fathurraihan18/TA/case/FINAL_TA/09_Foto_Latar_Polos/Perbandingan_Foto1.png

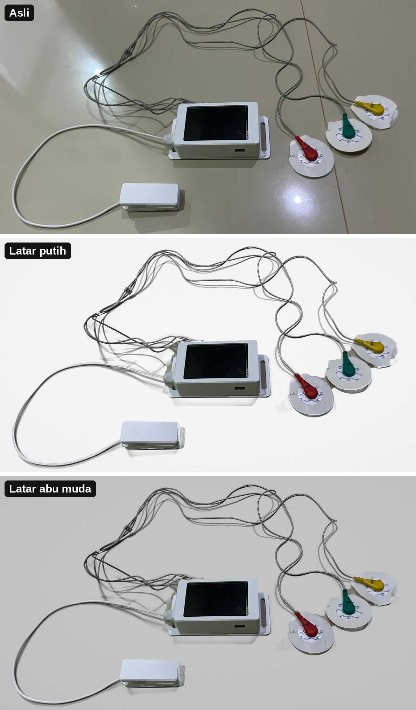
case/FINAL_TA/09_Foto_Latar_Polos/Perbandingan_Foto1.png
