fathurraihan18/TA/README.md

# TA
Implementasi LightGBM ke ESP32 berbasis sinyal ECG dan PPG
