fathurraihan18/TA/case/FINAL_TA/08_Jurnal_Satu_Per_Satu/Fig03_System_overview.pdf

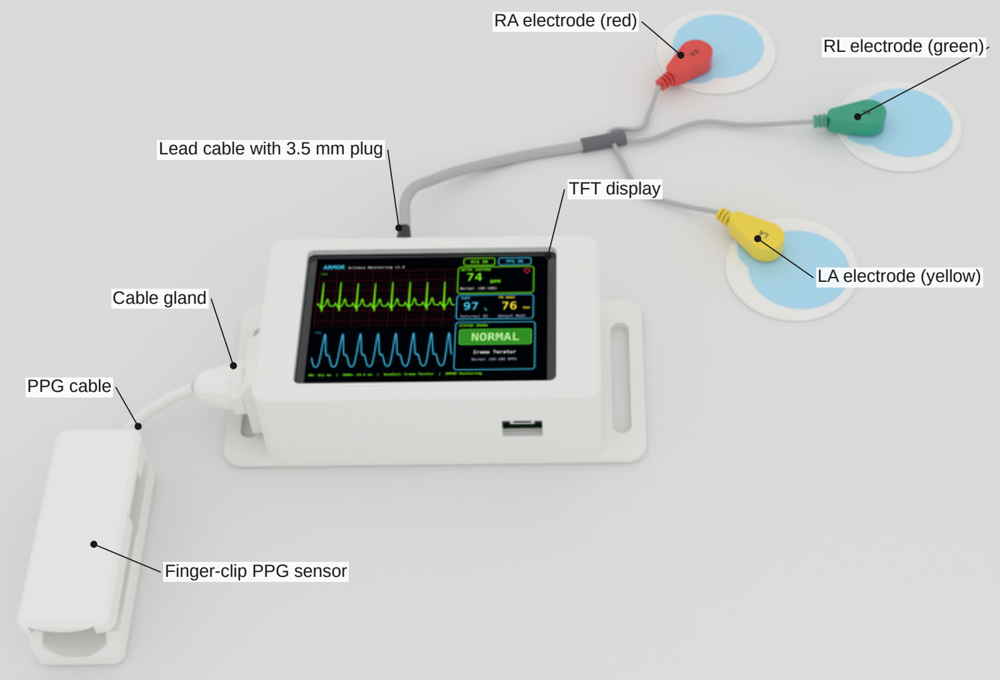
[picture p3: page 1]

RA electrode (red)
RL electrode (green)

LA electrode (yellow)

Lead cable with 3.5 mm plug

TFT display

Cable gland

PPG cable

Finger-clip PPG sensor
