fathurraihan18/TA/case/v2d_penahan_strip/Gambar_Pemasangan_Penahan_A3.pdf

dorong lurus
ke dalam

dorong lurus
ke dalam

celah epoxy
0.3 mm

0.7 mm

penahan

sekrup M3 x 8, kepala rata

PCB utama

back plate

dinding shell

celah 0.4 mm

batang strip

rim plate

# Pemasangan penahan sekrup (v2d): plate v2 dan 4 sekrup M3 x 8 dari belakang TIDAK berubah

Shell v2 yang bossnya sudah dipotong | penahan dicetak terpisah, dilem ke dinding sesudah tumpukan masuk | plate dipakai sebagai jig

## 1 Tumpukan masuk lurus dari belakang

TFT + standoff + PCB + modul didorong ke shell. Dinding dalam rata

(bos sudah dibuang), tidak ada yang menghalangi.

## 2 Penahan dipasang pada plate

Penahan (magenta): kaki-kakinya masuk ke celah rim plate, batangnya melintas di atas rim. 4 sekrup M3 x 8 dari belakang plate menggigit penahan (cukup menempel).

## 3 Oleskan epoxy, masukkan plate + penahan

Epoxy (kuning) tipis hanya pada muka penahan yang menghadap dinding. Tiang plate melingkupi ekor baut, penahan menyusur dinding di bawah PCB.

## 4 Epoxy keras: penahan menempel di shell

Lepas 4 sekrup dan plate. Penahan (magenta) tinggal di dinding, 0,7 mm di bawah PCB. Lalu pasang plate + 4 sekrup seperti v2.

## 5 Hasil: tampak belakang

Kepala sekrup flat head rata dengan plate: lubang tertutup, PCB dan

solder tidak terlihat/tersentuh kulit.

## 6 Potongan melalui sumbu sekrup (x = 23 mm)

detail dinding Atas (diperbesar) | potongan di x = 0 (di atas rim plate)

Penahan (magenta) berada di antara dinding dan lantai plate, tepat di bawah PCB. Sekrup masuk dari belakang menembus plate dan menggigit penahan. Catatan: sesudah dilem, tumpukan tidak bisa ditarik keluar dari belakang tanpa memotong penahan.

shell | back plate | penahan | epoxy | sekrup | PCB | TFT | Gambar ilustrasi (baterai tidak digambar); dimensi dari model CAD case/v2d_penahan_strip
