fathurraihan18/TA/case/FINAL_TA/01_Gambar_Komponen/Gambar_Komponen_A3.pdf

A. Tampak isometrik | B. Tampak atas (mm)

# K-1 ESP32 DevKit C V4 (ESP32-WROOM-32, 38 pin)

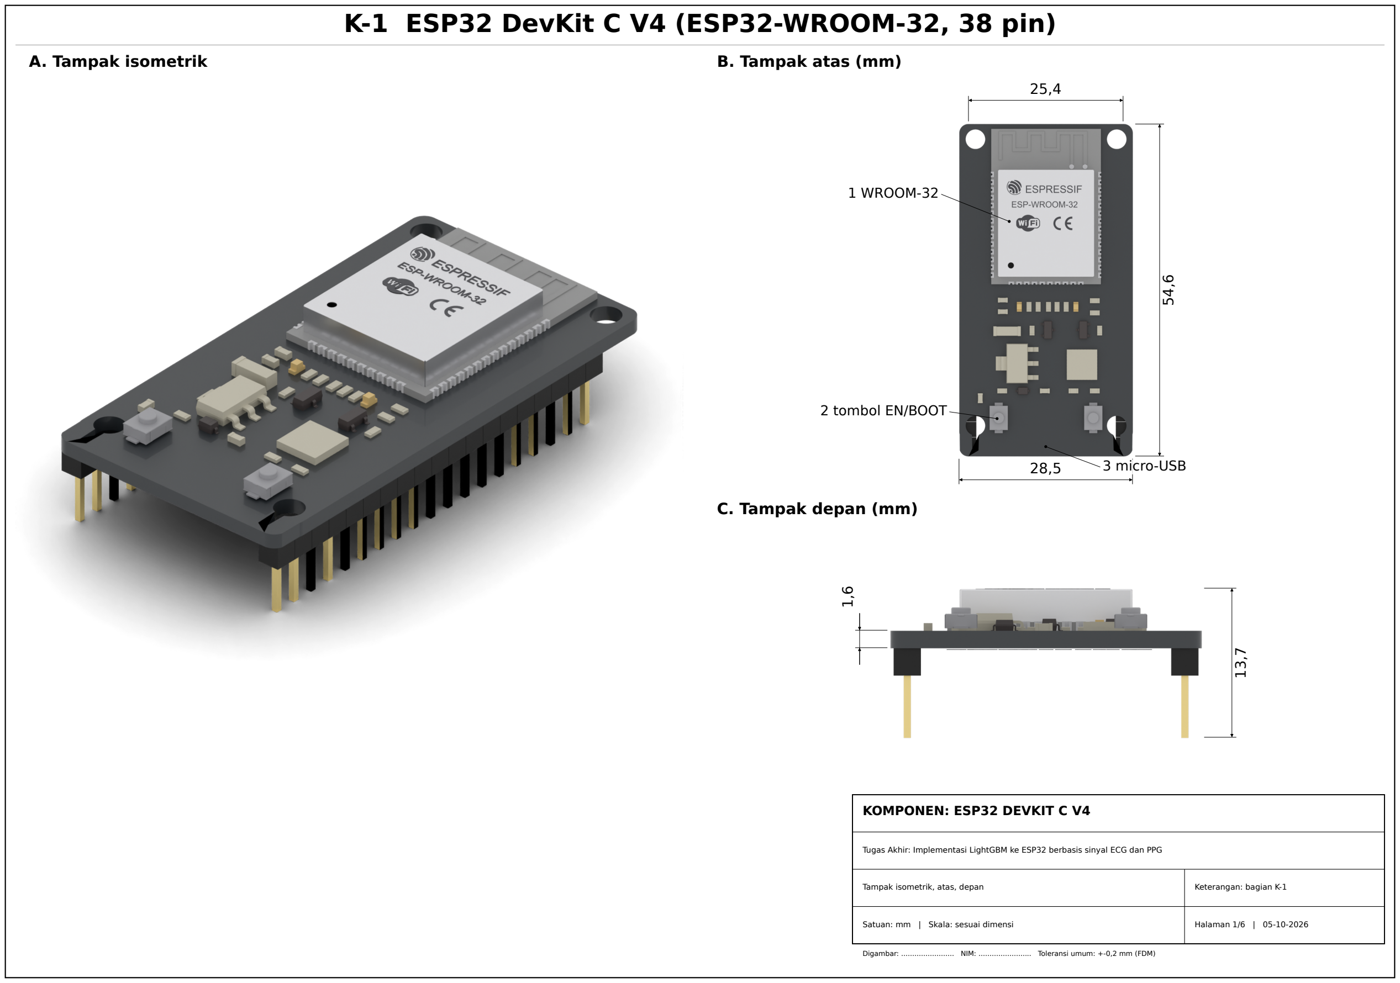
[picture p7: page 1]

# C. Tampak depan (mm)

28,5

54,6

25,4

13,7

1,6

# 1 WROOM-32

# 2 tombol EN/BOOT

# 3 micro-USB

## KOMPONEN: ESP32 DEVKIT C V4

Tugas Akhir: Implementasi LightGBM ke ESP32 berbasis sinyal ECG dan PPG

Tampak isometrik, atas, depan

Satuan: mm | Skala: sesuai dimensi

Keterangan: bagian K-1

Halaman 1/6 | 05-10-2026
Digambar: | NIM: | Toleransi umum: +-0,2 mm (FDM)

# K-2 Modul AD8232 ECG (SparkFun) + jack 3,5 mm

# 1 jack 3,5 mm

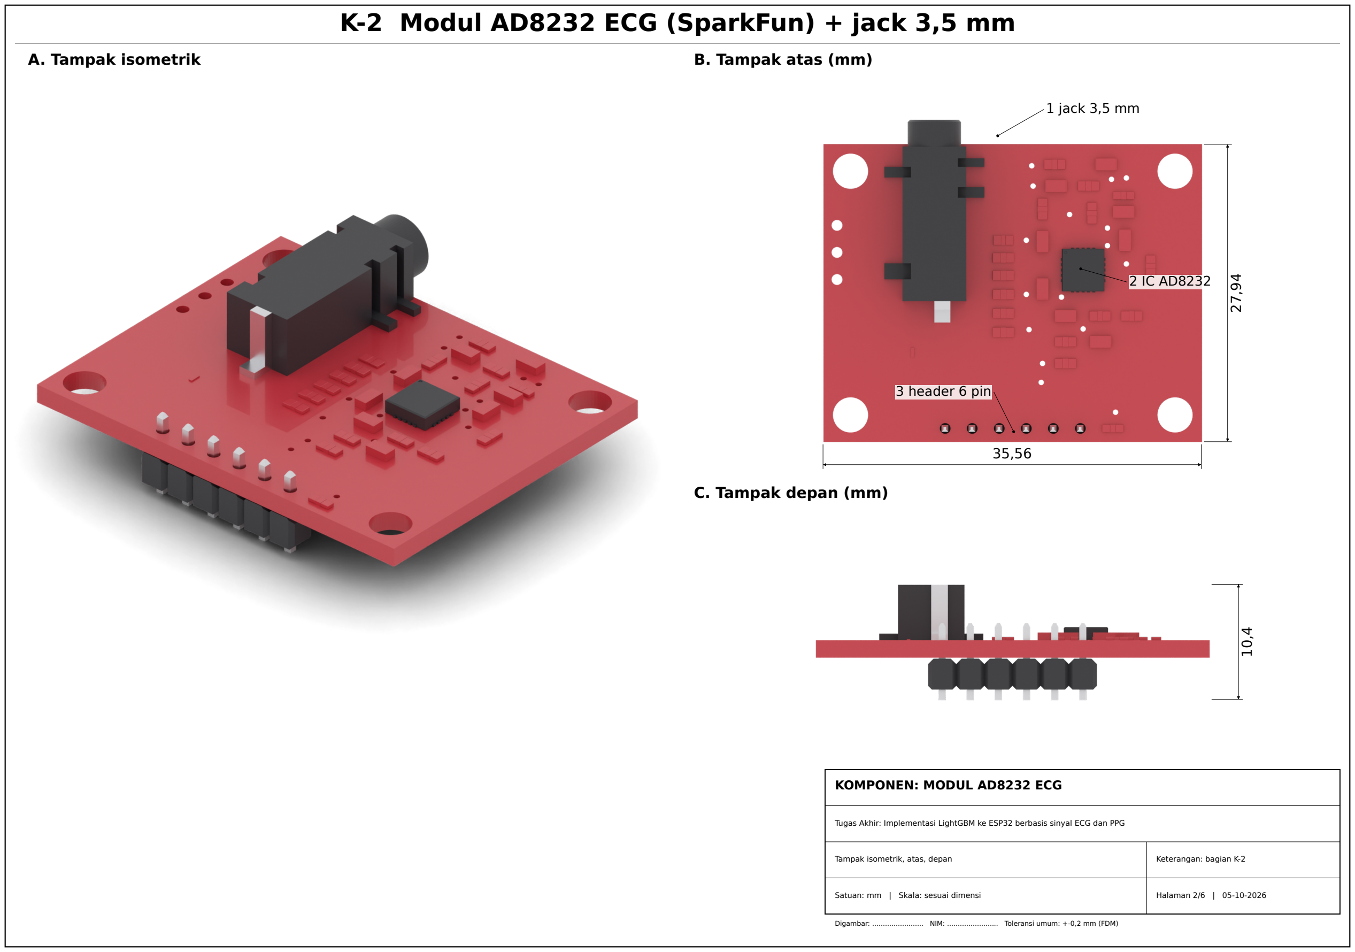
[picture p8: page 2]

# C. Tampak depan (mm)

35,56

27,94 10,4

# 2 IC AD8232

# 3 header 6 pin

## KOMPONEN: MODUL AD8232 ECG

Tugas Akhir: Implementasi LightGBM ke ESP32 berbasis sinyal ECG dan PPG

Tampak isometrik, atas, depan | Keterangan: bagian K-2
| Halaman 2/6 | 05-10-2026

# K-3 Sensor PPG MAX30102 - papan HW-605

# 1 jendela sensor

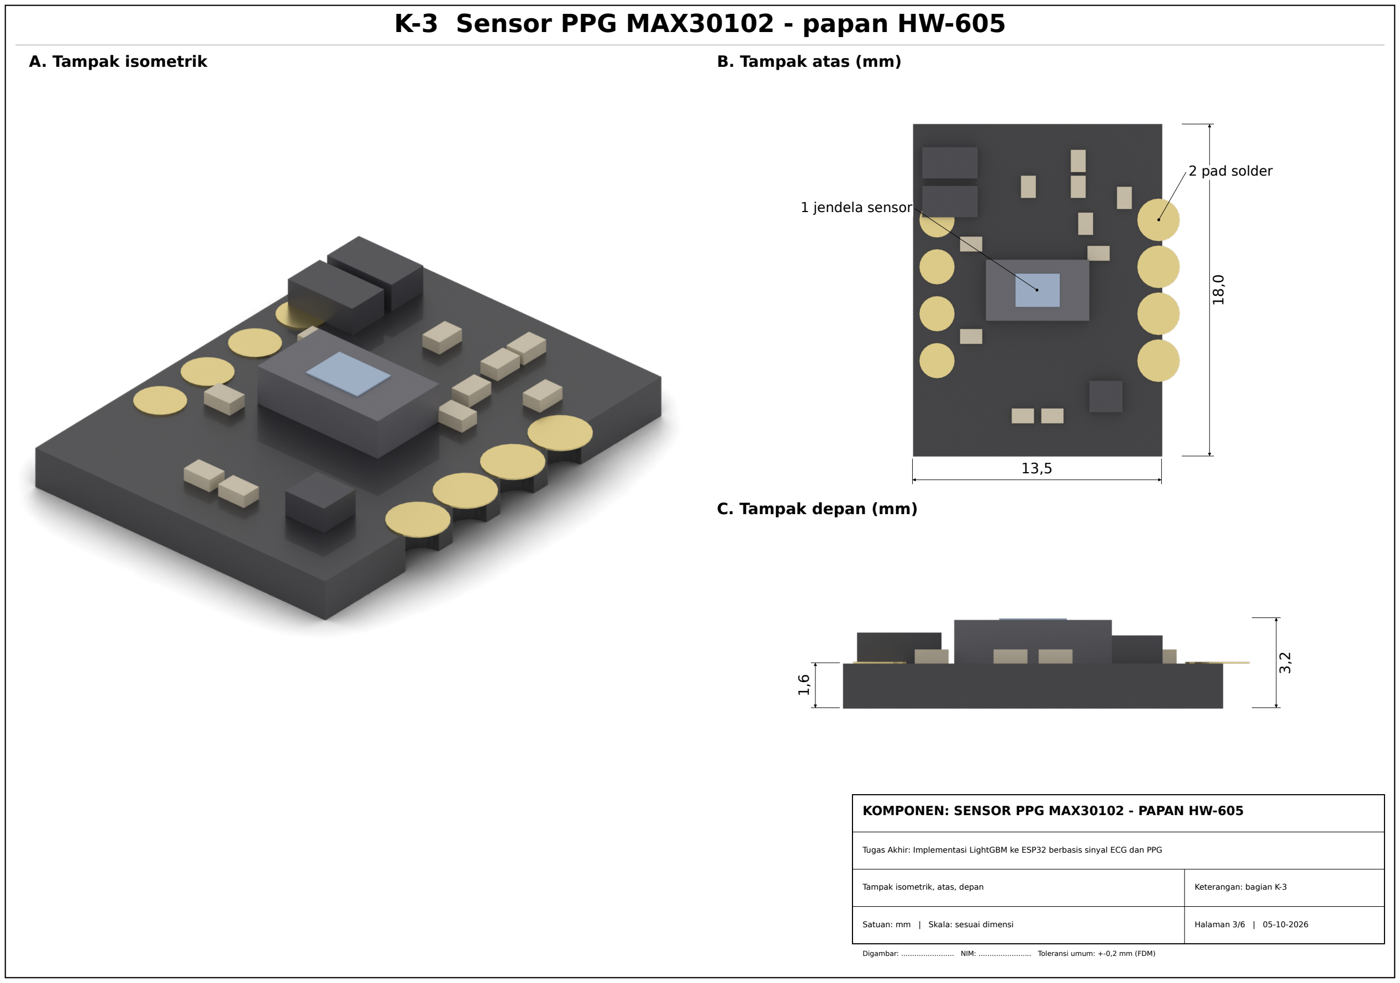
[picture p9: page 3]

# C. Tampak depan (mm)

13,5

18,0

3,2

1,6

# 2 pad solder

## KOMPONEN: SENSOR PPG MAX30102 - PAPAN HW-605

Tugas Akhir: Implementasi LightGBM ke ESP32 berbasis sinyal ECG dan PPG

Tampak isometrik, atas, depan | Keterangan: bagian K-3
| Halaman 3/6 | 05-10-2026

A. Set kabel 3 lead dengan plug TRS 3,5 mm | B. Tampak atas (mm)

# K-4 Elektroda EKG 3 lead (merah RA, kuning LA, hijau RL) + kabel dan plug 3,5 mm

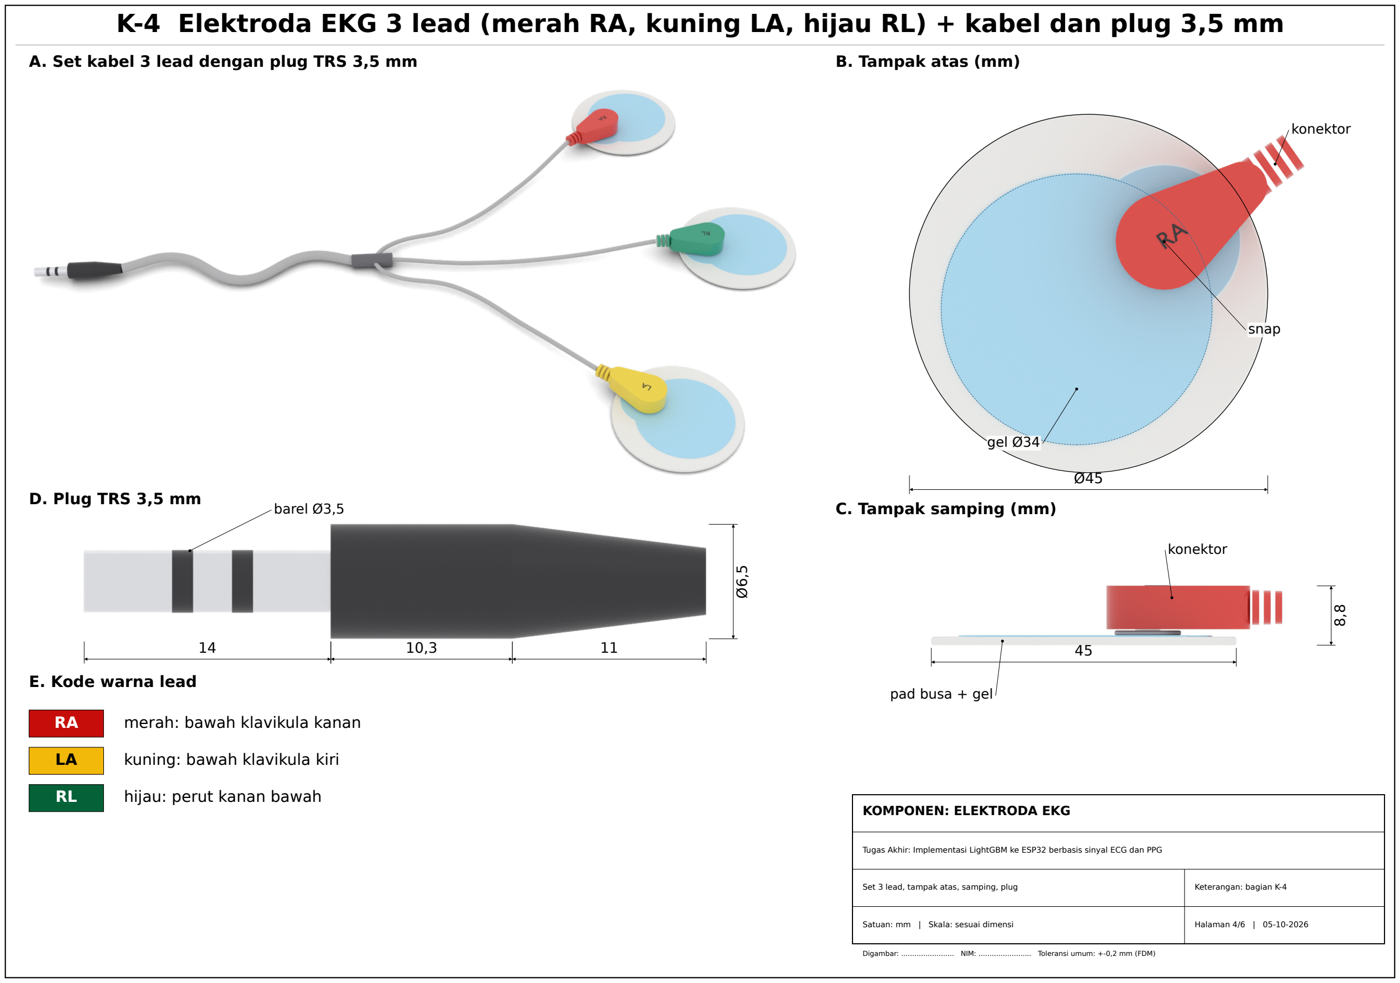
[picture p10: page 4]

# C. Tampak samping (mm) D. Plug TRS 3,5 mm

# E. Kode warna lead

# merah: bawah klavikula kanan

# kuning: bawah klavikula kiri

# hijau: perut kanan bawah

Ø45

45

8,8

14 | 10,3 | 11

Ø6,5

RA

LA

RL

# gel Ø34

# konektor

# snap

# pad busa + gel

# konektor

# barel Ø3,5

## KOMPONEN: ELEKTRODA EKG

Tugas Akhir: Implementasi LightGBM ke ESP32 berbasis sinyal ECG dan PPG

Set 3 lead, tampak atas, samping, plug

Keterangan: bagian K-4

Halaman 4/6 | 05-10-2026

# A. Cable gland PG7 + mur

# C. Saklar rocker KCD11

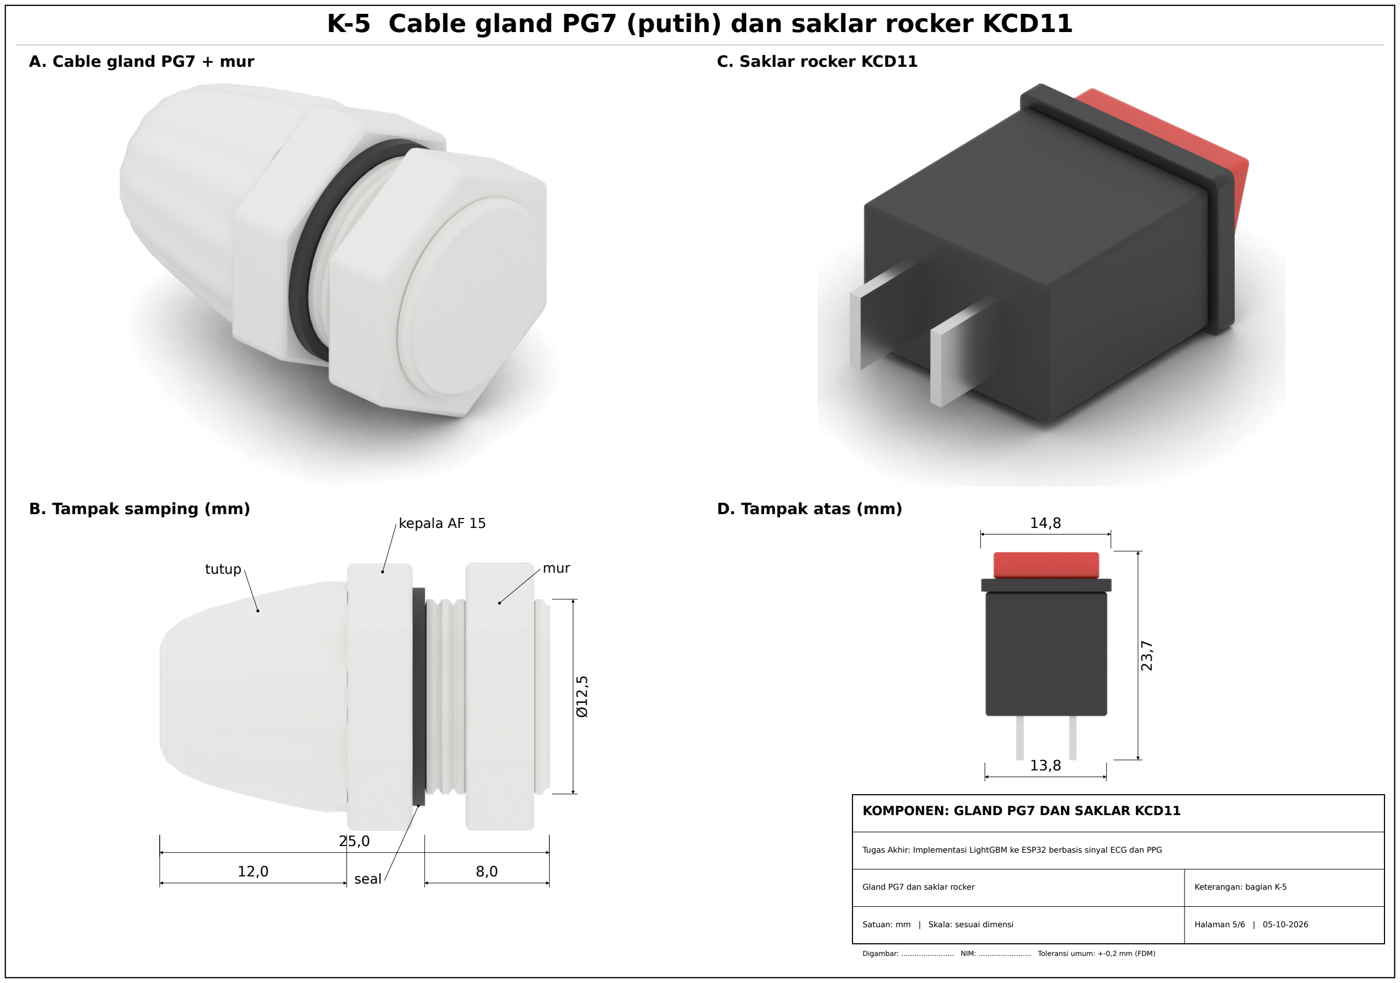
[picture p11: page 5]

# B. Tampak samping (mm)

# D. Tampak atas (mm)

# K-5 Cable gland PG7 (putih) dan saklar rocker KCD11

25,0

12,0 | 8,0

Ø12,5

14,8

23,7

13,8

# kepala AF 15

# tutup

# seal

# mur

## KOMPONEN: GLAND PG7 DAN SAKLAR KCD11

Tugas Akhir: Implementasi LightGBM ke ESP32 berbasis sinyal ECG dan PPG

Gland PG7 dan saklar rocker

Keterangan: bagian K-5

Halaman 5/6 | 05-10-2026

# 1. Layar TFT 3,5" ILI9488

# 2. PCB utama (custom)

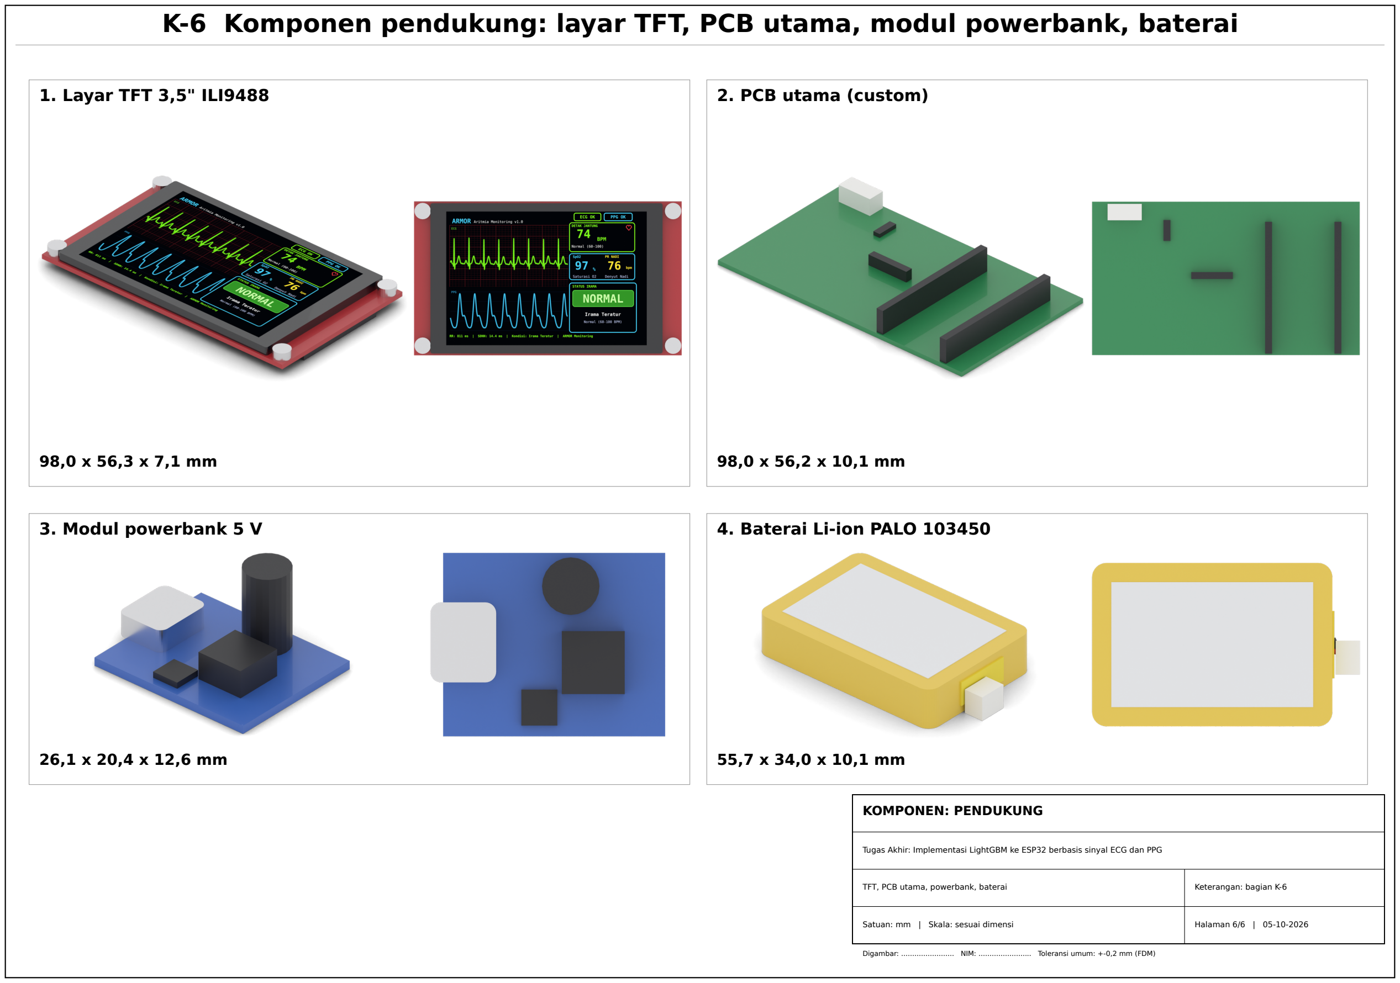
[picture p12: page 6]

# 98,0 x 56,3 x 7,1 mm

# 98,0 x 56,2 x 10,1 mm

# 3. Modul powerbank 5 V

# 26,1 x 20,4 x 12,6 mm

# 4. Baterai Li-ion PALO 103450

# 55,7 x 34,0 x 10,1 mm

# K-6 Komponen pendukung: layar TFT, PCB utama, modul powerbank, baterai

## KOMPONEN: PENDUKUNG

Tugas Akhir: Implementasi LightGBM ke ESP32 berbasis sinyal ECG dan PPG

TFT, PCB utama, powerbank, baterai | Keterangan: bagian K-6
| Halaman 6/6 | 05-10-2026
