fathurraihan18/TA/case/FINAL_TA/08_Jurnal_Satu_Per_Satu/Fig04_Electrode_placement_male_torso.pdf

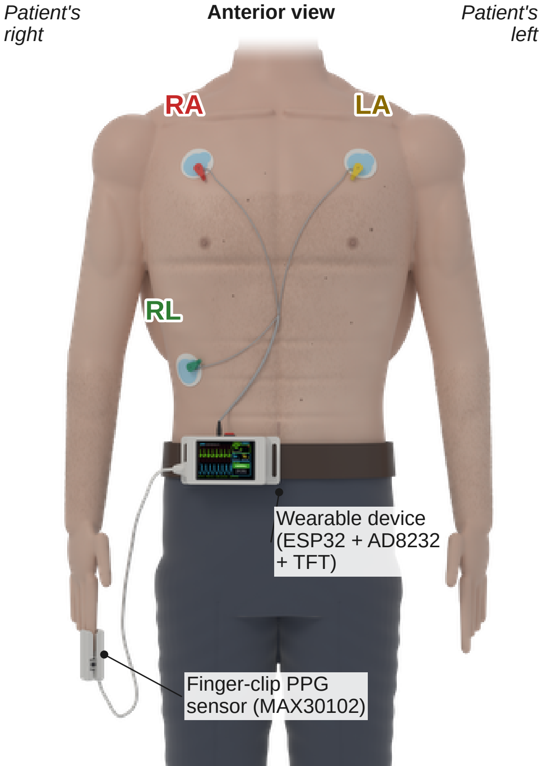
[picture p13: page 1]

Patient's
right

Patient's
left

Anterior view

Wearable device
(ESP32 + AD8232
+ TFT)

Finger-clip PPG
sensor (MAX30102)
