fathurraihan18/TA/case/FINAL_TA/08_Jurnal_Satu_Per_Satu/Fig05_Electrode_details.pdf

(a)

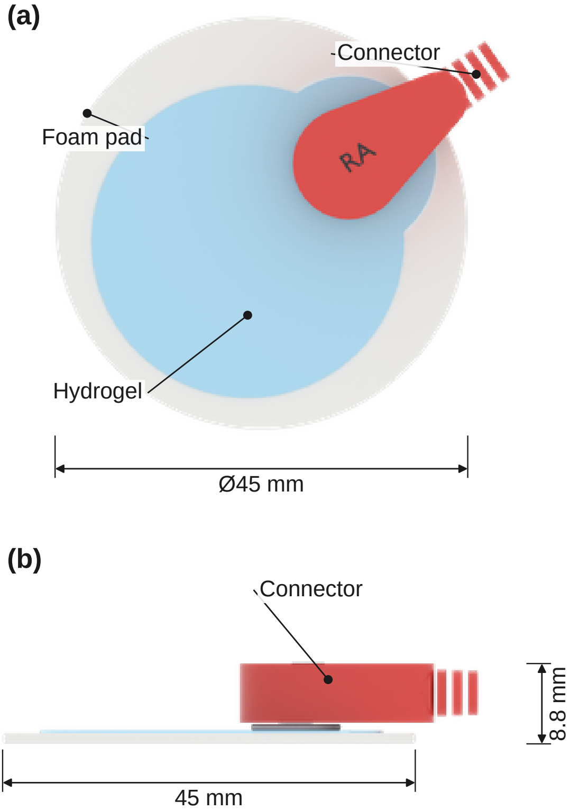
[picture p14: page 1]

(b)

Ø45 mm

Hydrogel

Connector

Foam pad

45 mm

8.8 mm

Connector
