fathurraihan18/TA/case/FINAL_TA/08_Jurnal_Satu_Per_Satu/Fig06_Lead_cable_and_plug.pdf

(a)

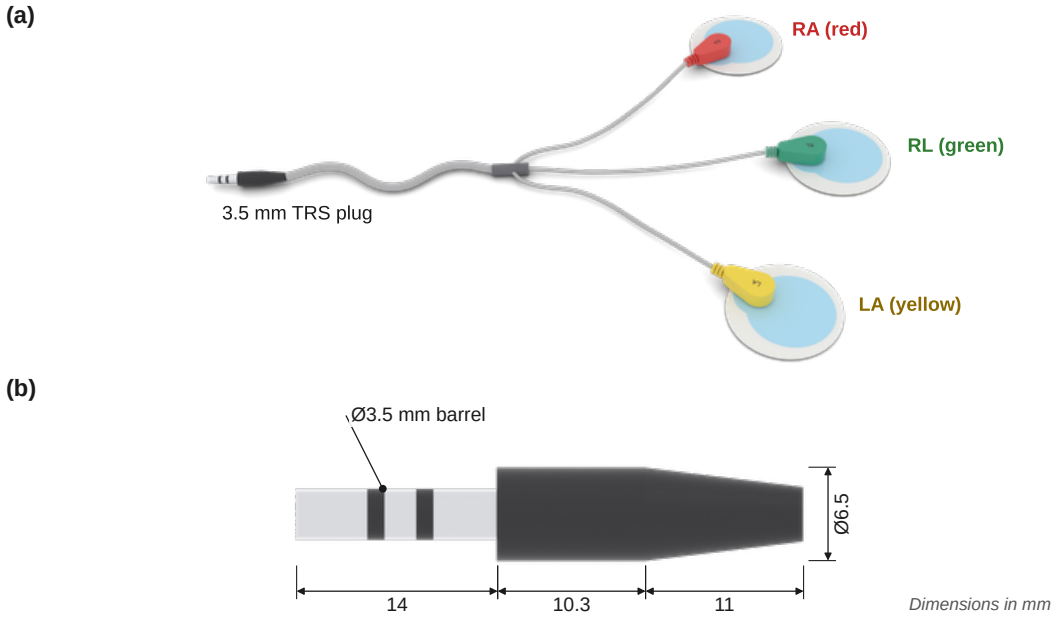
[picture p15: page 1]
Dimensions in mm Ø⁶.5; Ø3.5 mm barrel
