fathurraihan18/TA/case/FINAL_TA/08_Jurnal_Satu_Per_Satu/Fig07_Lead_colour_code.pdf

Lead | Colour | Function | Electrode position
| Red | Right arm | Right infraclavicular fossa
| Yellow | Left arm | Left infraclavicular fossa
| Green | Right leg (reference) | Right lower abdomen

RA

LA

RL
