fathurraihan18/TA/case/FINAL_TA/08_Jurnal_Satu_Per_Satu/Fig09_AD8232_ECG_module.pdf

(a) (b)

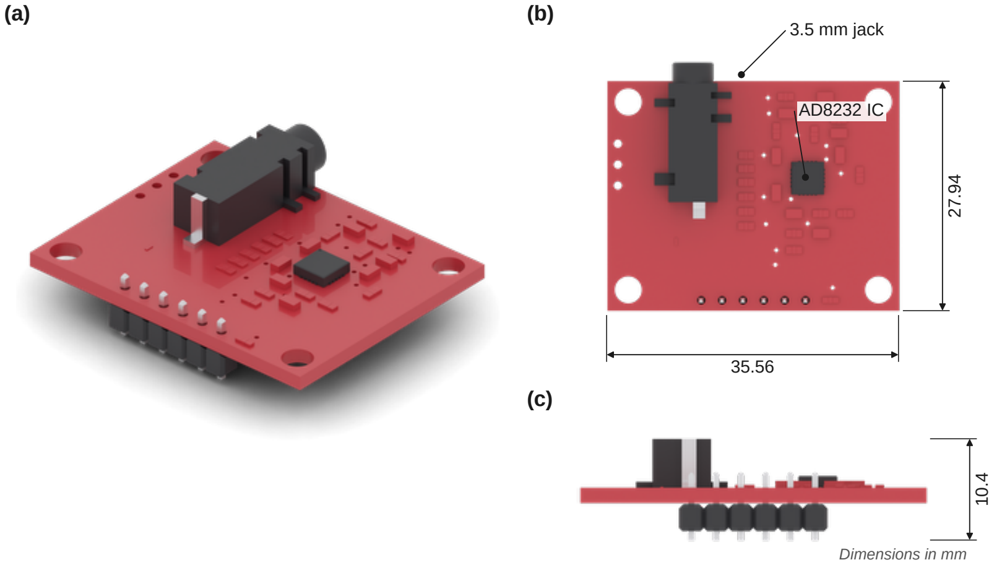
[picture p16: page 1]

(c)

Dimensions in mm

35.56

27.94

3.5 mm jack

AD8232 IC

10.4
