fathurraihan18/TA/case/FINAL_TA/08_Jurnal_Satu_Per_Satu/Fig10_MAX30102_HW605_module.pdf

(a) (b)

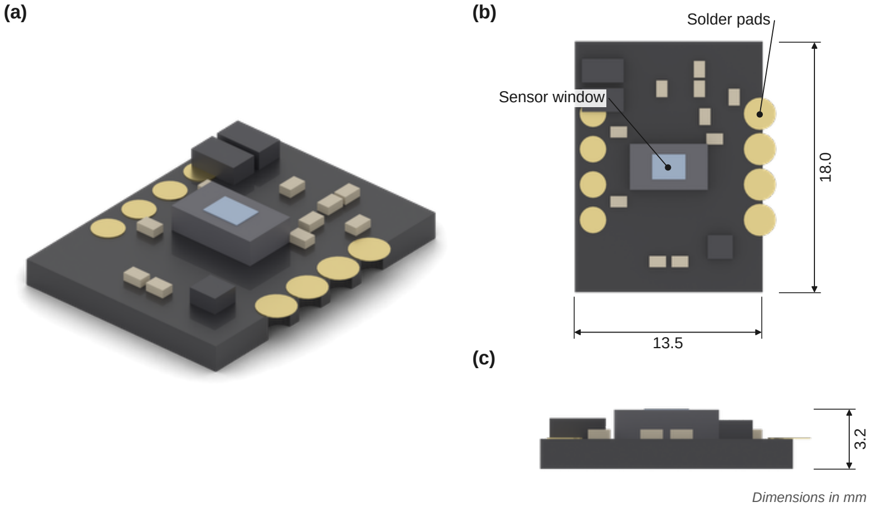
[picture p17: page 1]

(c)

Dimensions in mm

13.5

18.0

Sensor window

Solder pads

3.2
