fathurraihan18/TA/case/FINAL_TA/08_Jurnal_Satu_Per_Satu/Fig11_Cable_gland_and_rocker_switch.pdf

(a)

(c)

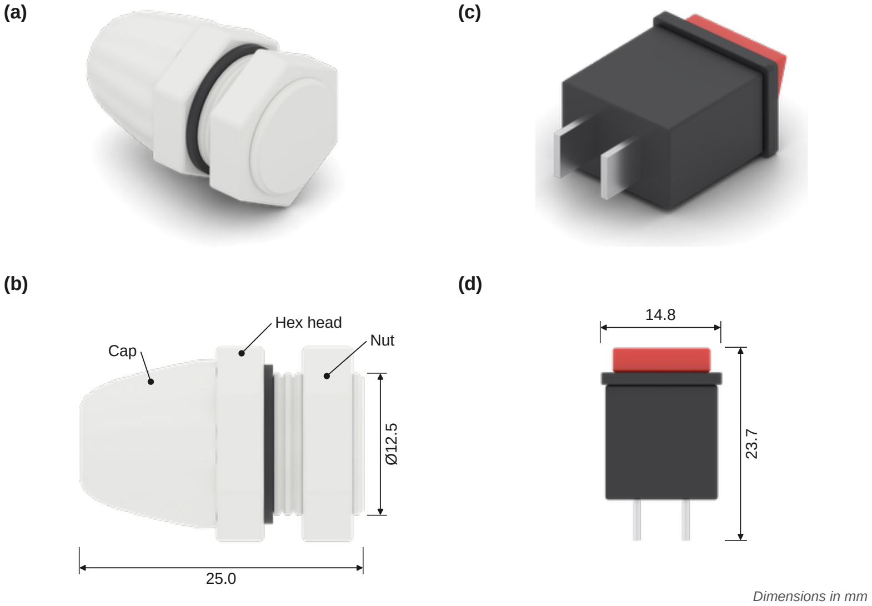
[picture p18: page 1]

(b)

(d)

Dimensions in mm

25.0

Ø12.5

Hex head
Cap | Nut

14.8

23.7
