fathurraihan18/TA/case/FINAL_TA/08_Jurnal_Satu_Per_Satu/Fig15_Finger_clip_in_use.pdf

(a)

(b)

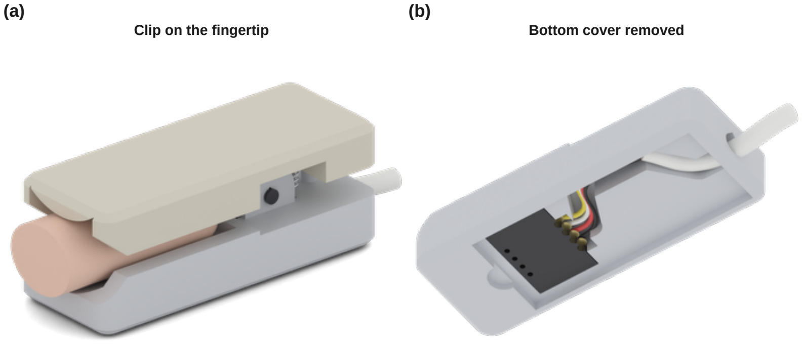
[picture p19: page 1]

Clip on the fingertip
Bottom cover removed
