fathurraihan18/TA/case/FINAL_TA/00_Gambar_Lengkap/bagian/00_Daftar_A3.pdf

# Gambar alat ECG + PPG

Implementasi LightGBM ke ESP32 berbasis sinyal ECG dan PPG

PERAKITAN

P-1 | Tampak eksplode dan nomor komponen | hal. 2
P-2 | Sistem lengkap dan penempatan pada pengguna | hal. 3

GAMBAR KOMPONEN

K-1 | ESP32 DevKit C V4 | hal. 4
K-2 | Modul ECG AD8232 | hal. 5
K-3 | Sensor PPG MAX30102 (HW-605) | hal. 6
K-4 | Elektroda EKG 3 lead dan plug 3,5 mm | hal. 7
K-5 | Cable gland PG7 dan saklar KCD11 | hal. 8
K-6 | Komponen pendukung | hal. 9

GAMBAR TEKNIK COVER

T-1 | Tampak depan, atas, bawah, kanan, kiri | hal. 10
T-2 | Back plate, isometrik, skema sabuk | hal. 11
T-3 | Potongan A-A, B-B, C-C, D-D | hal. 12
T-4 | Penahan sekrup | hal. 13

GAMBAR TEKNIK KLIP PPG

C-1 | Potongan dan dimensi utama | hal. 14
C-2 | Tampak eksplode dan pemakaian | hal. 15

GAMBAR JURNAL

J-1 | Penempatan elektroda RA, LA, RL dan klip PPG | hal. 16

Keterangan (daftar komponen, spesifikasi, catatan, tabel) ada di berkas terpisah: Keterangan_Gambar_ECG_PPG_A4.pdf
