fathurraihan18/TA/case/FINAL_TA/00_Gambar_Lengkap/bagian/99_Jurnal_A3.pdf

# Penempatan elektroda RA, LA, RL dan klip PPG pada pengguna

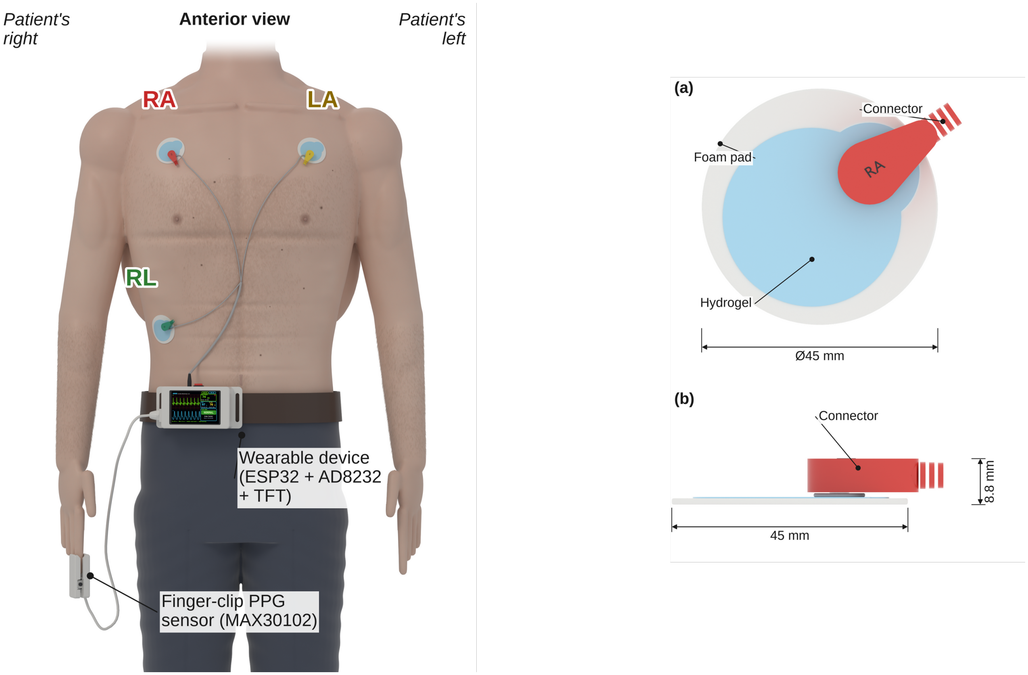
[picture p23: figure]

## Gambar jurnal: penempatan elektroda

Tugas Akhir: Implementasi LightGBM ke ESP32 berbasis sinyal ECG dan PPG

RA merah, LA kuning, RL hijau; klip MAX30102 | Keterangan: bagian J-1
Satuan: mm | Skala: tidak diskalakan | Halaman 16/16 | 05-10-2026
Digambar: | NIM: | Toleransi umum: +-0,2 mm (FDM)
