fathurraihan18/TA/case/FINAL_TA/08_Jurnal_Satu_Per_Satu/Fig08_ESP32_DevKit_C_V4.pdf

(a) (b)

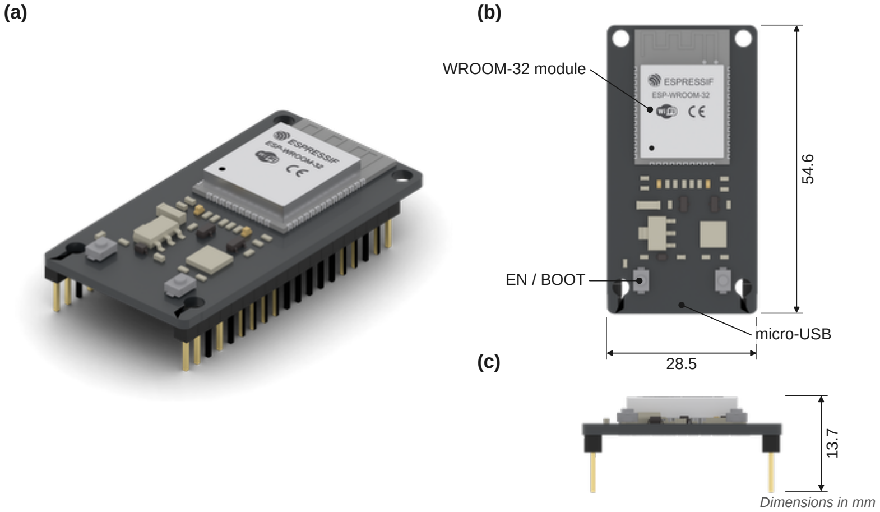
[picture p24: page 1]

(c)

Dimensions in mm

28.5

54.6

WROOM-32 module

EN / BOOT

micro-USB 13.7
