fathurraihan18/TA/case/FINAL_TA/08_Jurnal_Satu_Per_Satu/Fig12_Enclosure_front_and_rear.pdf

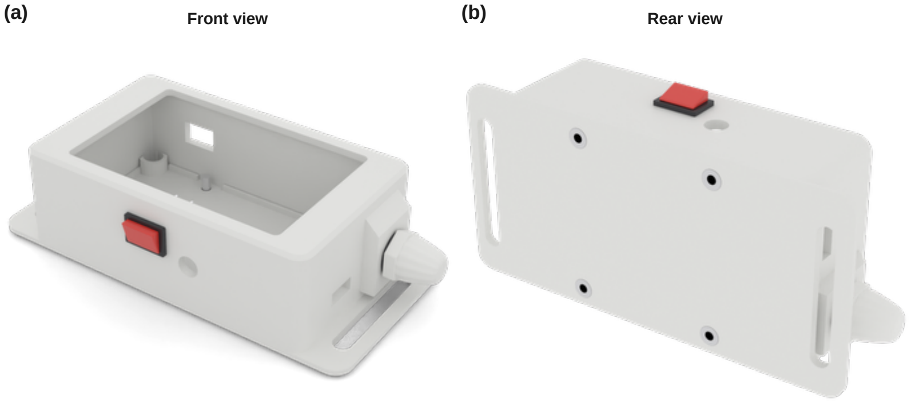
[picture p25: page 1]

(a) | (b) Front view | Rear view
