fathurraihan18/TA/case/FINAL_TA/08_Jurnal_Satu_Per_Satu/Fig13_Enclosure_dimensions.pdf

(a) (b)

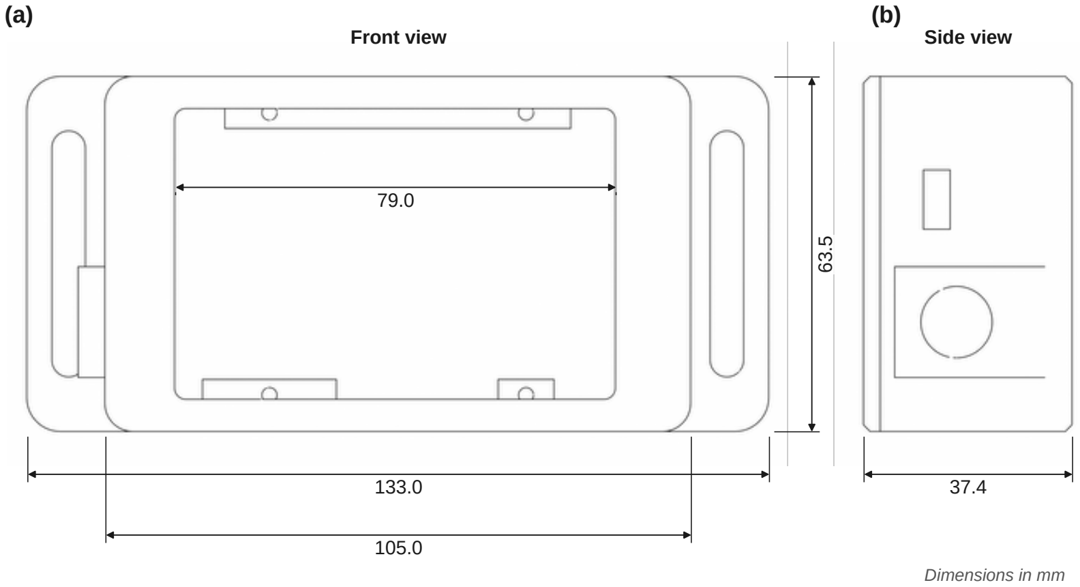
[picture p26: page 1]

Front view | Side view

Dimensions in mm

133.0

105.0

63.5

79.0

37.4
