fathurraihan18/TA/case/final/layar_ui.png

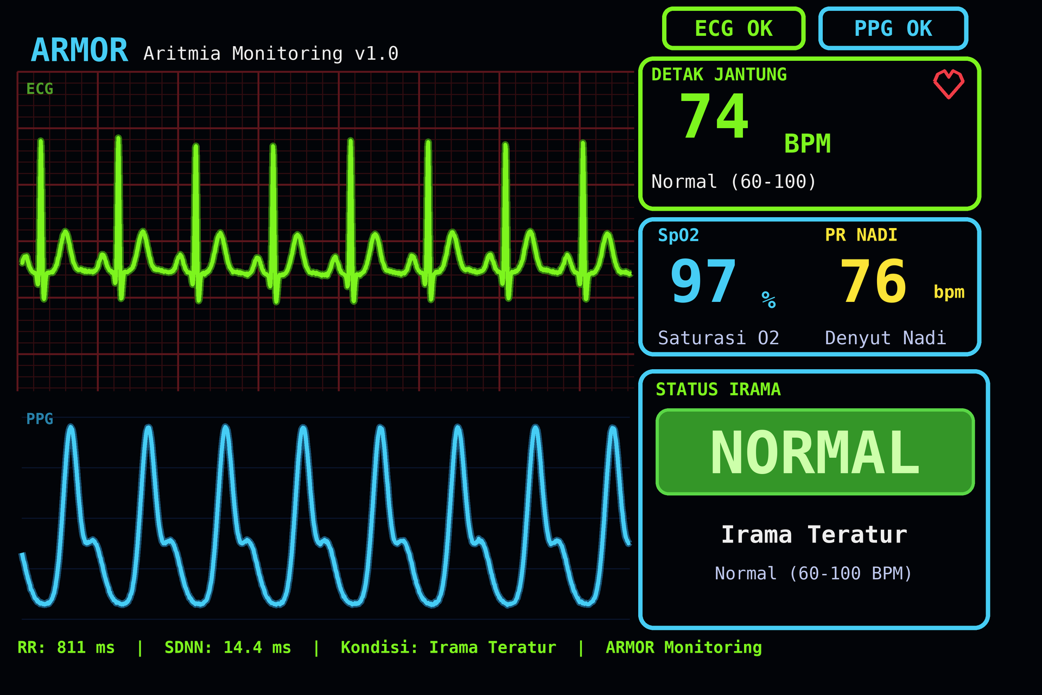
case/final/layar_ui.png
