fathurraihan18/TA/case/FINAL_TA/00_Gambar_Lengkap/bagian/00_Daftar_A3.png

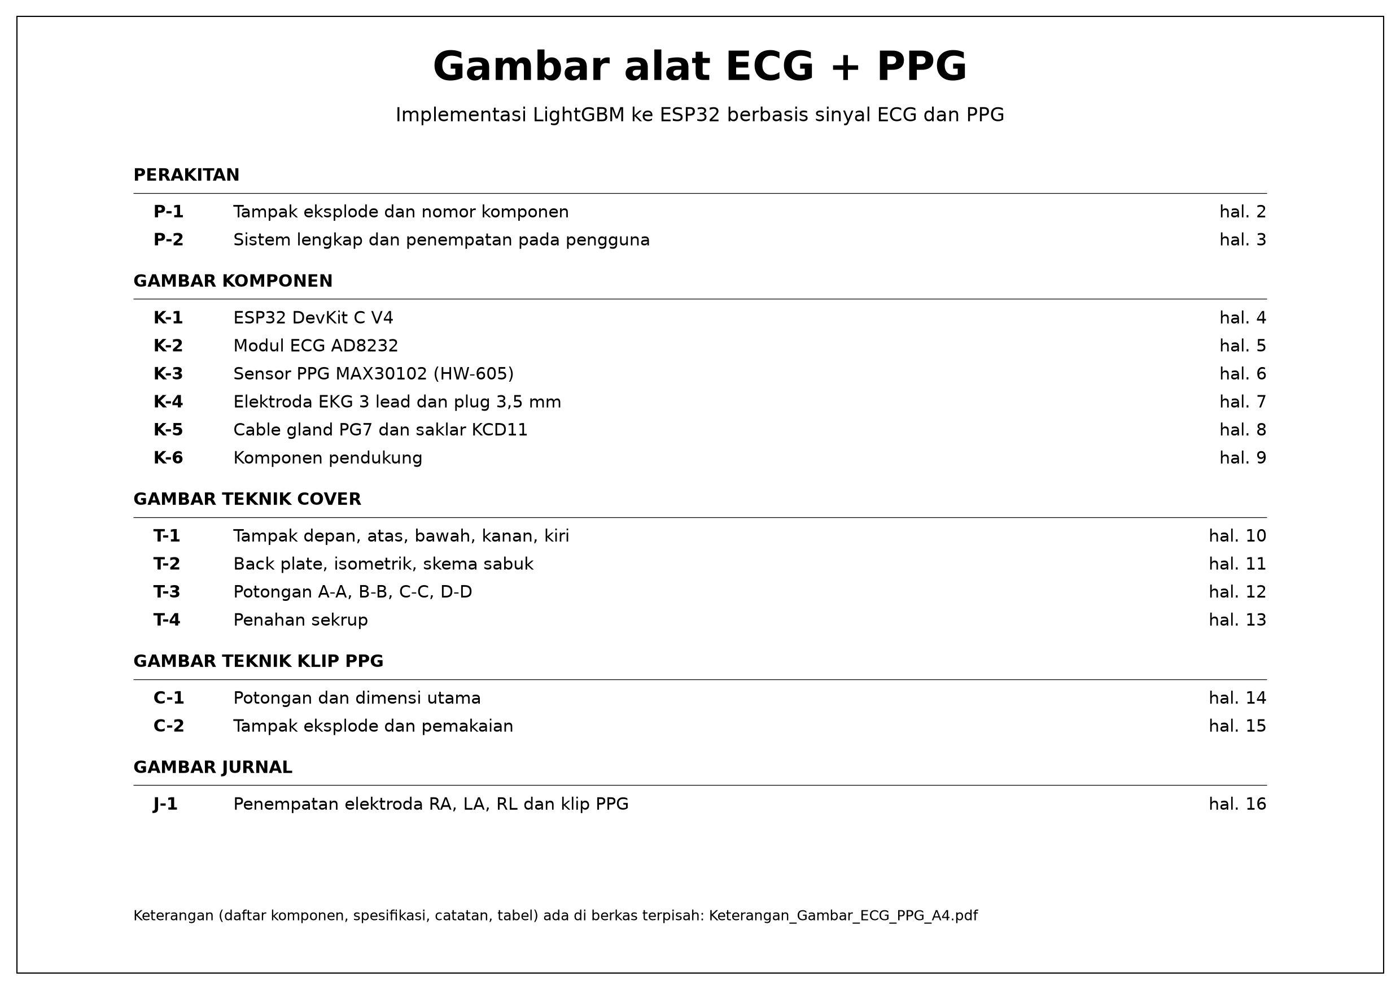
case/FINAL_TA/00_Gambar_Lengkap/bagian/00_Daftar_A3.png
