fathurraihan18/TA/case/FINAL_TA/00_Gambar_Lengkap/bagian/99_Jurnal_A3.png

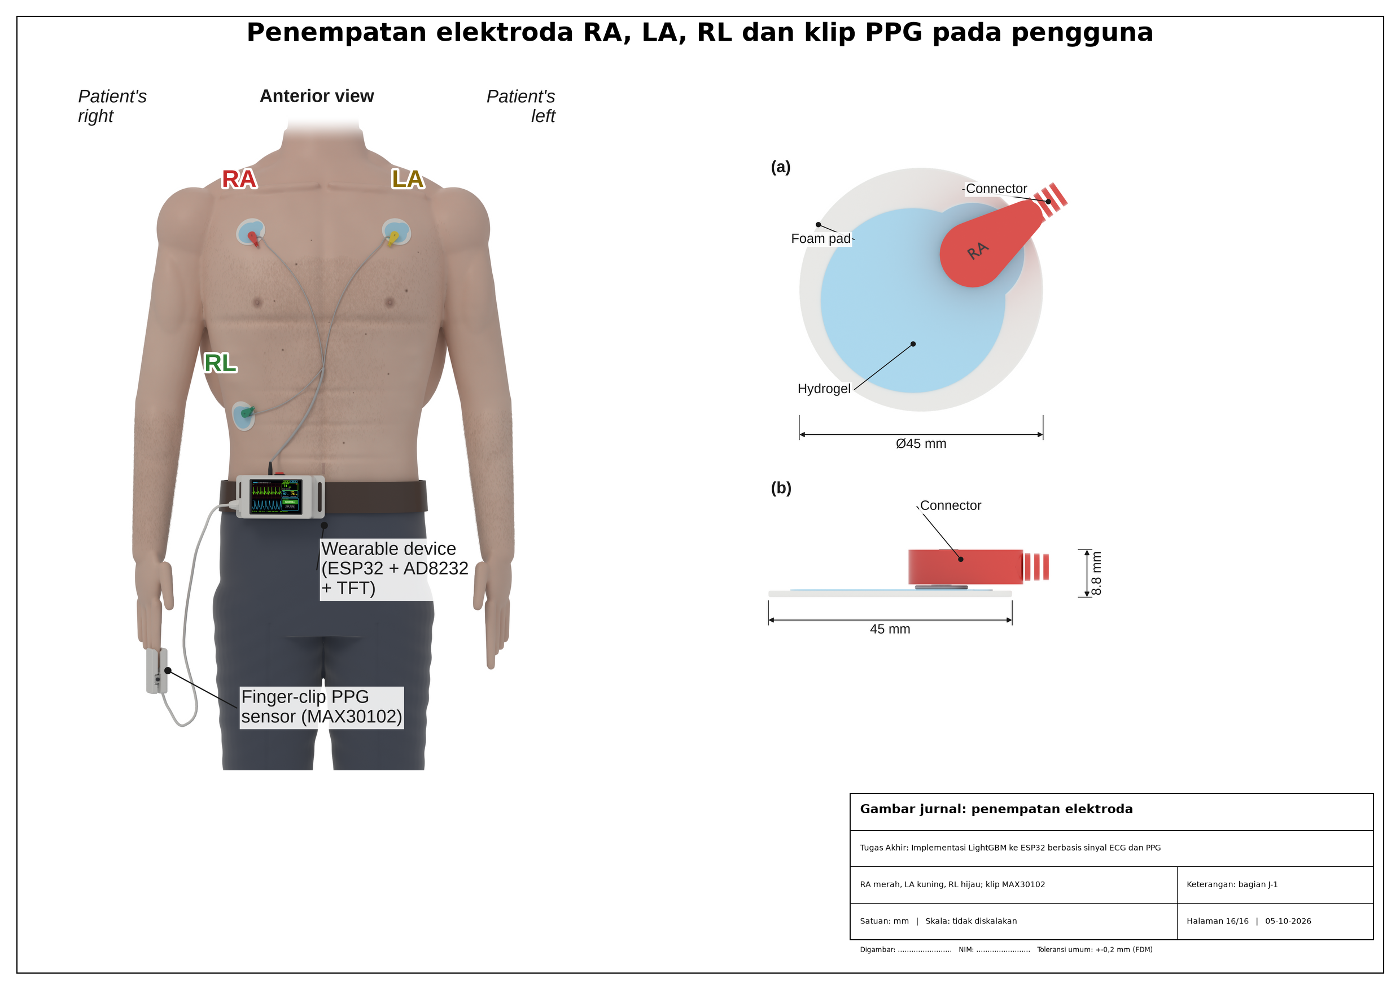
case/FINAL_TA/00_Gambar_Lengkap/bagian/99_Jurnal_A3.png
