fathurraihan18/TA/case/FINAL_TA/01_Gambar_Komponen/Gambar_Komponen_K3_MAX30102_HW605_A3.png

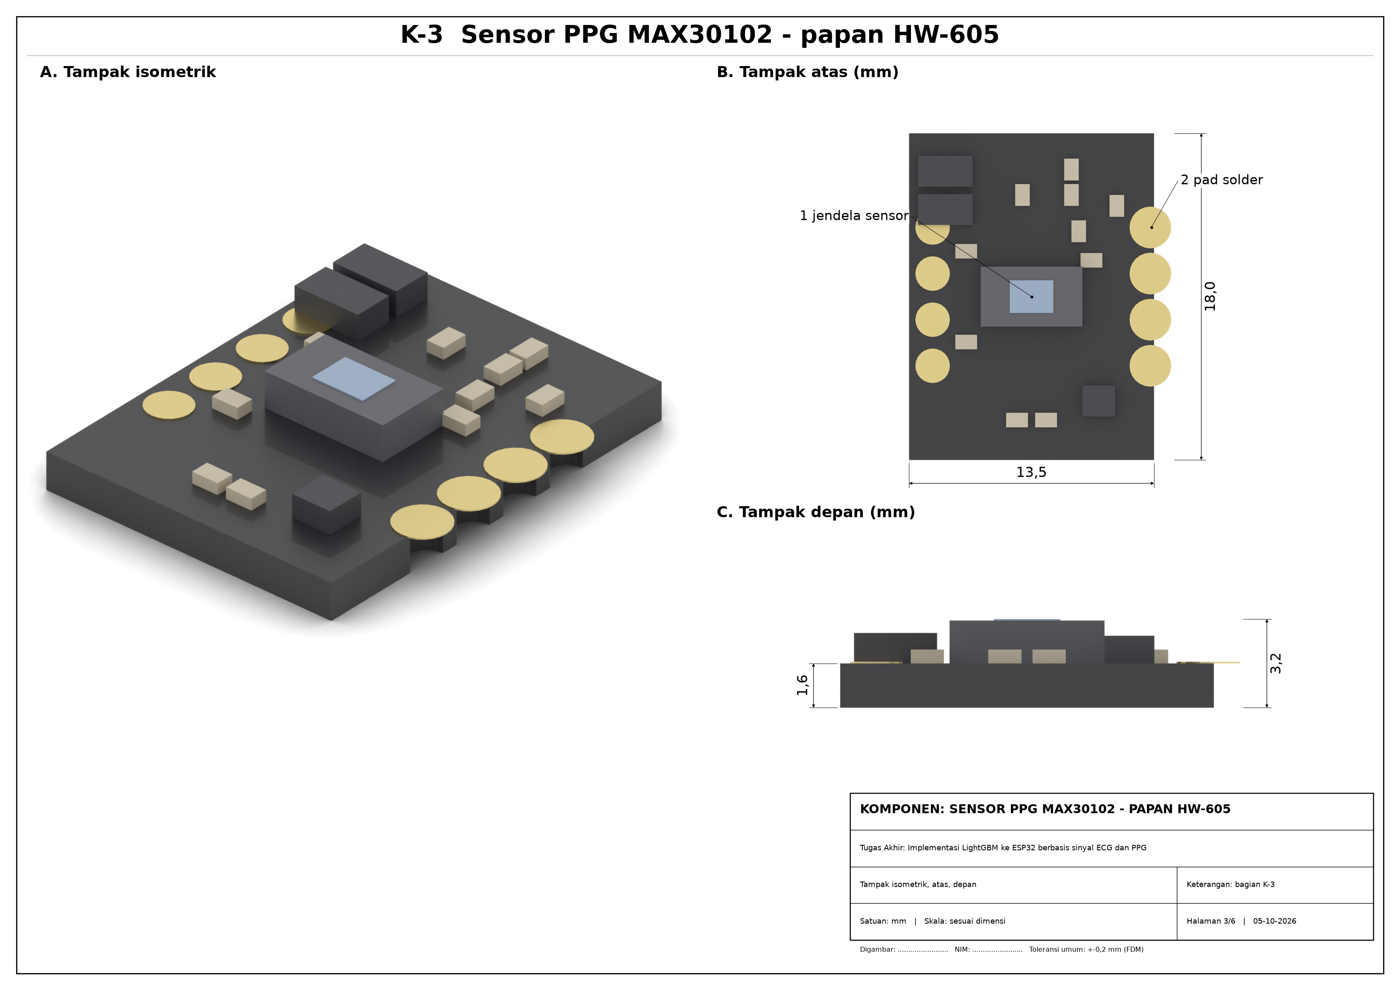
case/FINAL_TA/01_Gambar_Komponen/Gambar_Komponen_K3_MAX30102_HW605_A3.png
