fathurraihan18/TA/case/FINAL_TA/02_Gambar_Teknik_Cover/Gambar_Teknik_Cover_Hal3_A3.png

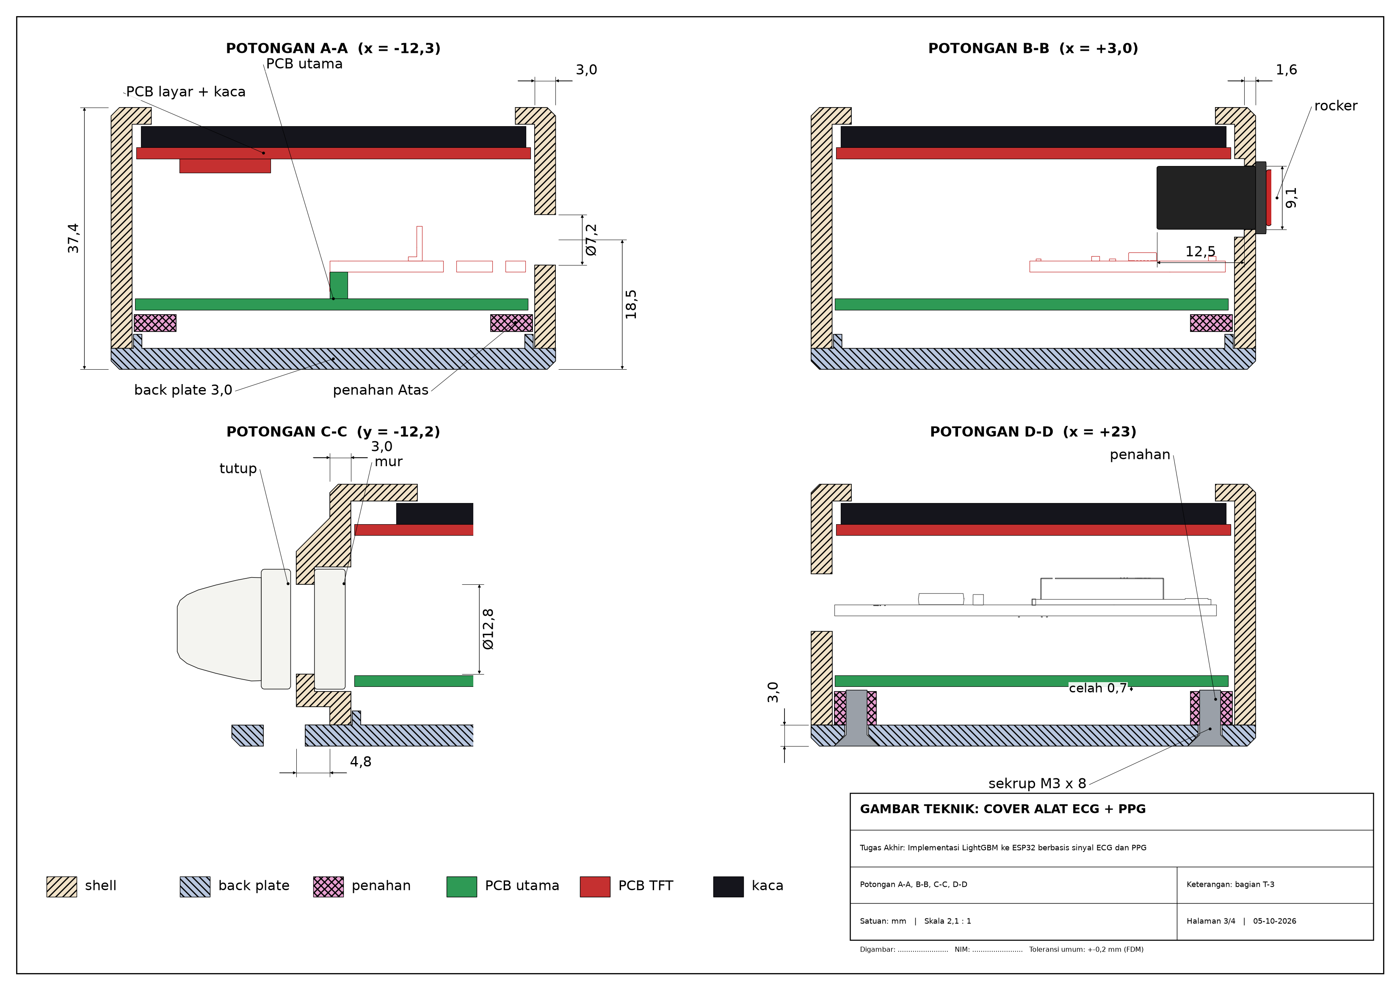
case/FINAL_TA/02_Gambar_Teknik_Cover/Gambar_Teknik_Cover_Hal3_A3.png
