fathurraihan18/TA/case/FINAL_TA/03_Gambar_Teknik_Klip/Gambar_Teknik_Klip_Hal1_A3.png

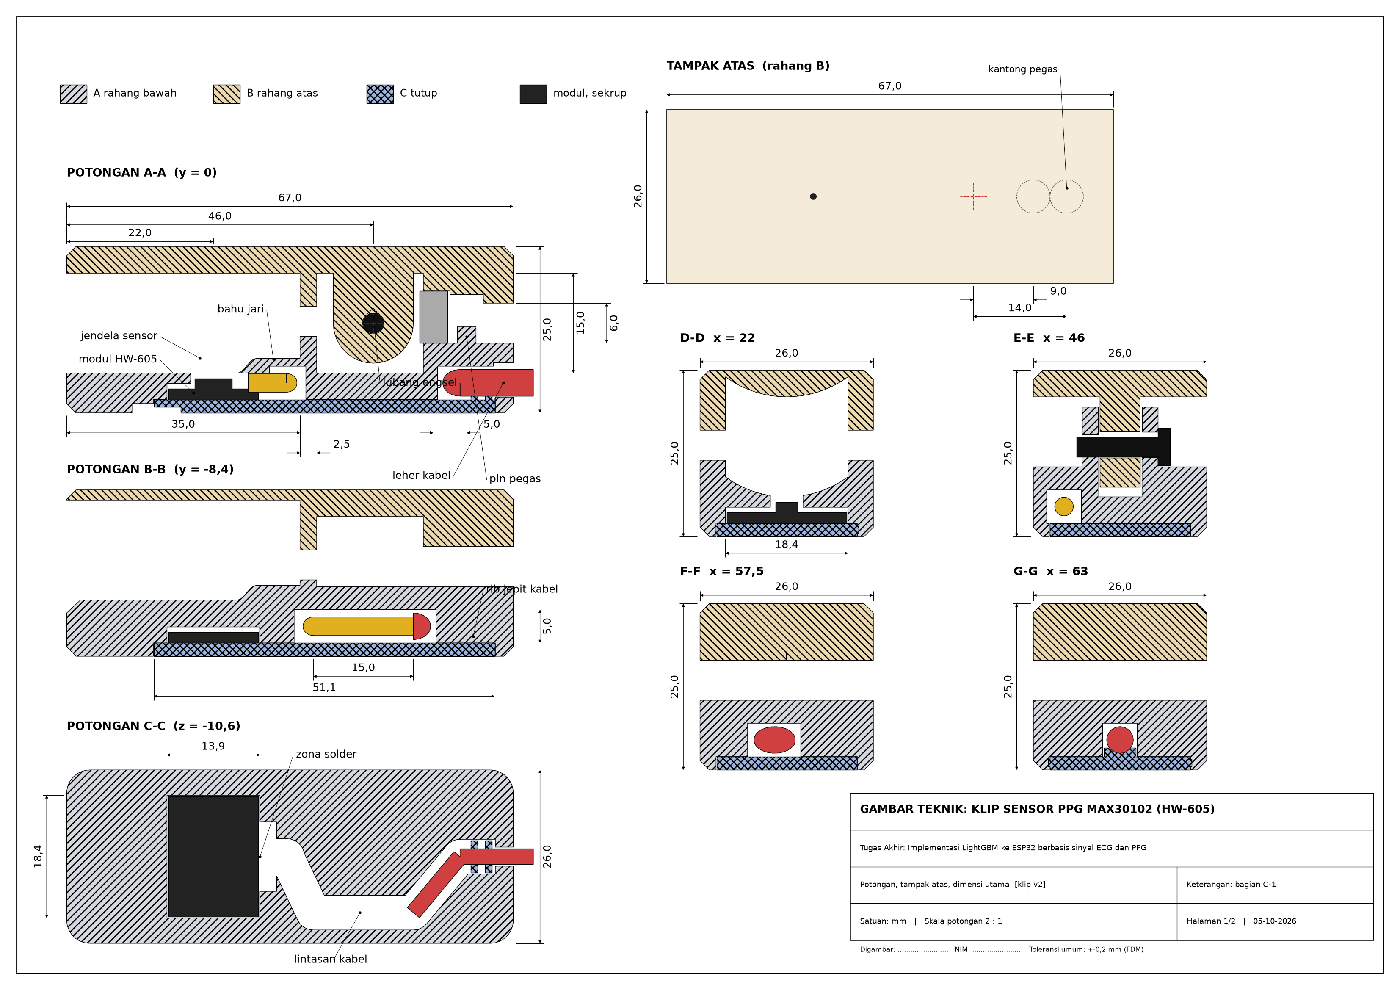
case/FINAL_TA/03_Gambar_Teknik_Klip/Gambar_Teknik_Klip_Hal1_A3.png
