fathurraihan18/TA/case/FINAL_TA/04_Gambar_Perakitan/Gambar_Perakitan_Hal1_A3.png

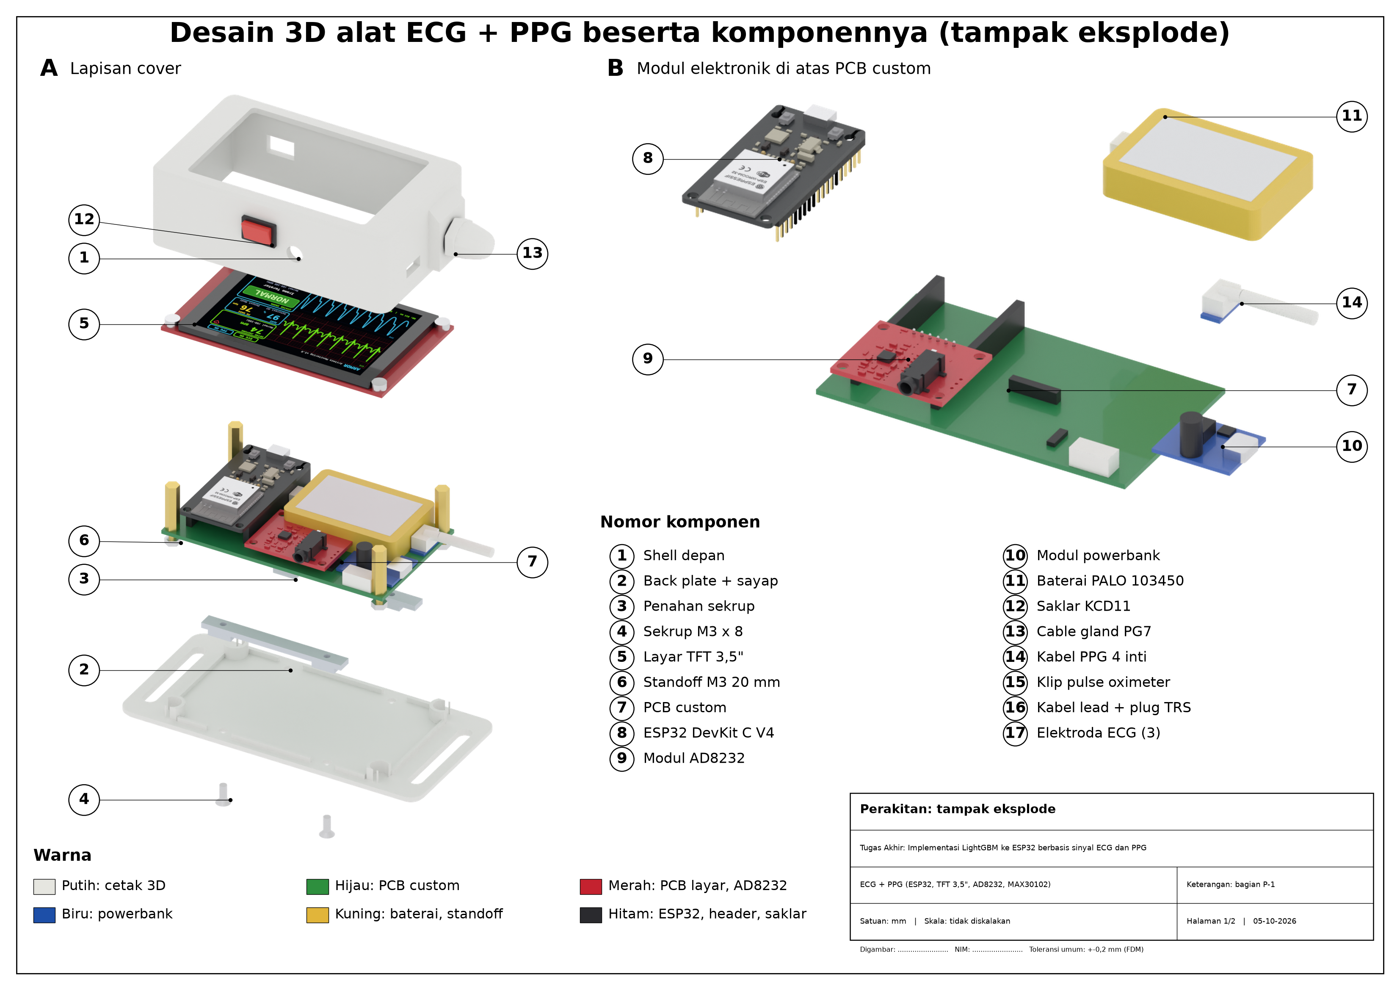
case/FINAL_TA/04_Gambar_Perakitan/Gambar_Perakitan_Hal1_A3.png
