fathurraihan18/TA/case/FINAL_TA/05_Render_3D/Cover_Belakang.png

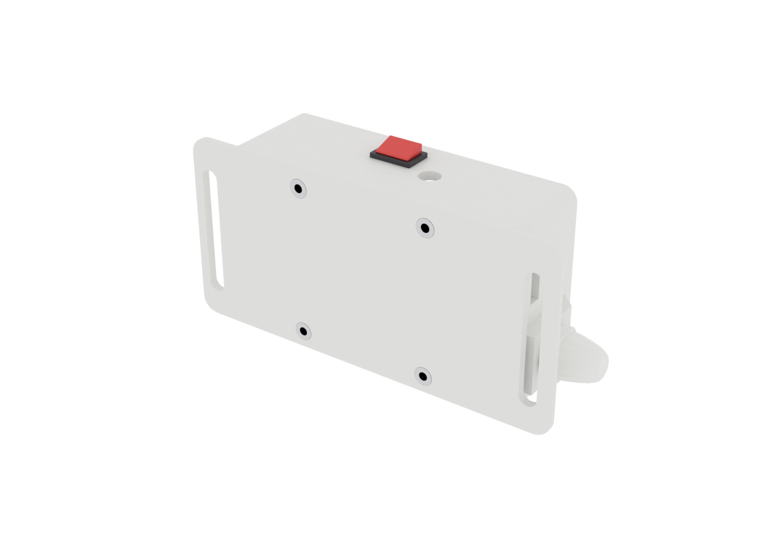
case/FINAL_TA/05_Render_3D/Cover_Belakang.png
