fathurraihan18/TA/case/FINAL_TA/05_Render_3D/Cover_Depan.png

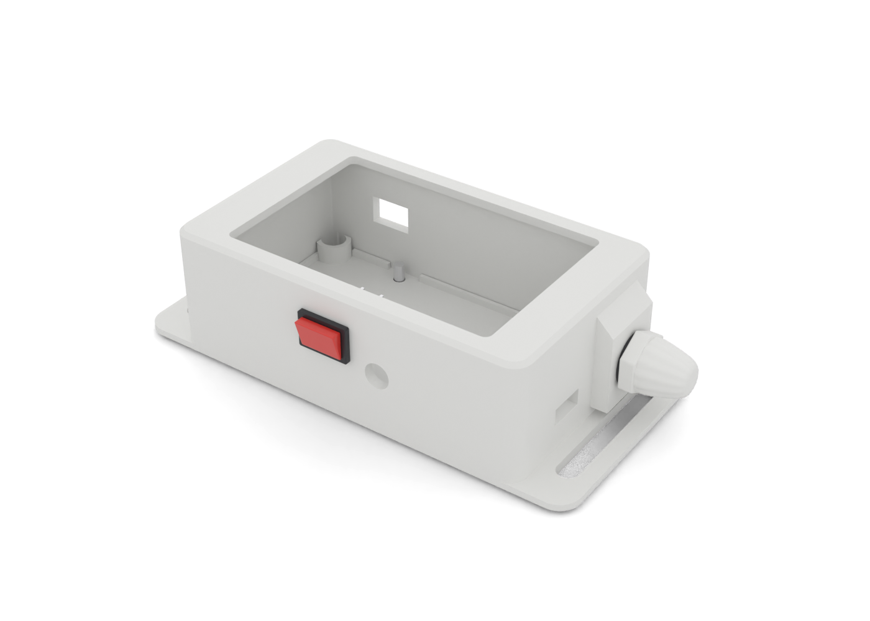
case/FINAL_TA/05_Render_3D/Cover_Depan.png
