fathurraihan18/TA/case/FINAL_TA/05_Render_3D/Eksplode_Cover.png

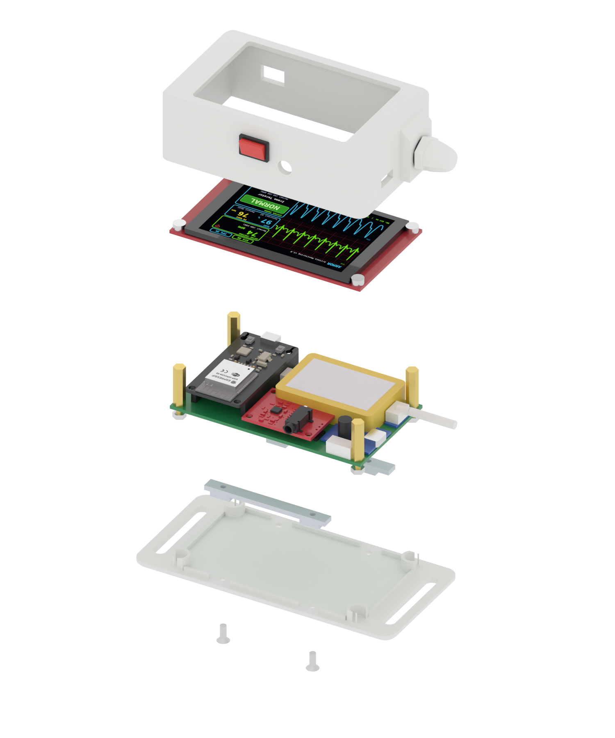
case/FINAL_TA/05_Render_3D/Eksplode_Cover.png
