fathurraihan18/TA/case/FINAL_TA/05_Render_3D/Eksplode_Modul_Elektronik.png

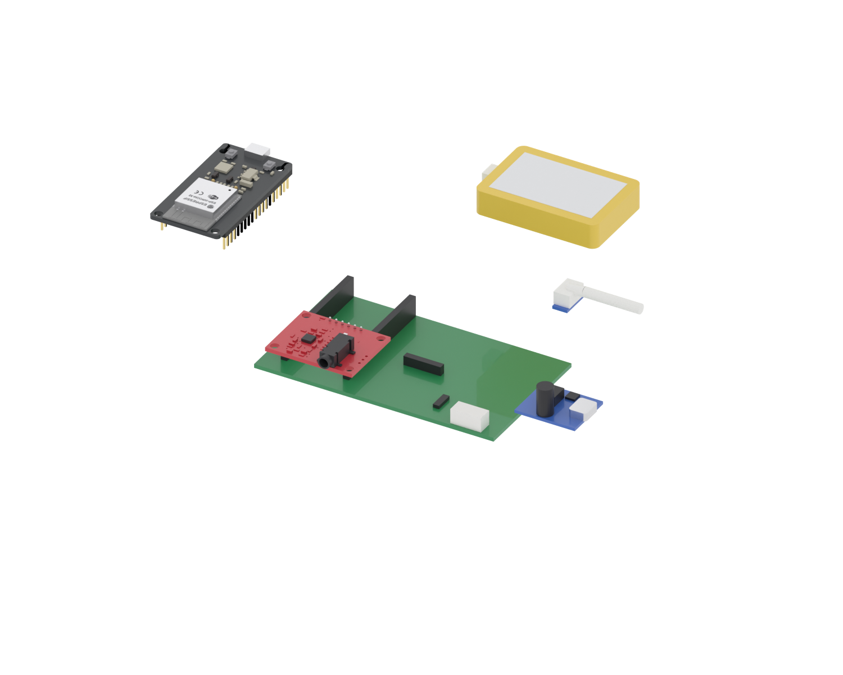
case/FINAL_TA/05_Render_3D/Eksplode_Modul_Elektronik.png
