fathurraihan18/TA/case/FINAL_TA/05_Render_3D/Elektroda_3Lead_Plug.png

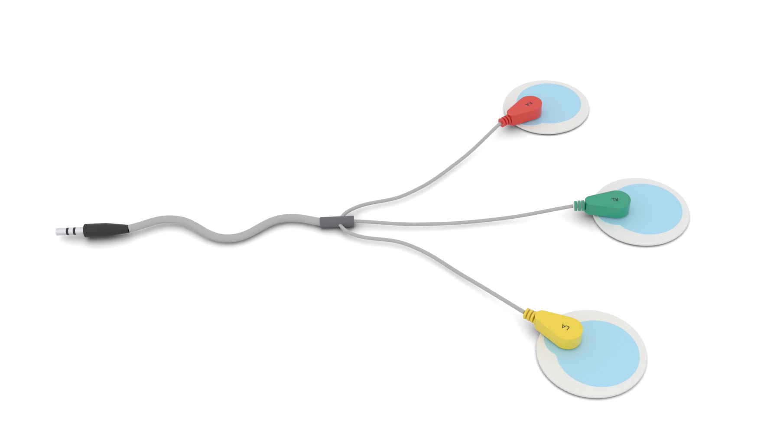
case/FINAL_TA/05_Render_3D/Elektroda_3Lead_Plug.png
