fathurraihan18/TA/case/FINAL_TA/05_Render_3D/Klip_Eksplode.png

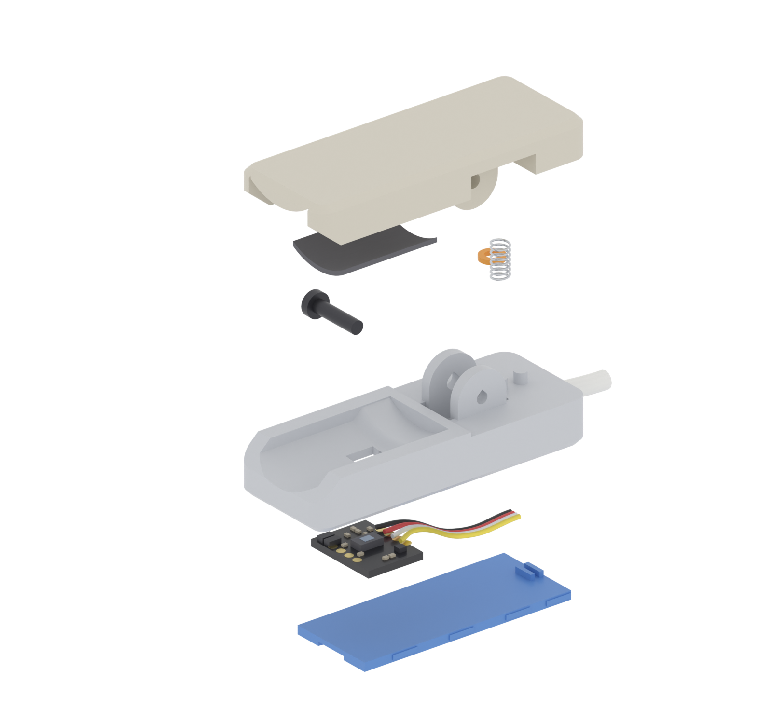
case/FINAL_TA/05_Render_3D/Klip_Eksplode.png
