fathurraihan18/TA/case/FINAL_TA/05_Render_3D/Klip_Tampak_Bawah.png

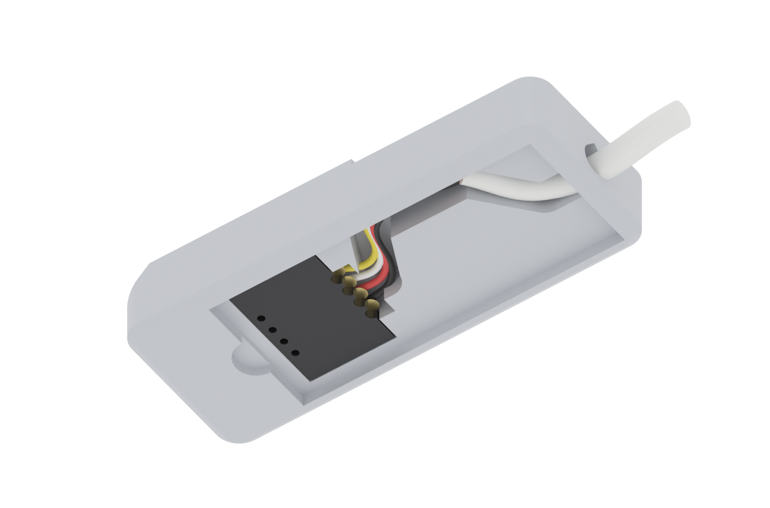
case/FINAL_TA/05_Render_3D/Klip_Tampak_Bawah.png
