fathurraihan18/TA/case/FINAL_TA/05_Render_3D/Klip_Terpasang_Jari.png

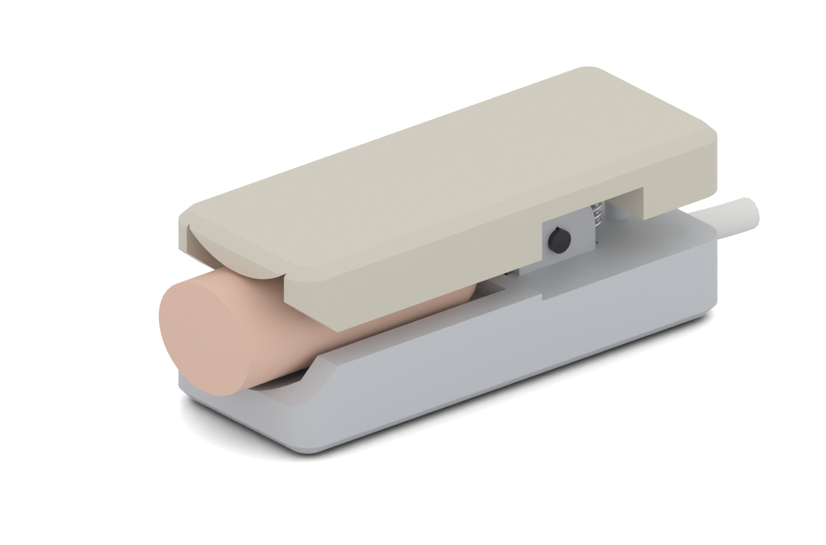
case/FINAL_TA/05_Render_3D/Klip_Terpasang_Jari.png
