fathurraihan18/TA/case/FINAL_TA/05_Render_3D/Komponen_Baterai_PALO_103450.png

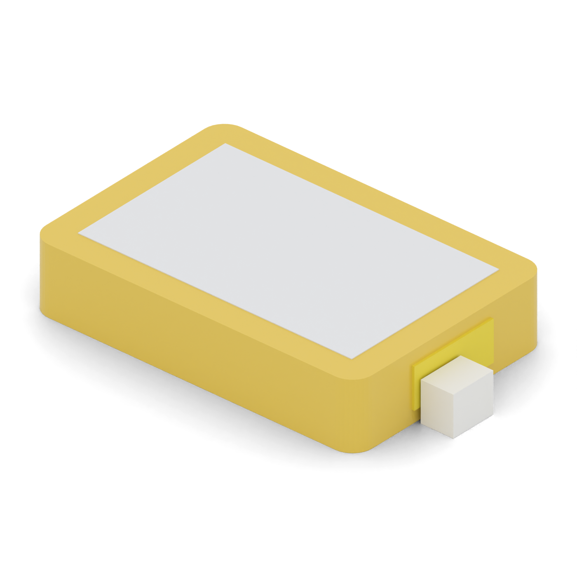
case/FINAL_TA/05_Render_3D/Komponen_Baterai_PALO_103450.png
