fathurraihan18/TA/case/FINAL_TA/05_Render_3D/Komponen_Cable_Gland_PG7.png

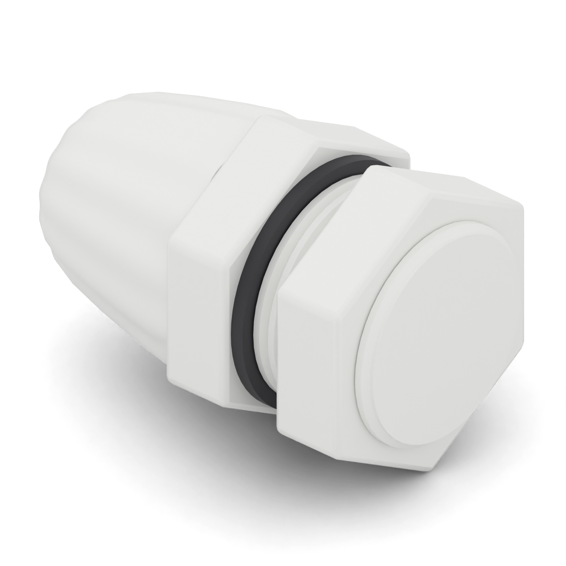
case/FINAL_TA/05_Render_3D/Komponen_Cable_Gland_PG7.png
