fathurraihan18/TA/case/FINAL_TA/05_Render_3D/Komponen_ESP32_DevKitC_V4.png

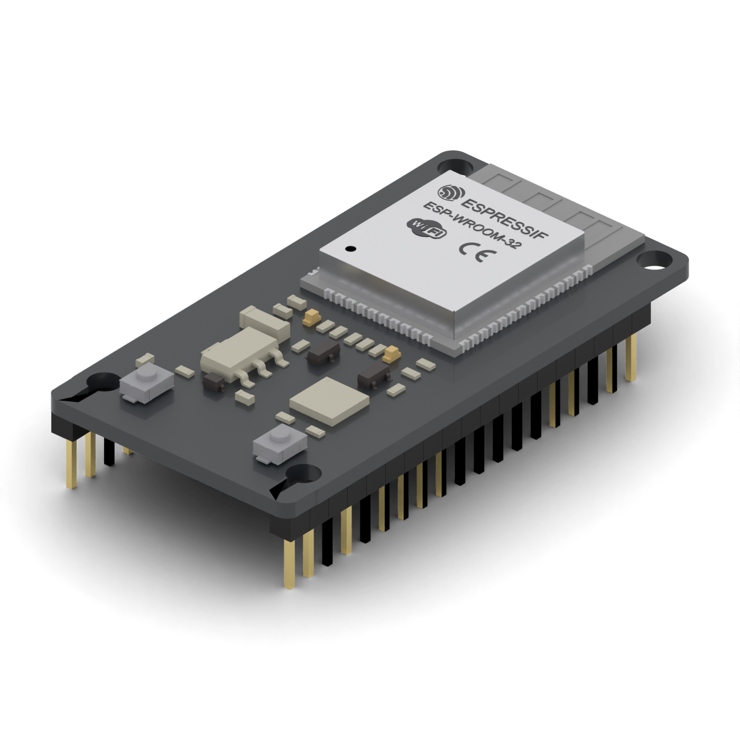
case/FINAL_TA/05_Render_3D/Komponen_ESP32_DevKitC_V4.png
