fathurraihan18/TA/case/FINAL_TA/05_Render_3D/Komponen_Layar_TFT_35.png

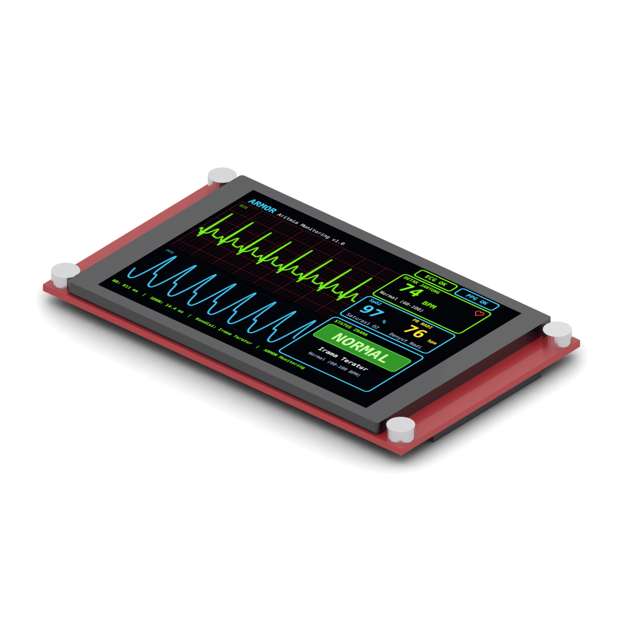
case/FINAL_TA/05_Render_3D/Komponen_Layar_TFT_35.png
