fathurraihan18/TA/case/FINAL_TA/05_Render_3D/Komponen_Modul_AD8232.png

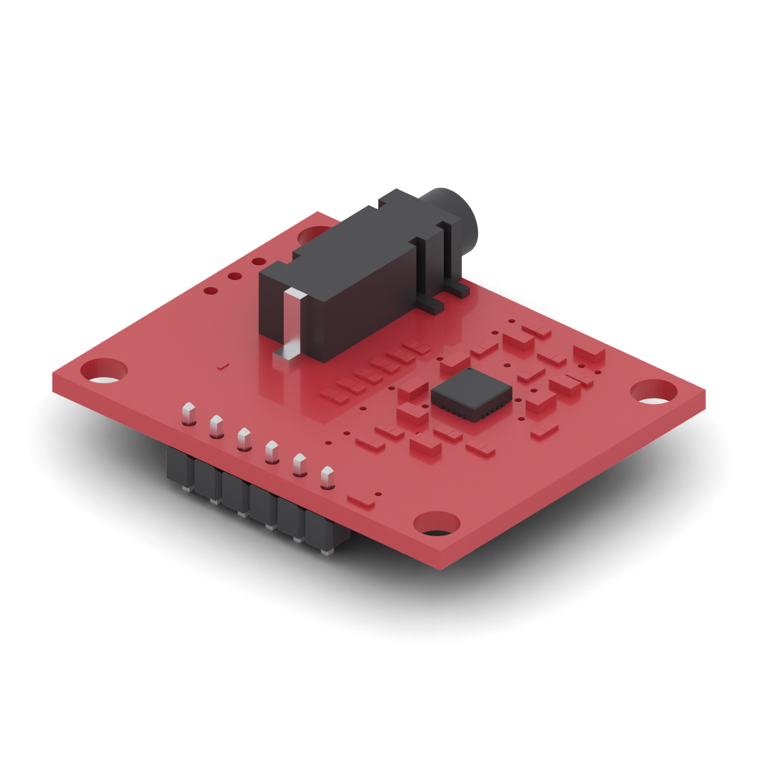
case/FINAL_TA/05_Render_3D/Komponen_Modul_AD8232.png
