fathurraihan18/TA/case/FINAL_TA/05_Render_3D/Komponen_Modul_Powerbank.png

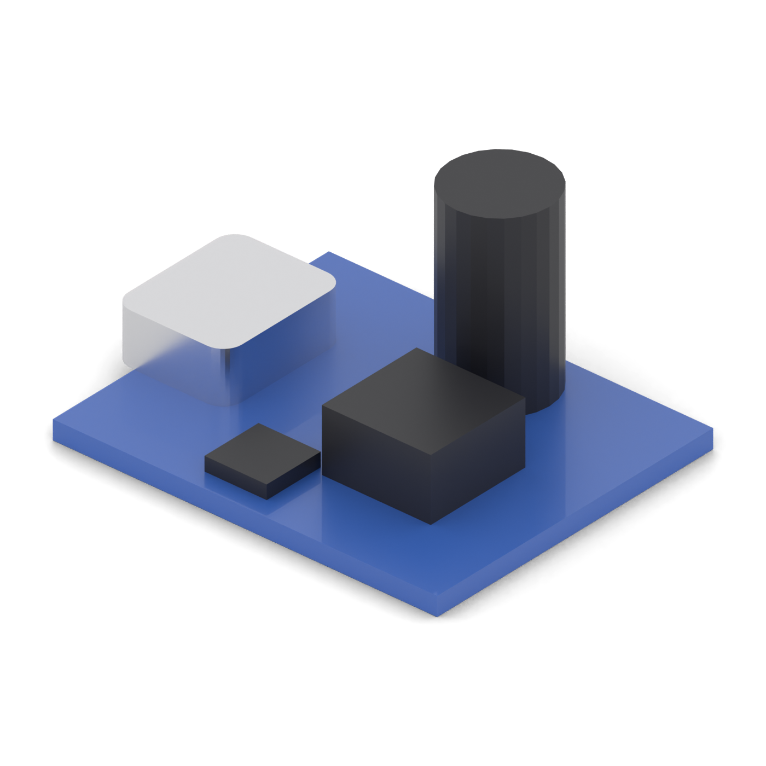
case/FINAL_TA/05_Render_3D/Komponen_Modul_Powerbank.png
