fathurraihan18/TA/case/FINAL_TA/05_Render_3D/Komponen_Saklar_KCD11.png

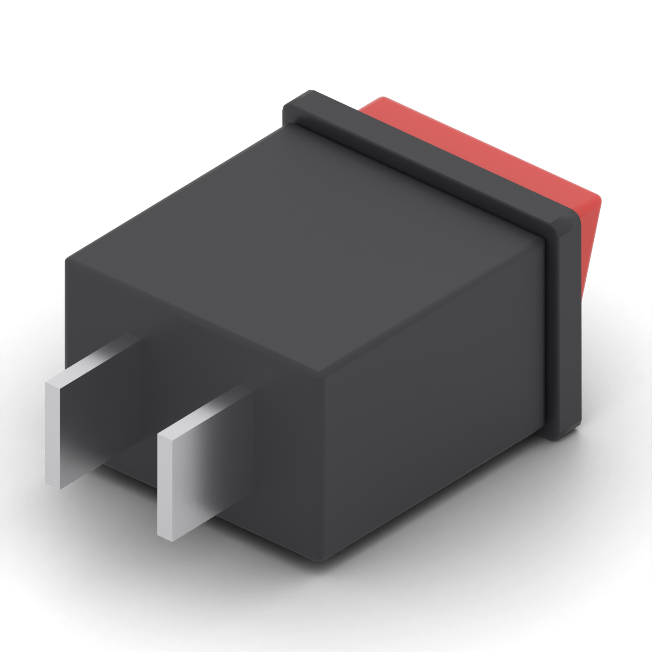
case/FINAL_TA/05_Render_3D/Komponen_Saklar_KCD11.png
