fathurraihan18/TA/case/FINAL_TA/05_Render_3D/Komponen_Sensor_MAX30102_HW605.png

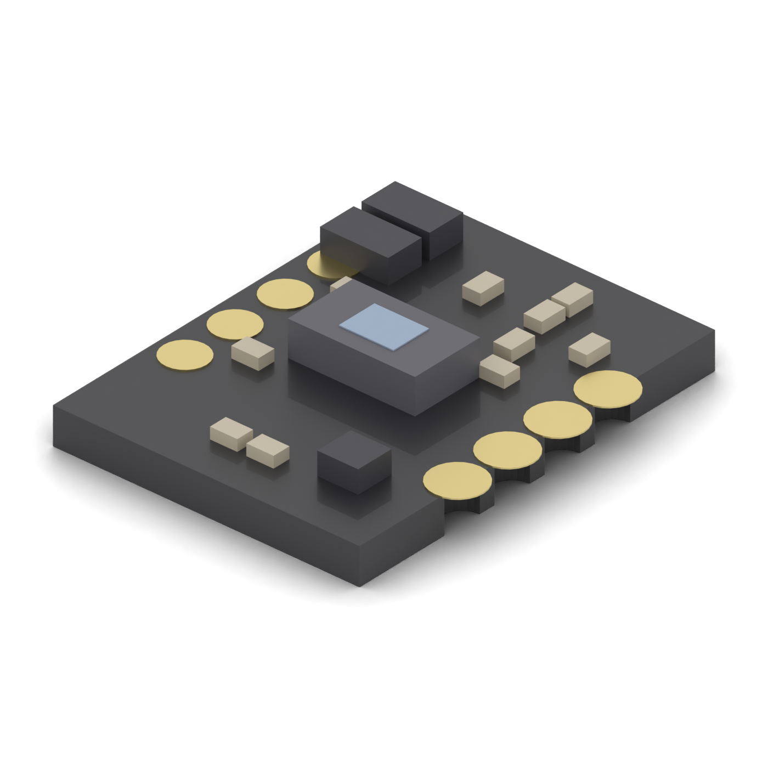
case/FINAL_TA/05_Render_3D/Komponen_Sensor_MAX30102_HW605.png
