fathurraihan18/TA/case/FINAL_TA/05_Render_3D/Penempatan_Pengguna.png

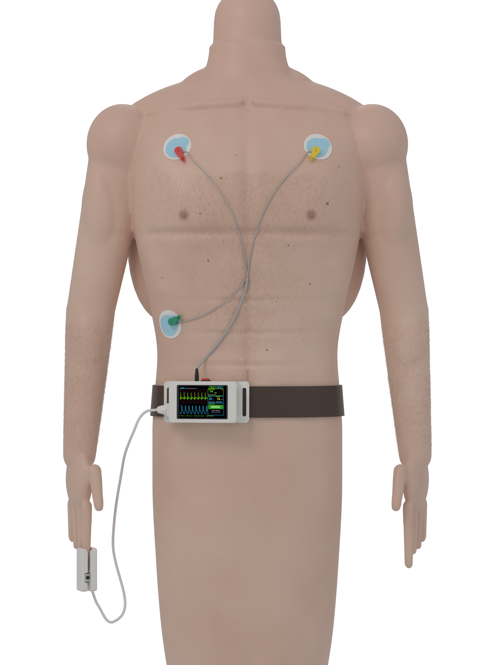
case/FINAL_TA/05_Render_3D/Penempatan_Pengguna.png
