fathurraihan18/TA/case/FINAL_TA/05_Render_3D/Sistem_Lengkap.png

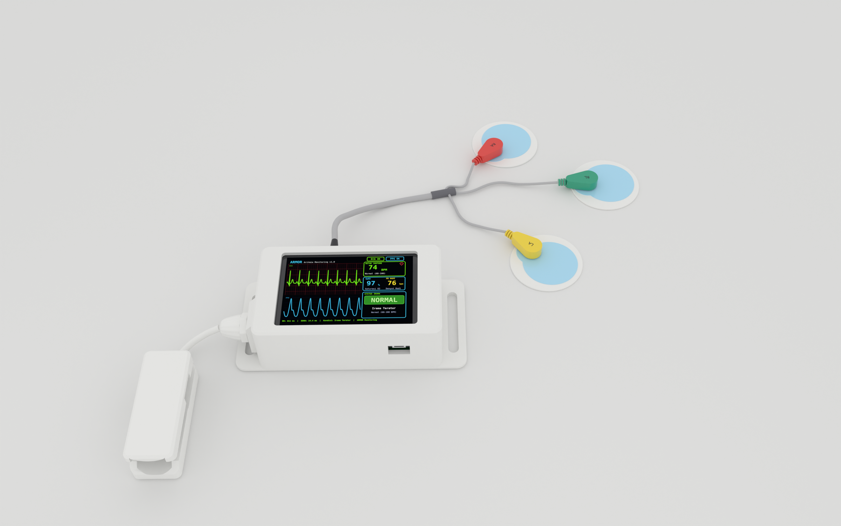
case/FINAL_TA/05_Render_3D/Sistem_Lengkap.png
