fathurraihan18/TA/case/FINAL_TA/08_Jurnal_Satu_Per_Satu/Fig01_Exploded_view_enclosure.png

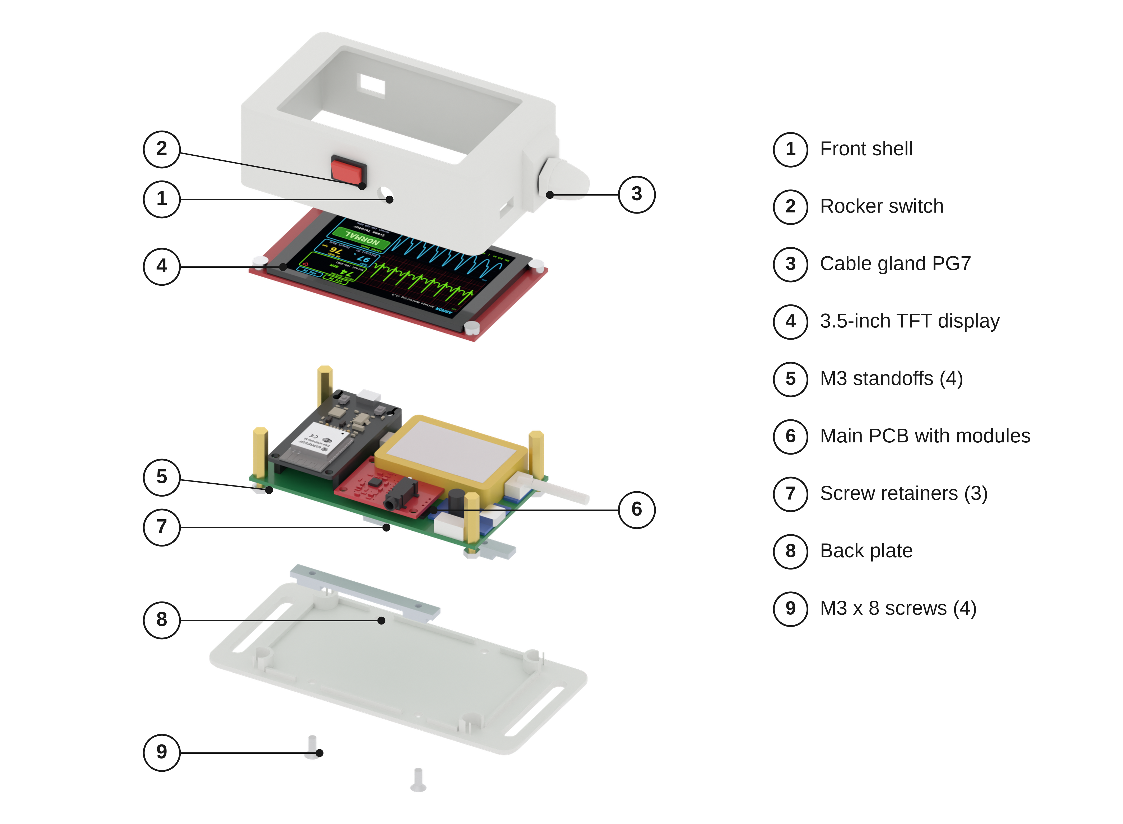
case/FINAL_TA/08_Jurnal_Satu_Per_Satu/Fig01_Exploded_view_enclosure.png
