fathurraihan18/TA/case/FINAL_TA/08_Jurnal_Satu_Per_Satu/Fig02_Exploded_view_electronics.png

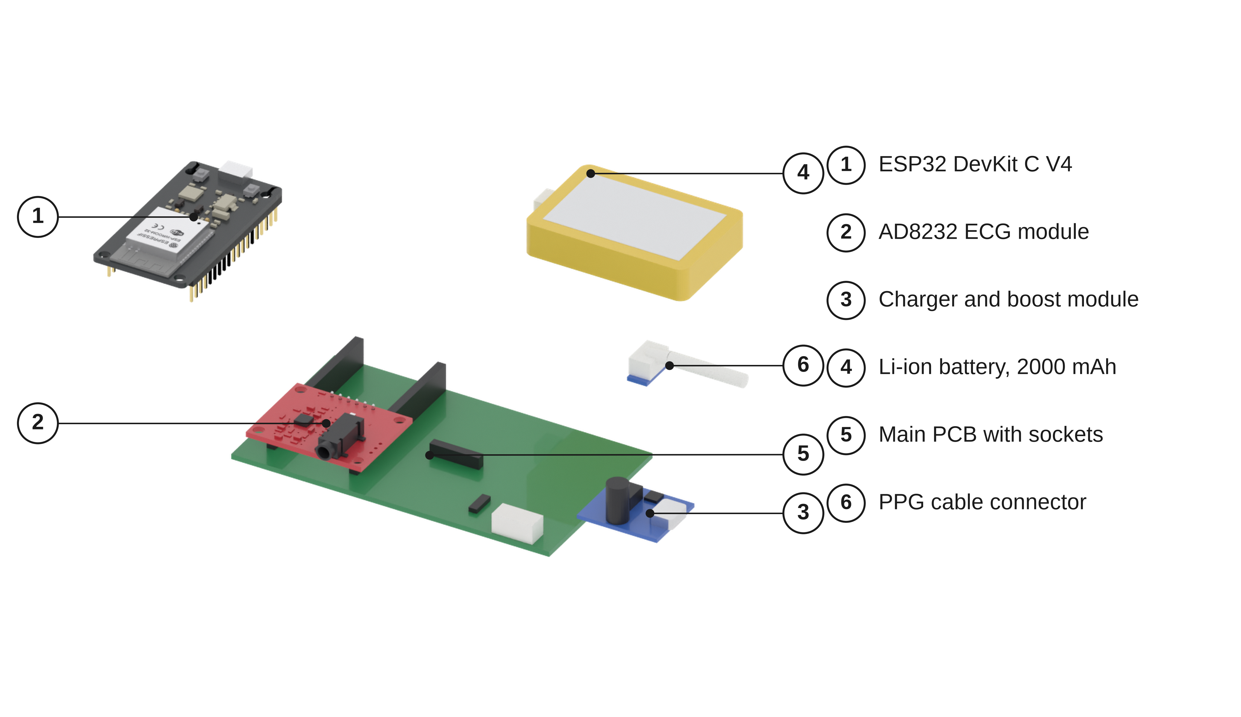
case/FINAL_TA/08_Jurnal_Satu_Per_Satu/Fig02_Exploded_view_electronics.png
