fathurraihan18/TA/case/FINAL_TA/08_Jurnal_Satu_Per_Satu/Fig03_System_overview.png

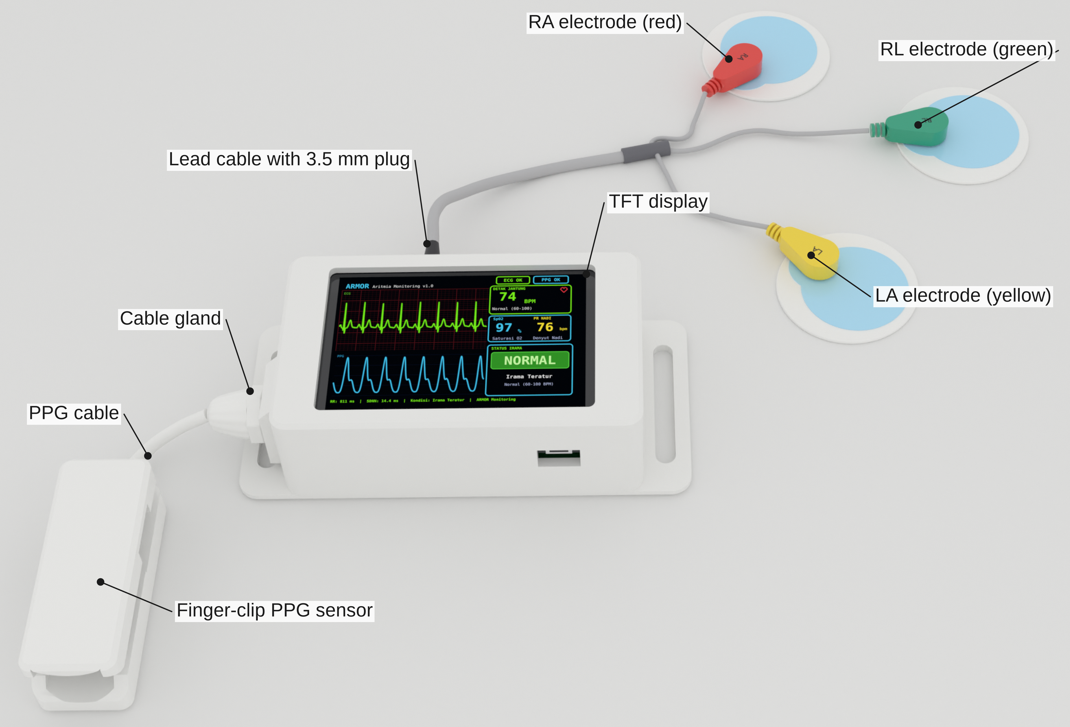
case/FINAL_TA/08_Jurnal_Satu_Per_Satu/Fig03_System_overview.png
