fathurraihan18/TA/case/FINAL_TA/08_Jurnal_Satu_Per_Satu/Fig05_Electrode_details.png

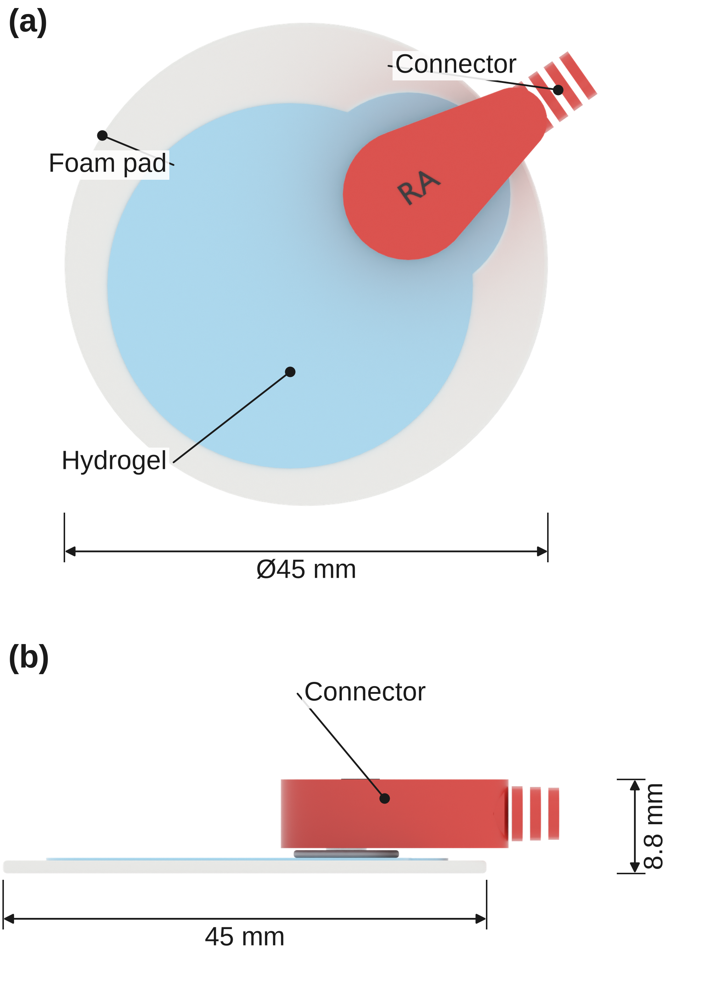
case/FINAL_TA/08_Jurnal_Satu_Per_Satu/Fig05_Electrode_details.png
