fathurraihan18/TA/case/FINAL_TA/08_Jurnal_Satu_Per_Satu/Fig06_Lead_cable_and_plug.png

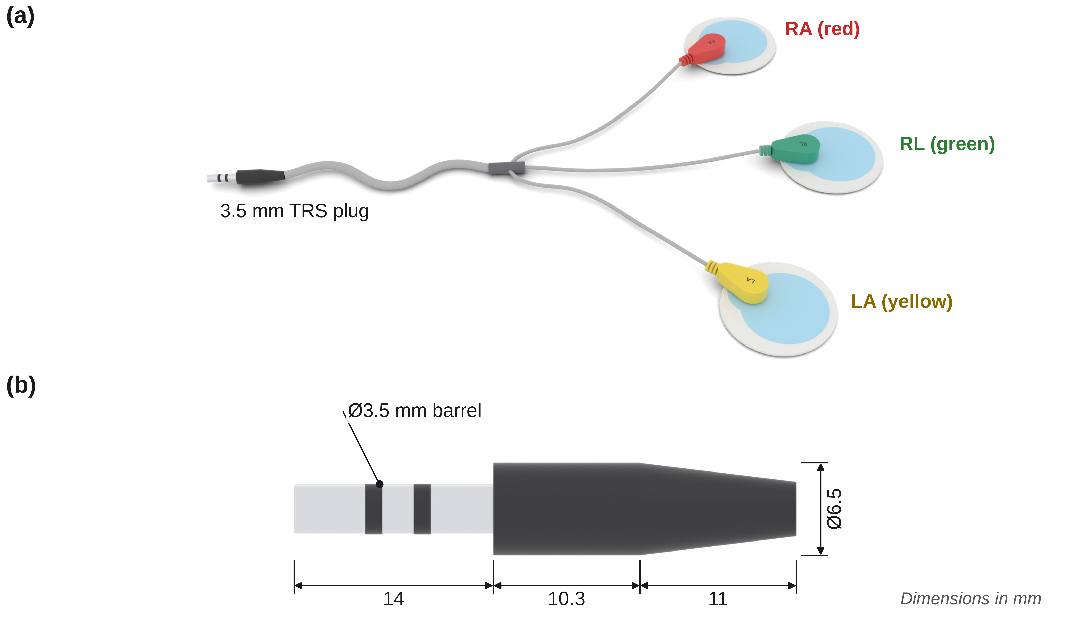
case/FINAL_TA/08_Jurnal_Satu_Per_Satu/Fig06_Lead_cable_and_plug.png
