fathurraihan18/TA/case/FINAL_TA/08_Jurnal_Satu_Per_Satu/Fig07_Lead_colour_code.png

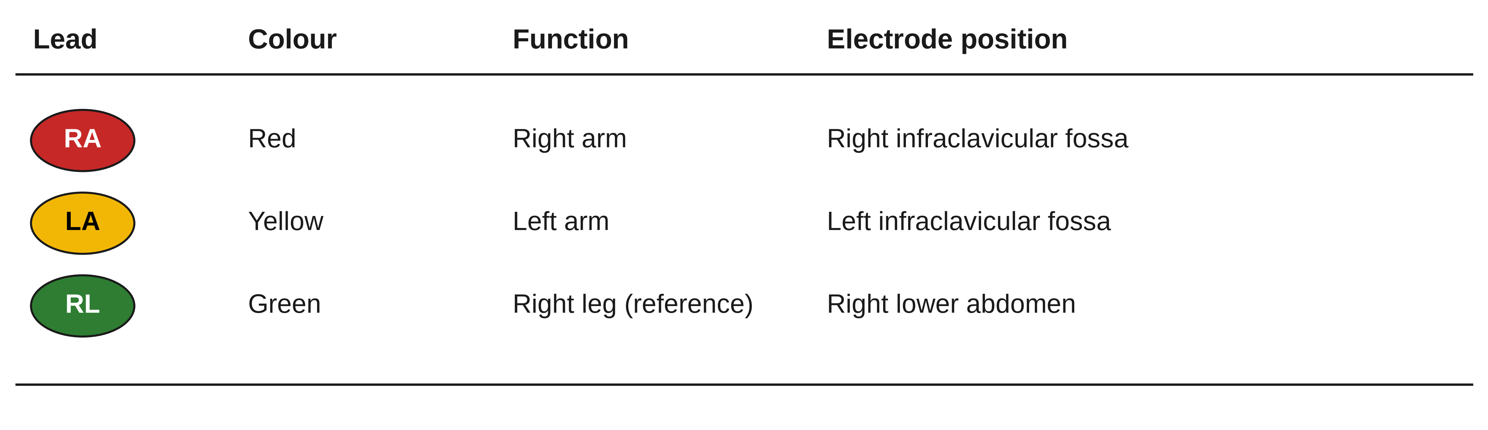
case/FINAL_TA/08_Jurnal_Satu_Per_Satu/Fig07_Lead_colour_code.png
