fathurraihan18/TA/case/FINAL_TA/08_Jurnal_Satu_Per_Satu/Fig08_ESP32_DevKit_C_V4.png

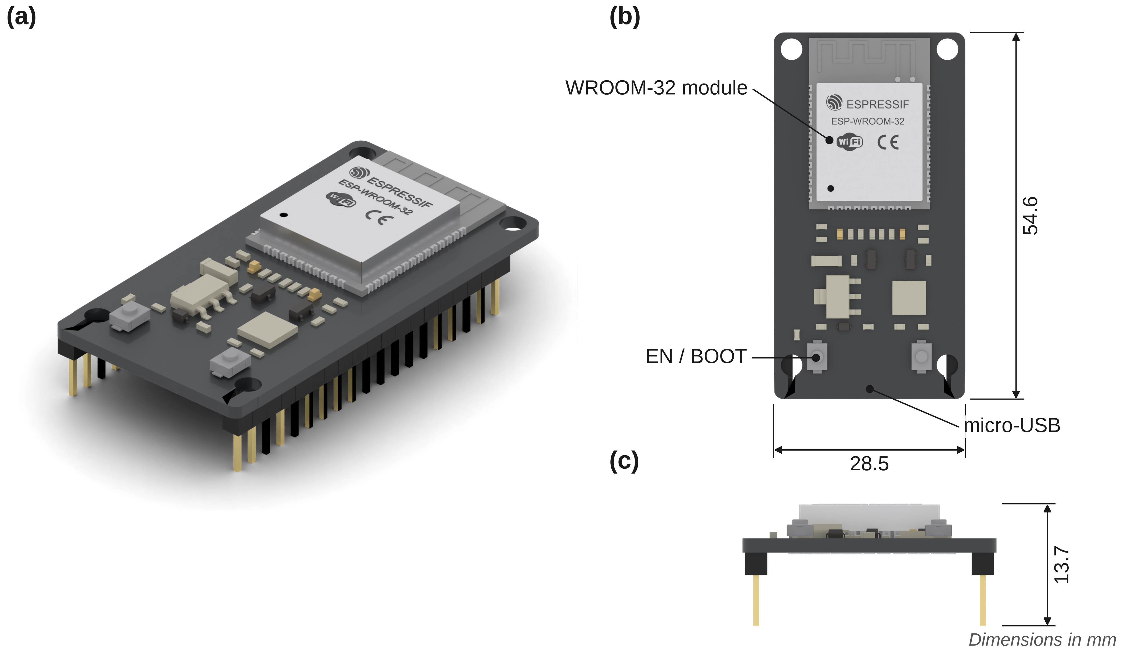
case/FINAL_TA/08_Jurnal_Satu_Per_Satu/Fig08_ESP32_DevKit_C_V4.png
