fathurraihan18/TA/case/FINAL_TA/08_Jurnal_Satu_Per_Satu/Fig11_Cable_gland_and_rocker_switch.png

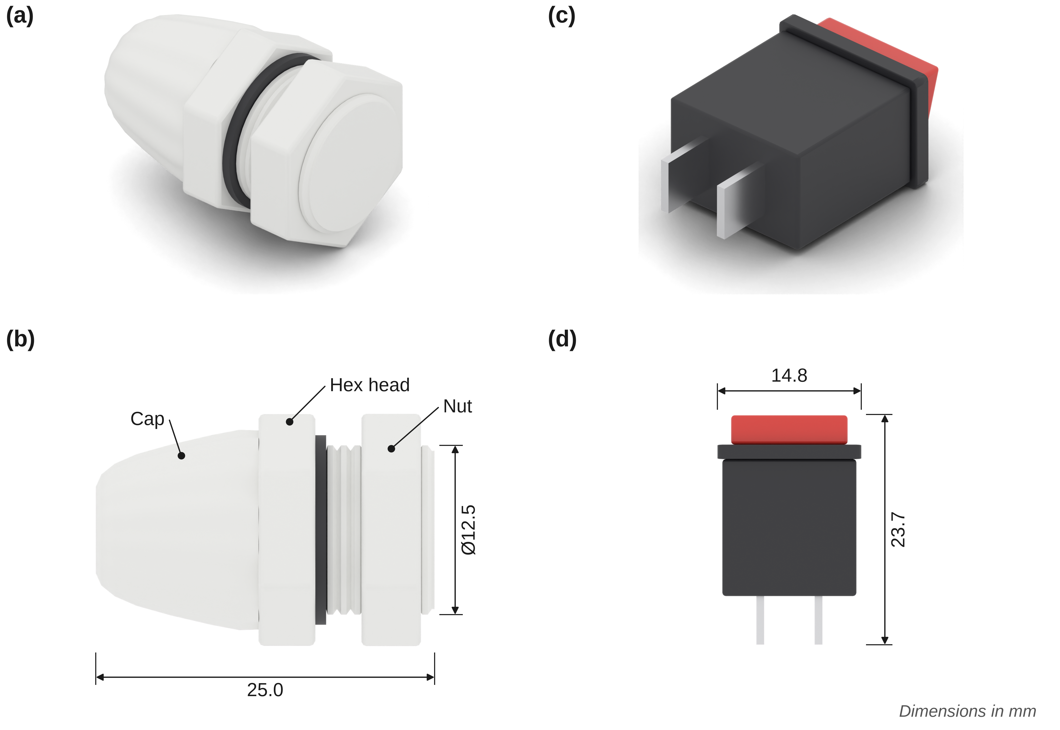
case/FINAL_TA/08_Jurnal_Satu_Per_Satu/Fig11_Cable_gland_and_rocker_switch.png
