fathurraihan18/TA/case/FINAL_TA/08_Jurnal_Satu_Per_Satu/Fig13_Enclosure_dimensions.png

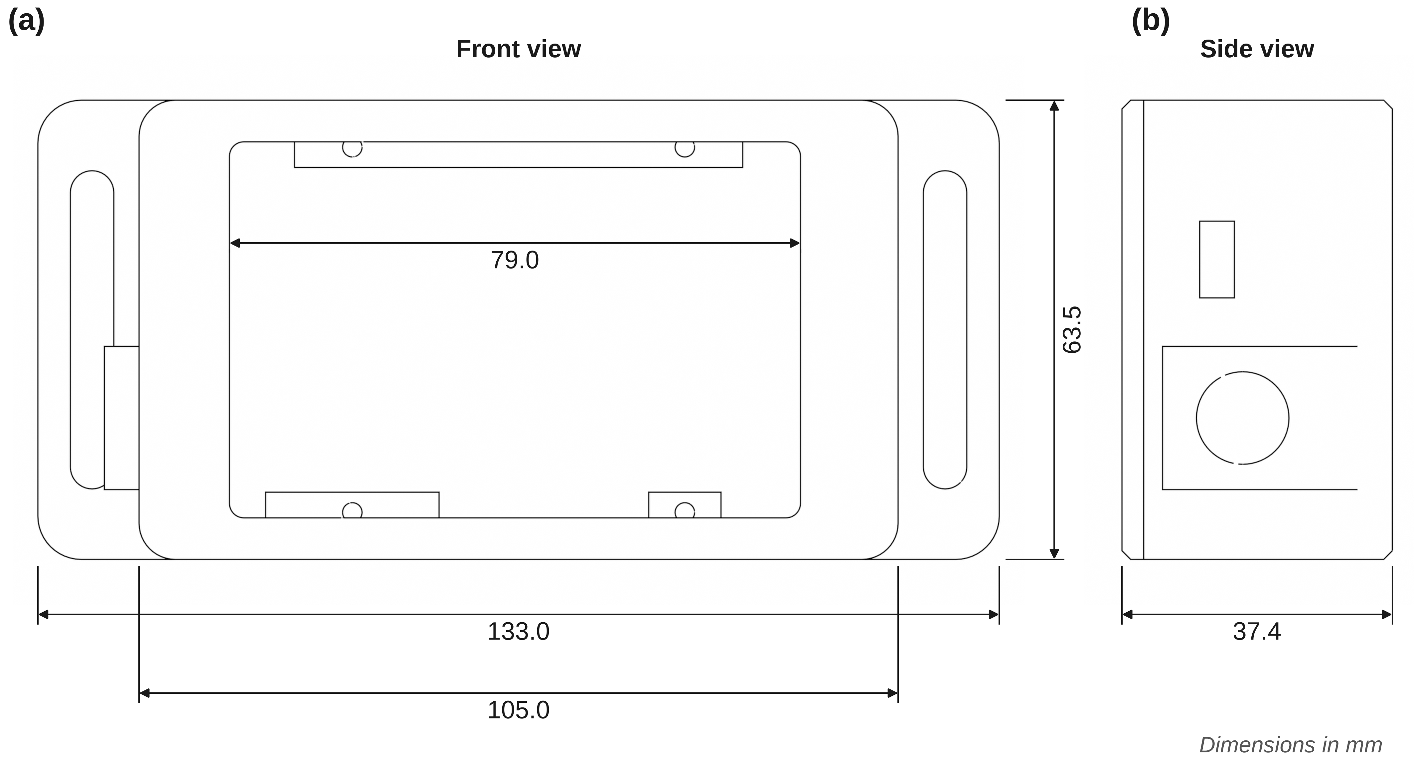
case/FINAL_TA/08_Jurnal_Satu_Per_Satu/Fig13_Enclosure_dimensions.png
