fathurraihan18/TA/case/FINAL_TA/08_Jurnal_Satu_Per_Satu/Fig14_Exploded_view_finger_clip.png

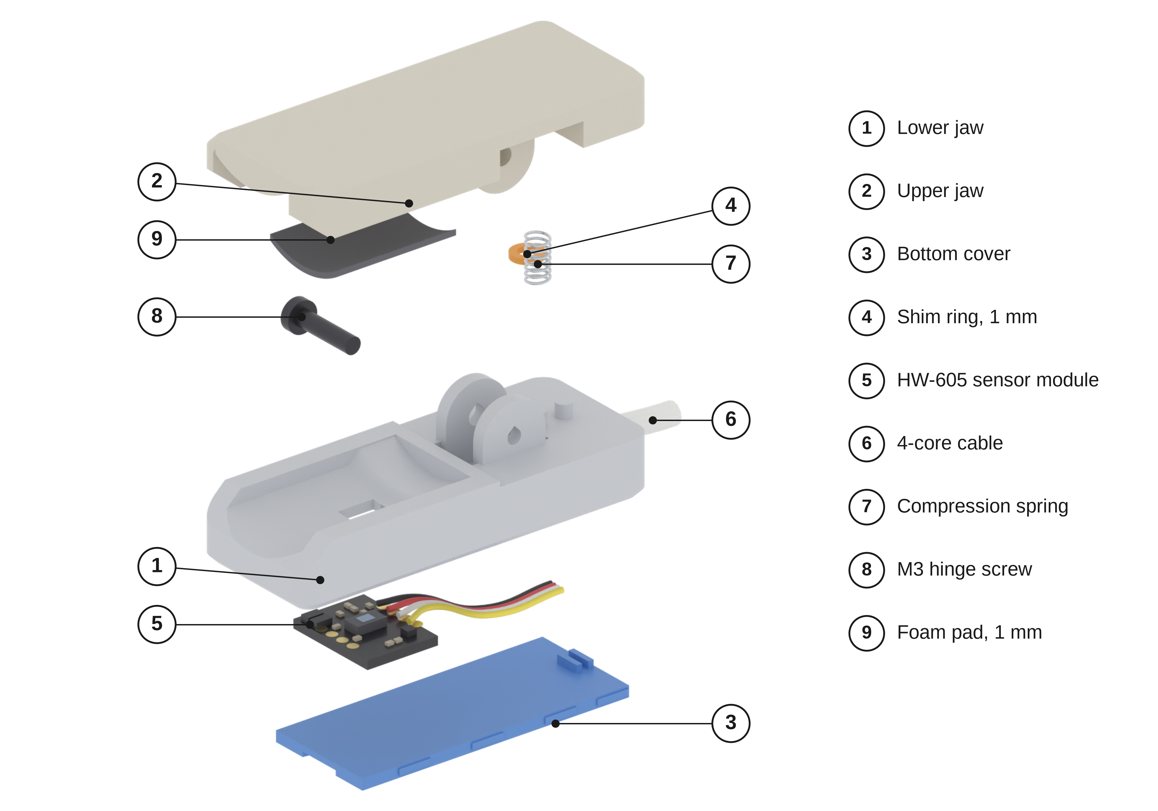
case/FINAL_TA/08_Jurnal_Satu_Per_Satu/Fig14_Exploded_view_finger_clip.png
