fathurraihan18/TA/case/FINAL_TA/08_Jurnal_Satu_Per_Satu/Fig16_Display_user_interface.png

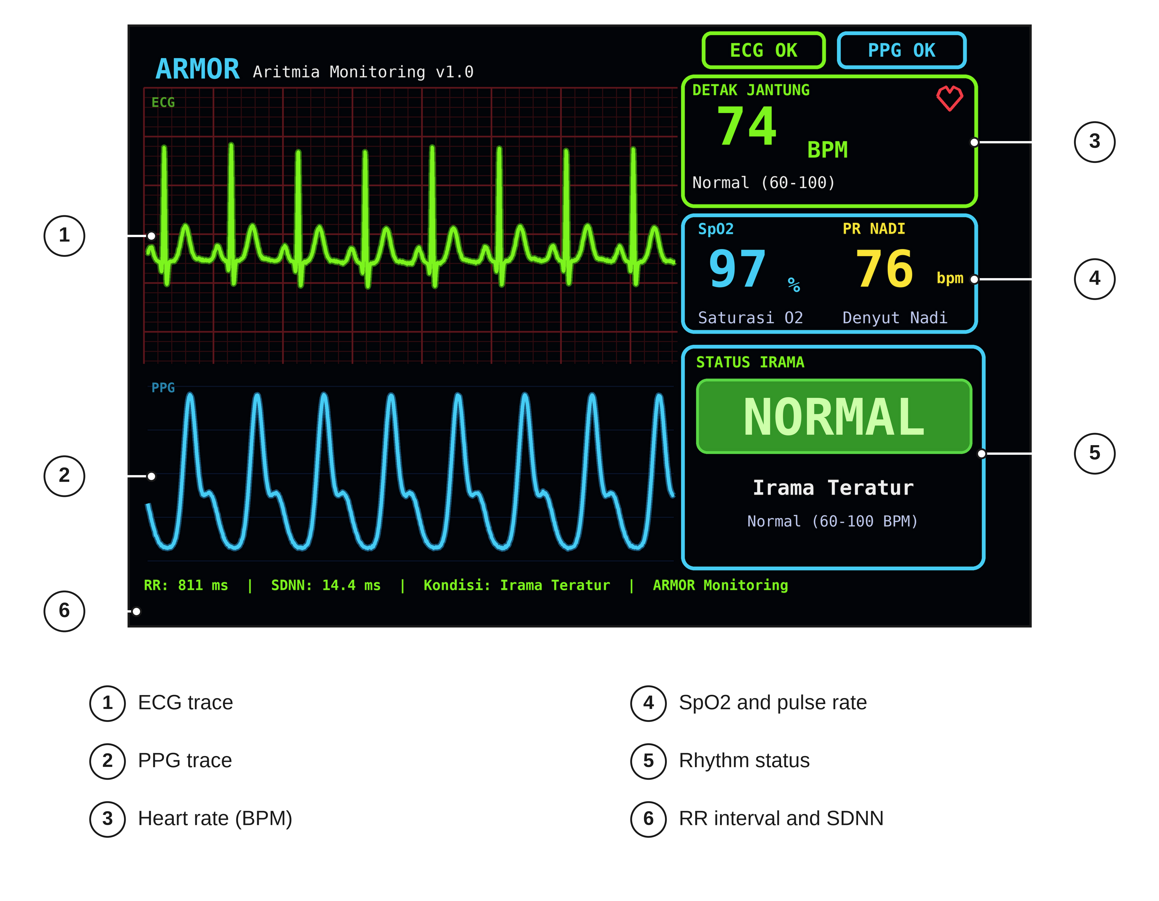
case/FINAL_TA/08_Jurnal_Satu_Per_Satu/Fig16_Display_user_interface.png
