fathurraihan18/TA/case/FINAL_TA/09_Foto_Latar_Polos/Foto1_Latar_Putih.png

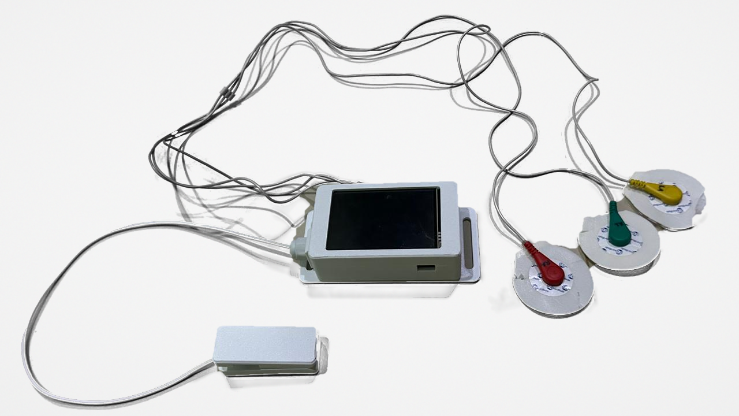
case/FINAL_TA/09_Foto_Latar_Polos/Foto1_Latar_Putih.png
