fathurraihan18/TA/case/FINAL_TA/09_Foto_Latar_Polos/Foto2_Latar_Abu.png

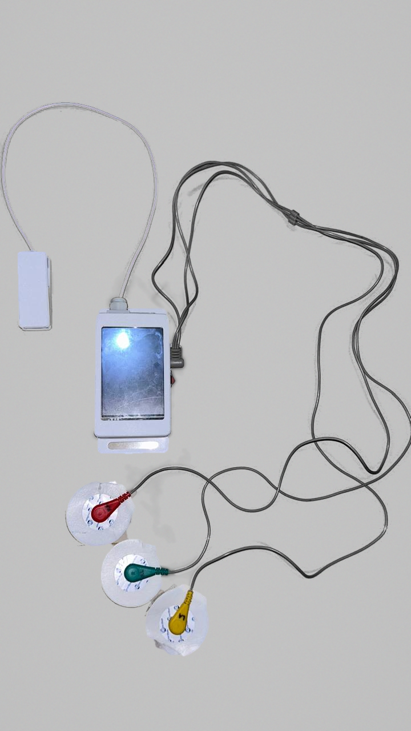
case/FINAL_TA/09_Foto_Latar_Polos/Foto2_Latar_Abu.png
