fathurraihan18/TA/case/FINAL_TA/_render/elektroda/elektroda_side.png

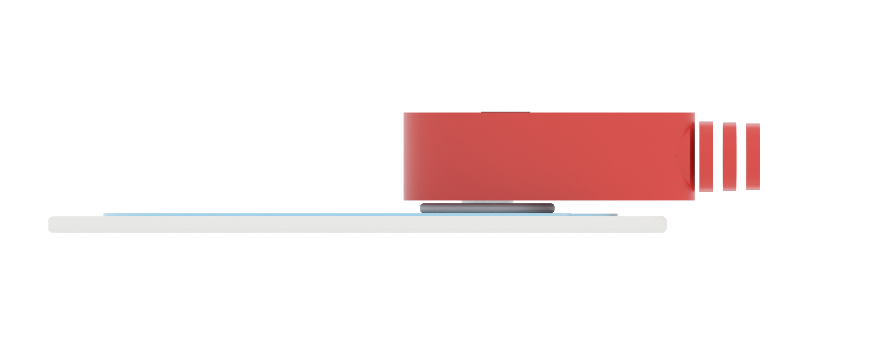
case/FINAL_TA/_render/elektroda/elektroda_side.png
