fathurraihan18/TA/case/FINAL_TA/_render/elektroda/elektroda_top.png

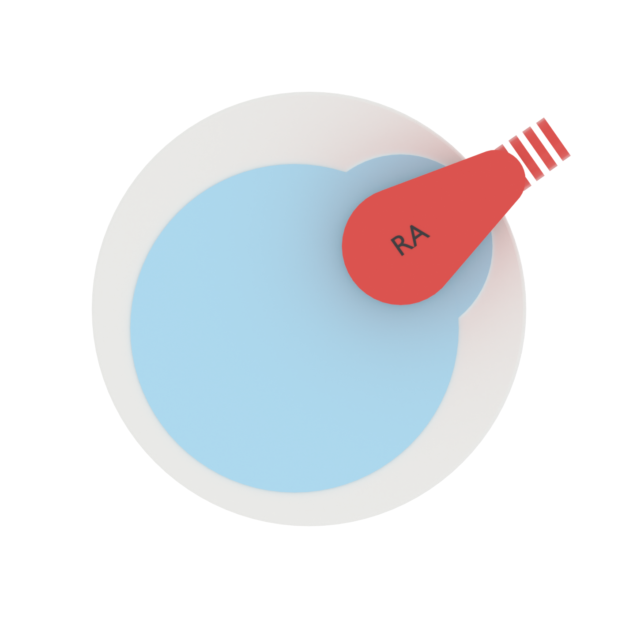
case/FINAL_TA/_render/elektroda/elektroda_top.png
