fathurraihan18/TA/case/FINAL_TA/_render/elektroda/plug_side.png

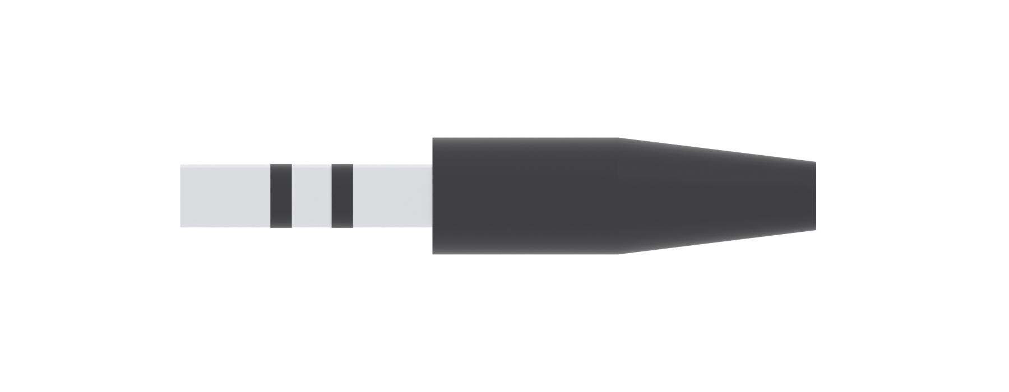
case/FINAL_TA/_render/elektroda/plug_side.png
