fathurraihan18/TA/case/FINAL_TA/_render/garis/garis_atas.png

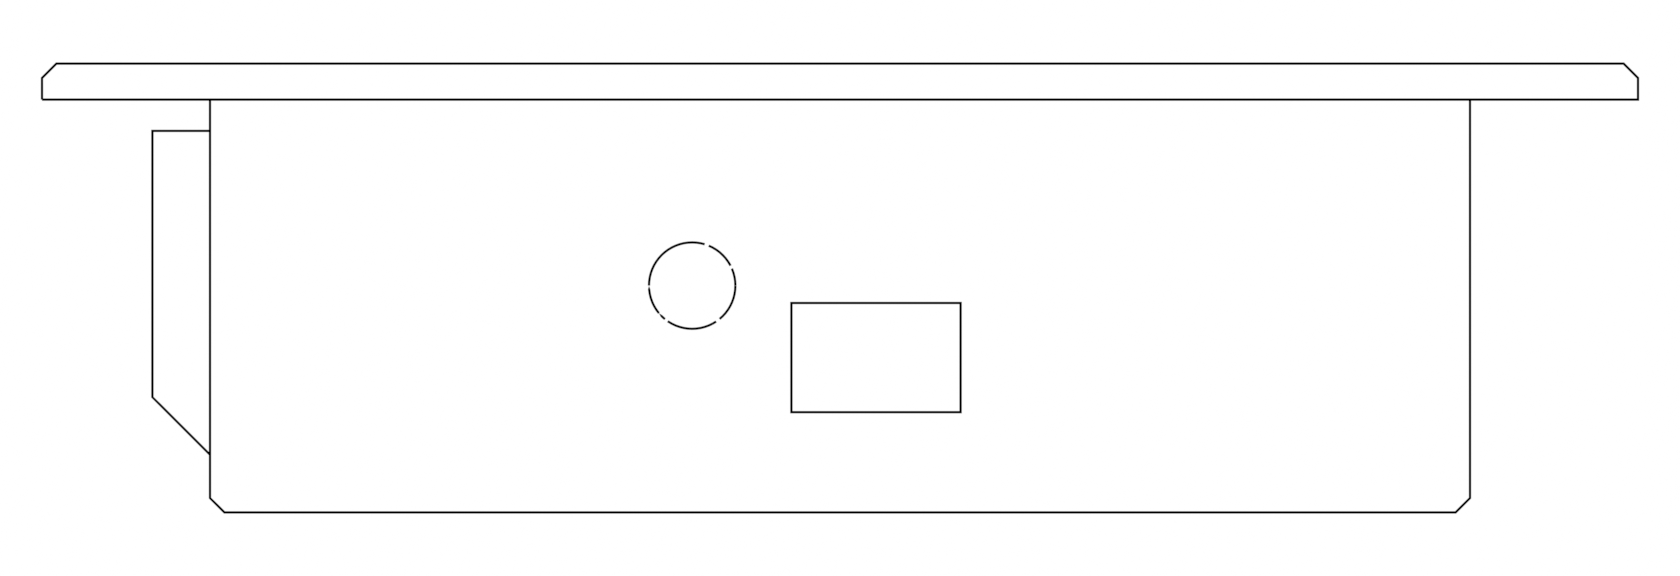
case/FINAL_TA/_render/garis/garis_atas.png
