fathurraihan18/TA/case/FINAL_TA/_render/garis/garis_bawah.png

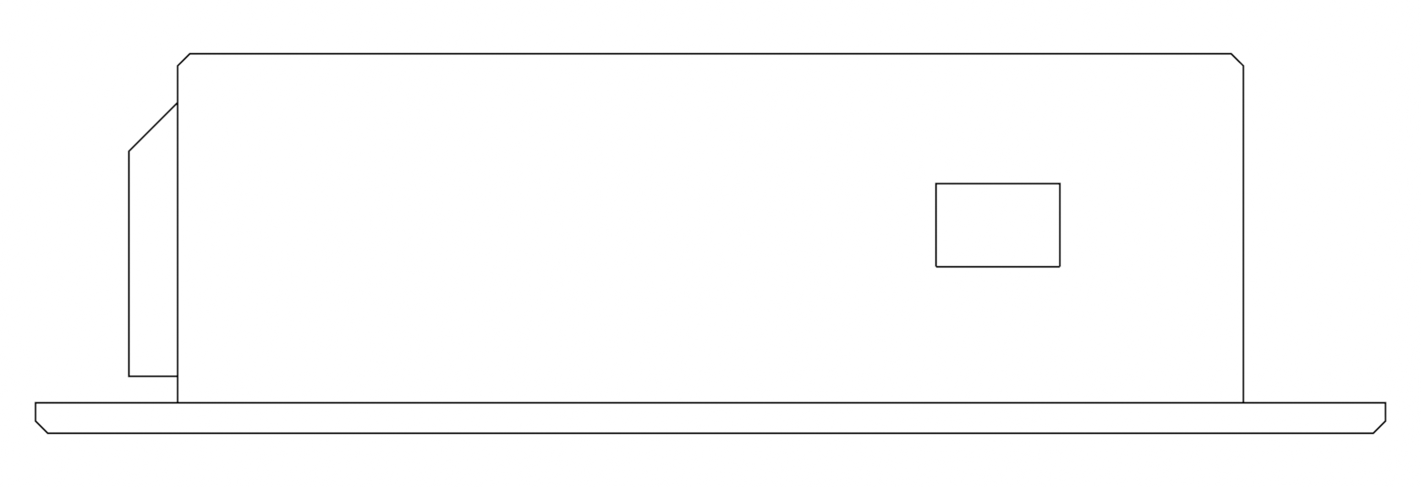
case/FINAL_TA/_render/garis/garis_bawah.png
