fathurraihan18/TA/case/FINAL_TA/_render/garis/garis_belakang.png

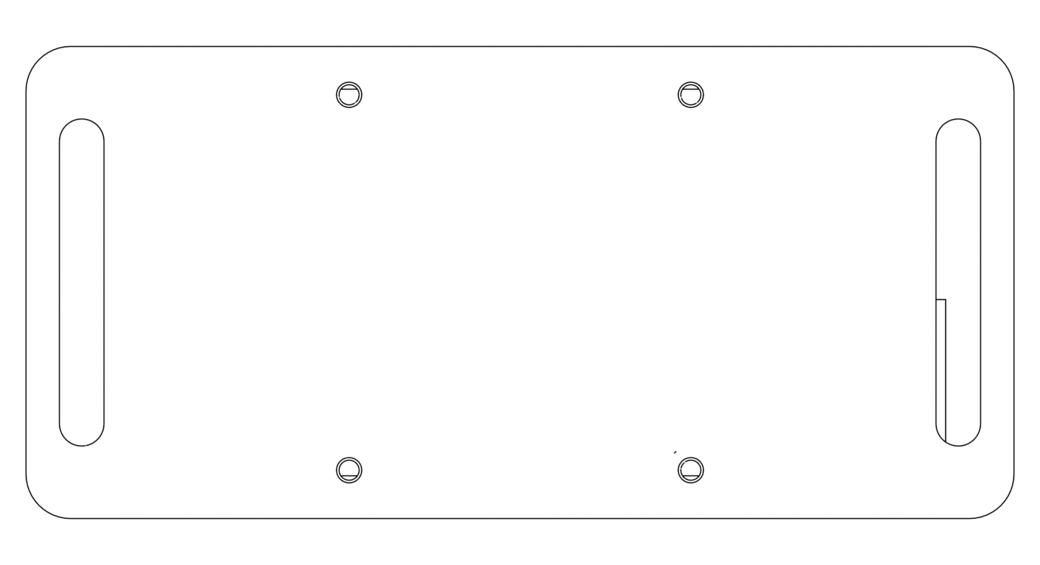
case/FINAL_TA/_render/garis/garis_belakang.png
