fathurraihan18/TA/case/FINAL_TA/_render/garis/garis_depan.png

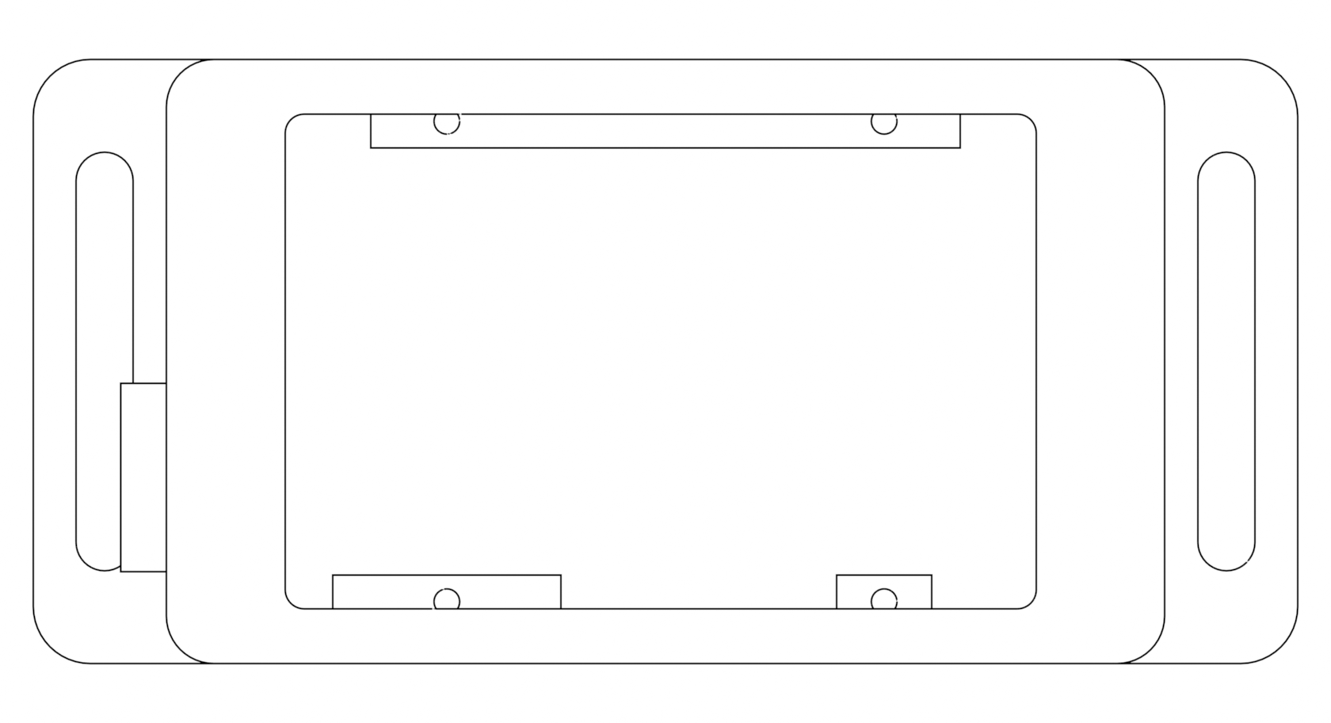
case/FINAL_TA/_render/garis/garis_depan.png
