fathurraihan18/TA/case/FINAL_TA/_render/garis/garis_kanan.png

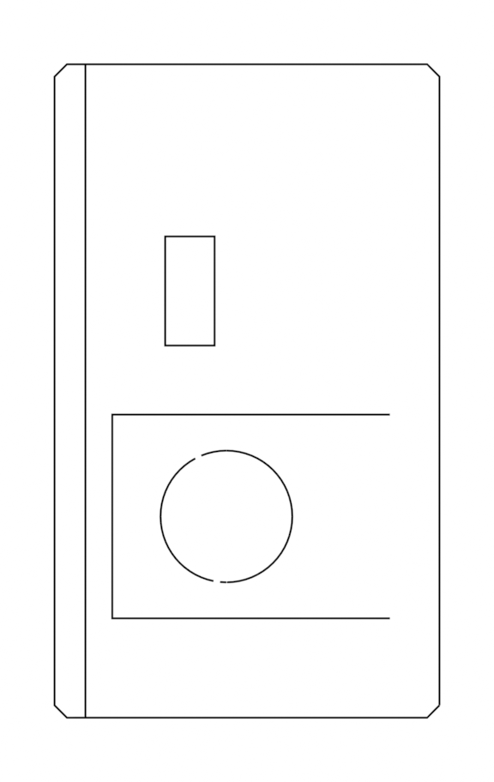
case/FINAL_TA/_render/garis/garis_kanan.png
