fathurraihan18/TA/case/FINAL_TA/_render/garis/garis_kiri.png

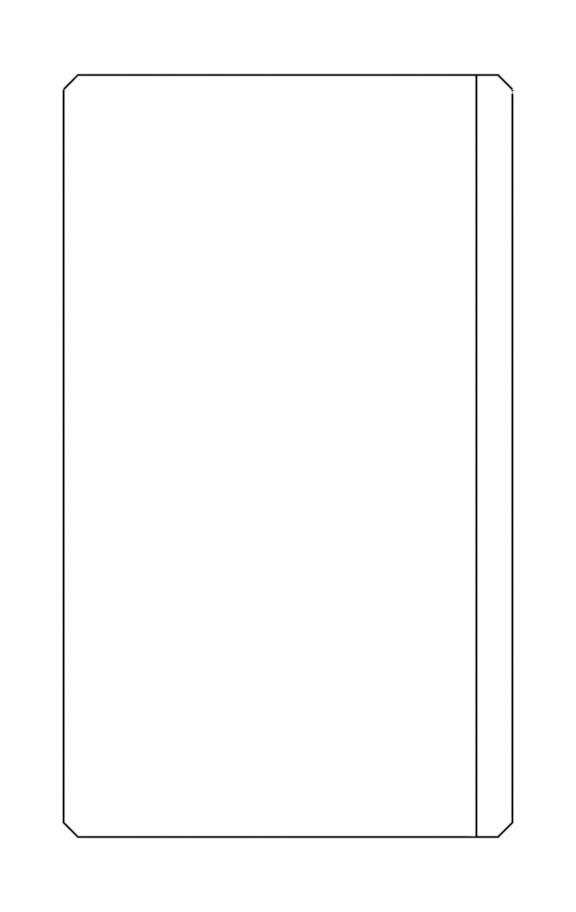
case/FINAL_TA/_render/garis/garis_kiri.png
