fathurraihan18/TA/case/FINAL_TA/_render/komponen/ad8232_top.png

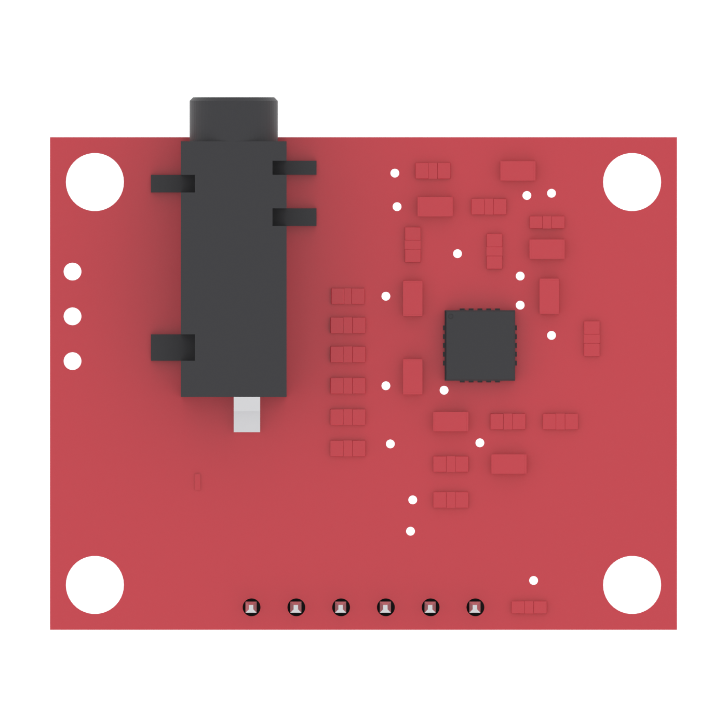
case/FINAL_TA/_render/komponen/ad8232_top.png
