fathurraihan18/TA/case/FINAL_TA/_render/komponen/baterai_front.png

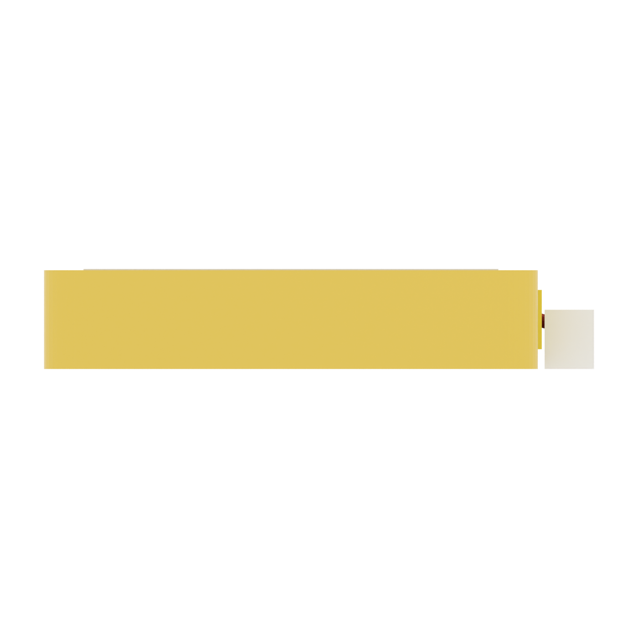
case/FINAL_TA/_render/komponen/baterai_front.png
