fathurraihan18/TA/case/FINAL_TA/_render/komponen/baterai_top.png

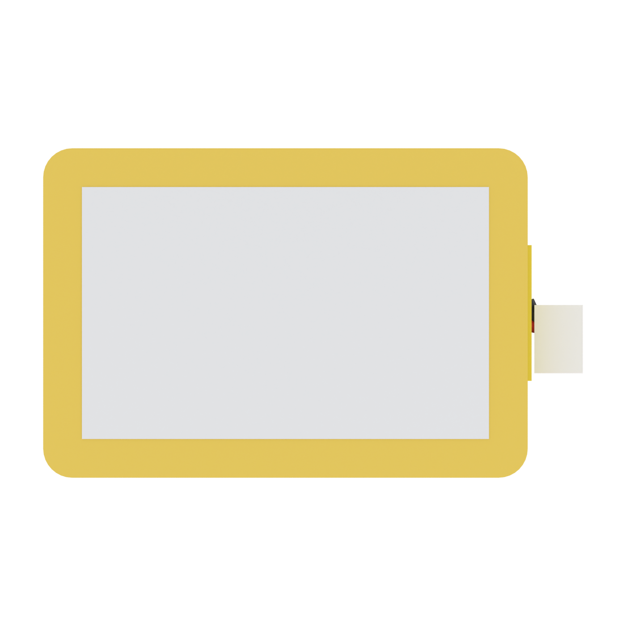
case/FINAL_TA/_render/komponen/baterai_top.png
