fathurraihan18/TA/case/FINAL_TA/_render/komponen/esp32_front.png

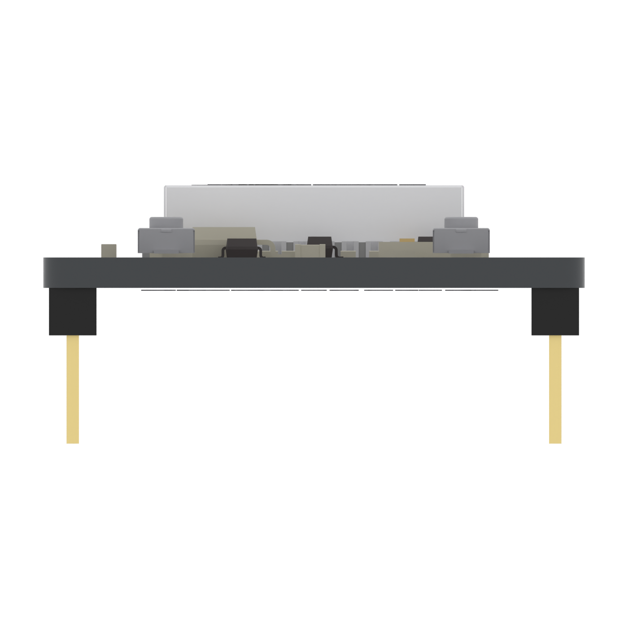
case/FINAL_TA/_render/komponen/esp32_front.png
