fathurraihan18/TA/case/FINAL_TA/_render/komponen/esp32_top.png

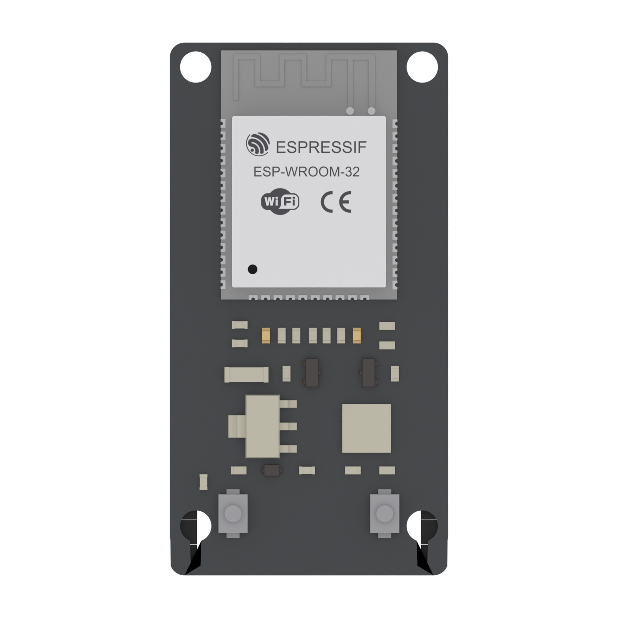
case/FINAL_TA/_render/komponen/esp32_top.png
