fathurraihan18/TA/case/FINAL_TA/_render/komponen/gland_front.png

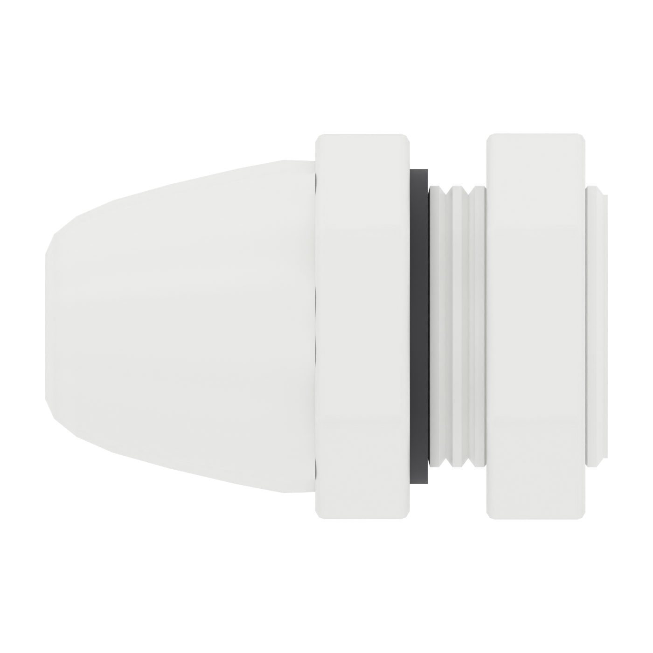
case/FINAL_TA/_render/komponen/gland_front.png
