fathurraihan18/TA/case/FINAL_TA/_render/komponen/gland_side.png

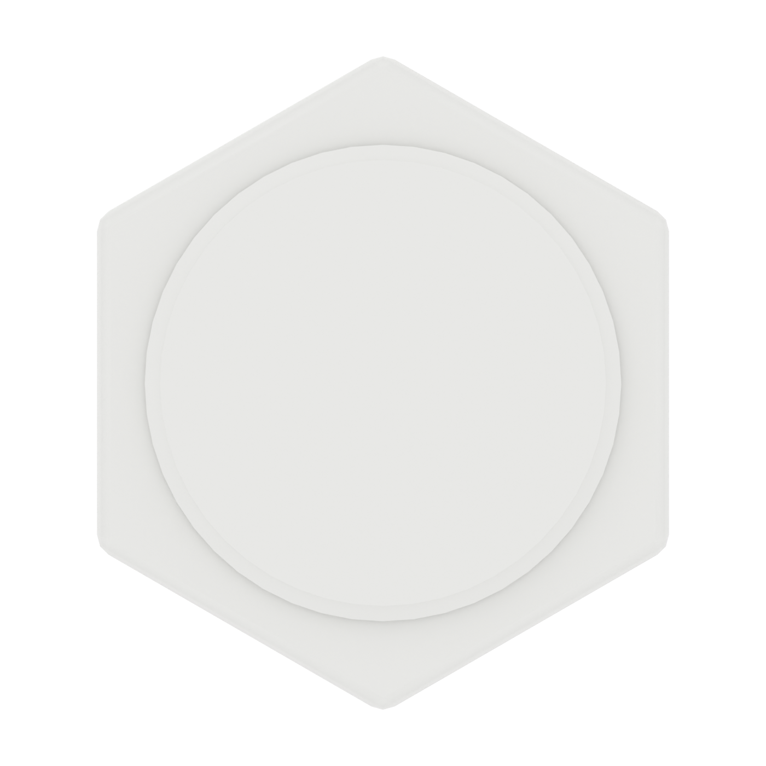
case/FINAL_TA/_render/komponen/gland_side.png
