fathurraihan18/TA/case/FINAL_TA/_render/komponen/hw605_top.png

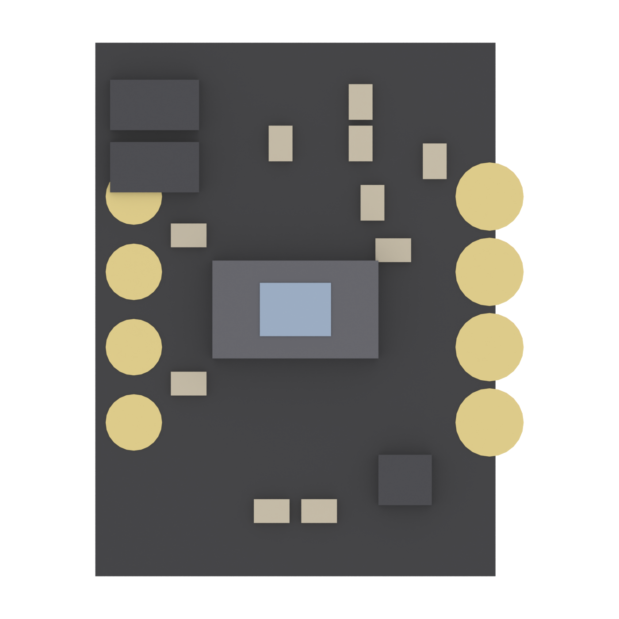
case/FINAL_TA/_render/komponen/hw605_top.png
