fathurraihan18/TA/case/FINAL_TA/_render/komponen/pcb_front.png

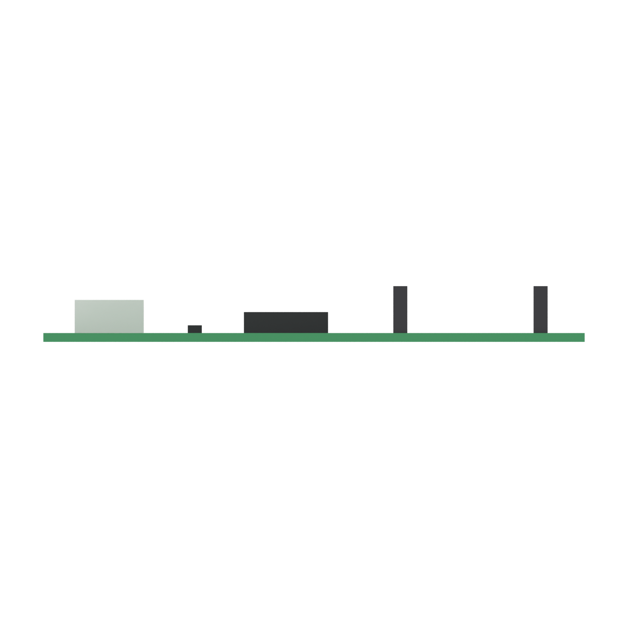
case/FINAL_TA/_render/komponen/pcb_front.png
