fathurraihan18/TA/case/FINAL_TA/_render/komponen/pcb_top.png

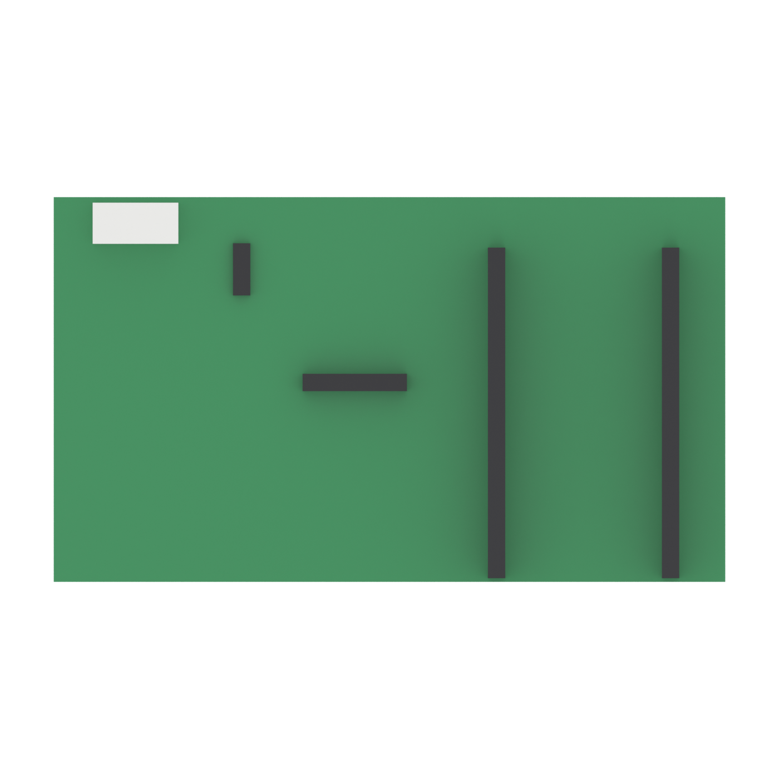
case/FINAL_TA/_render/komponen/pcb_top.png
