fathurraihan18/TA/case/FINAL_TA/_render/komponen/powerbank_front.png

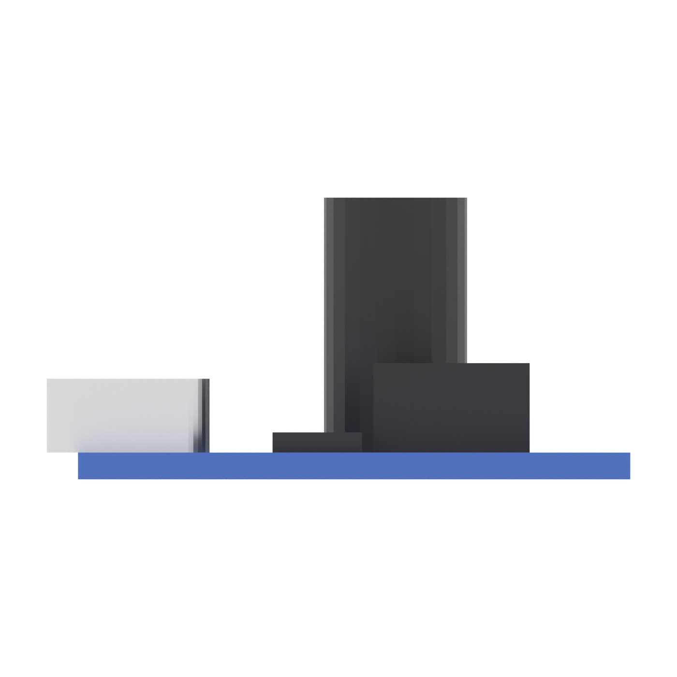
case/FINAL_TA/_render/komponen/powerbank_front.png
