fathurraihan18/TA/case/FINAL_TA/_render/komponen/saklar_front.png

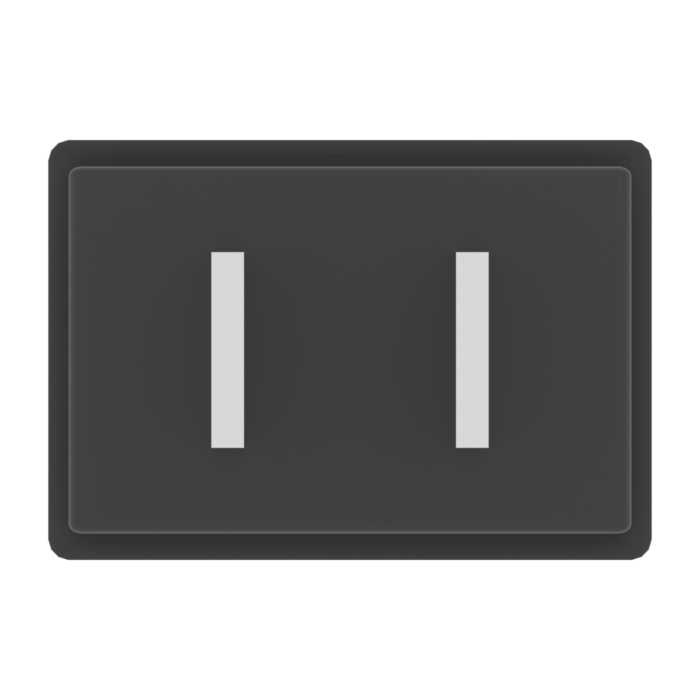
case/FINAL_TA/_render/komponen/saklar_front.png
