fathurraihan18/TA/case/FINAL_TA/_render/komponen/saklar_side.png

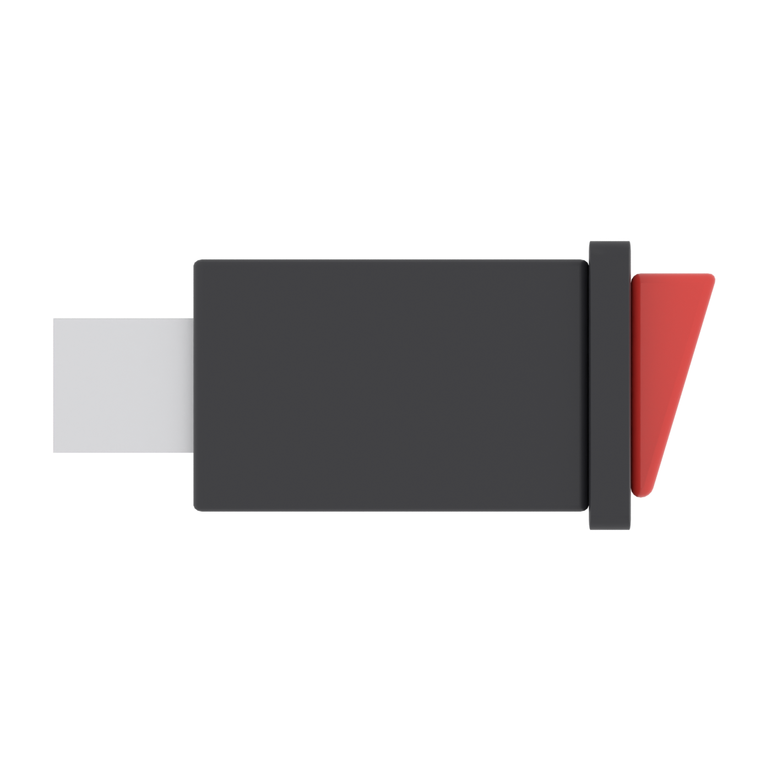
case/FINAL_TA/_render/komponen/saklar_side.png
