fathurraihan18/TA/case/FINAL_TA/_render/komponen/saklar_top.png

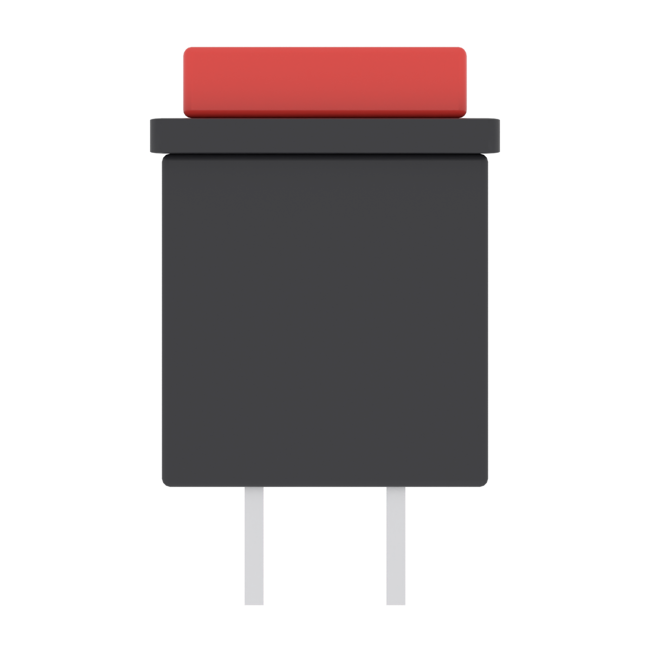
case/FINAL_TA/_render/komponen/saklar_top.png
