fathurraihan18/TA/case/FINAL_TA/_render/komponen/tft_front.png

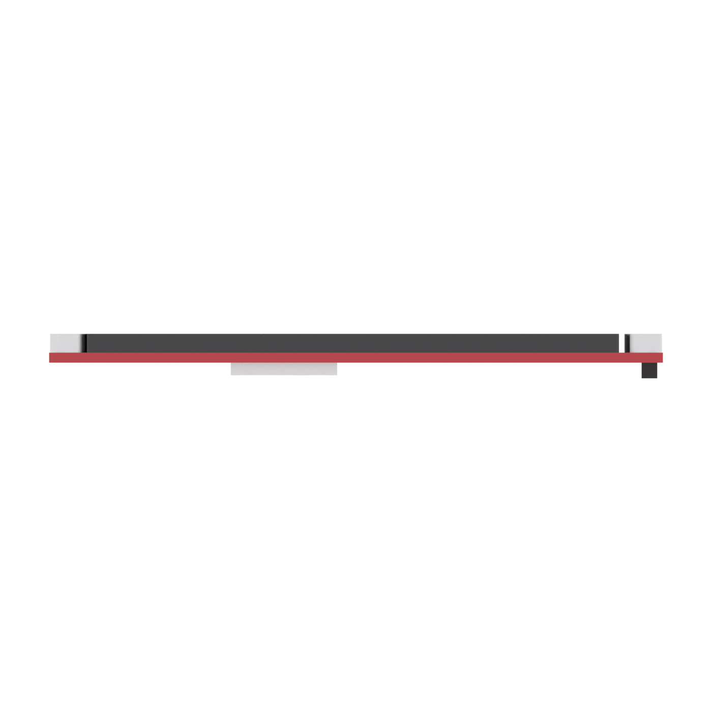
case/FINAL_TA/_render/komponen/tft_front.png
