fathurraihan18/TA/case/FINAL_TA/_render/komponen/tft_top.png

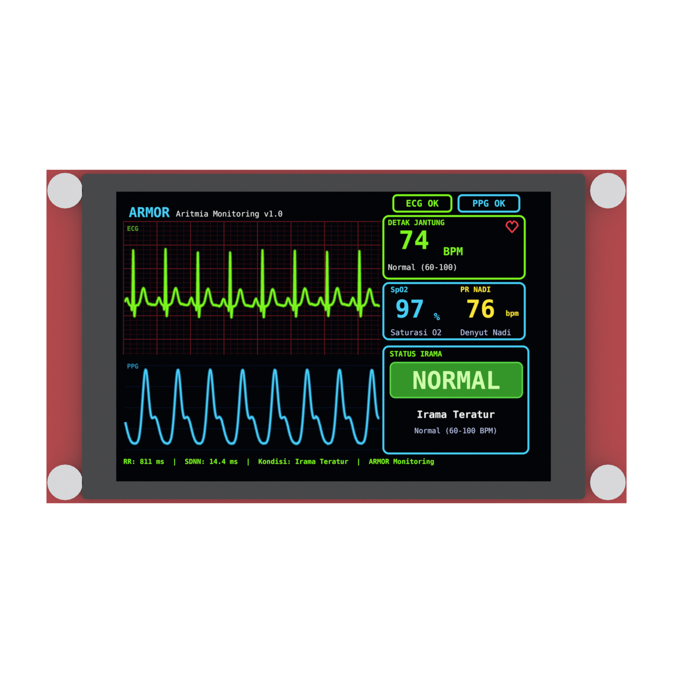
case/FINAL_TA/_render/komponen/tft_top.png
