fathurraihan18/TA/case/FINAL_TA/_render/manusia/manusia_full.png

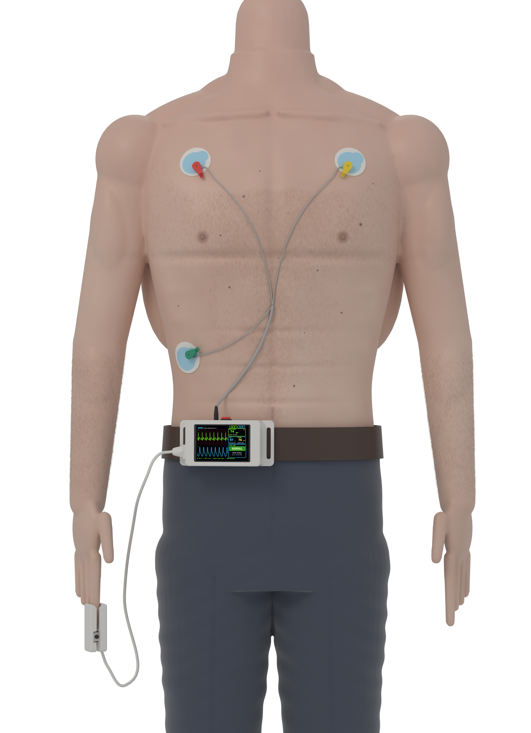
case/FINAL_TA/_render/manusia/manusia_full.png
