fathurraihan18/TA/case/gambar_teknik/Gambar_Teknik_Hal2_A3.png

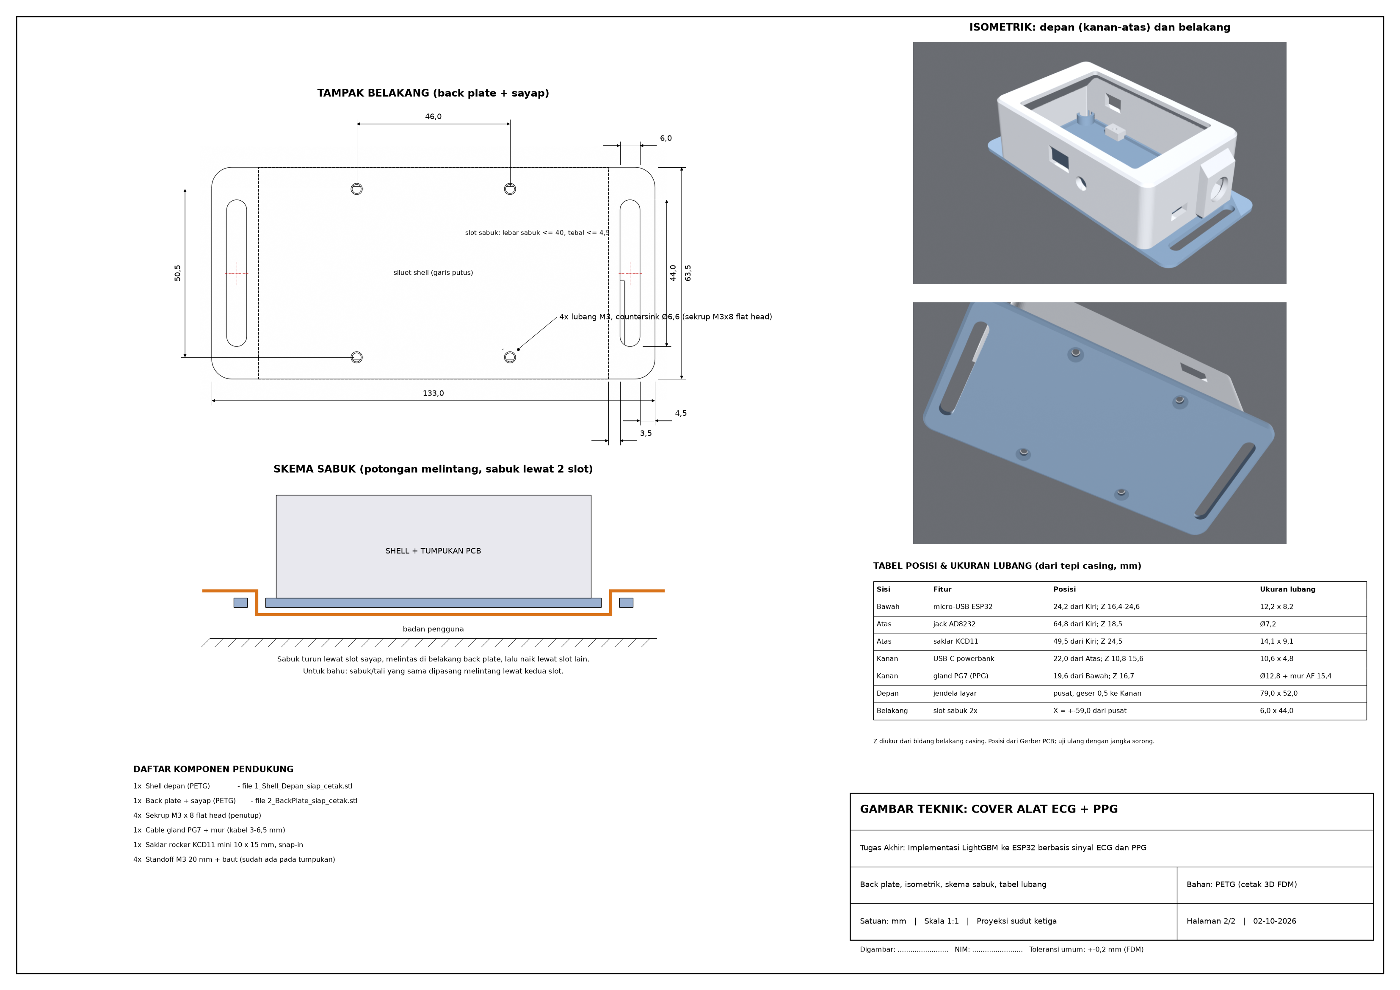
case/gambar_teknik/Gambar_Teknik_Hal2_A3.png
