fathurraihan18/TA/case/perakitan/Gambar_Perakitan_Hal1_Eksplode_A3.png

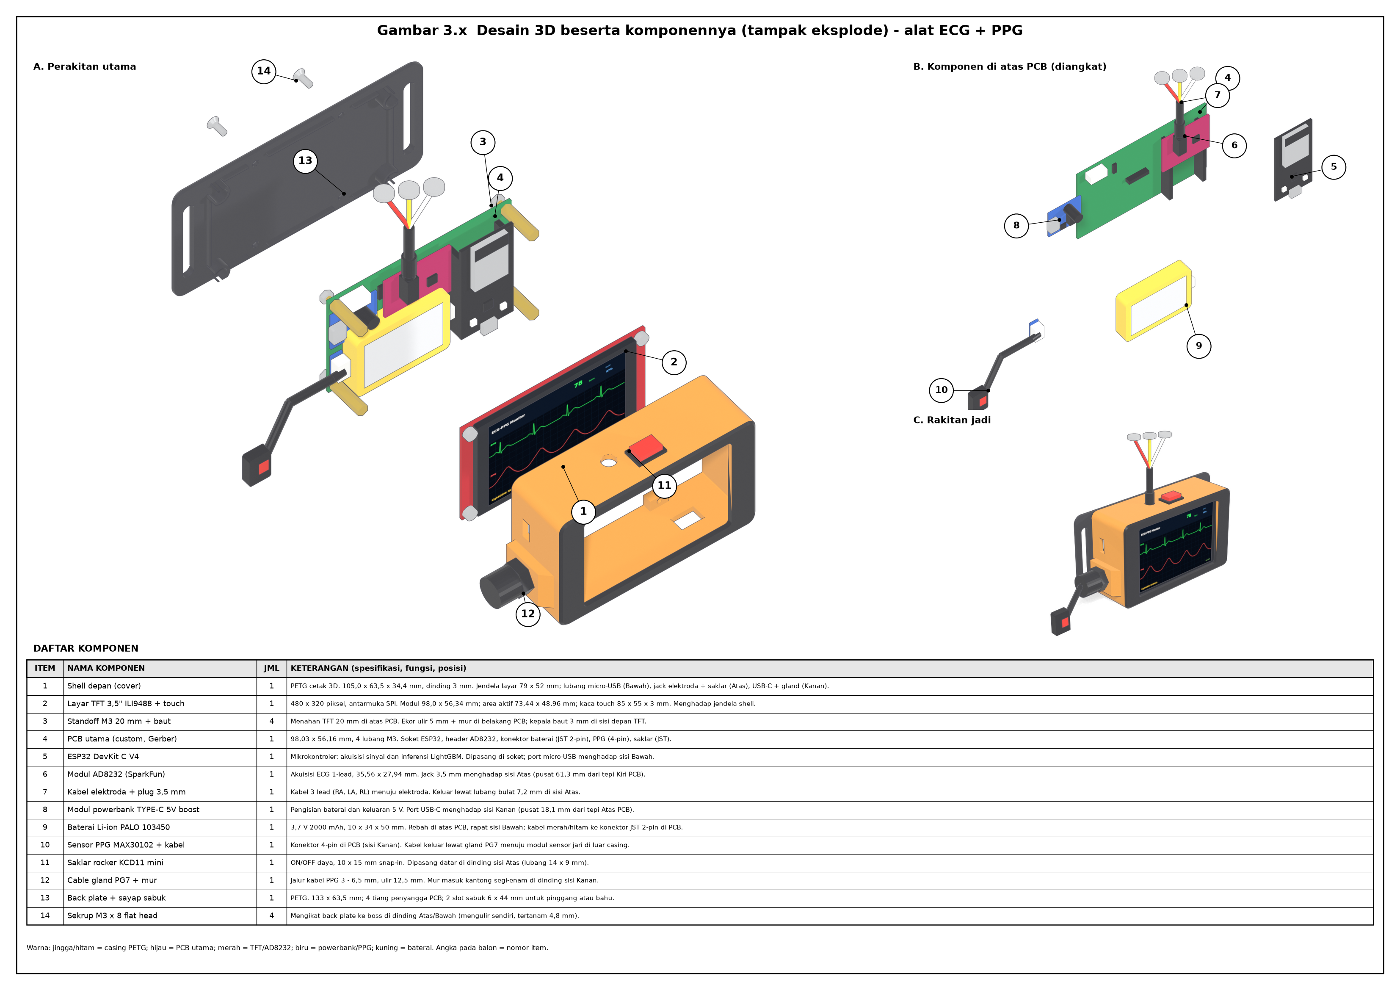
case/perakitan/Gambar_Perakitan_Hal1_Eksplode_A3.png
