fathurraihan18/TA/case/perakitan/Gambar_Perakitan_Hal2_Penempatan_A3.png

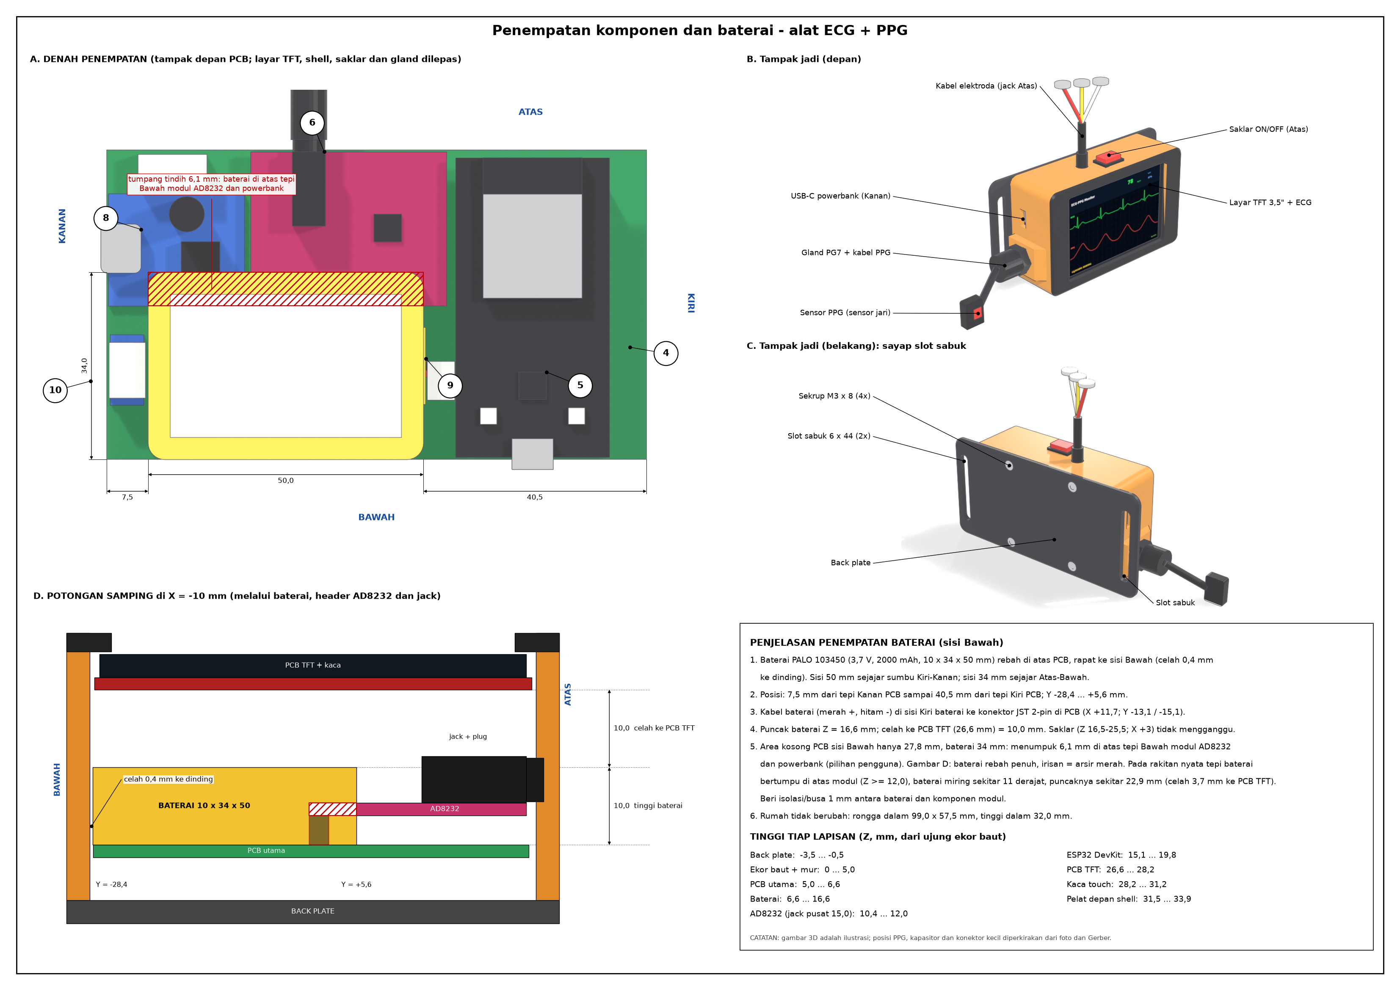
case/perakitan/Gambar_Perakitan_Hal2_Penempatan_A3.png
