fathurraihan18/TA/case/perakitan/layar_ecg.png

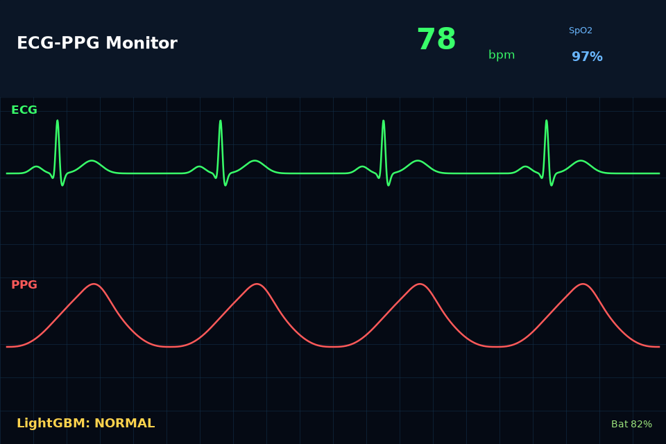
case/perakitan/layar_ecg.png
