fathurraihan18/TA/case/sensor_ppg/klip_v2/preview/klip_iso.png

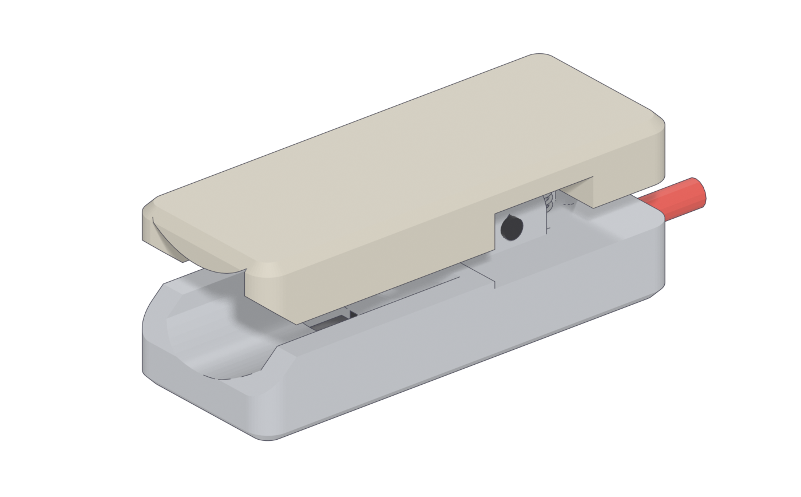
case/sensor_ppg/klip_v2/preview/klip_iso.png
