fathurraihan18/TA/case/sensor_ppg/klip_v2/preview/potongan_theta_0.png

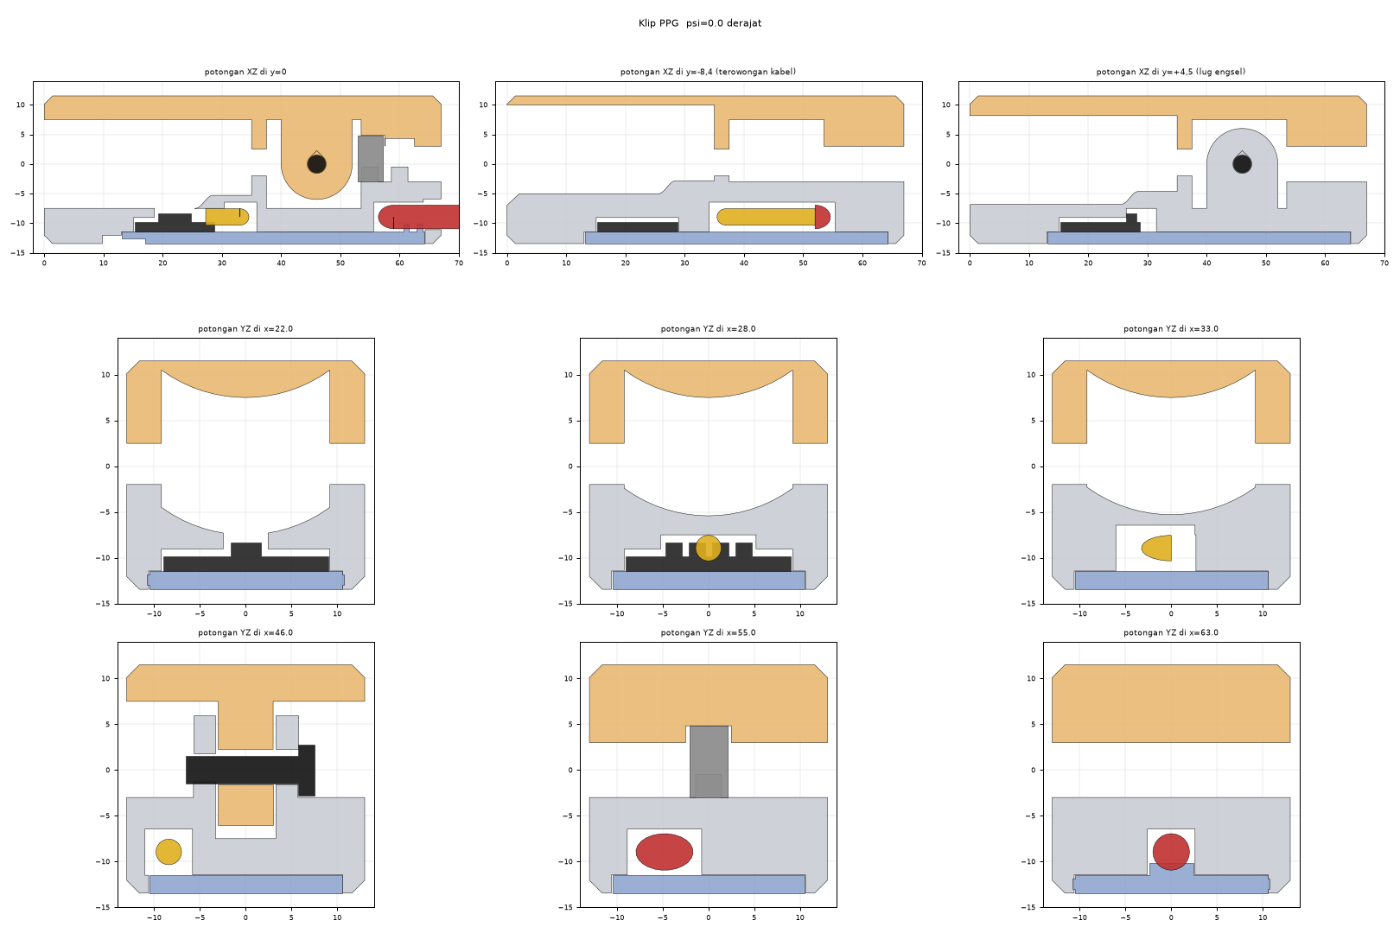
case/sensor_ppg/klip_v2/preview/potongan_theta_0.png
