fathurraihan18/TA/case/v2b_sekrup_samping/perbaikan_v2_tercetak/pratinjau_jig.png

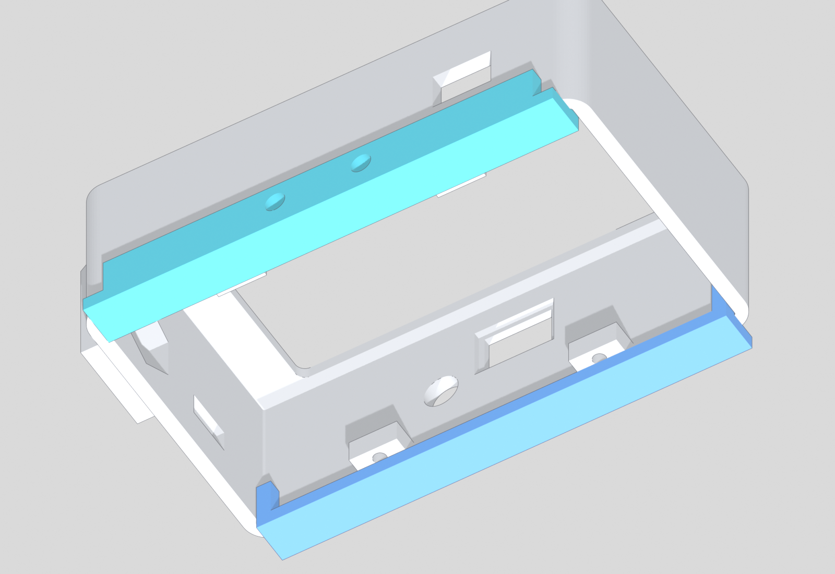
case/v2b_sekrup_samping/perbaikan_v2_tercetak/pratinjau_jig.png
