fathurraihan18/TA/case/v2b_sekrup_samping/preview/1_depan_kanan_atas.png

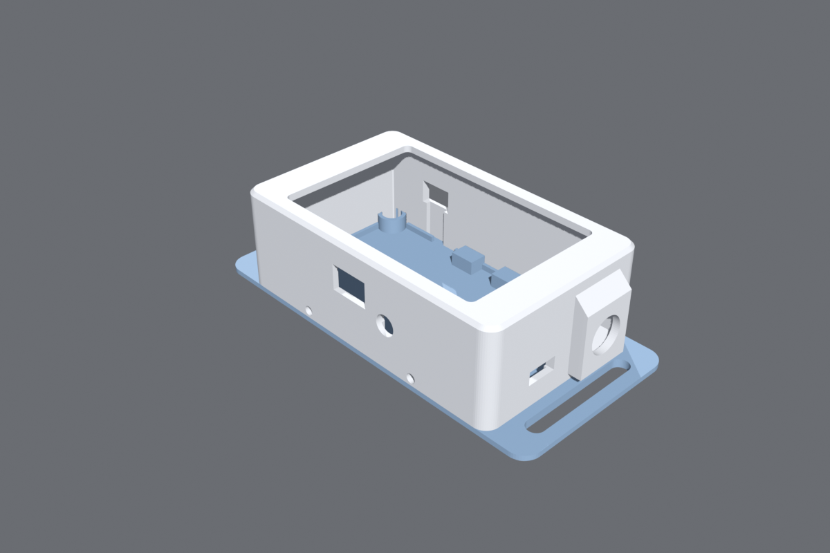
case/v2b_sekrup_samping/preview/1_depan_kanan_atas.png
