fathurraihan18/TA/case/v2b_sekrup_samping/preview/2_depan_kiri_bawah.png

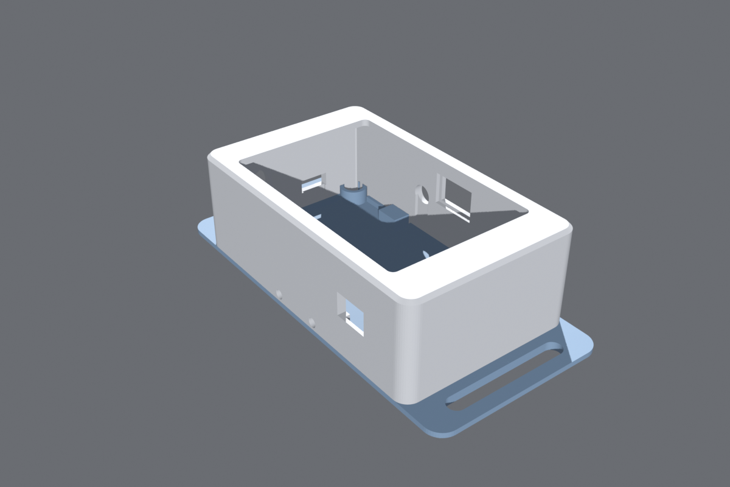
case/v2b_sekrup_samping/preview/2_depan_kiri_bawah.png
