fathurraihan18/TA/case/v2b_sekrup_samping/preview/3b_depan_lurus.png

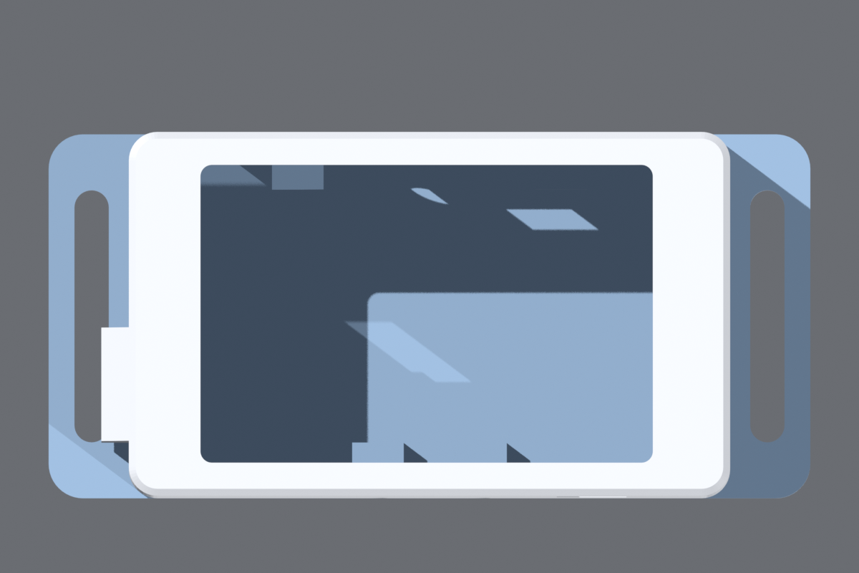
case/v2b_sekrup_samping/preview/3b_depan_lurus.png
