fathurraihan18/TA/case/v2b_sekrup_samping/preview/5_potongan_gland_PG7.png

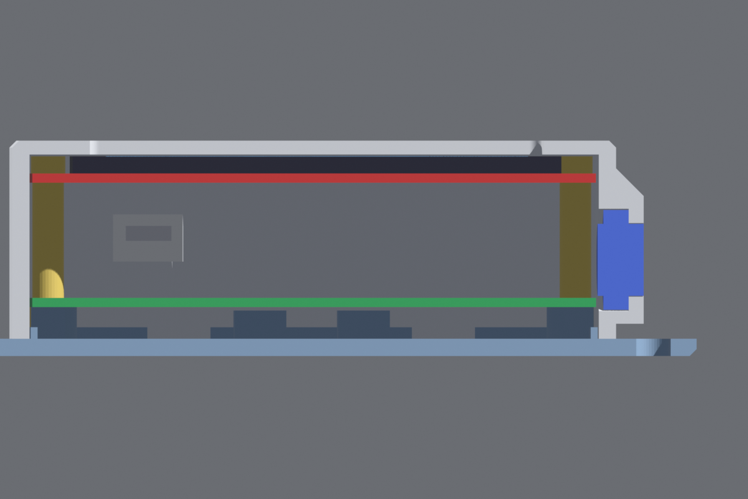
case/v2b_sekrup_samping/preview/5_potongan_gland_PG7.png
