fathurraihan18/TA/case/v2b_sekrup_samping/preview/6_potongan_microUSB_bawah.png

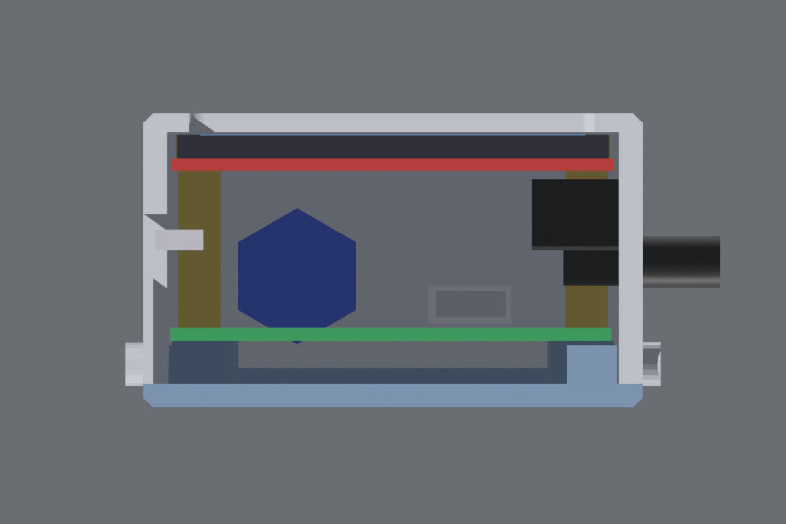
case/v2b_sekrup_samping/preview/6_potongan_microUSB_bawah.png
