fathurraihan18/TA/case/v2d_penahan_strip/Gambar_Logika_Penahan.png

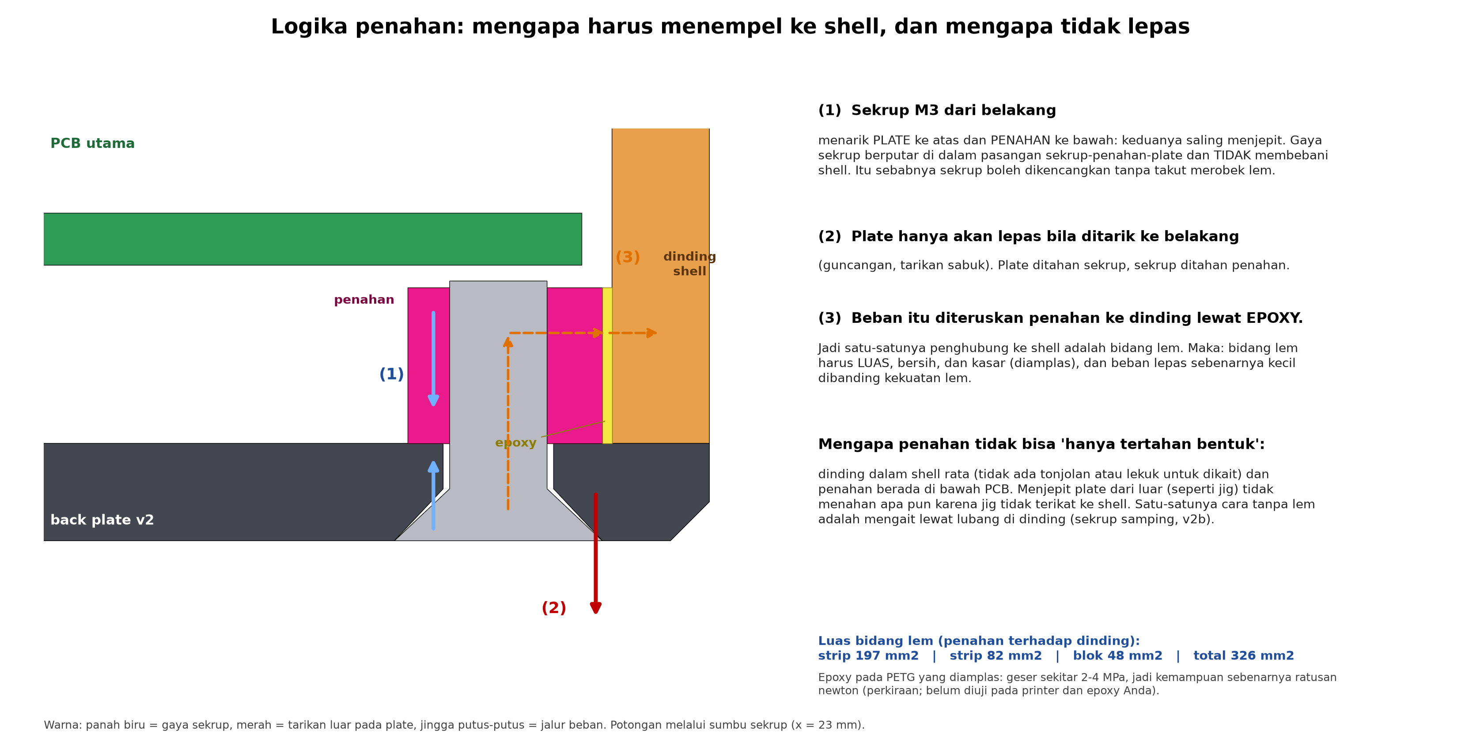
case/v2d_penahan_strip/Gambar_Logika_Penahan.png
