fathurraihan18/TA/case/v2d_penahan_strip/Gambar_Pemasangan_Penahan_A3.png

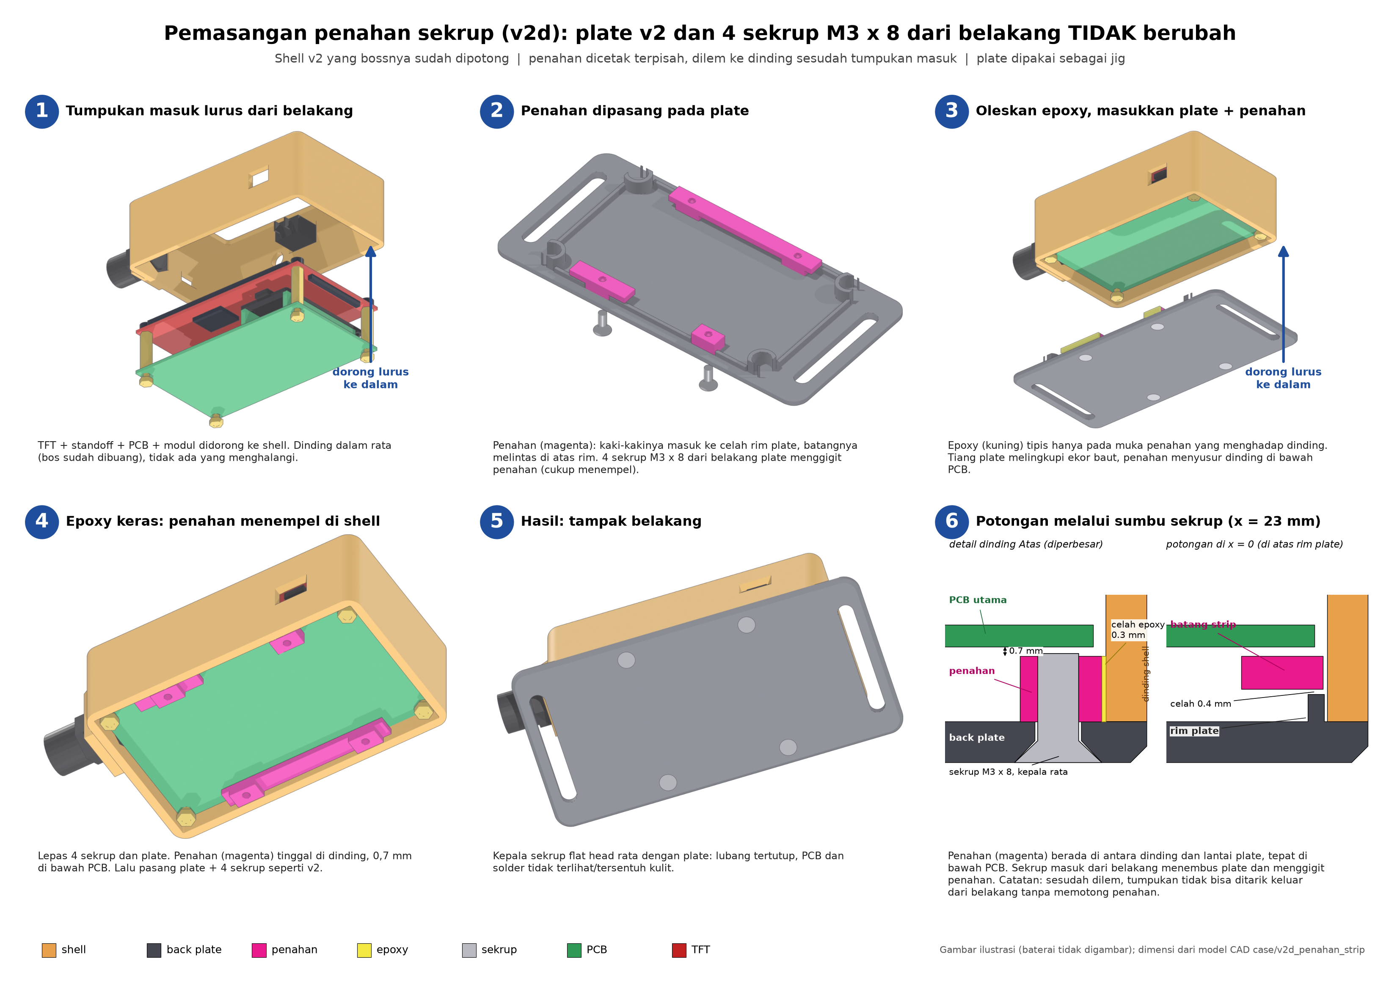
case/v2d_penahan_strip/Gambar_Pemasangan_Penahan_A3.png
