fathurraihan18/TA/case/v2d_penahan_strip/Peletakan_Penahan.png

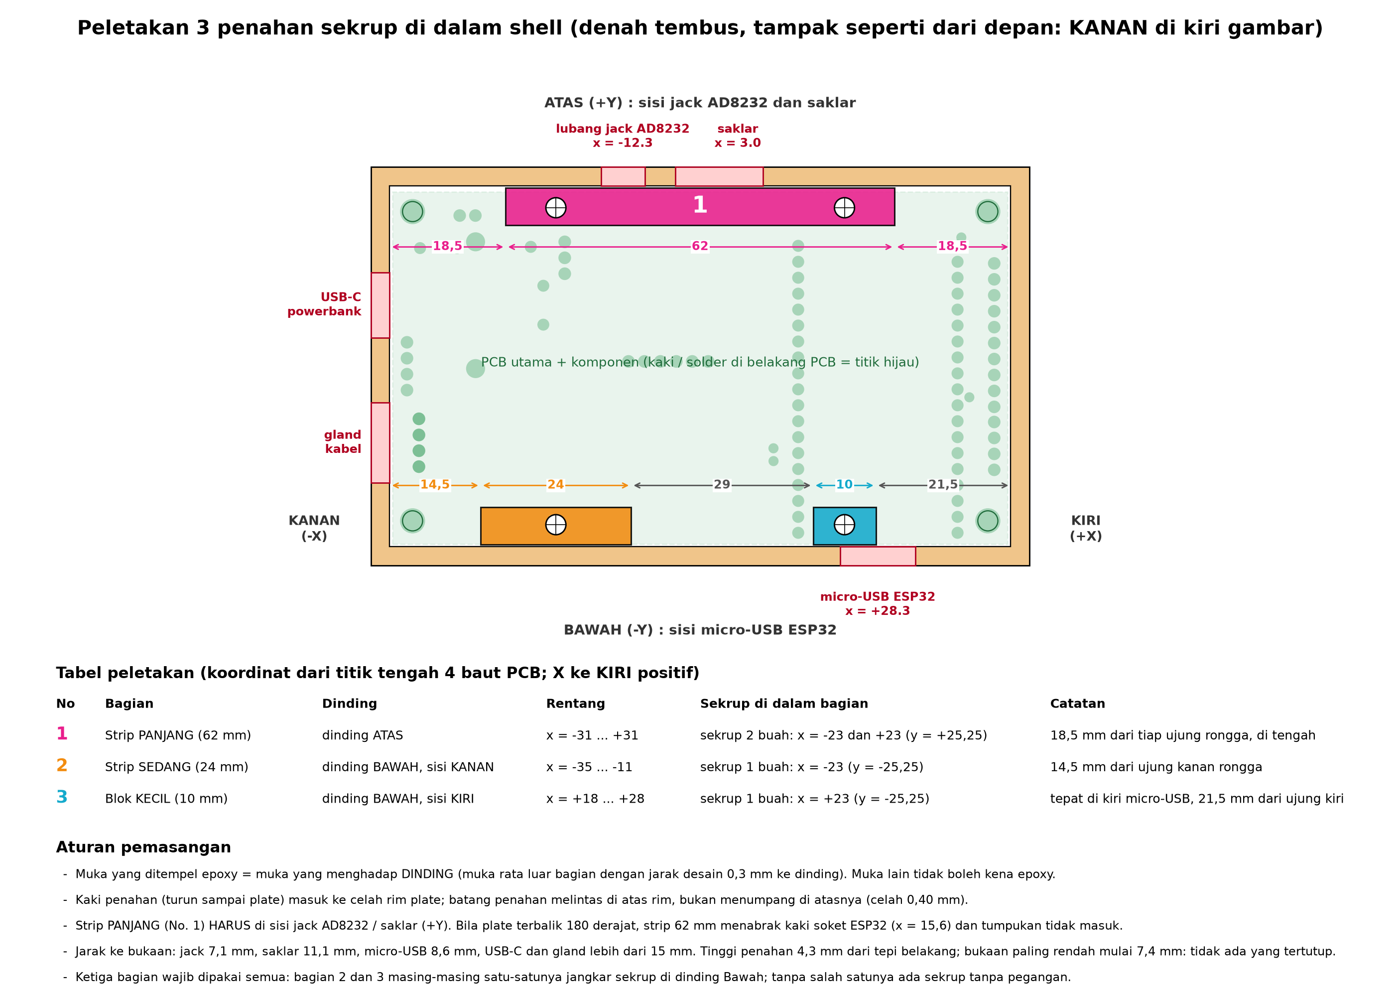
case/v2d_penahan_strip/Peletakan_Penahan.png
