fathurraihan18/TA/case/v2d_penahan_strip/Peletakan_Penahan_3D.png

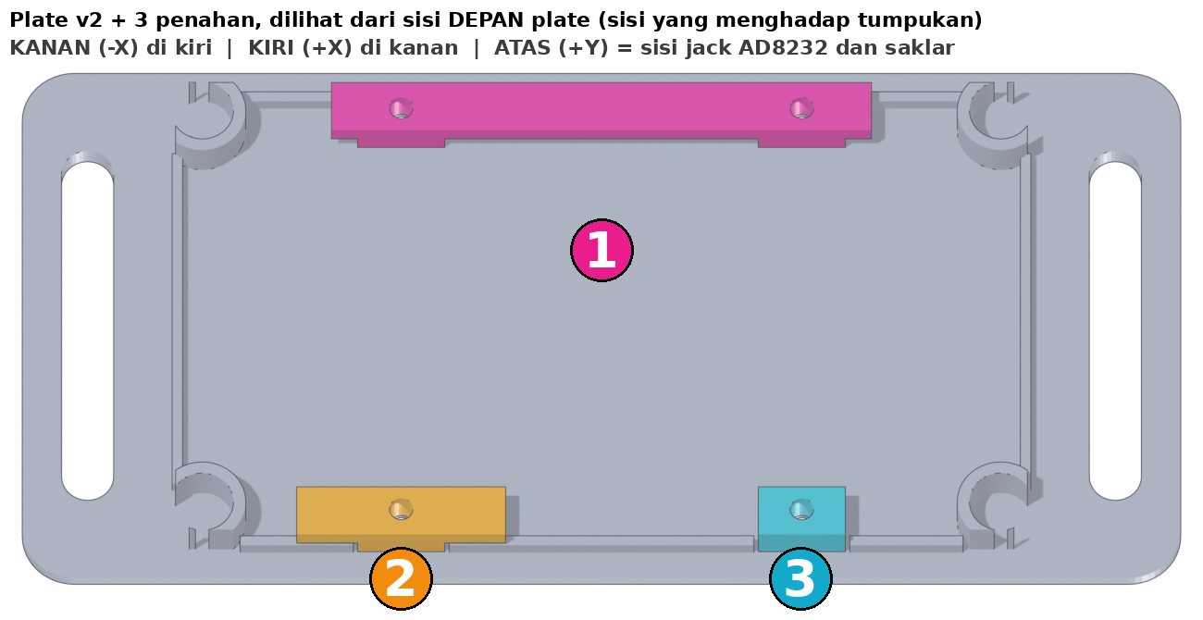
case/v2d_penahan_strip/Peletakan_Penahan_3D.png
