fathurraihan18/TA/case/v2d_penahan_strip/pratinjau_penahan_di_plate.png

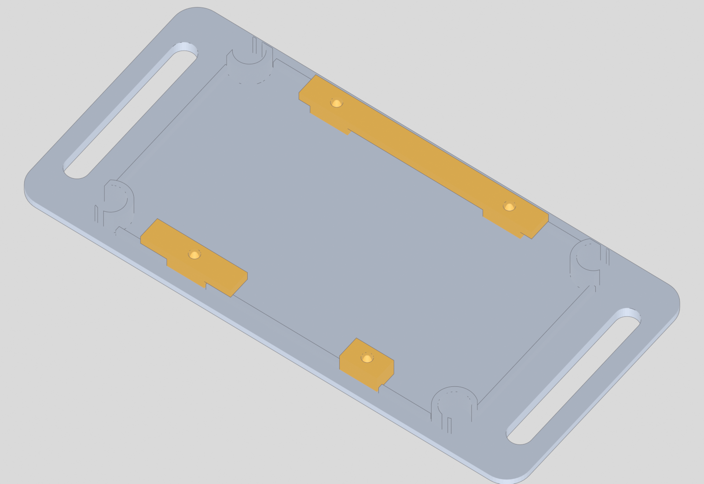
case/v2d_penahan_strip/pratinjau_penahan_di_plate.png
