fathurraihan18/TA/case/v2d_penahan_strip/pratinjau_penahan_di_shell.png

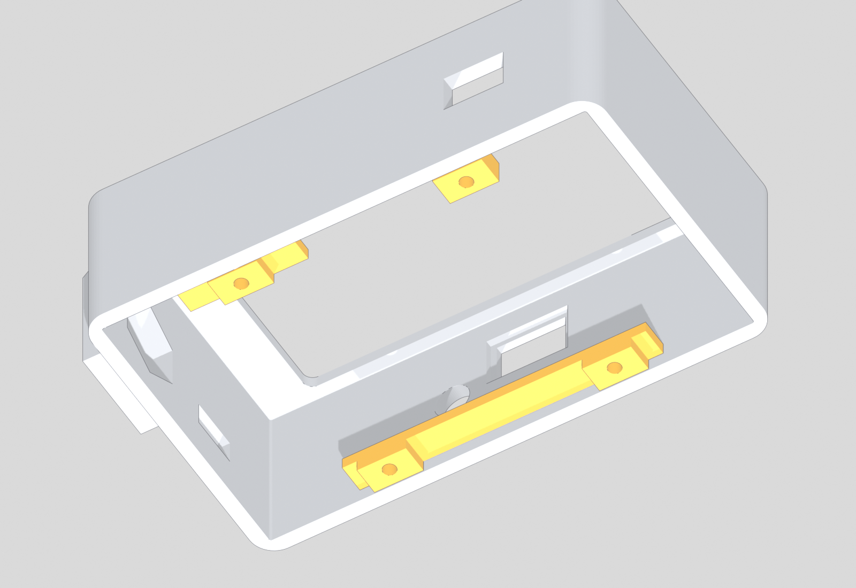
case/v2d_penahan_strip/pratinjau_penahan_di_shell.png
