fathurraihan18/TA/case/v2d_penahan_strip/render/hasil_belakang.png

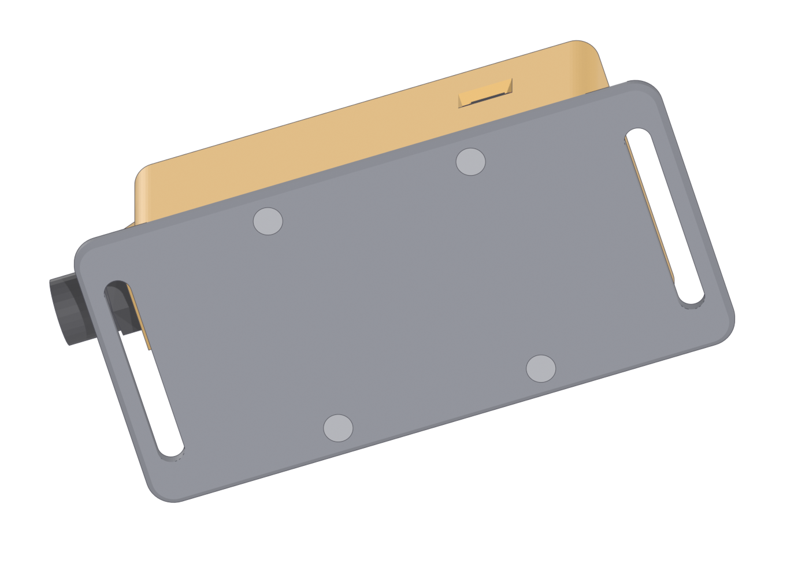
case/v2d_penahan_strip/render/hasil_belakang.png
