fathurraihan18/TA/case/v2d_penahan_strip/render/hasil_dalam.png

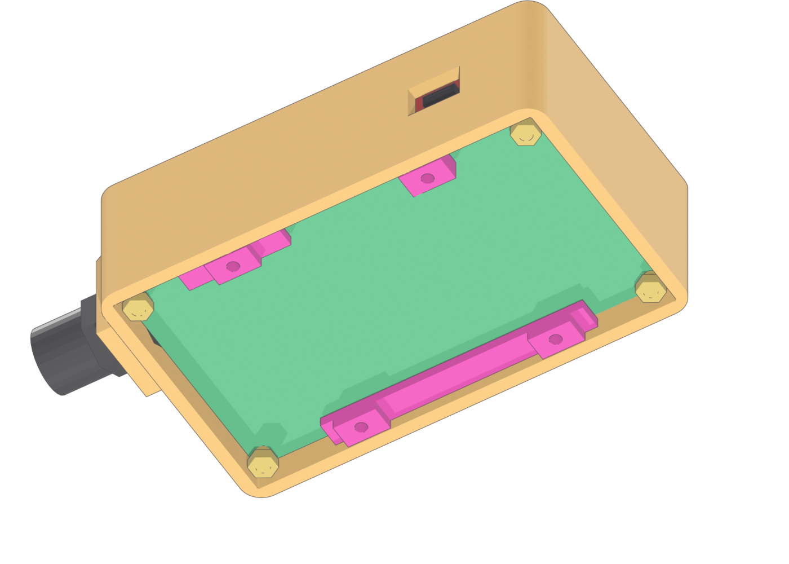
case/v2d_penahan_strip/render/hasil_dalam.png
