fathurraihan18/TA/case/v2d_penahan_strip/render/langkah1.png

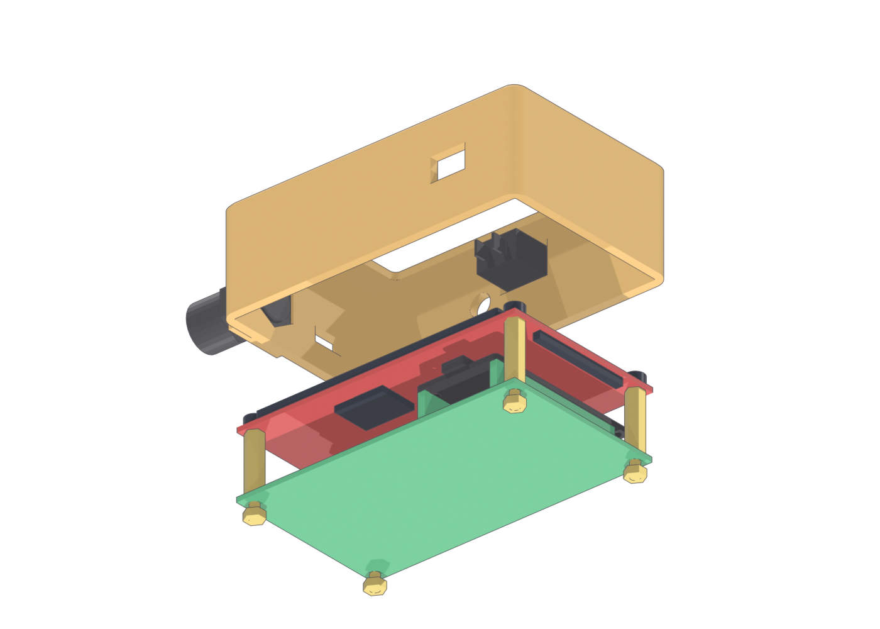
case/v2d_penahan_strip/render/langkah1.png
