fathurraihan18/TA/case/v2d_penahan_strip/render/langkah2.png

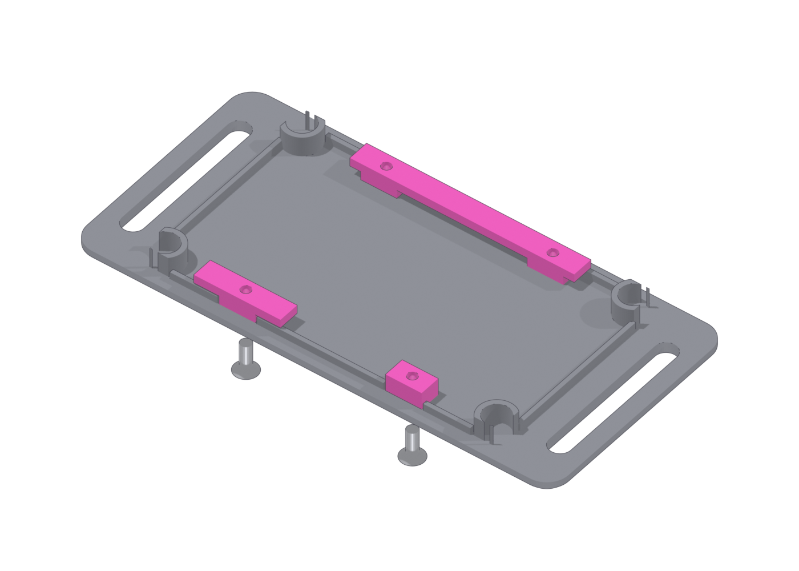
case/v2d_penahan_strip/render/langkah2.png
