fathurraihan18/TA/case/v3_baterai/perakitan/Gambar_Perakitan_Hal1_Eksplode_A3.png

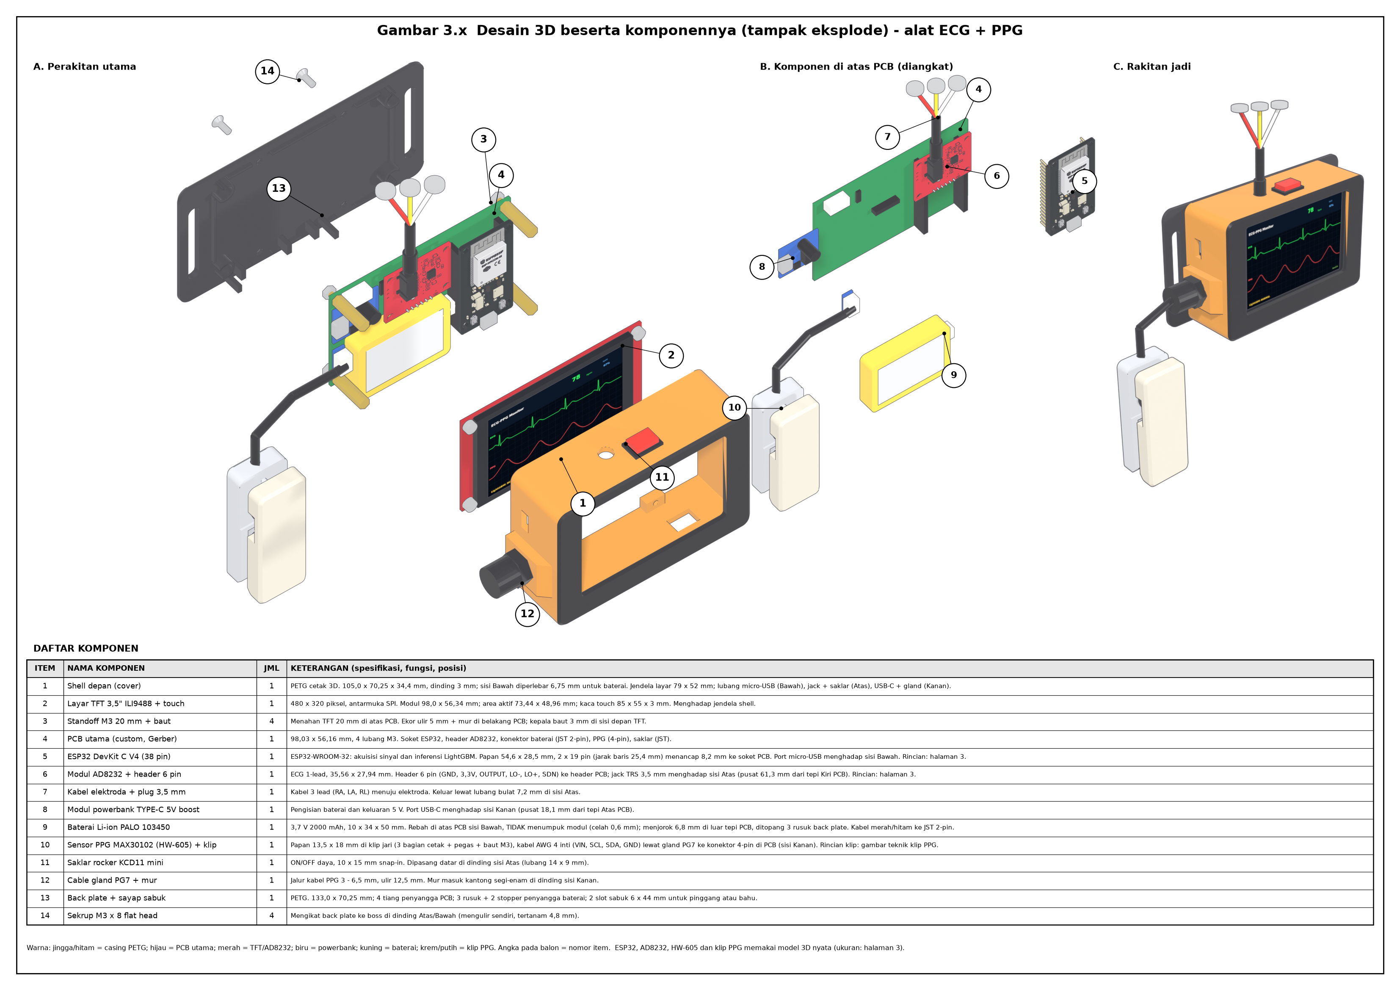
case/v3_baterai/perakitan/Gambar_Perakitan_Hal1_Eksplode_A3.png
