fathurraihan18/TA/case/v3_baterai/perakitan/Gambar_Perakitan_Hal2_Penempatan_A3.png

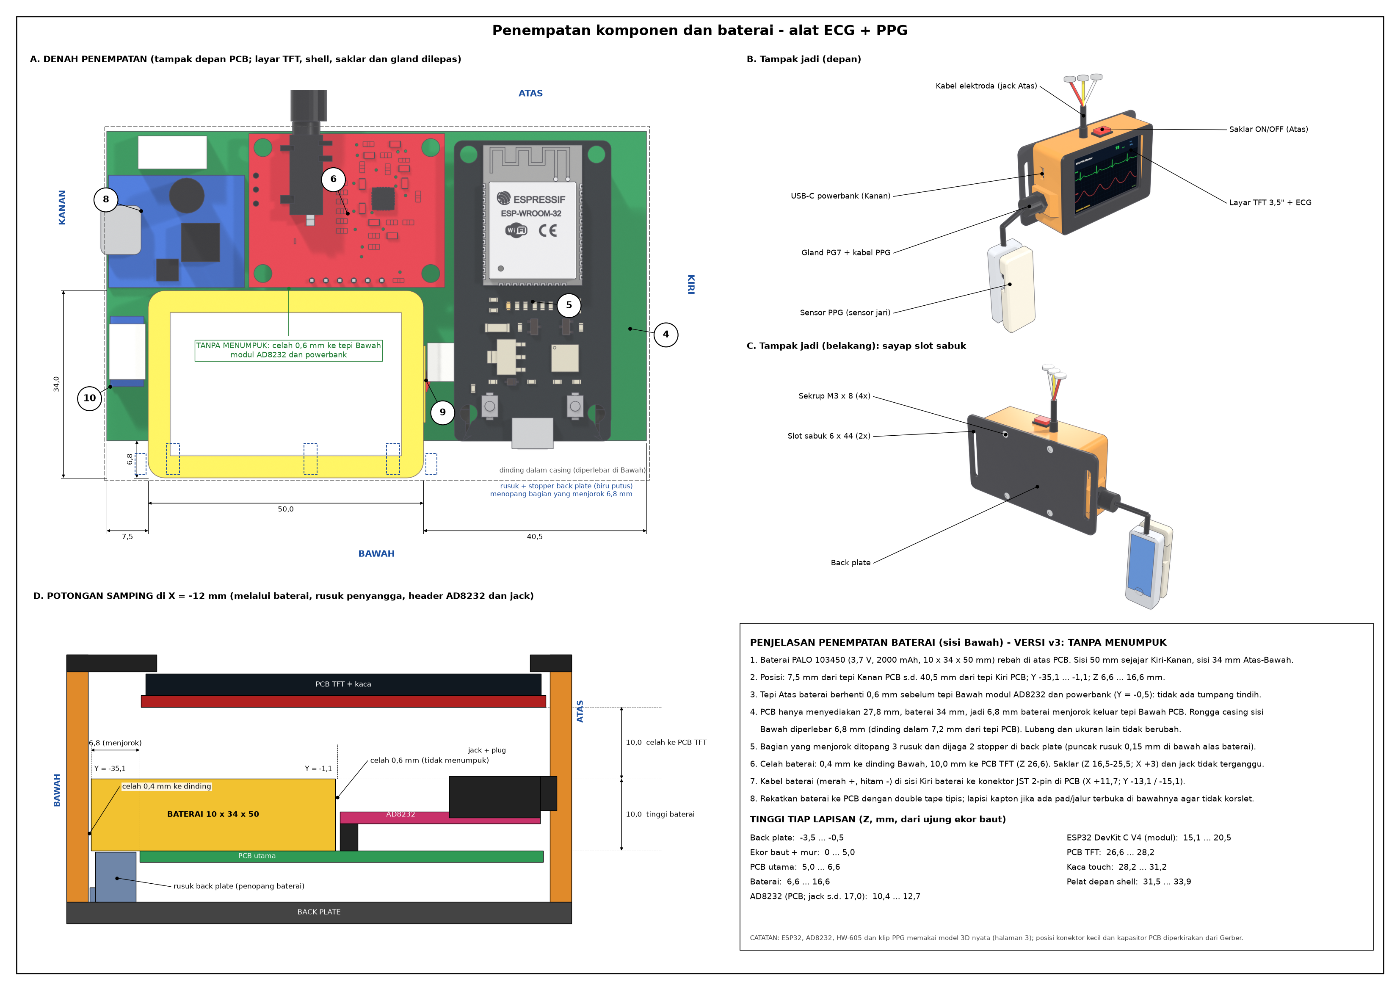
case/v3_baterai/perakitan/Gambar_Perakitan_Hal2_Penempatan_A3.png
