fathurraihan18/TA/case/v3_baterai/perakitan/Gambar_Perakitan_Hal3_Komponen_A3.png

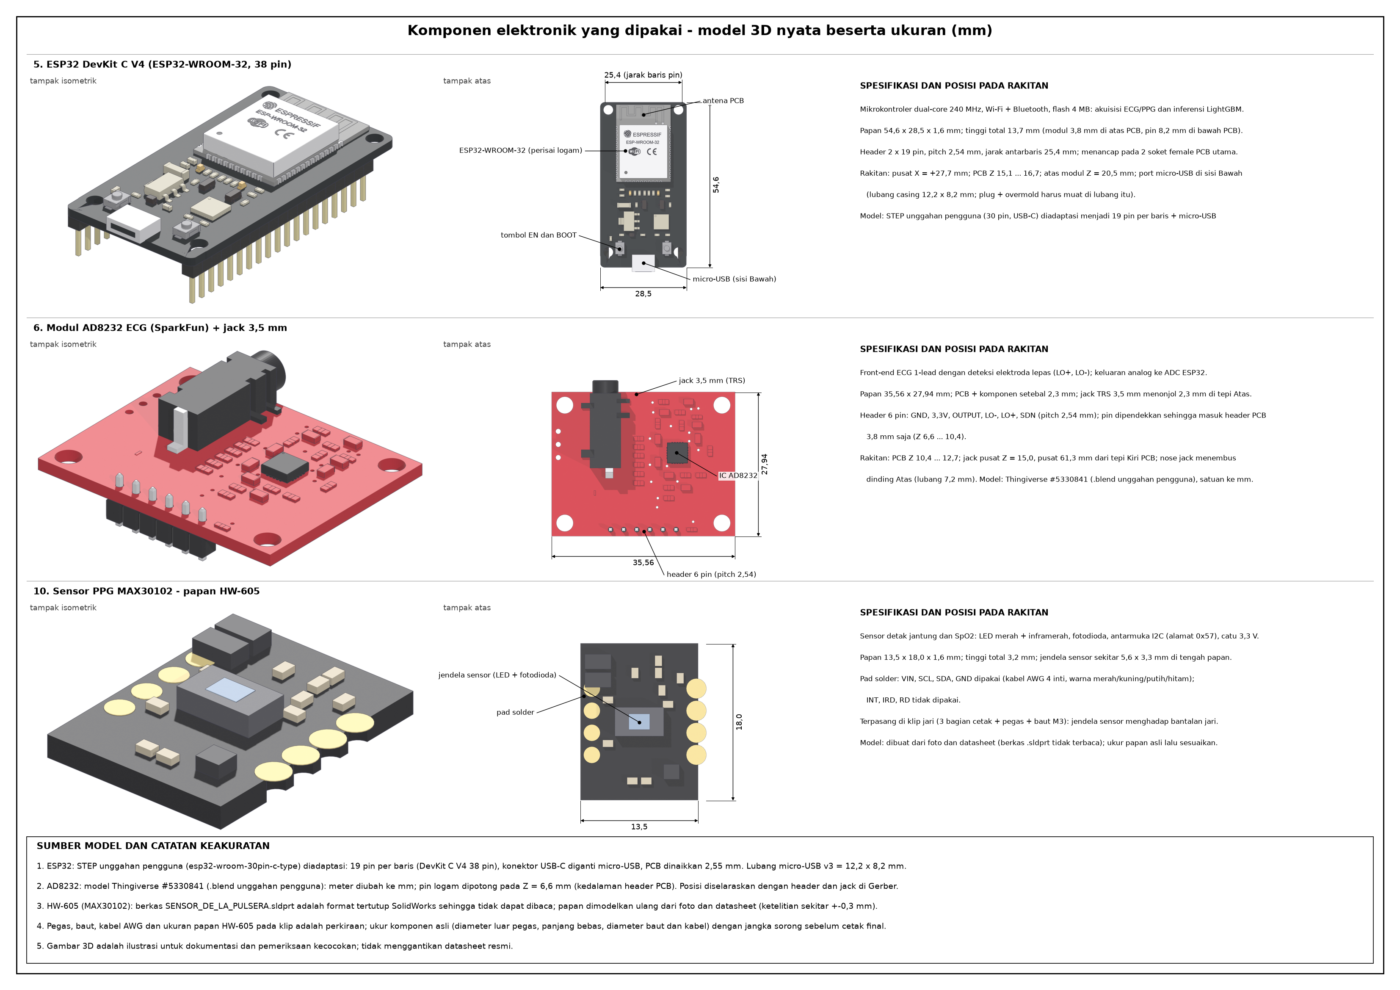
case/v3_baterai/perakitan/Gambar_Perakitan_Hal3_Komponen_A3.png
