fathurraihan18/TA/case/v3_baterai/perakitan/render/render_denah.png

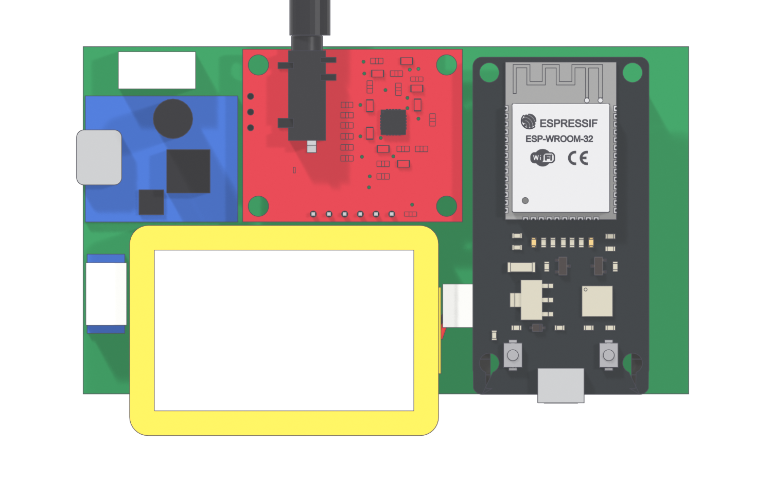
case/v3_baterai/perakitan/render/render_denah.png
