fathurraihan18/TA/case/v3_baterai/perakitan/render/render_eksplodeA.png

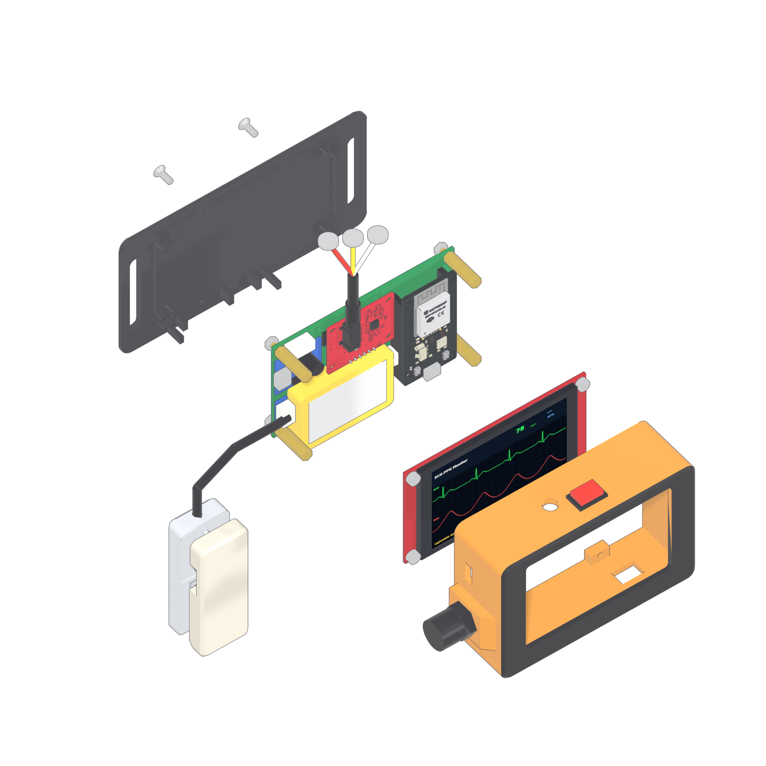
case/v3_baterai/perakitan/render/render_eksplodeA.png
