fathurraihan18/TA/case/v3_baterai/perakitan/render/render_eksplodeB.png

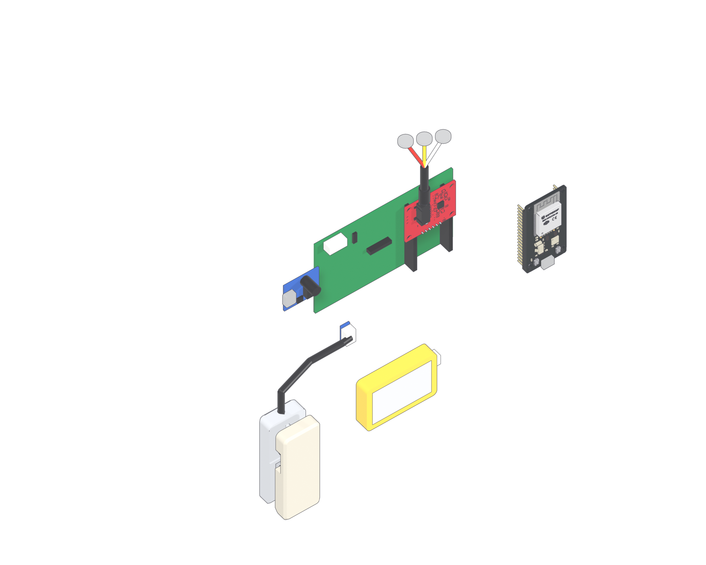
case/v3_baterai/perakitan/render/render_eksplodeB.png
