fathurraihan18/TA/case/v3_baterai/perakitan/render/render_rakitan_depan.png

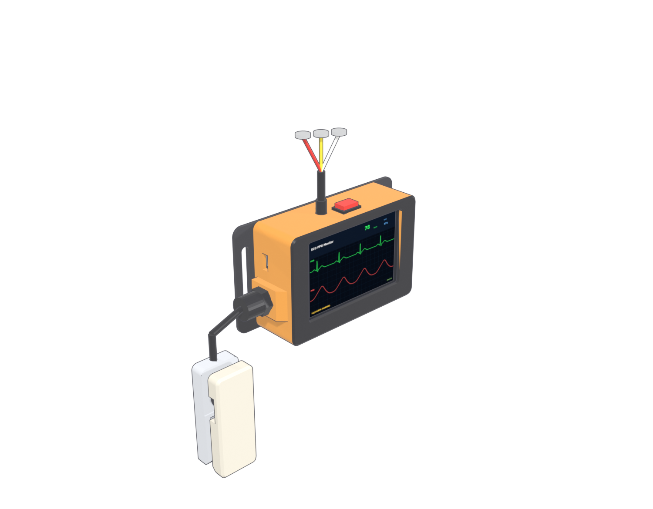
case/v3_baterai/perakitan/render/render_rakitan_depan.png
