fathurraihan18/TA/case/v3b_sekrup_samping/preview/3_belakang_sayap_sabuk.png

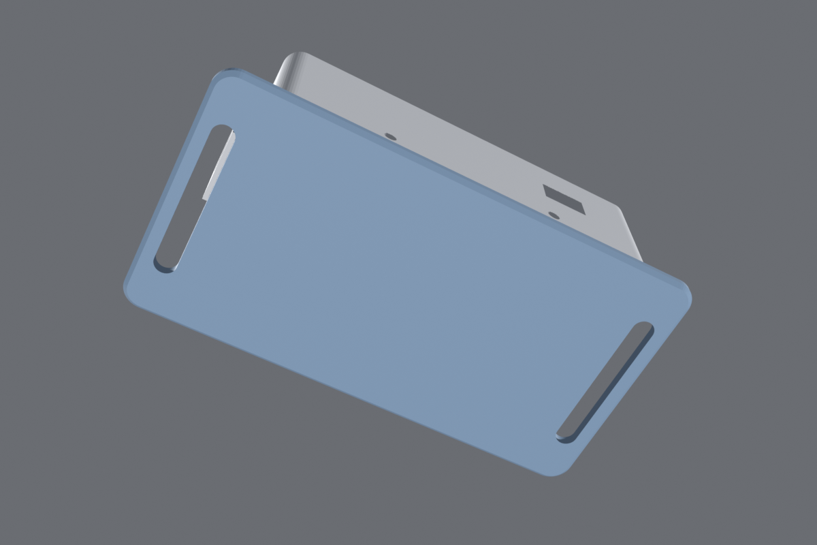
case/v3b_sekrup_samping/preview/3_belakang_sayap_sabuk.png
