fathurraihan18/TA/case/v3b_sekrup_samping/preview/3b_depan_lurus.png

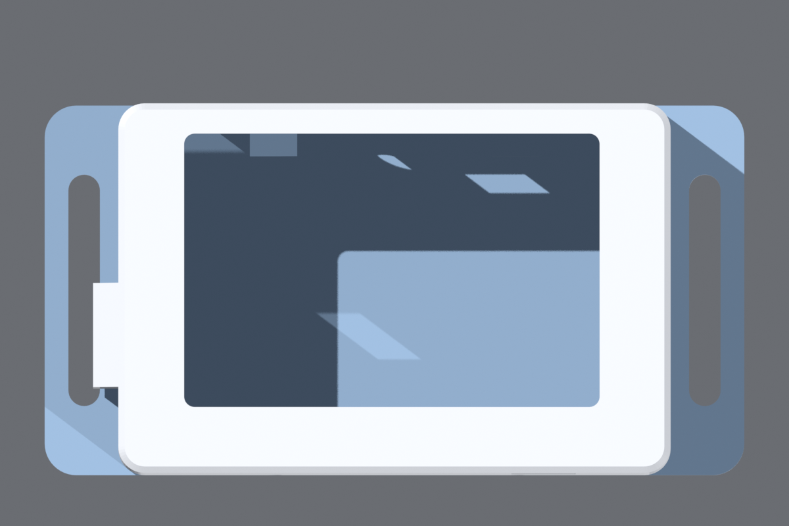
case/v3b_sekrup_samping/preview/3b_depan_lurus.png
