fathurraihan18/TA/case/v3b_sekrup_samping/preview/4_terbuka_dari_belakang_dgn_komponen.png

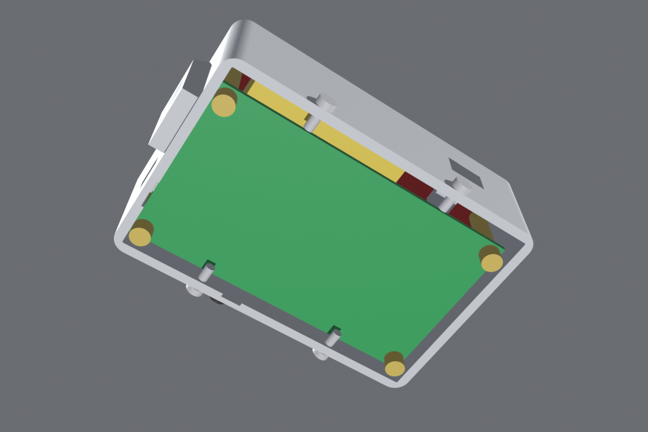
case/v3b_sekrup_samping/preview/4_terbuka_dari_belakang_dgn_komponen.png
