fathurraihan18/TA/case/v3b_sekrup_samping/preview/4b_penyangga_baterai_di_back_plate.png

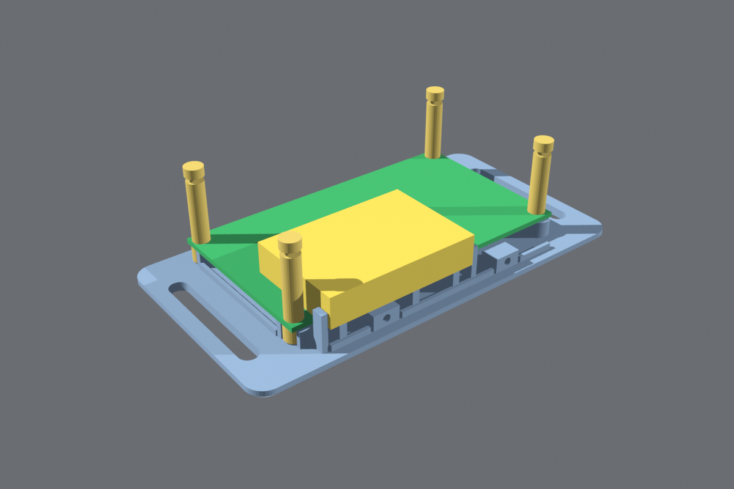
case/v3b_sekrup_samping/preview/4b_penyangga_baterai_di_back_plate.png
