fathurraihan18/TA/case/v3b_sekrup_samping/preview/5_potongan_gland_PG7.png

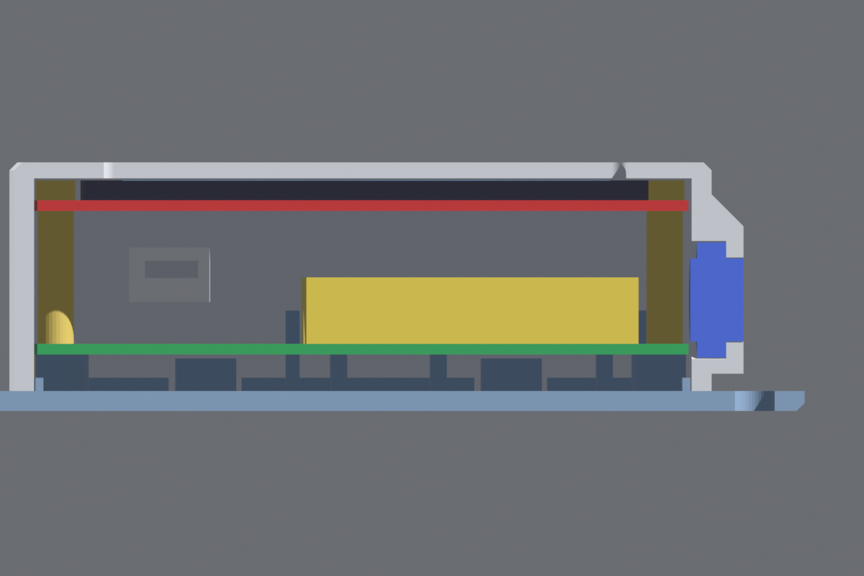
case/v3b_sekrup_samping/preview/5_potongan_gland_PG7.png
