fathurraihan18/TA/case/v3b_sekrup_samping/preview/6_potongan_microUSB_bawah.png

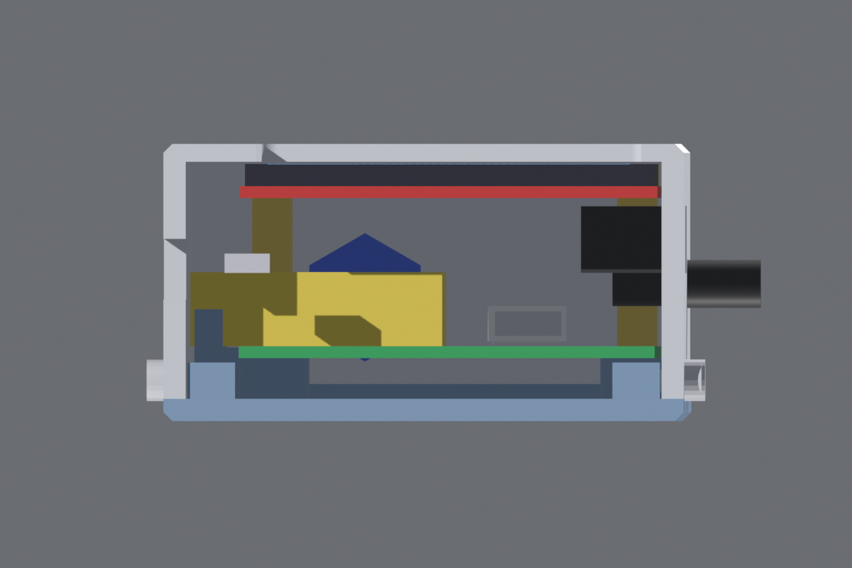
case/v3b_sekrup_samping/preview/6_potongan_microUSB_bawah.png
