fathurraihan18/TA/case/v3b_sekrup_samping/preview/7_potongan_saklar_atas.png

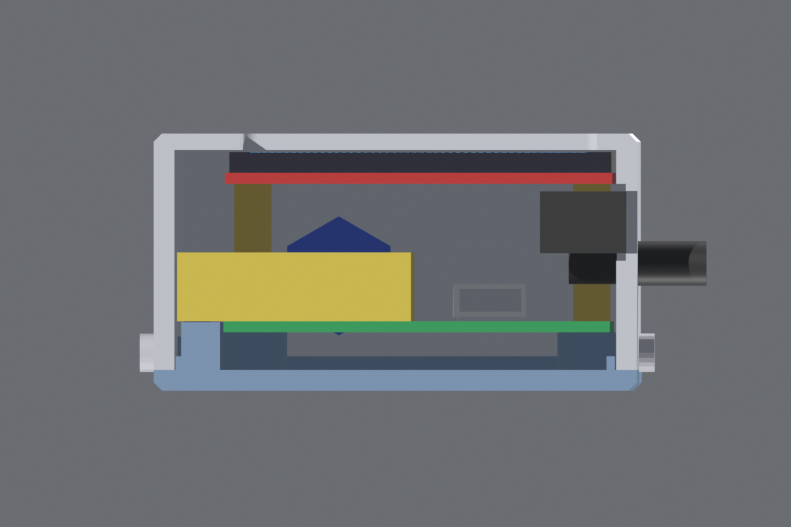
case/v3b_sekrup_samping/preview/7_potongan_saklar_atas.png
