fathurraihan18/TA/case/v3b_sekrup_samping/preview/9b_potongan_baterai_X-37.png

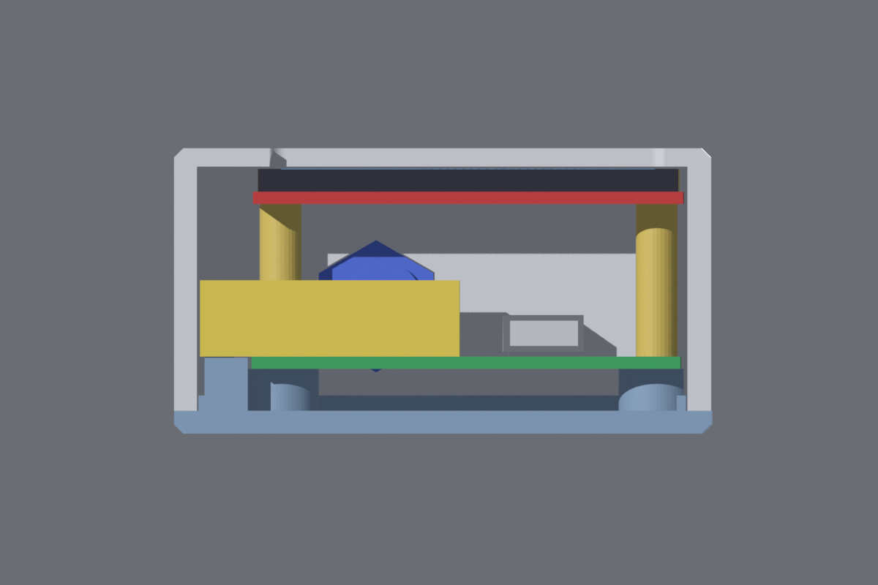
case/v3b_sekrup_samping/preview/9b_potongan_baterai_X-37.png
