fathurraihan18/TA/case/1_Shell_Depan_siap_cetak.stl

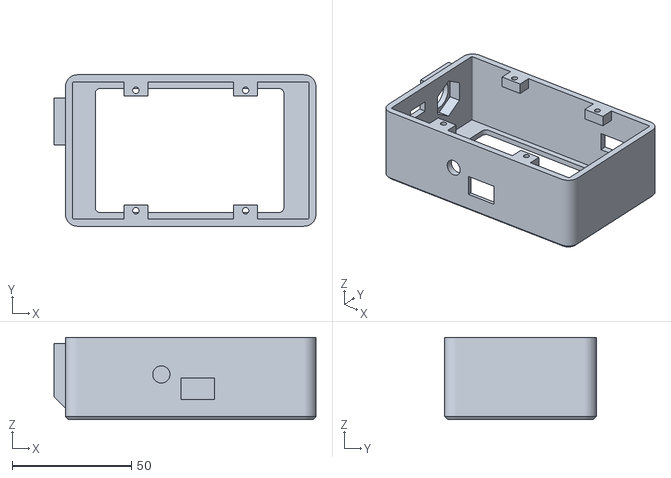
[picture p150: CAD file, 2026-10-02]
case/1_Shell_Depan_siap_cetak.stl
109.8 x 63.5 x 34.4
