fathurraihan18/TA/case/FINAL_TA/07_STL_siap_cetak/Casing_ECG_PPG/3_Penahan_Sekrup_siap_cetak.stl

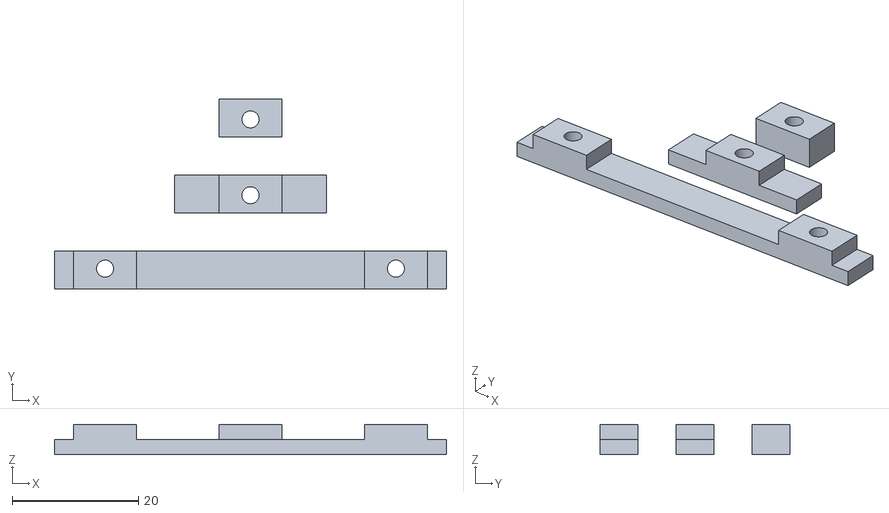
[picture p151: CAD file, 2026-10-05]
case/FINAL_TA/07_STL_siap_cetak/Casing_ECG_PPG/3_Penahan_Sekrup_siap_cetak.stl
62.0 x 30.0 x 4.80
