fathurraihan18/TA/case/FINAL_TA/07_STL_siap_cetak/Klip_PPG/B_RahangAtas_siap_cetak.stl

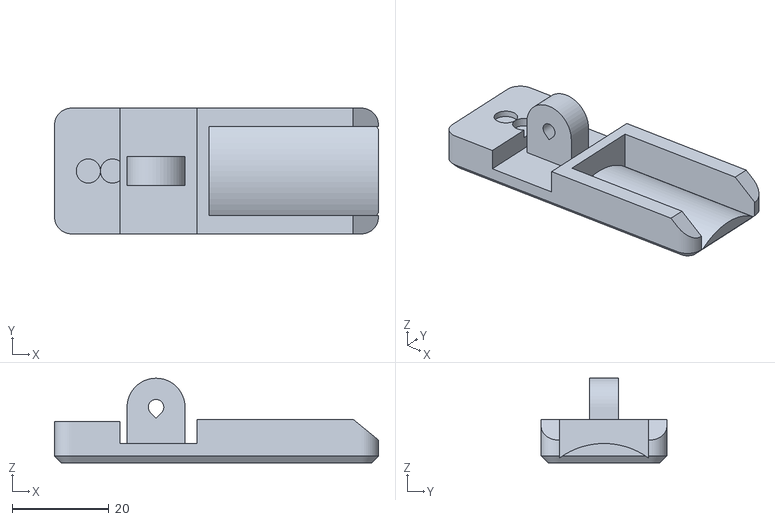
[picture p152: CAD file, 2026-10-02]
case/FINAL_TA/07_STL_siap_cetak/Klip_PPG/B_RahangAtas_siap_cetak.stl
67.0 x 26.0 x 17.5
