fathurraihan18/TA/case/FINAL_TA/_render/bagian/sw_bezel.stl

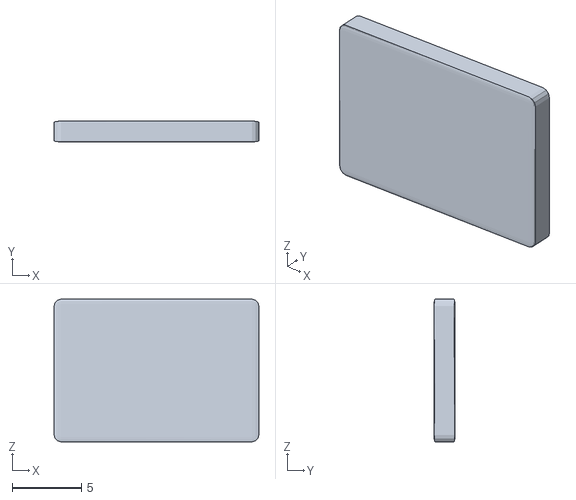
[picture p153: CAD file, 2026-10-06]
case/FINAL_TA/_render/bagian/sw_bezel.stl
14.8 x 1.50 x 10.3
