fathurraihan18/TA/case/komponen/ad8232/ad8232_0_PCB_Re1.stl

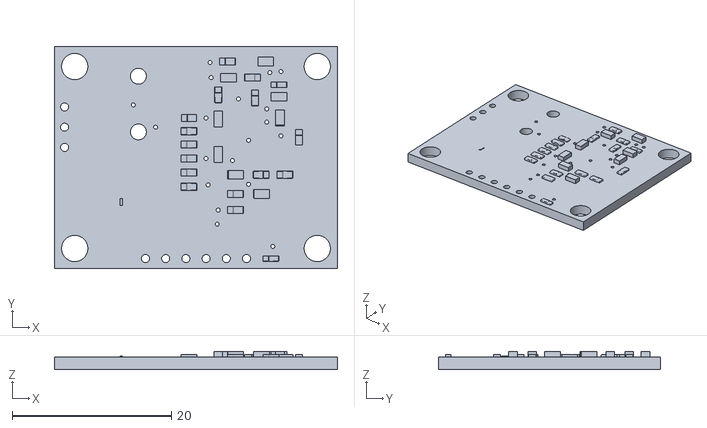
[picture p154: CAD file, 2026-10-02]
case/komponen/ad8232/ad8232_0_PCB_Re1.stl
35.6 x 27.9 x 2.27
