fathurraihan18/TA/case/komponen/esp32/esp32_smd_b.stl

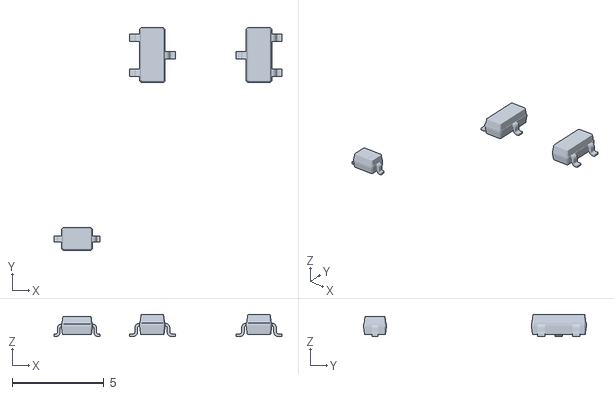
[picture p155: CAD file, 2026-10-02]
case/komponen/esp32/esp32_smd_b.stl
12.4 x 12.1 x 1.20
