fathurraihan18/TA/case/komponen/hw605/hw605_sensor.stl

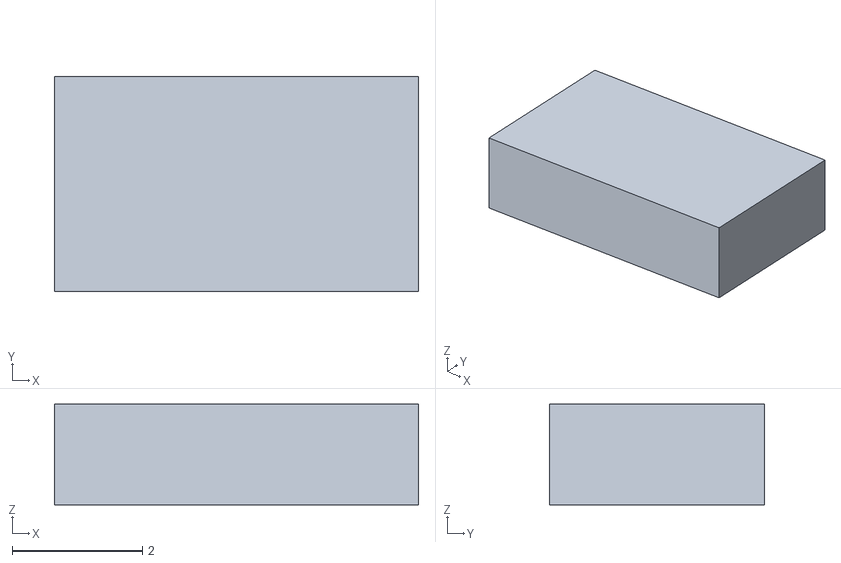
[picture p156: CAD file, 2026-10-02]
case/komponen/hw605/hw605_sensor.stl
5.60 x 3.30 x 1.55
