fathurraihan18/TA/case/sensor_ppg/klip_v2/_ref/ref_Kawat_bundel.stl

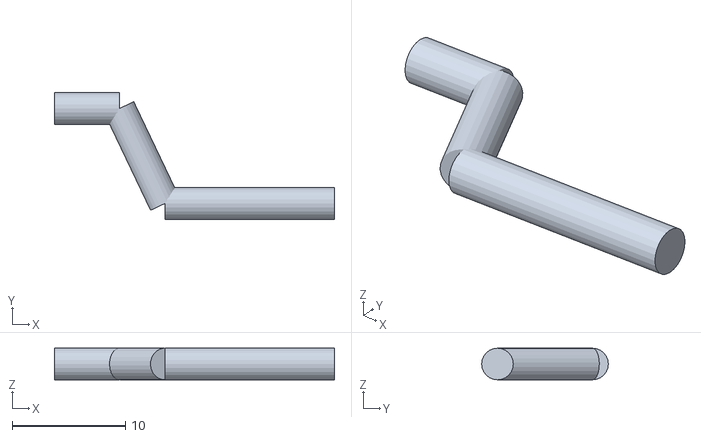
[picture p157: CAD file, 2026-10-02]
case/sensor_ppg/klip_v2/_ref/ref_Kawat_bundel.stl
24.8 x 11.2 x 2.80
