fathurraihan18/TA/case/v2b_sekrup_samping/_ref/ref_Sekrup_samping_M3.stl

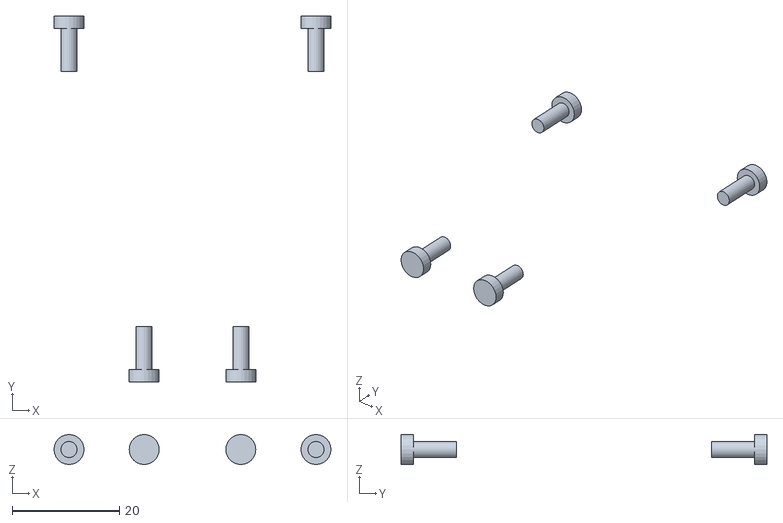
[picture p158: CAD file, 2026-10-05]
case/v2b_sekrup_samping/_ref/ref_Sekrup_samping_M3.stl
51.6 x 68.1 x 5.60
