fathurraihan18/TA/case/v2b_sekrup_samping/perbaikan_v2_tercetak/jig_bor_ATAS.stl

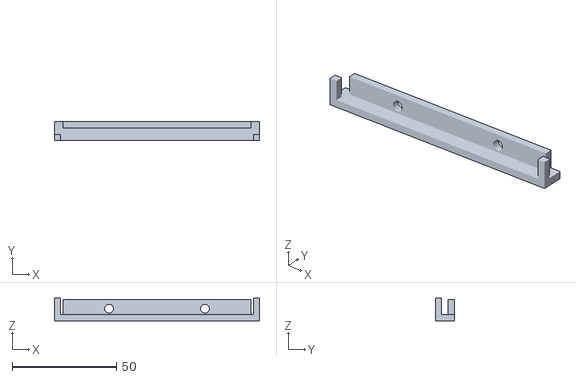
[picture p159: CAD file, 2026-10-05]
case/v2b_sekrup_samping/perbaikan_v2_tercetak/jig_bor_ATAS.stl
98.4 x 9.06 x 11.0
