fathurraihan18/TA/case/v2c_penahan_sekrup/3_Penahan_Sekrup_x4_siap_cetak.stl

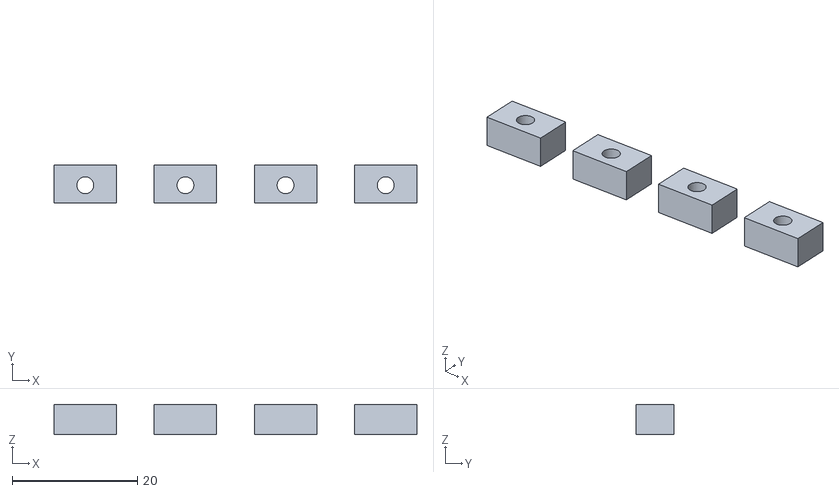
[picture p160: CAD file, 2026-10-05]
case/v2c_penahan_sekrup/3_Penahan_Sekrup_x4_siap_cetak.stl
58.0 x 6.00 x 4.80
