fathurraihan18/TA/case/v2d_penahan_strip/_ref/asm/esp32__esp_smd_d.stl

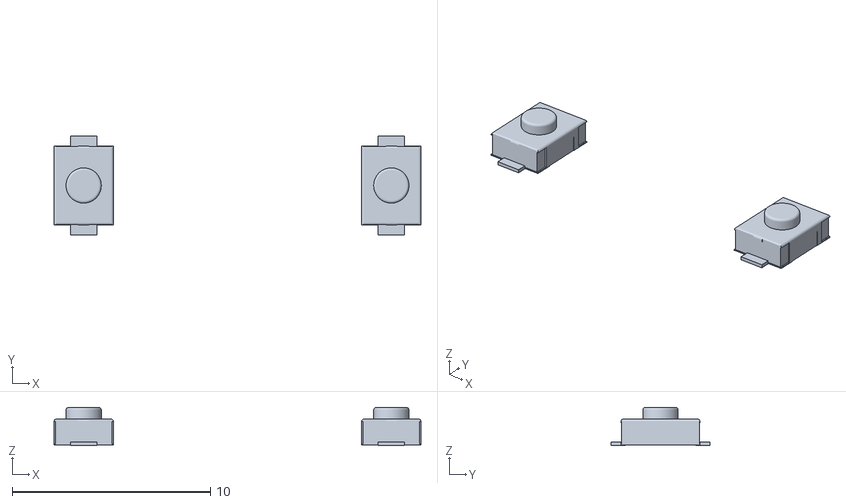
[picture p161: CAD file, 2026-10-02]
case/v2d_penahan_strip/_ref/asm/esp32__esp_smd_d.stl
18.5 x 5.00 x 1.93
