fathurraihan18/TA/case/v2d_penahan_strip/_ref/penahan_design.stl

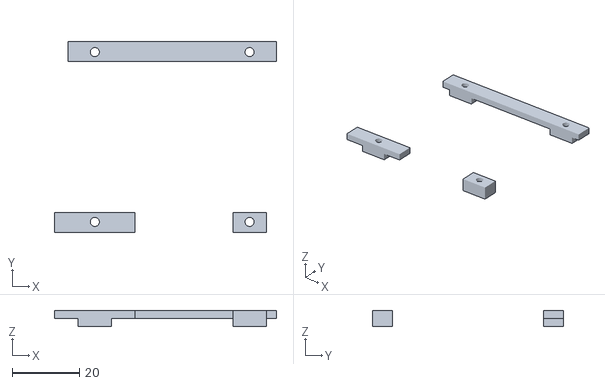
[picture p162: CAD file, 2026-10-05]
case/v2d_penahan_strip/_ref/penahan_design.stl
66.0 x 56.9 x 4.80
