fathurraihan18/TA/case/v3b_sekrup_samping/_ref/ref_Sekrup_samping_M3.stl

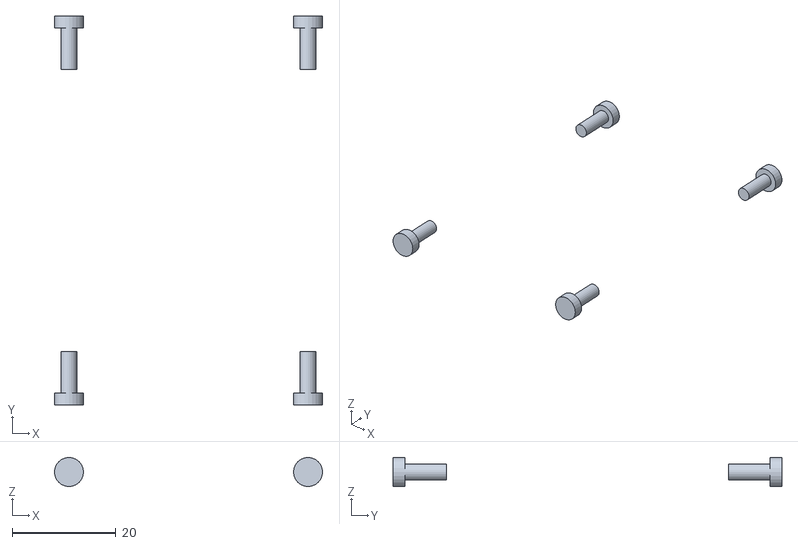
[picture p163: CAD file, 2026-10-05]
case/v3b_sekrup_samping/_ref/ref_Sekrup_samping_M3.stl
51.6 x 74.8 x 5.60
