fathurraihan18/TA/case/v3c_penahan_sekrup/_ref/ref_Baterai_PALO103450.stl

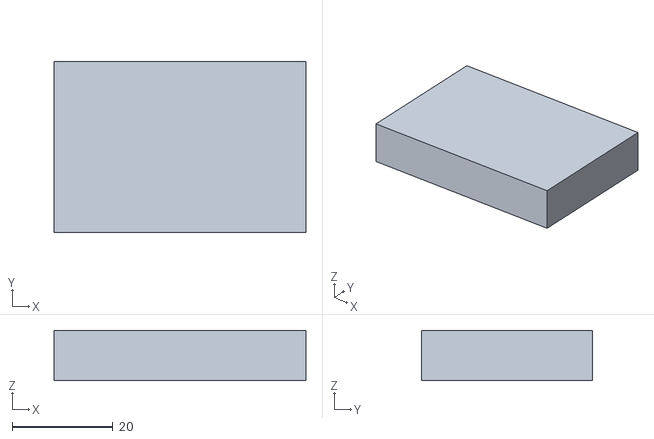
[picture p164: CAD file, 2026-10-02]
case/v3c_penahan_sekrup/_ref/ref_Baterai_PALO103450.stl
50.0 x 34.0 x 10.0
