fathurraihan18/TA/case/FINAL_TA/07_STL_siap_cetak/Casing_ECG_PPG/1_Shell_Depan_siap_cetak.stl

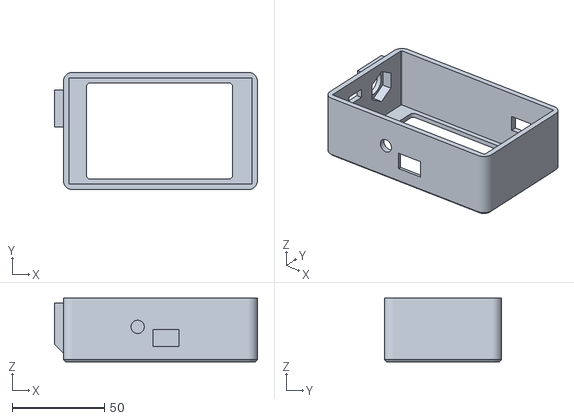
[picture p165: CAD file, 2026-10-05]
case/FINAL_TA/07_STL_siap_cetak/Casing_ECG_PPG/1_Shell_Depan_siap_cetak.stl
109.8 x 63.5 x 34.4
