fathurraihan18/TA/case/FINAL_TA/07_STL_siap_cetak/Klip_PPG/D_ShimPegas_siap_cetak.stl

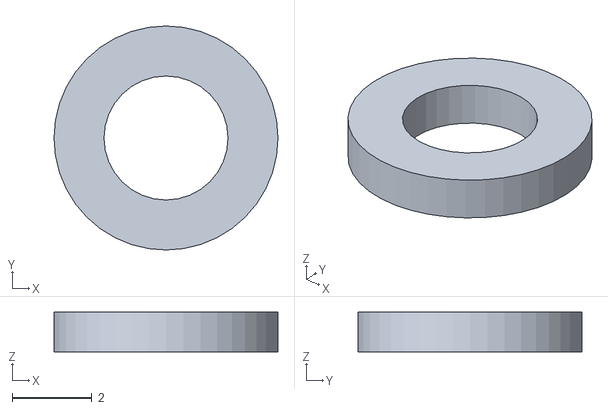
[picture p166: CAD file, 2026-10-02]
case/FINAL_TA/07_STL_siap_cetak/Klip_PPG/D_ShimPegas_siap_cetak.stl
5.60 x 5.60 x 1.00
