fathurraihan18/TA/case/FINAL_TA/_render/bagian/gl_ulir.stl

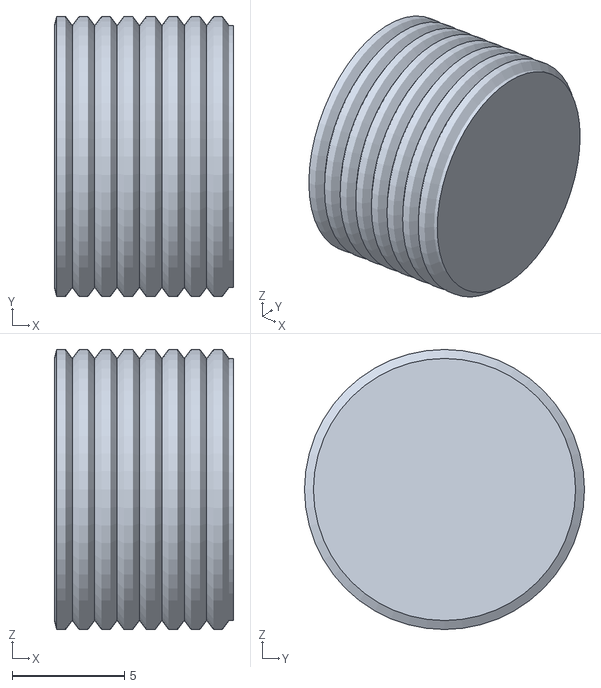
[picture p167: CAD file, 2026-10-06]
case/FINAL_TA/_render/bagian/gl_ulir.stl
8.00 x 12.5 x 12.5
