fathurraihan18/TA/case/komponen/ad8232/ad8232_1_Dark_Chips_002.stl

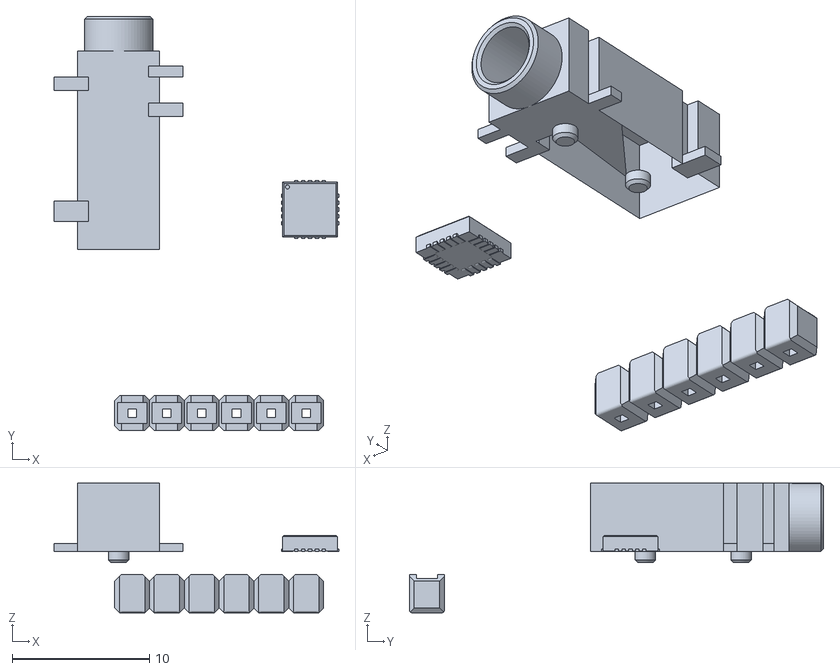
[picture p168: CAD file, 2026-10-02]
case/komponen/ad8232/ad8232_1_Dark_Chips_002.stl
20.8 x 30.2 x 9.45
