fathurraihan18/TA/case/komponen/hw605/hw605_pcb.stl

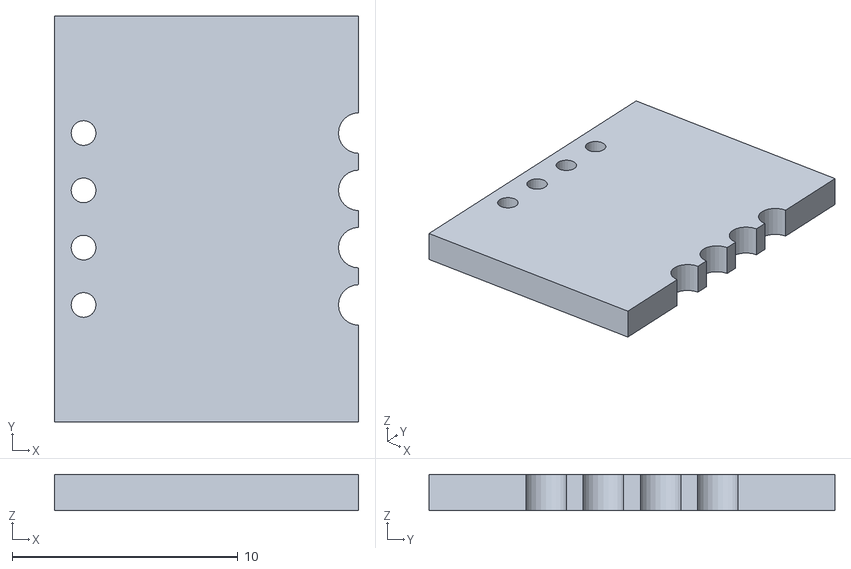
[picture p169: CAD file, 2026-10-02]
case/komponen/hw605/hw605_pcb.stl
13.5 x 18.0 x 1.60
