fathurraihan18/TA/case/sensor_ppg/klip_v2/_ref/A_desain.stl

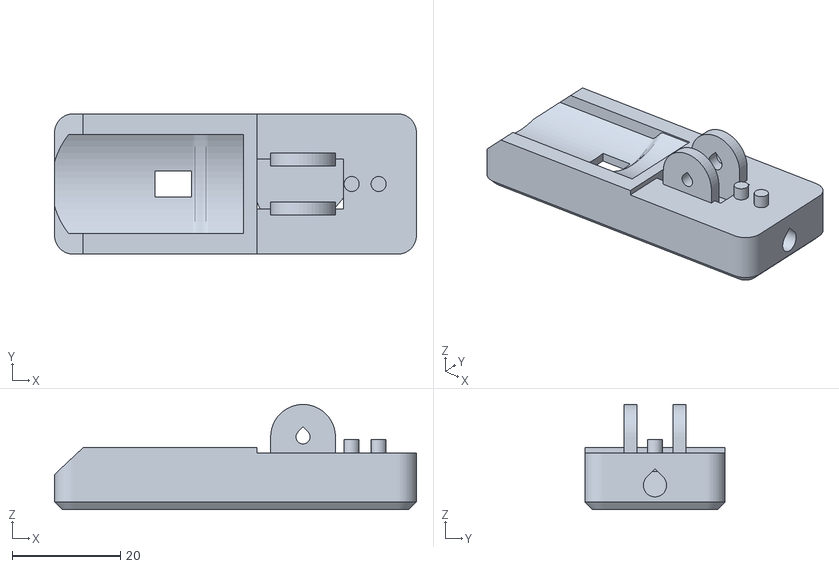
[picture p170: CAD file, 2026-10-02]
case/sensor_ppg/klip_v2/_ref/A_desain.stl
67.0 x 26.0 x 19.4
