fathurraihan18/TA/case/v2b_sekrup_samping/perbaikan_v2_tercetak/bagian_dibuang_dari_shell_v2.stl

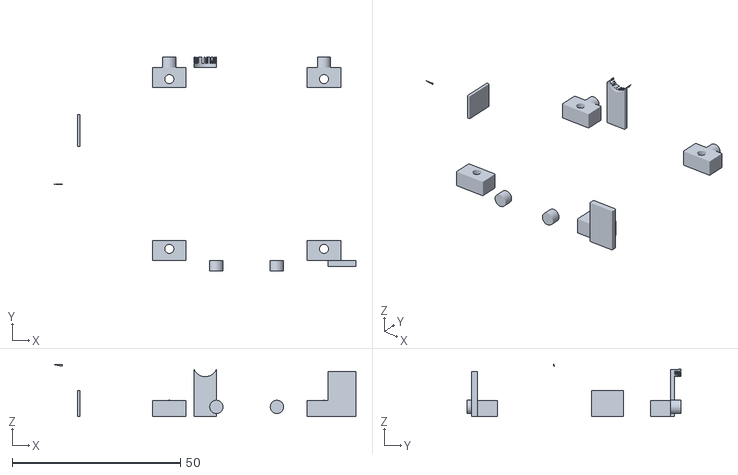
[picture p171: CAD file, 2026-10-05]
case/v2b_sekrup_samping/perbaikan_v2_tercetak/bagian_dibuang_dari_shell_v2.stl
89.8 x 63.5 x 15.6
