fathurraihan18/TA/case/v2d_penahan_strip/_ref/asm/esp32__esp_strip.stl

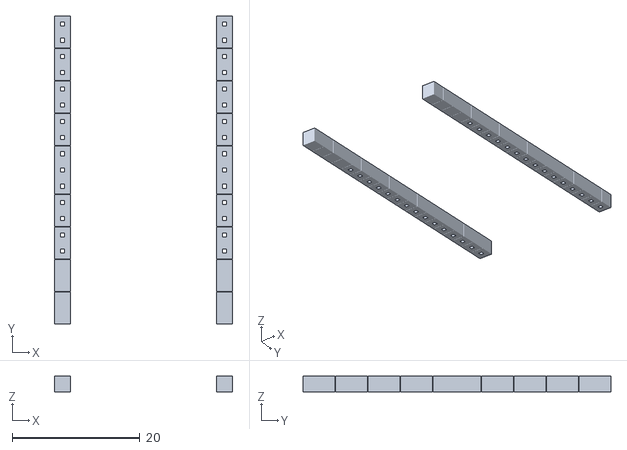
[picture p172: CAD file, 2026-10-02]
case/v2d_penahan_strip/_ref/asm/esp32__esp_strip.stl
27.9 x 48.2 x 2.50
