fathurraihan18/TA/case/FINAL_TA/07_STL_siap_cetak/Casing_ECG_PPG/2_BackPlate_siap_cetak.stl

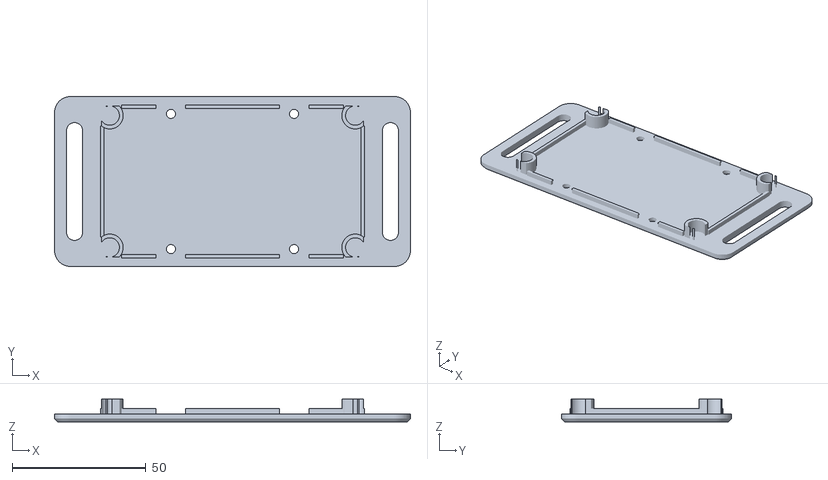
[picture p173: CAD file, 2026-10-02]
case/FINAL_TA/07_STL_siap_cetak/Casing_ECG_PPG/2_BackPlate_siap_cetak.stl
133.0 x 63.5 x 8.50
