fathurraihan18/TA/case/FINAL_TA/_render/bagian/sw_badan.stl

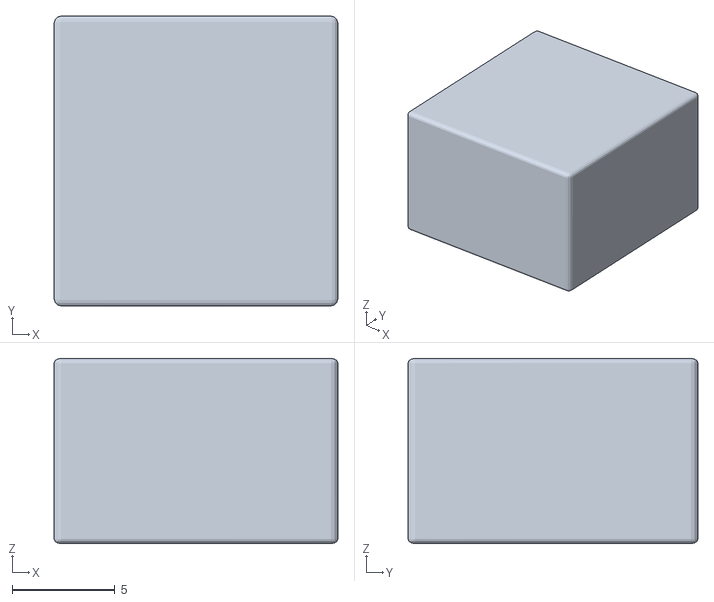
[picture p174: CAD file, 2026-10-06]
case/FINAL_TA/_render/bagian/sw_badan.stl
13.8 x 14.1 x 9.00
