fathurraihan18/TA/case/komponen/ad8232/ad8232_2_Metal_002.stl

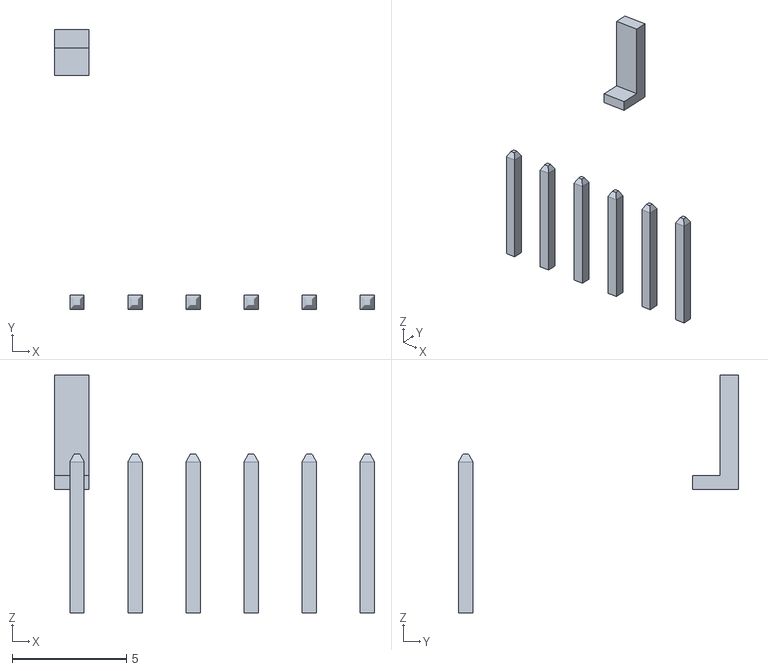
[picture p175: CAD file, 2026-10-02]
case/komponen/ad8232/ad8232_2_Metal_002.stl
14.0 x 12.2 x 10.4
