fathurraihan18/TA/case/komponen/esp32/esp32_lain.stl

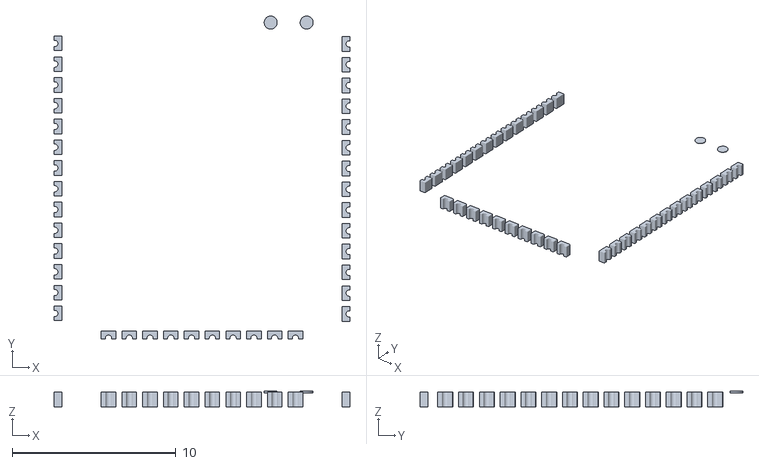
[picture p176: CAD file, 2026-10-02]
case/komponen/esp32/esp32_lain.stl
18.1 x 19.7 x 0.95
