fathurraihan18/TA/case/komponen/hw605/hw605_ic.stl

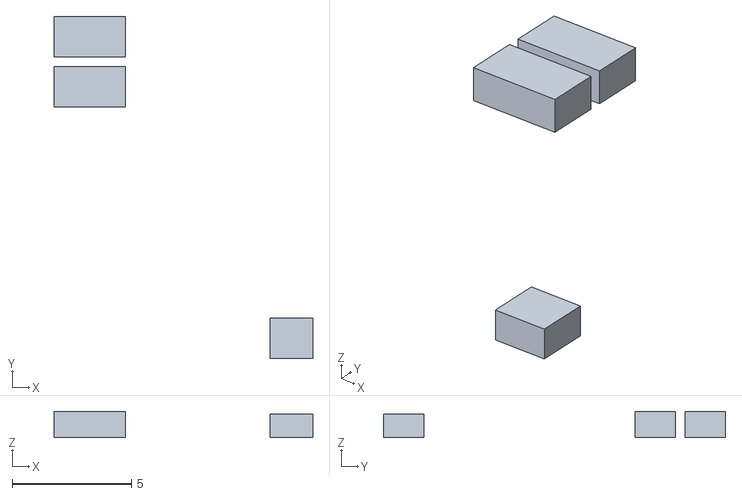
[picture p177: CAD file, 2026-10-02]
case/komponen/hw605/hw605_ic.stl
10.8 x 14.3 x 1.10
