fathurraihan18/TA/case/sensor_ppg/klip_v2/_ref/ref_Modul_HW605.stl

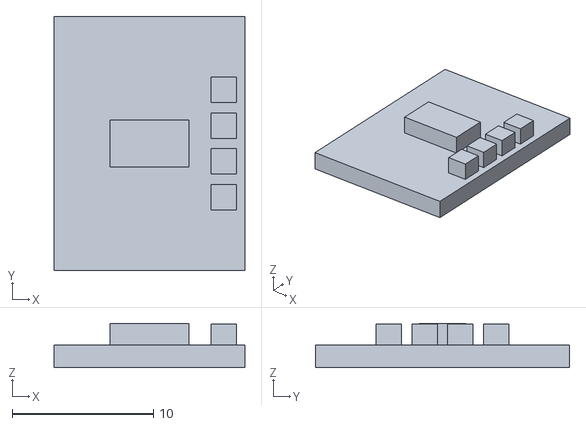
[picture p178: CAD file, 2026-10-02]
case/sensor_ppg/klip_v2/_ref/ref_Modul_HW605.stl
13.5 x 18.0 x 3.15
