fathurraihan18/TA/case/v2d_penahan_strip/_ref/asm/ppg__clip_hw605_jendela.stl

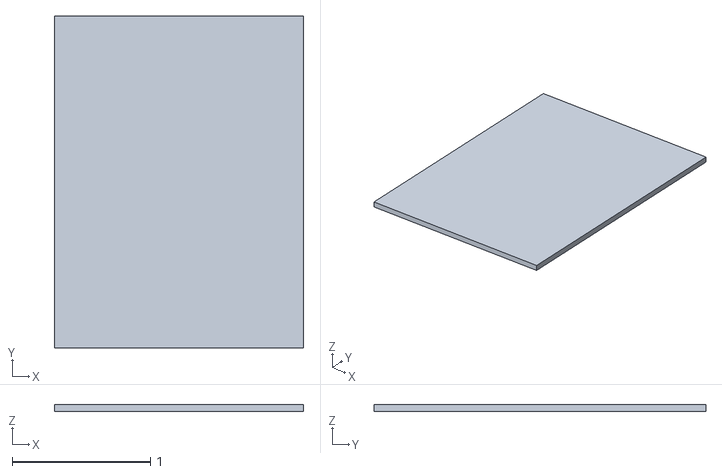
[picture p179: CAD file, 2026-10-02]
case/v2d_penahan_strip/_ref/asm/ppg__clip_hw605_jendela.stl
1.80 x 2.40 x 0.05
