fathurraihan18/TA/case/v2d_penahan_strip/_ref/ref_Sekrup_M3x8.stl

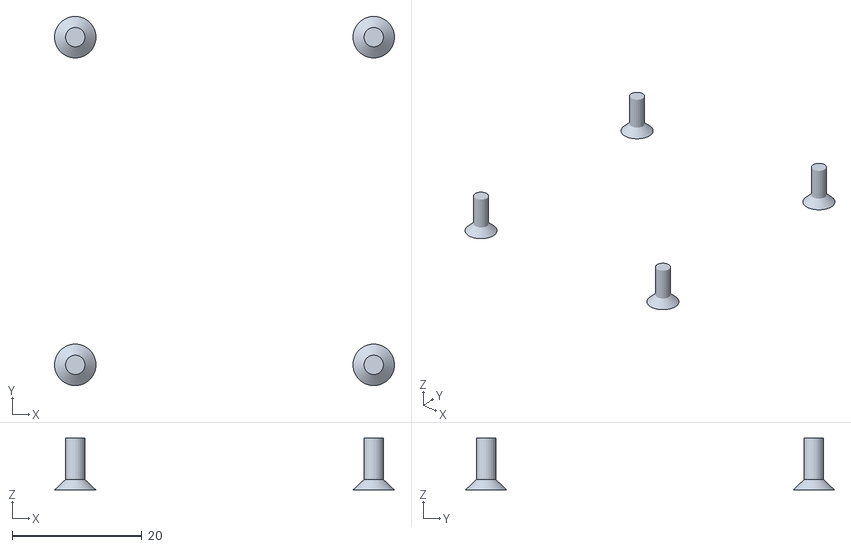
[picture p180: CAD file, 2026-10-02]
case/v2d_penahan_strip/_ref/ref_Sekrup_M3x8.stl
52.4 x 56.9 x 8.00
