fathurraihan18/TA/case/FINAL_TA/07_STL_siap_cetak/Klip_PPG/C_TutupBawah_siap_cetak.stl

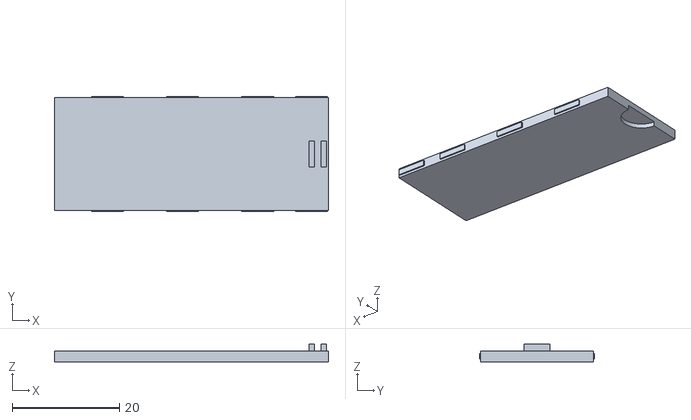
[picture p181: CAD file, 2026-10-02]
case/FINAL_TA/07_STL_siap_cetak/Klip_PPG/C_TutupBawah_siap_cetak.stl
51.1 x 21.5 x 3.30
