fathurraihan18/TA/case/FINAL_TA/_render/bagian/sw_kaki0.stl

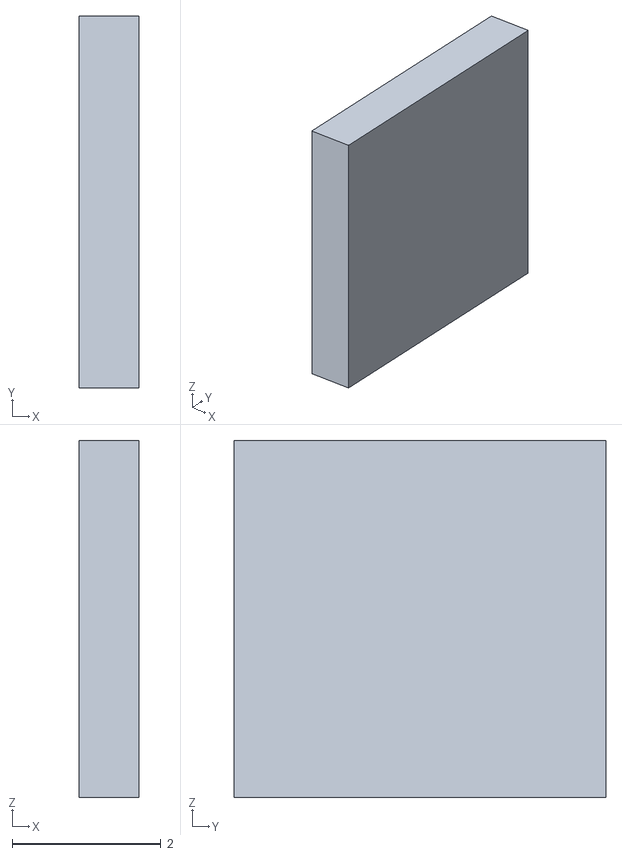
[picture p182: CAD file, 2026-10-06]
case/FINAL_TA/_render/bagian/sw_kaki0.stl
0.8 x 5.00 x 4.80
