fathurraihan18/TA/case/komponen/esp32/esp32_pin.stl

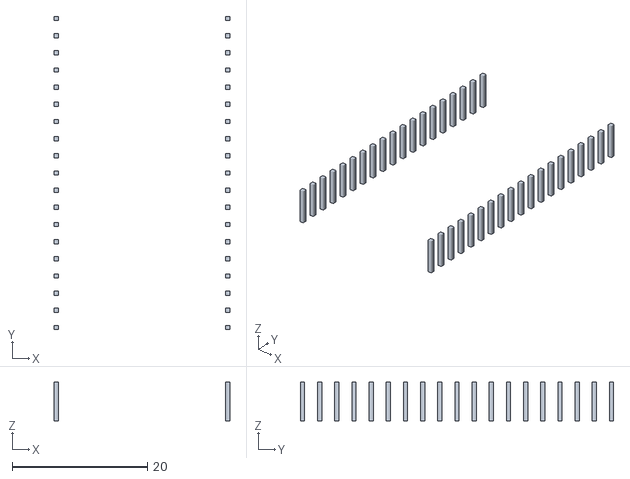
[picture p183: CAD file, 2026-10-02]
case/komponen/esp32/esp32_pin.stl
26.0 x 46.4 x 5.70
