fathurraihan18/TA/case/sensor_ppg/klip_v2/_ref/ref_Pegas.stl

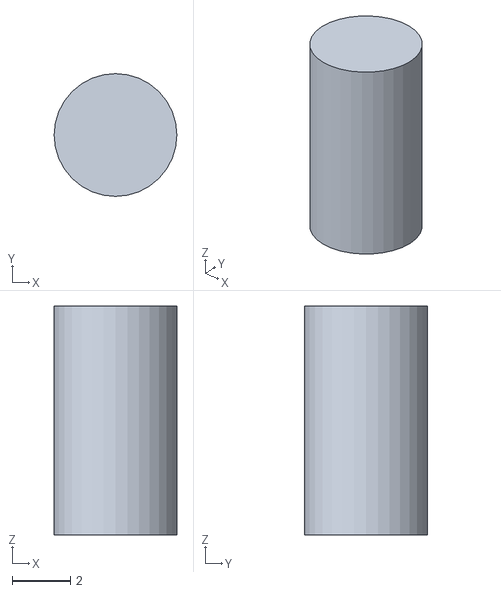
[picture p184: CAD file, 2026-10-02]
case/sensor_ppg/klip_v2/_ref/ref_Pegas.stl
4.20 x 4.20 x 7.83
