fathurraihan18/TA/case/v2d_penahan_strip/_ref/asm/ppg__clip_sekrup.stl

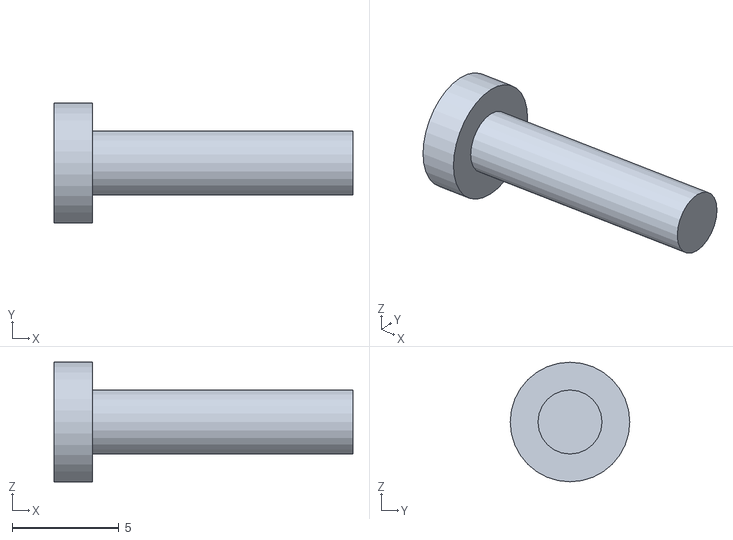
[picture p185: CAD file, 2026-10-02]
case/v2d_penahan_strip/_ref/asm/ppg__clip_sekrup.stl
14.0 x 5.60 x 5.60
