fathurraihan18/TA/case/komponen/esp32/esp32_smd_a.stl

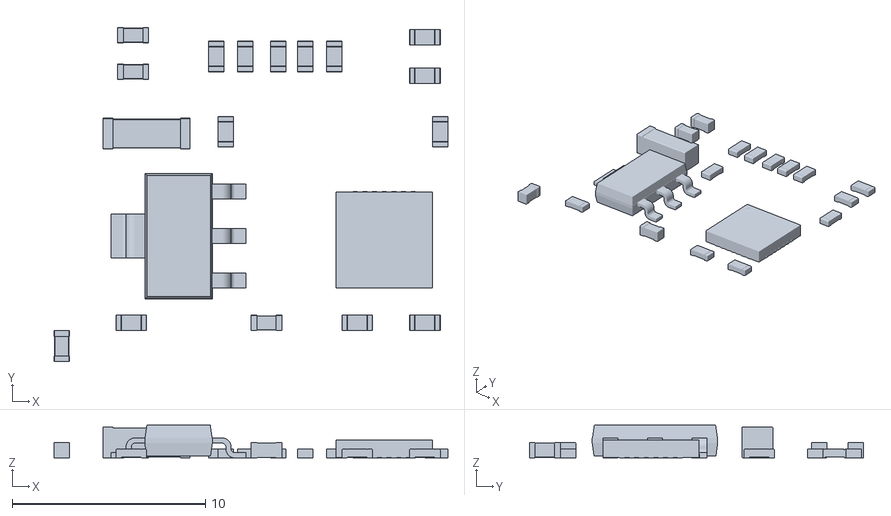
[picture p186: CAD file, 2026-10-02]
case/komponen/esp32/esp32_smd_a.stl
20.4 x 17.3 x 1.70
