fathurraihan18/TA/case/komponen/hw605/hw605_smd.stl

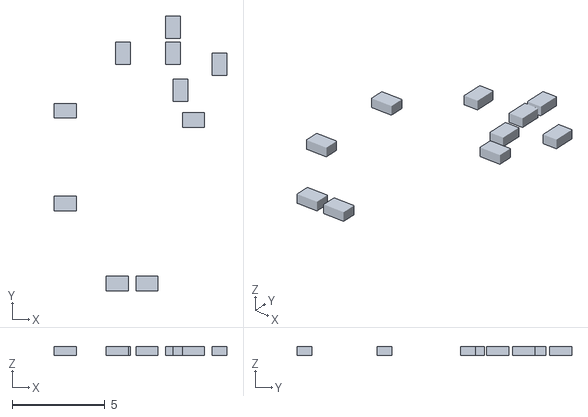
[picture p187: CAD file, 2026-10-02]
case/komponen/hw605/hw605_smd.stl
9.30 x 14.8 x 0.5
