fathurraihan18/TA/case/sensor_ppg/klip_v2/_ref/ref_Kabel_4_inti.stl

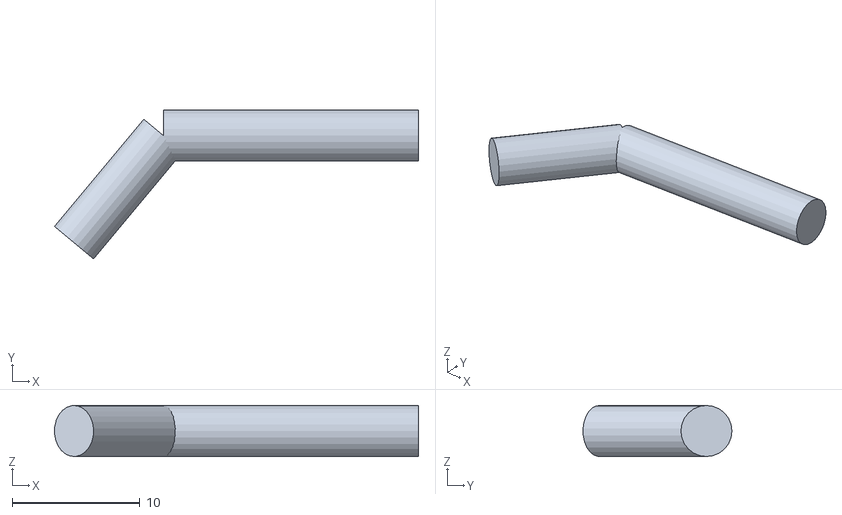
[picture p188: CAD file, 2026-10-02]
case/sensor_ppg/klip_v2/_ref/ref_Kabel_4_inti.stl
28.5 x 11.7 x 4.00
