fathurraihan18/TA/case/v2d_penahan_strip/_ref/ref_Gland_PG7_+_mur.stl

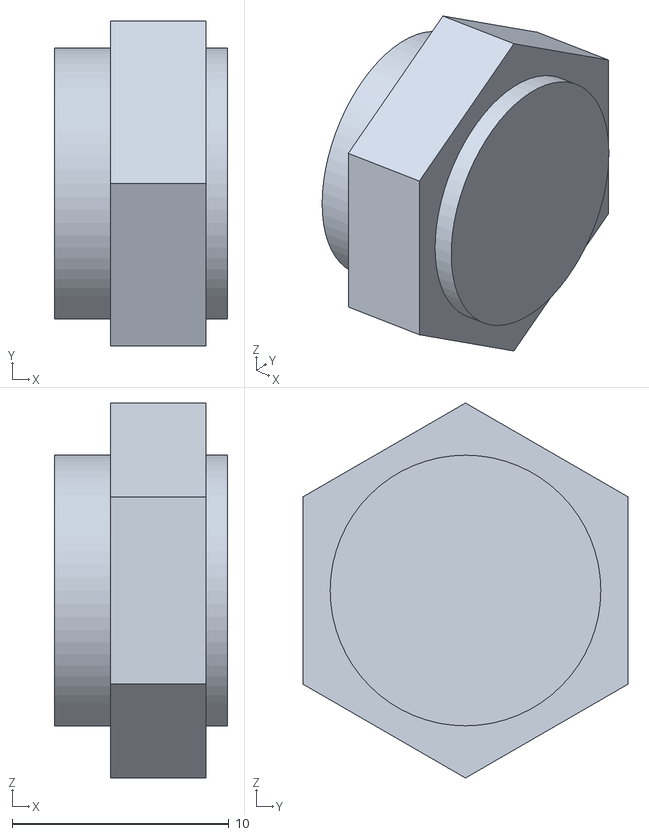
[picture p189: CAD file, 2026-10-02]
case/v2d_penahan_strip/_ref/ref_Gland_PG7_+_mur.stl
8.00 x 15.0 x 17.3
