fathurraihan18/TA/case/FINAL_TA/_render/bagian/sw_rocker.stl

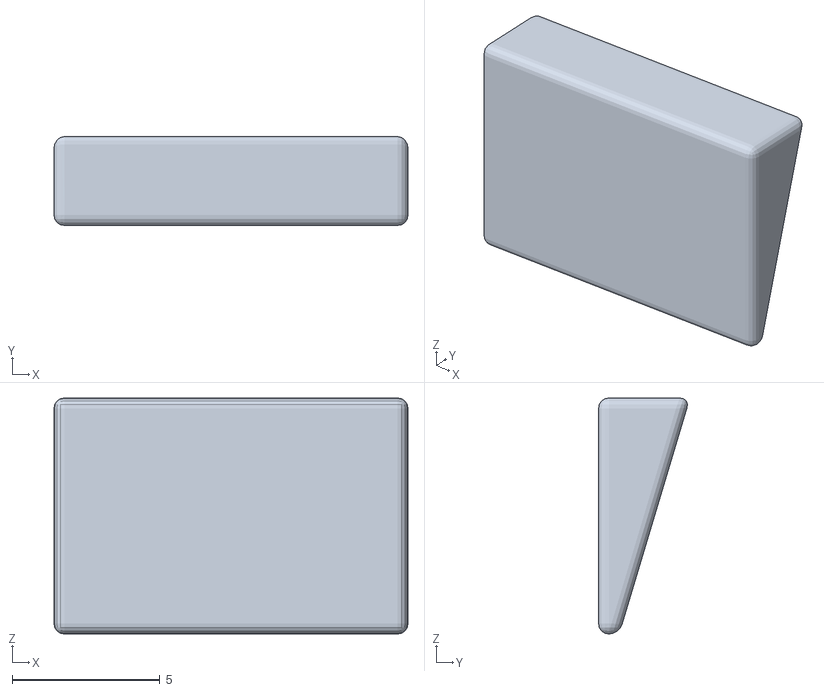
[picture p190: CAD file, 2026-10-06]
case/FINAL_TA/_render/bagian/sw_rocker.stl
12.0 x 3.01 x 8.00
