fathurraihan18/TA/case/komponen/hw605/hw605_pad.stl

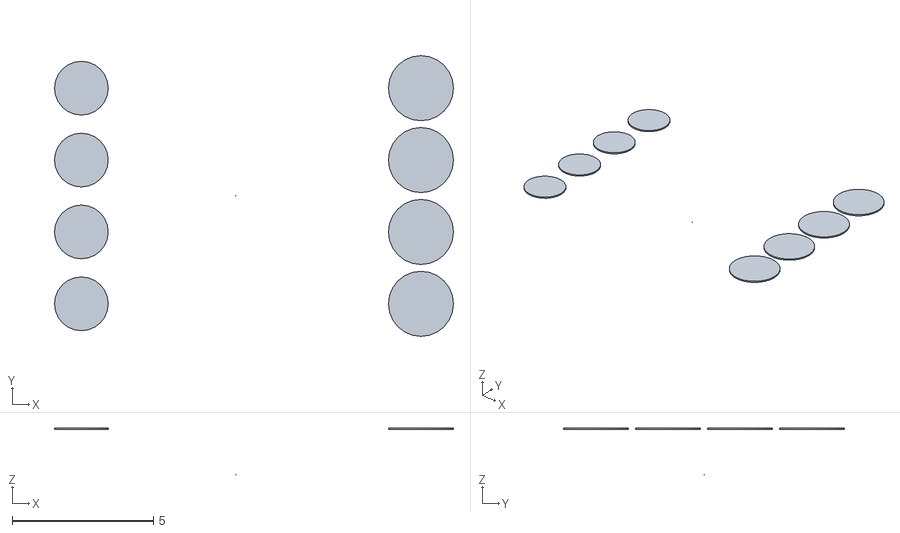
[picture p191: CAD file, 2026-10-02]
case/komponen/hw605/hw605_pad.stl
14.1 x 9.92 x 1.66
