fathurraihan18/TA/case/v2d_penahan_strip/_ref/ref_microUSB_ESP32.stl

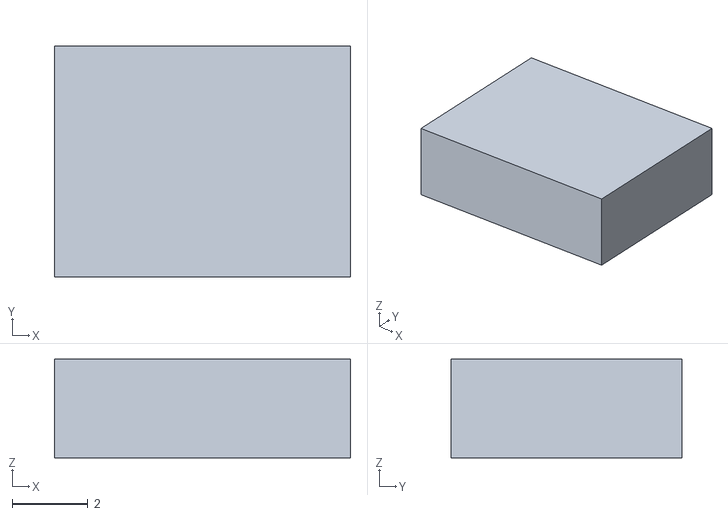
[picture p192: CAD file, 2026-10-02]
case/v2d_penahan_strip/_ref/ref_microUSB_ESP32.stl
7.80 x 6.10 x 2.60
