fathurraihan18/TA/case/FINAL_TA/_render/bagian/gl_kepala.stl

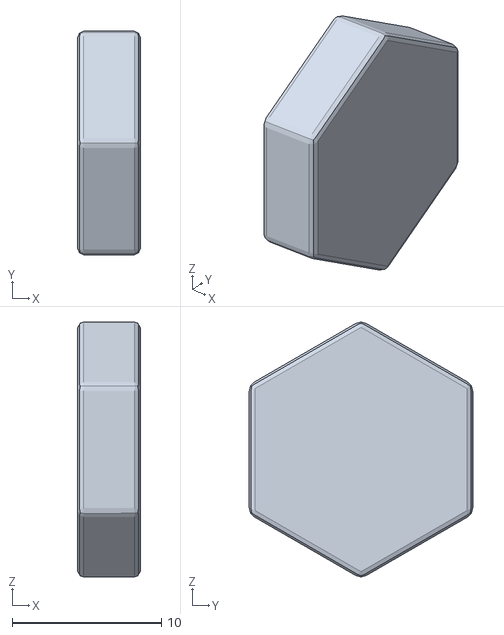
[picture p193: CAD file, 2026-10-06]
case/FINAL_TA/_render/bagian/gl_kepala.stl
4.20 x 15.0 x 17.1
