fathurraihan18/TA/case/komponen/esp32/esp32_teks_perisai.stl

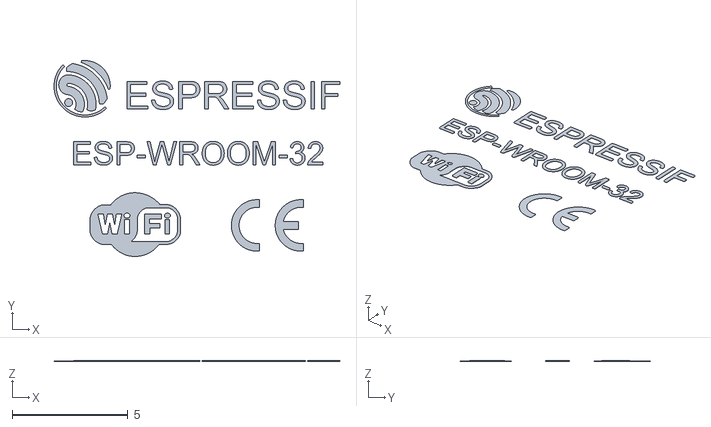
[picture p194: CAD file, 2026-10-02]
case/komponen/esp32/esp32_teks_perisai.stl
12.3 x 8.45 x 0.05
