fathurraihan18/TA/case/v2d_penahan_strip/_ref/ref_USBC_powerbank.stl

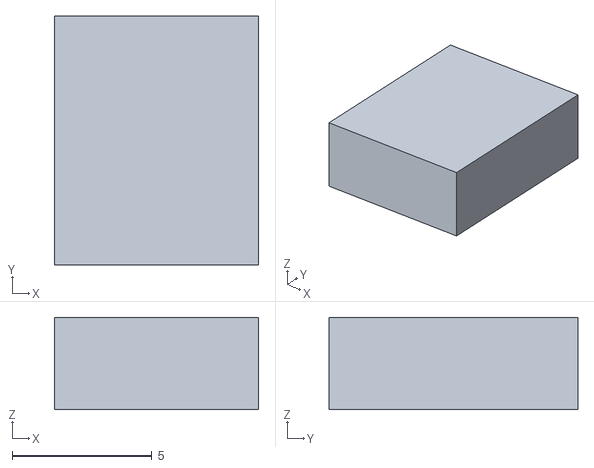
[picture p195: CAD file, 2026-10-02]
case/v2d_penahan_strip/_ref/ref_USBC_powerbank.stl
7.30 x 8.90 x 3.30
