fathurraihan18/TA/case/FINAL_TA/_render/bagian/gl_tutup.stl

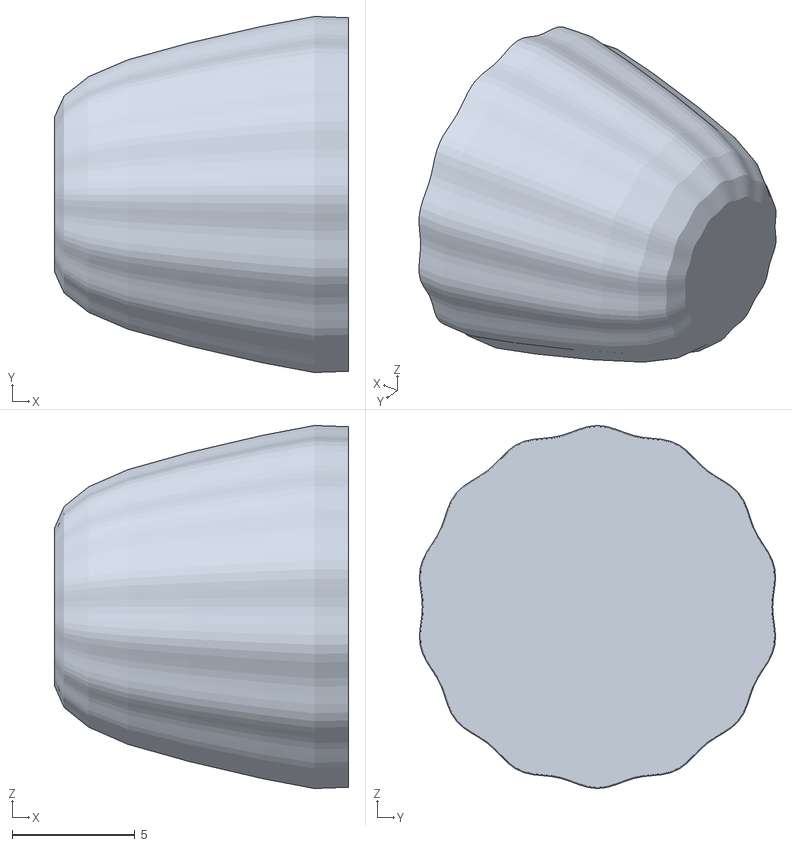
[picture p196: CAD file, 2026-10-06]
case/FINAL_TA/_render/bagian/gl_tutup.stl
12.0 x 14.5 x 14.8
