fathurraihan18/TA/case/komponen/esp32/esp32_usb.stl

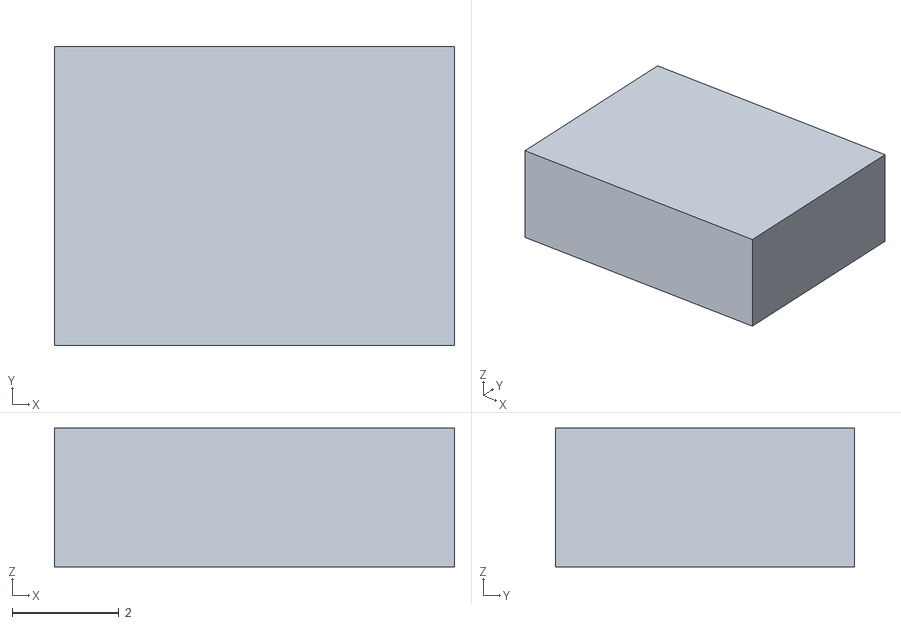
[picture p197: CAD file, 2026-10-02]
case/komponen/esp32/esp32_usb.stl
7.50 x 5.60 x 2.60
