fathurraihan18/TA/case/v2d_penahan_strip/_ref/asm/esp32__esp_smd_c.stl

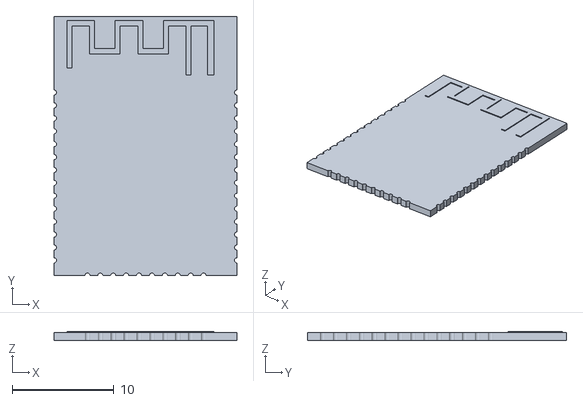
[picture p198: CAD file, 2026-10-02]
case/v2d_penahan_strip/_ref/asm/esp32__esp_smd_c.stl
18.0 x 25.5 x 0.9
