fathurraihan18/TA/case/v2d_penahan_strip/_ref/ref_Area_aktif.stl

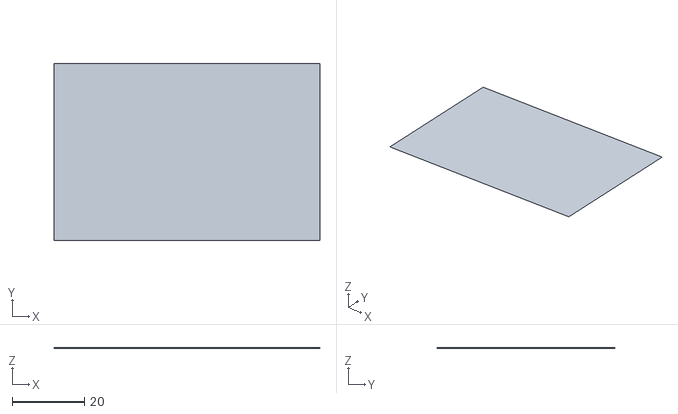
[picture p199: CAD file, 2026-10-02]
case/v2d_penahan_strip/_ref/ref_Area_aktif.stl
73.4 x 49.0 x 0.05
