fathurraihan18/TA/case/FINAL_TA/_render/bagian/gl_seal.stl

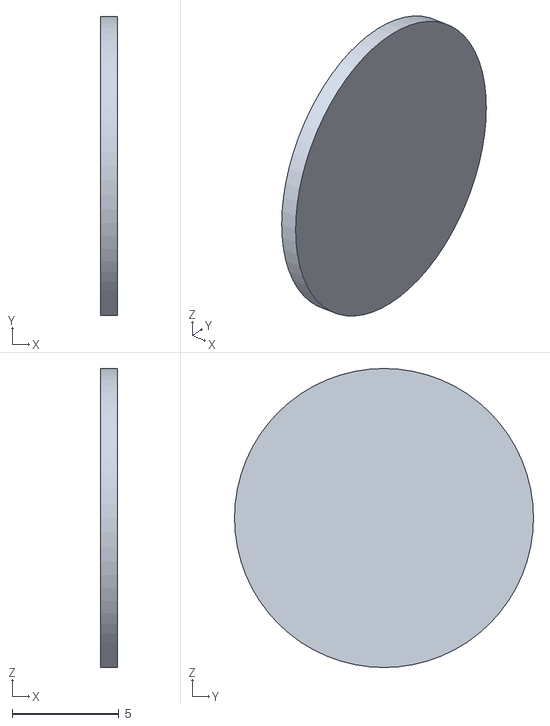
[picture p200: CAD file, 2026-10-06]
case/FINAL_TA/_render/bagian/gl_seal.stl
0.8 x 14.0 x 14.0
