fathurraihan18/TA/case/komponen/esp32/esp32_smd_c.stl

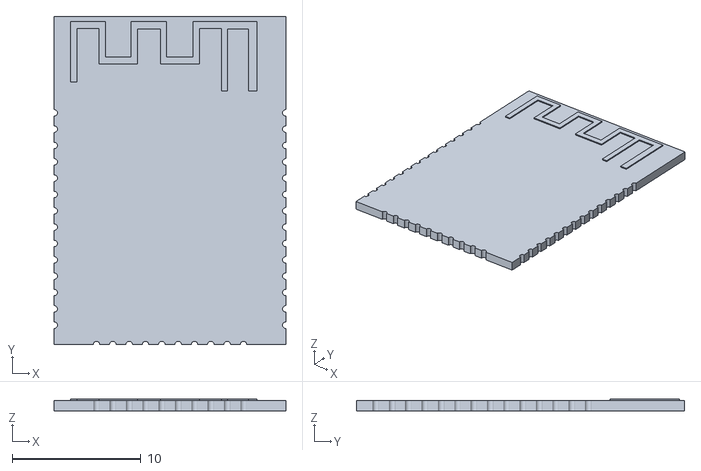
[picture p201: CAD file, 2026-10-02]
case/komponen/esp32/esp32_smd_c.stl
18.0 x 25.5 x 0.9
