fathurraihan18/TA/case/sensor_ppg/klip_v2/_ref/ref_Jari_telunjuk.stl

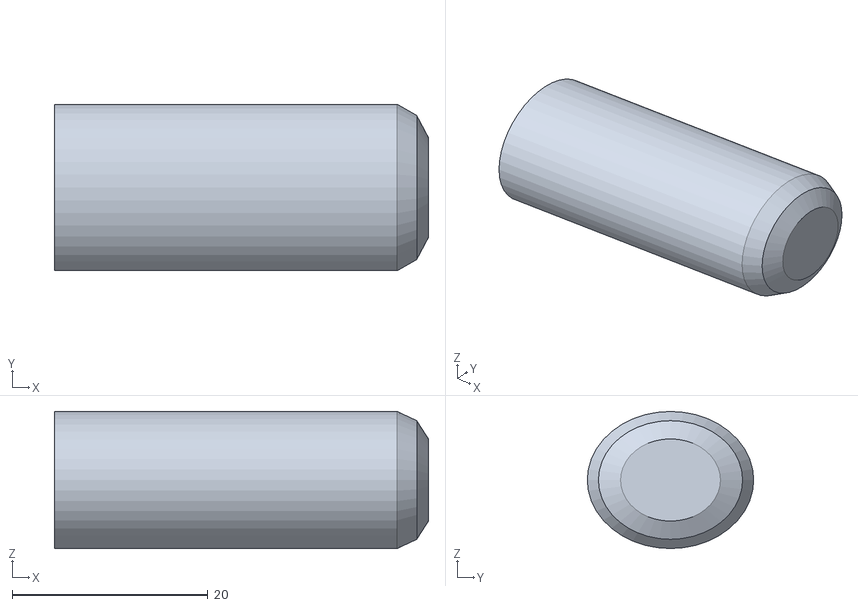
[picture p202: CAD file, 2026-10-02]
case/sensor_ppg/klip_v2/_ref/ref_Jari_telunjuk.stl
38.2 x 17.0 x 14.0
