fathurraihan18/TA/case/v2d_penahan_strip/_ref/ref_Baut_spacer.stl

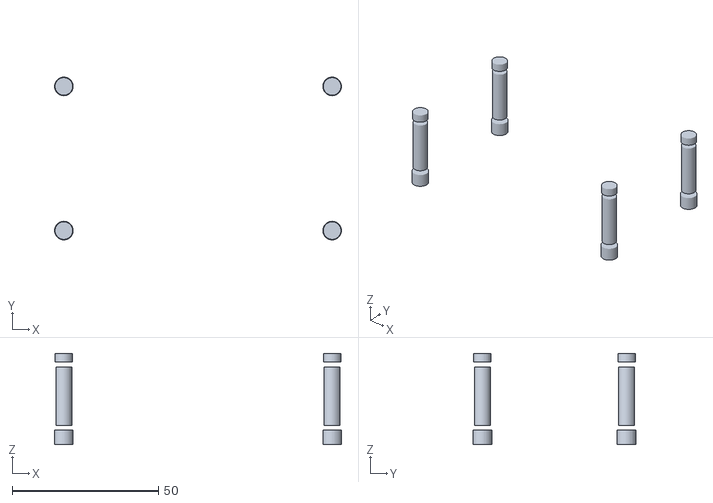
[picture p203: CAD file, 2026-10-02]
case/v2d_penahan_strip/_ref/ref_Baut_spacer.stl
98.1 x 55.7 x 31.2
