fathurraihan18/TA/case/FINAL_TA/_render/bagian/gl_mur.stl

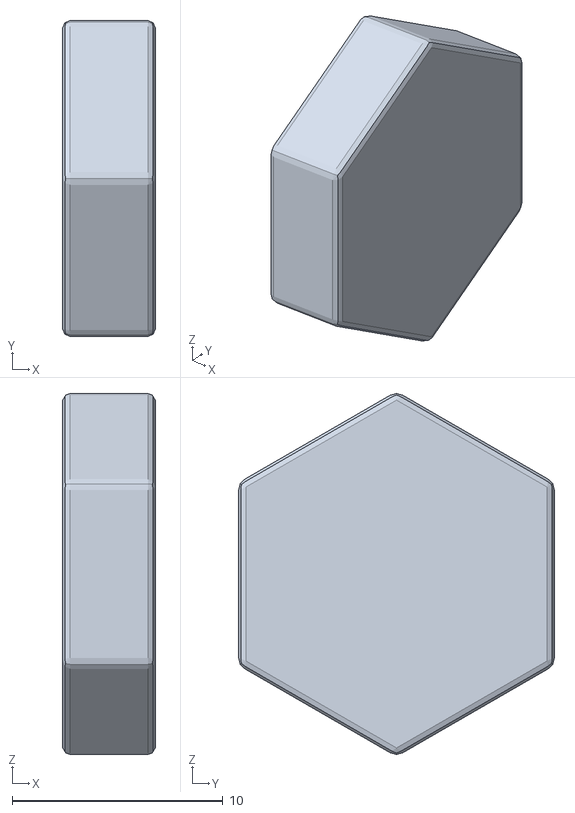
[picture p204: CAD file, 2026-10-06]
case/FINAL_TA/_render/bagian/gl_mur.stl
4.40 x 15.0 x 17.1
