fathurraihan18/TA/case/komponen/esp32/esp32_usb_slot.stl

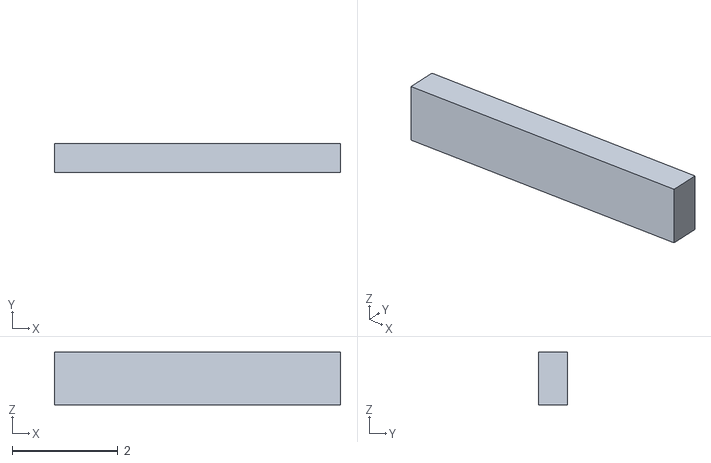
[picture p205: CAD file, 2026-10-02]
case/komponen/esp32/esp32_usb_slot.stl
5.40 x 0.55 x 1
