fathurraihan18/TA/case/v2d_penahan_strip/_ref/asm/ppg__clip_hw605_sensor.stl

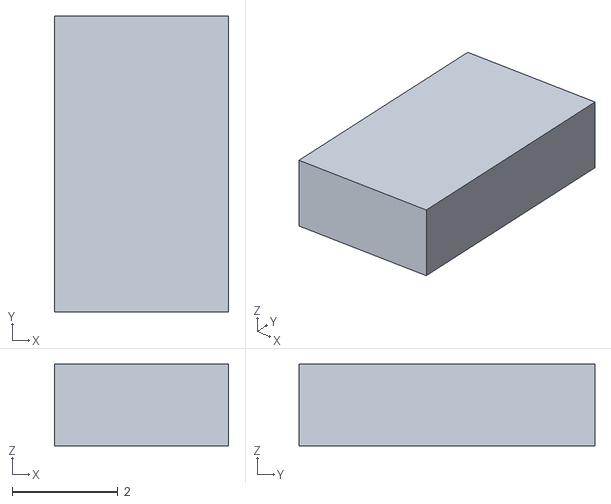
[picture p206: CAD file, 2026-10-02]
case/v2d_penahan_strip/_ref/asm/ppg__clip_hw605_sensor.stl
3.30 x 5.60 x 1.55
