fathurraihan18/TA/case/v2d_penahan_strip/_ref/ref_Plug_jack_AD8232.stl

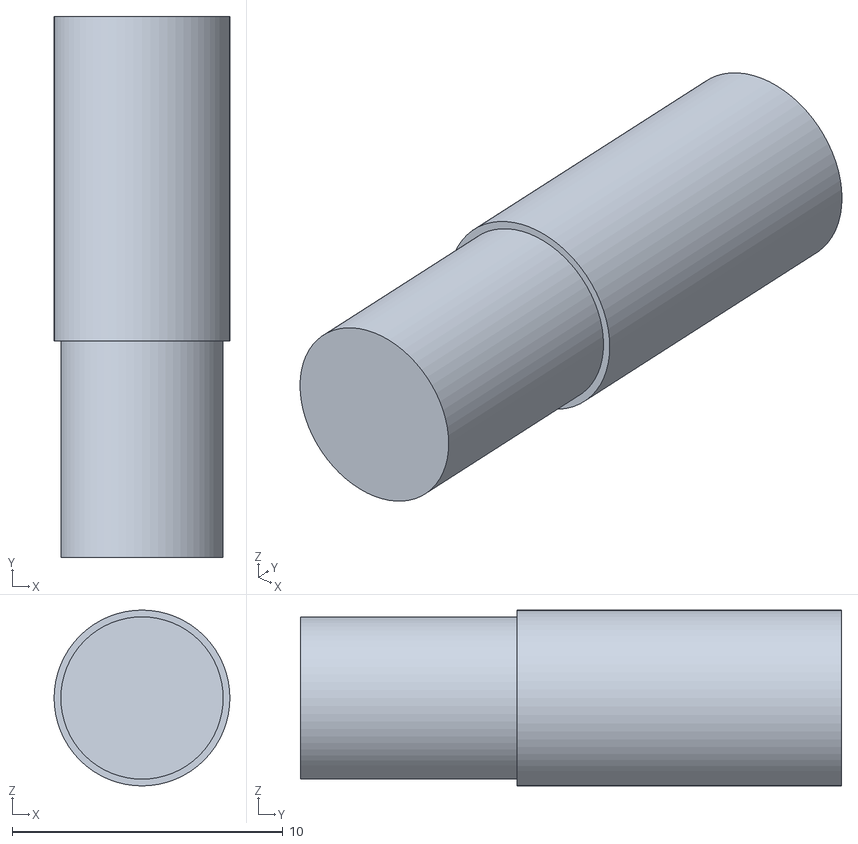
[picture p207: CAD file, 2026-10-02]
case/v2d_penahan_strip/_ref/ref_Plug_jack_AD8232.stl
6.50 x 20.0 x 6.50
