fathurraihan18/TA/case/komponen/esp32/esp32_pcb.stl

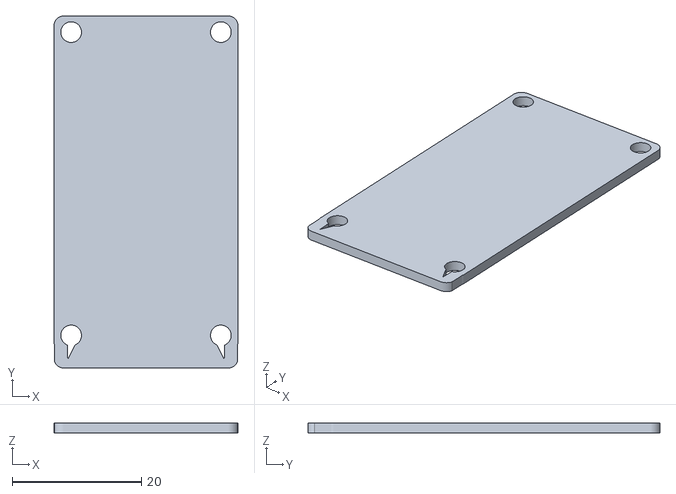
[picture p208: CAD file, 2026-10-02]
case/komponen/esp32/esp32_pcb.stl
28.5 x 54.6 x 1.60
