fathurraihan18/TA/case/v2d_penahan_strip/_ref/ref_Kaca_touch.stl

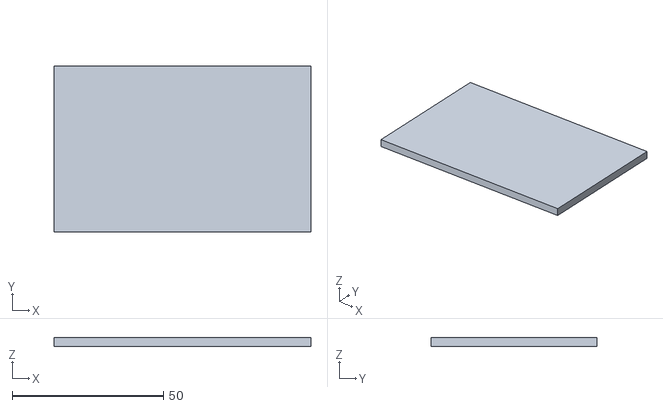
[picture p209: CAD file, 2026-10-02]
case/v2d_penahan_strip/_ref/ref_Kaca_touch.stl
85.0 x 55.0 x 3.00
