fathurraihan18/TA/case/komponen/esp32/esp32_tombol.stl

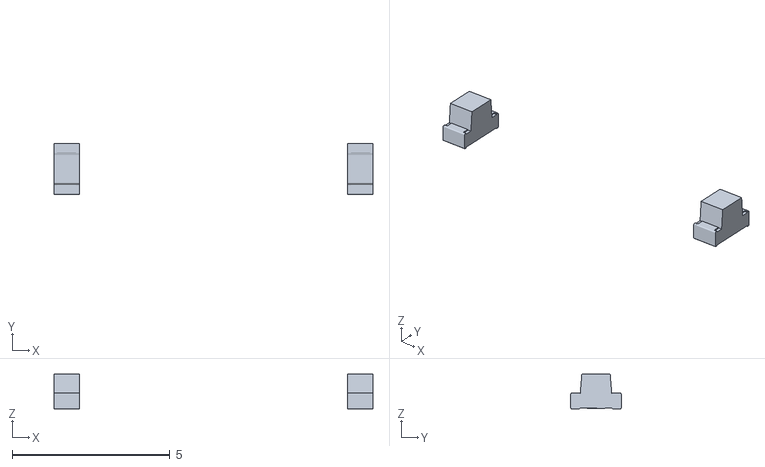
[picture p210: CAD file, 2026-10-02]
case/komponen/esp32/esp32_tombol.stl
10.1 x 1.60 x 1.10
