fathurraihan18/TA/case/komponen/esp32/esp32_perisai.stl

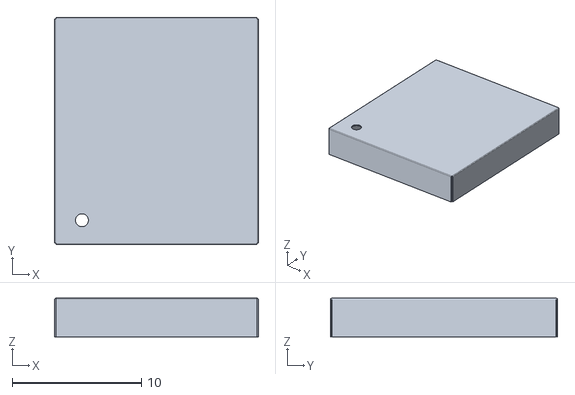
[picture p211: CAD file, 2026-10-02]
case/komponen/esp32/esp32_perisai.stl
15.8 x 17.6 x 3.00
