fathurraihan18/TA/case/v2d_penahan_strip/_ref/asm/ppg__ppg_cable4.stl

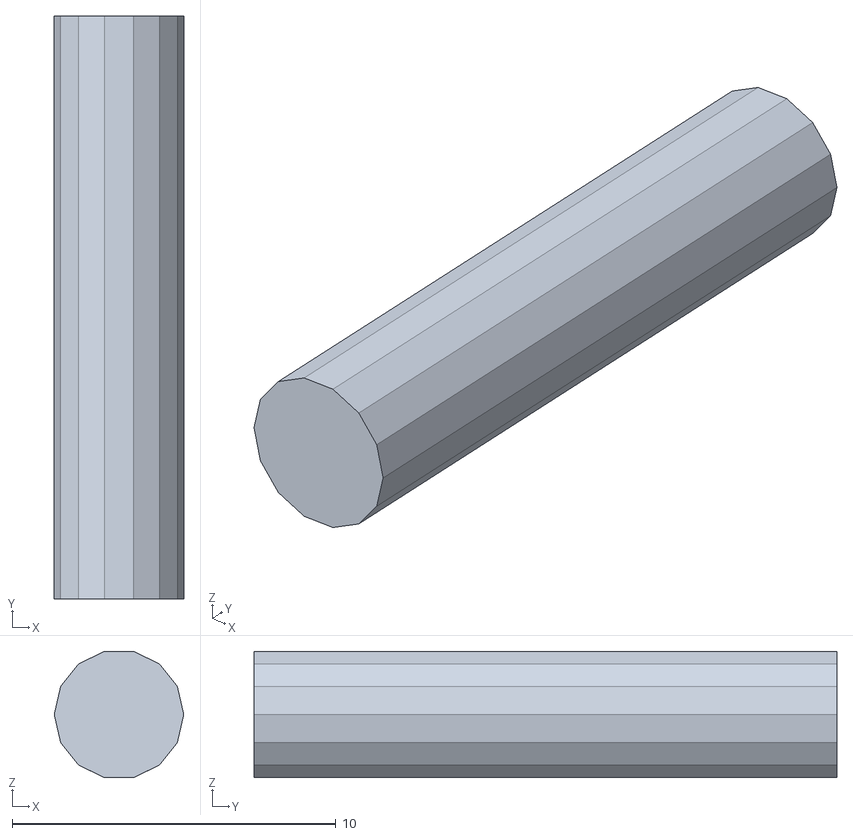
[picture p212: CAD file, 2026-10-02]
case/v2d_penahan_strip/_ref/asm/ppg__ppg_cable4.stl
4.00 x 18.0 x 3.90
