fathurraihan18/TA/case/komponen/esp32/esp32_modul_pcb.stl

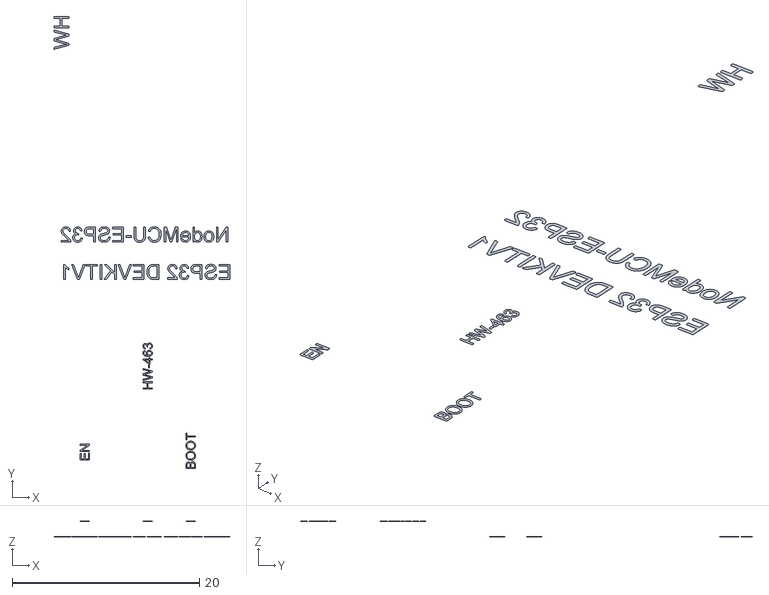
[picture p213: CAD file, 2026-10-02]
case/komponen/esp32/esp32_modul_pcb.stl
18.8 x 48.3 x 1.70
