fathurraihan18/TA/case/v2d_penahan_strip/_ref/asm/esp32__esp_pin.stl

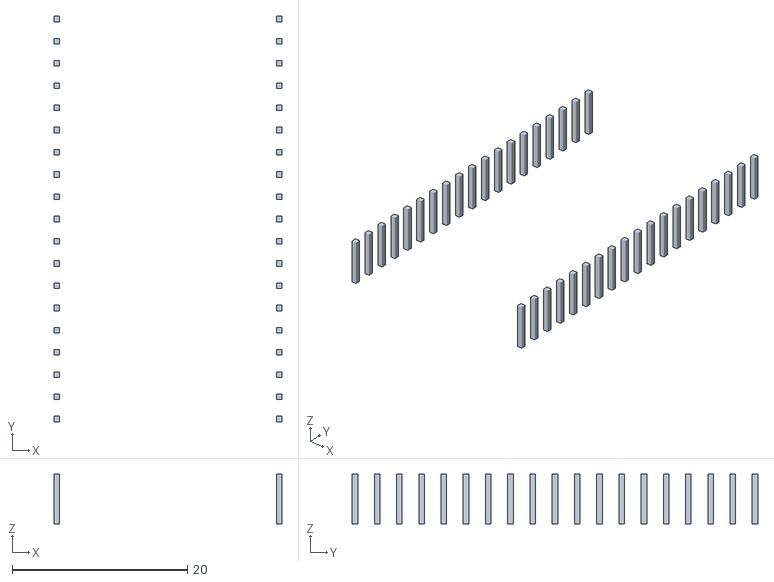
[picture p214: CAD file, 2026-10-02]
case/v2d_penahan_strip/_ref/asm/esp32__esp_pin.stl
26.1 x 46.4 x 5.70
