fathurraihan18/TA/case/v2d_penahan_strip/_ref/asm/ppg__clip_pegas.stl

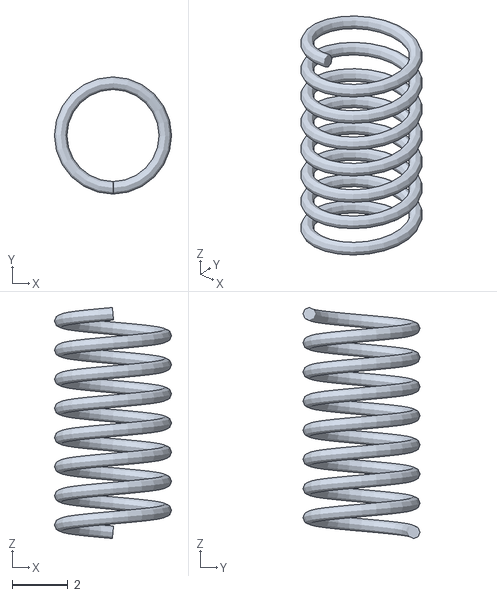
[picture p215: CAD file, 2026-10-02]
case/v2d_penahan_strip/_ref/asm/ppg__clip_pegas.stl
4.20 x 4.20 x 8.28
