fathurraihan18/TA/case/v2d_penahan_strip/_ref/asm/ppg__ppg_cable3.stl

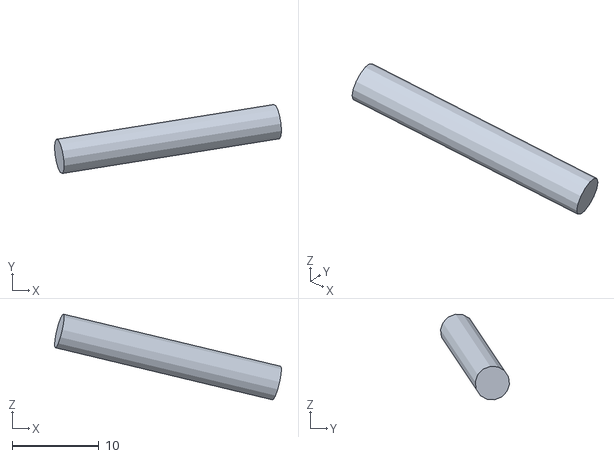
[picture p216: CAD file, 2026-10-02]
case/v2d_penahan_strip/_ref/asm/ppg__ppg_cable3.stl
26.1 x 7.93 x 9.84
