fathurraihan18/TA/case/v2d_penahan_strip/_ref/asm/tft__tft_hdr.stl

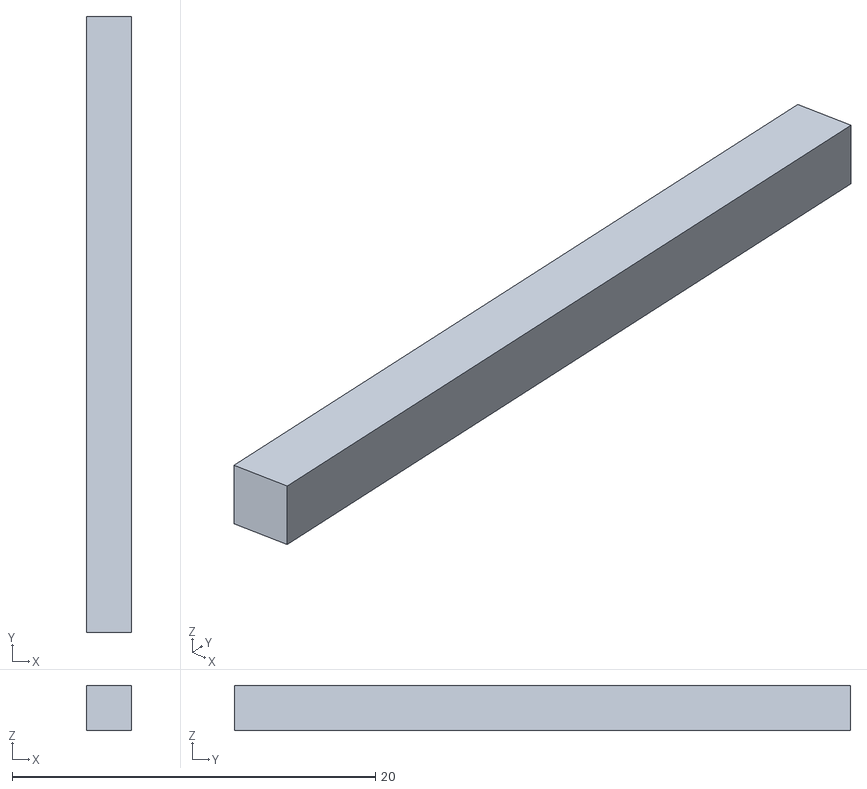
[picture p217: CAD file, 2026-10-02]
case/v2d_penahan_strip/_ref/asm/tft__tft_hdr.stl
2.50 x 33.9 x 2.50
