fathurraihan18/TA/case/v2d_penahan_strip/_ref/asm/kabel_el__kabel_el.stl

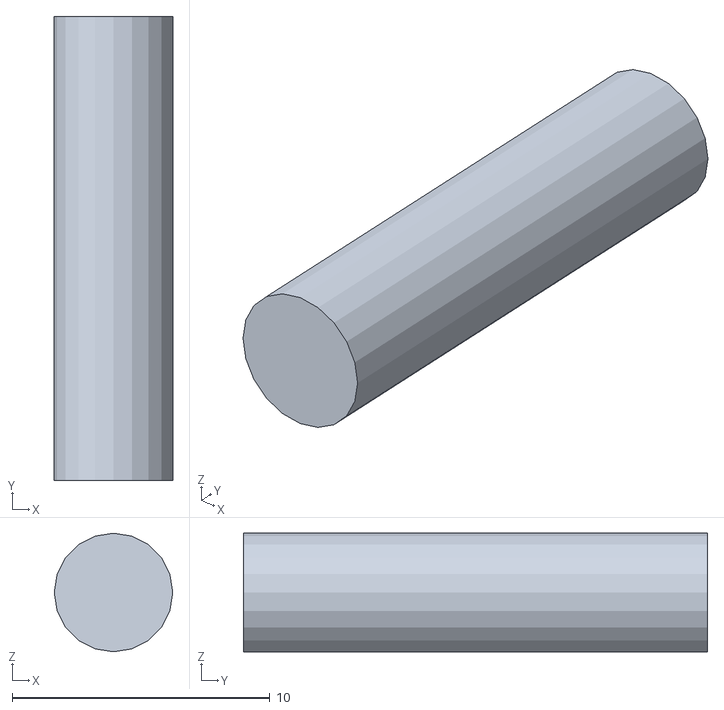
[picture p218: CAD file, 2026-10-02]
case/v2d_penahan_strip/_ref/asm/kabel_el__kabel_el.stl
4.60 x 18.0 x 4.60
