fathurraihan18/TA/case/v2d_penahan_strip/_ref/asm/standoff__standoff2.stl

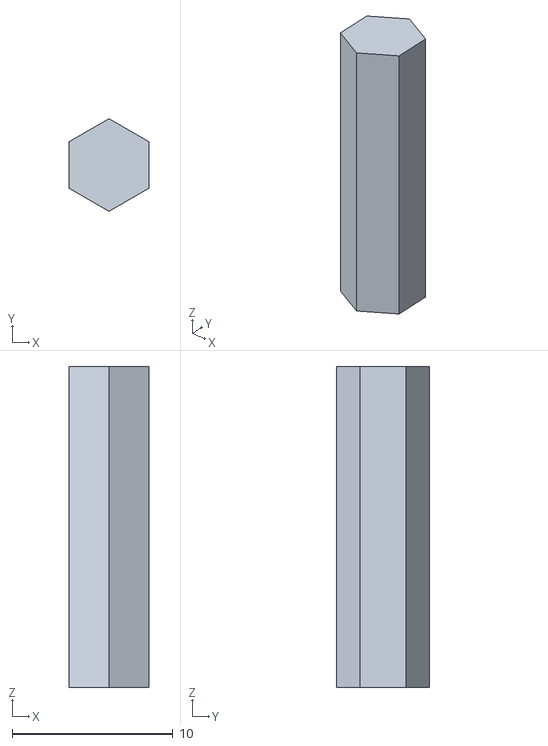
[picture p219: CAD file, 2026-10-02]
case/v2d_penahan_strip/_ref/asm/standoff__standoff2.stl
5.00 x 5.77 x 20.0
