fathurraihan18/TA/case/v2d_penahan_strip/_ref/asm/sekrup__scr_head0.stl

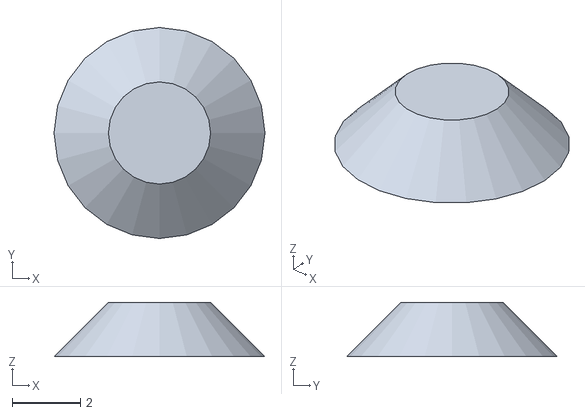
[picture p220: CAD file, 2026-10-02]
case/v2d_penahan_strip/_ref/asm/sekrup__scr_head0.stl
6.20 x 6.20 x 1.60
