fathurraihan18/TA/case/v2d_penahan_strip/_ref/asm/ppg__ppg_cable1.stl

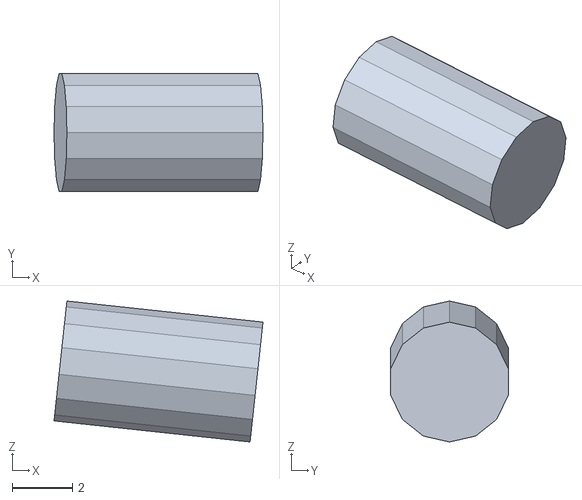
[picture p221: CAD file, 2026-10-02]
case/v2d_penahan_strip/_ref/asm/ppg__ppg_cable1.stl
6.93 x 3.90 x 4.68
