fathurraihan18/TA/case/v2d_penahan_strip/_ref/asm/tft__tft_sd.stl

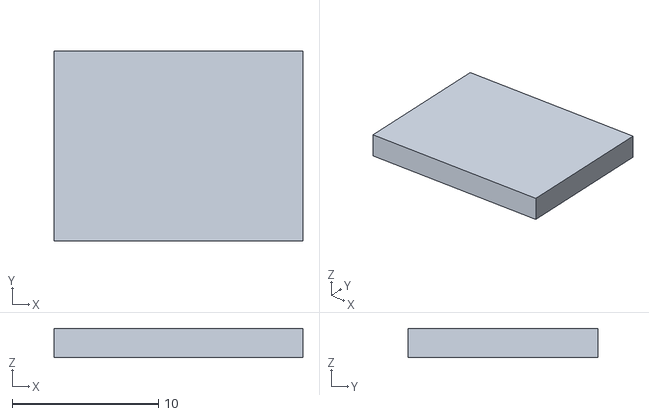
[picture p222: CAD file, 2026-10-02]
case/v2d_penahan_strip/_ref/asm/tft__tft_sd.stl
17.0 x 13.0 x 2.00
