fathurraihan18/TA/case/v2d_penahan_strip/_ref/asm/boost__bo_pcb.stl

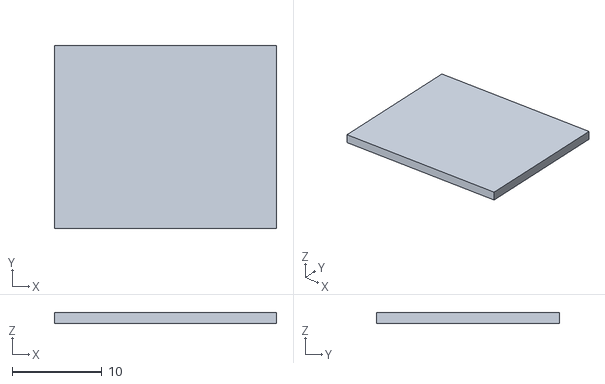
[picture p223: CAD file, 2026-10-02]
case/v2d_penahan_strip/_ref/asm/boost__bo_pcb.stl
24.7 x 20.4 x 1.20
