fathurraihan18/TA/case/v2d_penahan_strip/_ref/asm/kabel_el__snap0.stl

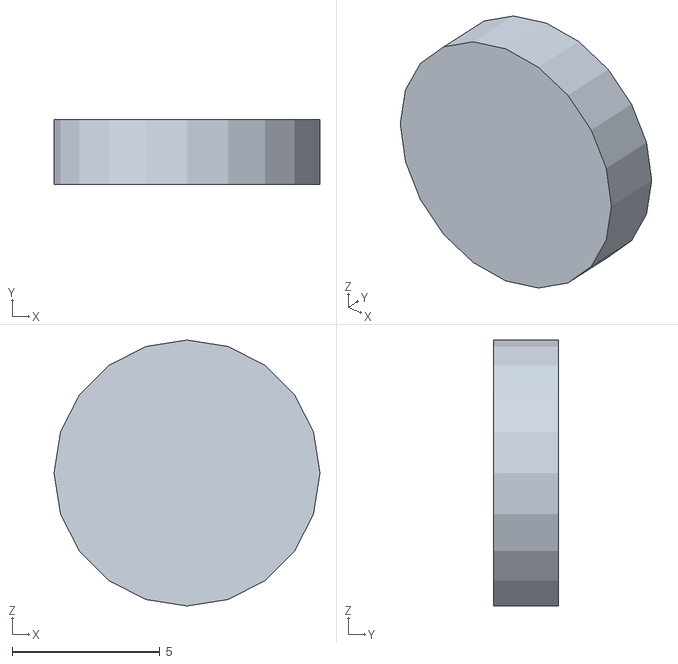
[picture p224: CAD file, 2026-10-02]
case/v2d_penahan_strip/_ref/asm/kabel_el__snap0.stl
9.00 x 2.20 x 9.00
