fathurraihan18/TA/case/v2d_penahan_strip/_ref/asm/kabel_el__plug_boot.stl

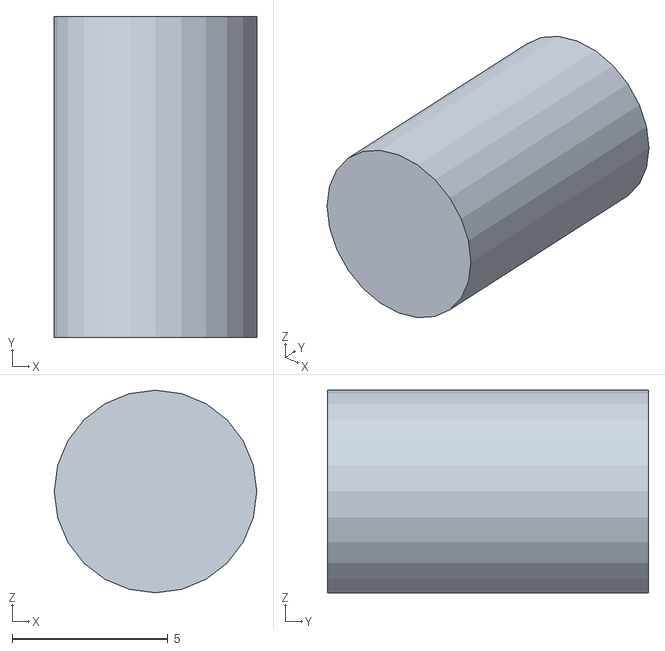
[picture p225: CAD file, 2026-10-02]
case/v2d_penahan_strip/_ref/asm/kabel_el__plug_boot.stl
6.50 x 10.3 x 6.50
