fathurraihan18/TA/case/v2d_penahan_strip/_ref/asm/boost__bo_ind.stl

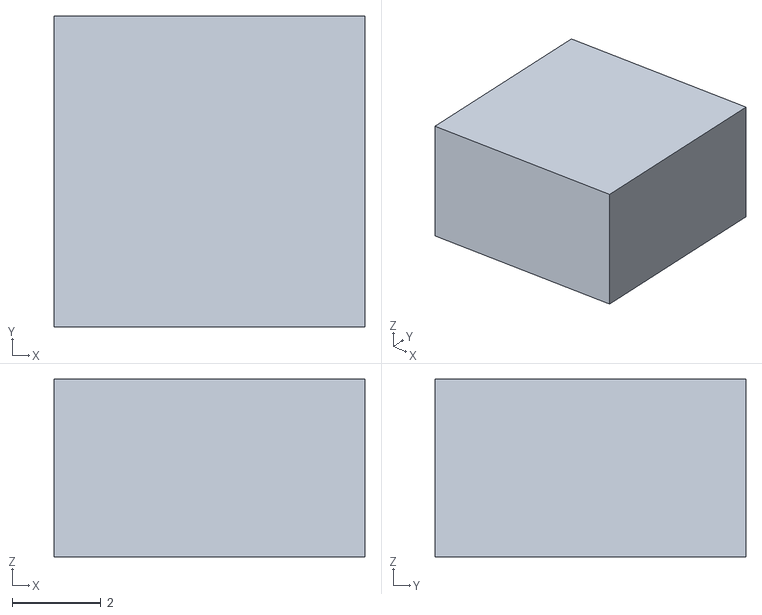
[picture p226: CAD file, 2026-10-02]
case/v2d_penahan_strip/_ref/asm/boost__bo_ind.stl
7.00 x 7.00 x 4.00
