fathurraihan18/TA/case/v2d_penahan_strip/_ref/asm/baterai__bat.stl

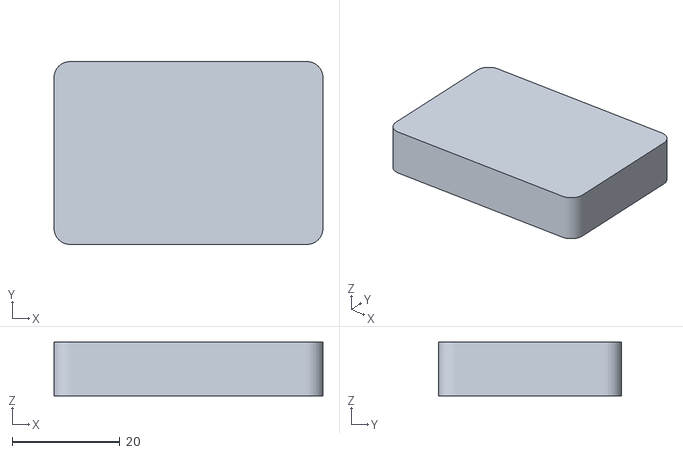
[picture p227: CAD file, 2026-10-02]
case/v2d_penahan_strip/_ref/asm/baterai__bat.stl
50.0 x 34.0 x 10.0
