fathurraihan18/TA/case/v2d_penahan_strip/_ref/asm/standoff__stud0.stl

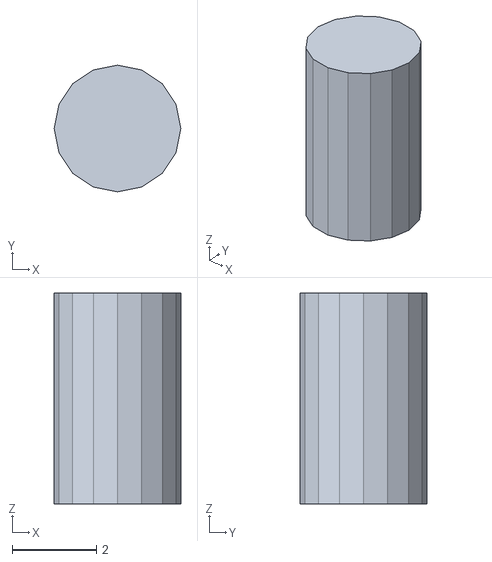
[picture p228: CAD file, 2026-10-02]
case/v2d_penahan_strip/_ref/asm/standoff__stud0.stl
3.00 x 3.00 x 5.00
