fathurraihan18/TA/case/v2d_penahan_strip/_ref/asm/baterai__bat_wire1.stl

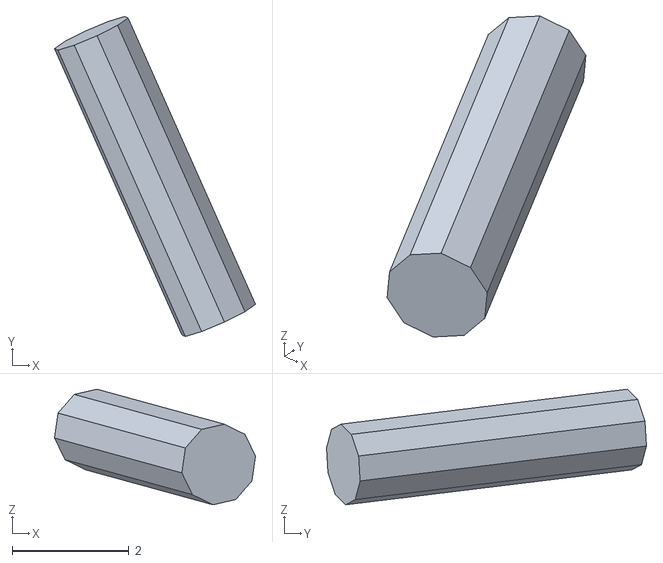
[picture p229: CAD file, 2026-10-02]
case/v2d_penahan_strip/_ref/asm/baterai__bat_wire1.stl
3.45 x 5.49 x 1.98
