fathurraihan18/TA/case/v2d_penahan_strip/_ref/asm/kabel_el__lead1.stl

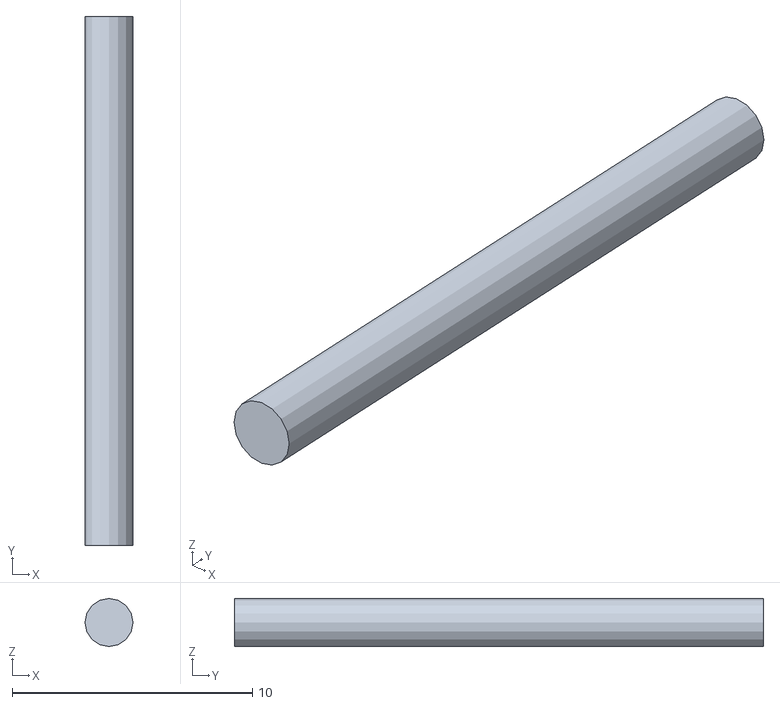
[picture p230: CAD file, 2026-10-02]
case/v2d_penahan_strip/_ref/asm/kabel_el__lead1.stl
2.00 x 22.0 x 2.00
