fathurraihan18/TA/case/v2d_penahan_strip/_ref/asm/gland__gl_thread.stl

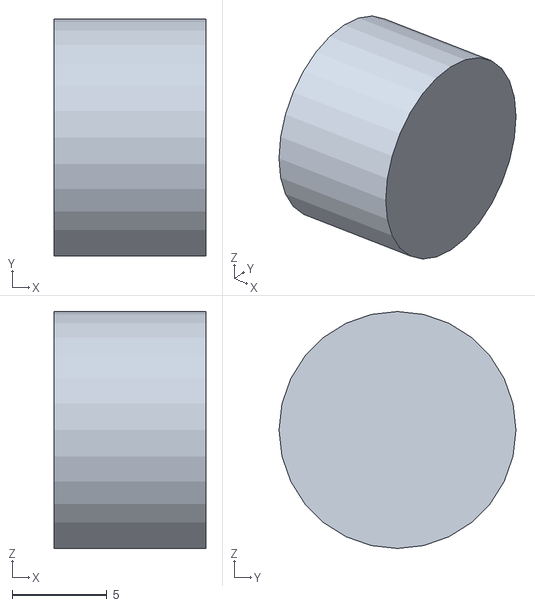
[picture p231: CAD file, 2026-10-02]
case/v2d_penahan_strip/_ref/asm/gland__gl_thread.stl
8.00 x 12.5 x 12.5
