fathurraihan18/TA/case/v2d_penahan_strip/_ref/asm/standoff__nut2.stl

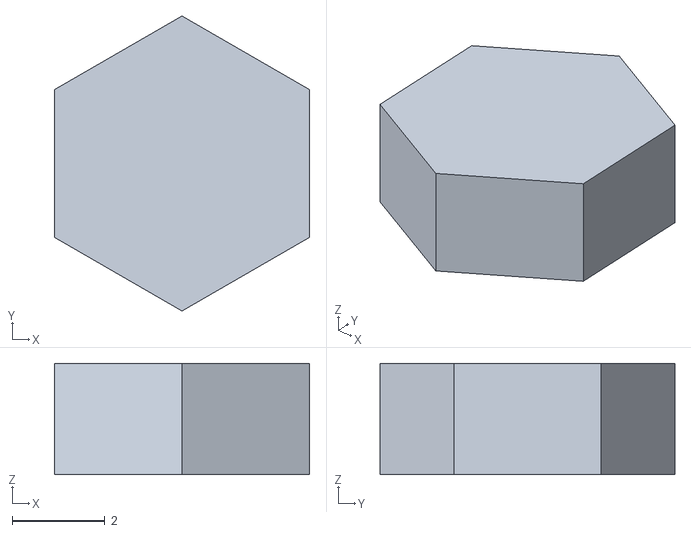
[picture p232: CAD file, 2026-10-02]
case/v2d_penahan_strip/_ref/asm/standoff__nut2.stl
5.50 x 6.35 x 2.40
