fathurraihan18/TA/case/v2d_penahan_strip/_ref/asm/pcb__socket.001.stl

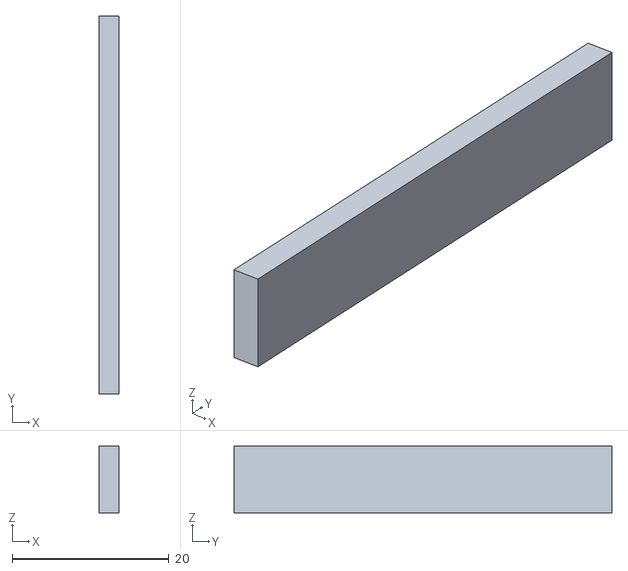
[picture p233: CAD file, 2026-10-02]
case/v2d_penahan_strip/_ref/asm/pcb__socket.001.stl
2.54 x 48.3 x 8.50
