fathurraihan18/TA/case/v2d_penahan_strip/_ref/asm/ppg__ppg_cable2.stl

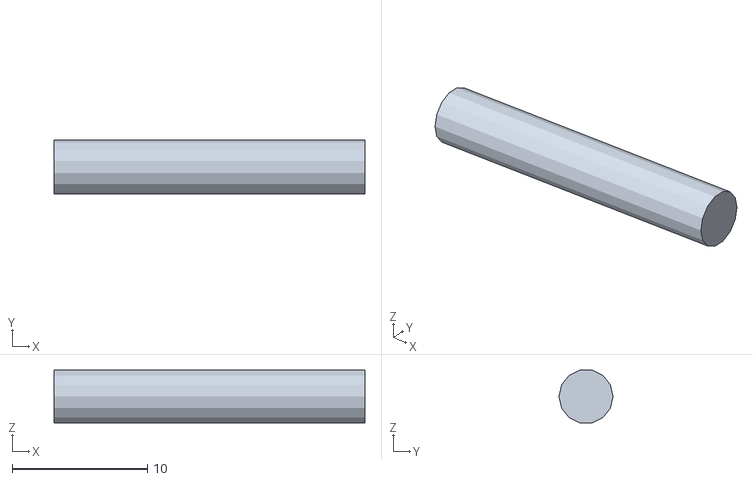
[picture p234: CAD file, 2026-10-02]
case/v2d_penahan_strip/_ref/asm/ppg__ppg_cable2.stl
23.0 x 4.00 x 3.90
