fathurraihan18/TA/case/v2d_penahan_strip/_ref/asm/saklar__sw_flange.stl

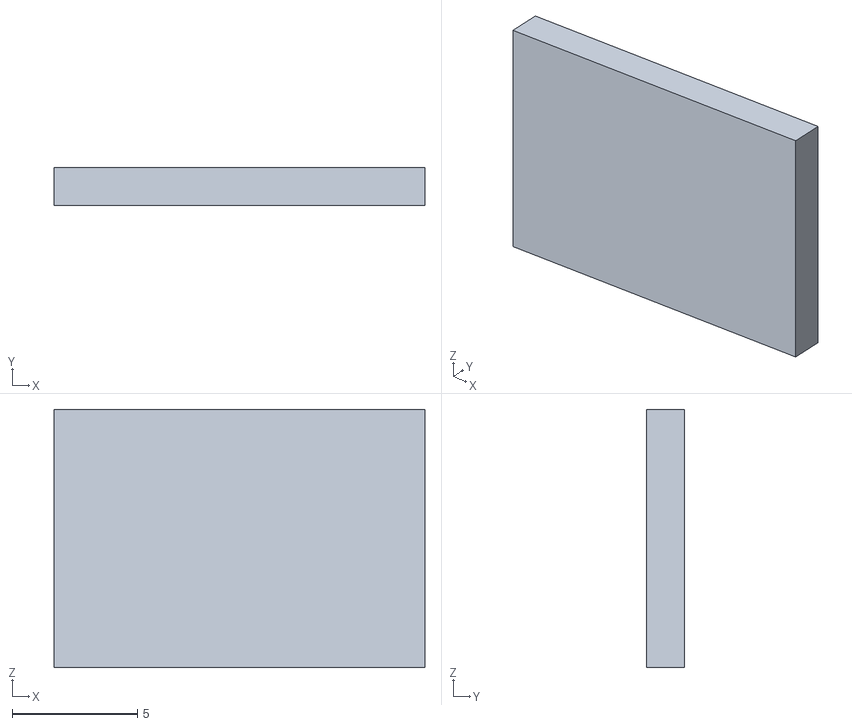
[picture p235: CAD file, 2026-10-02]
case/v2d_penahan_strip/_ref/asm/saklar__sw_flange.stl
14.8 x 1.50 x 10.3
