fathurraihan18/TA/case/v2d_penahan_strip/_ref/asm/sekrup__scr_shank2.stl

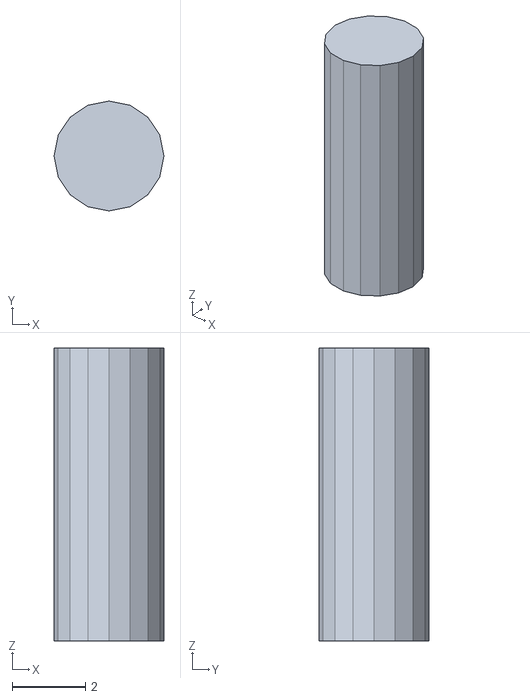
[picture p236: CAD file, 2026-10-02]
case/v2d_penahan_strip/_ref/asm/sekrup__scr_shank2.stl
3.00 x 3.00 x 8.00
