fathurraihan18/TA/case/v2d_penahan_strip/_ref/asm/baterai__bat_wire0.stl

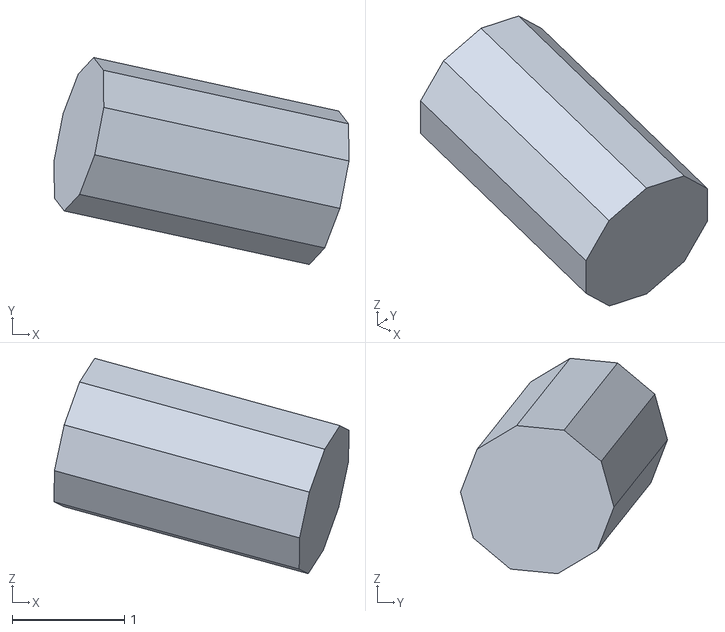
[picture p237: CAD file, 2026-10-02]
case/v2d_penahan_strip/_ref/asm/baterai__bat_wire0.stl
2.63 x 1.85 x 1.92
