fathurraihan18/TA/case/v2d_penahan_strip/_ref/asm/baterai__bat_tape.stl

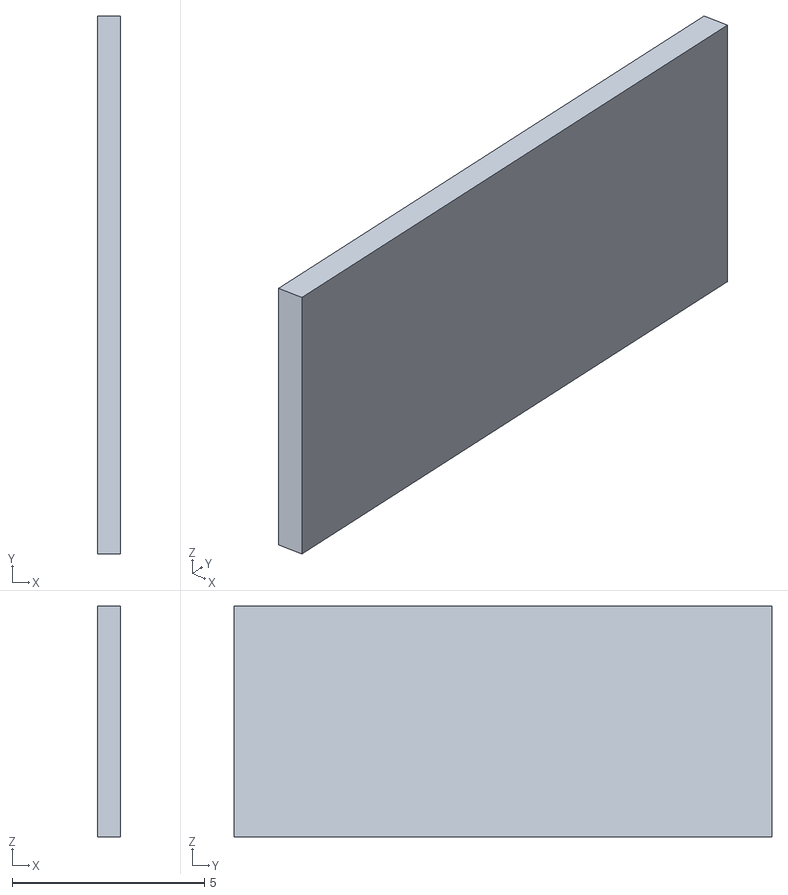
[picture p238: CAD file, 2026-10-02]
case/v2d_penahan_strip/_ref/asm/baterai__bat_tape.stl
0.6 x 14.0 x 6.00
