fathurraihan18/TA/case/v2d_penahan_strip/_ref/asm/ppg__ppg_conn.stl

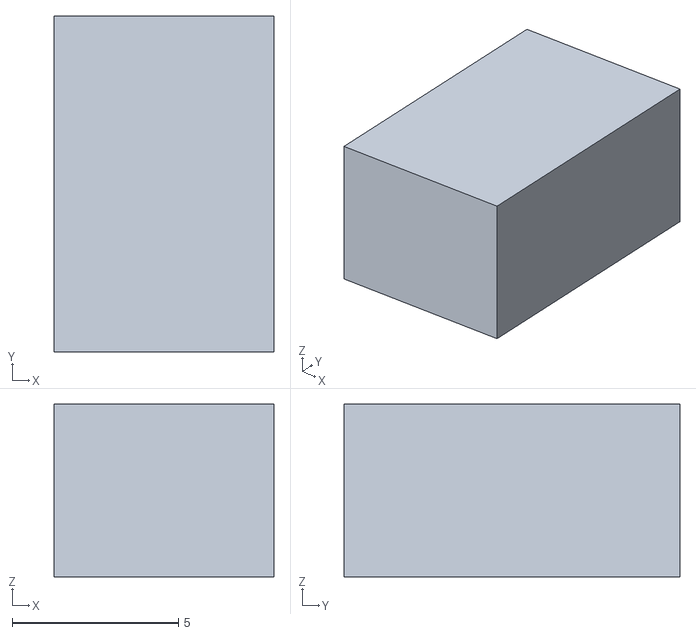
[picture p239: CAD file, 2026-10-02]
case/v2d_penahan_strip/_ref/asm/ppg__ppg_conn.stl
6.60 x 10.1 x 5.20
