fathurraihan18/TA/case/v2d_penahan_strip/_ref/asm/pcb__jst_sw.stl

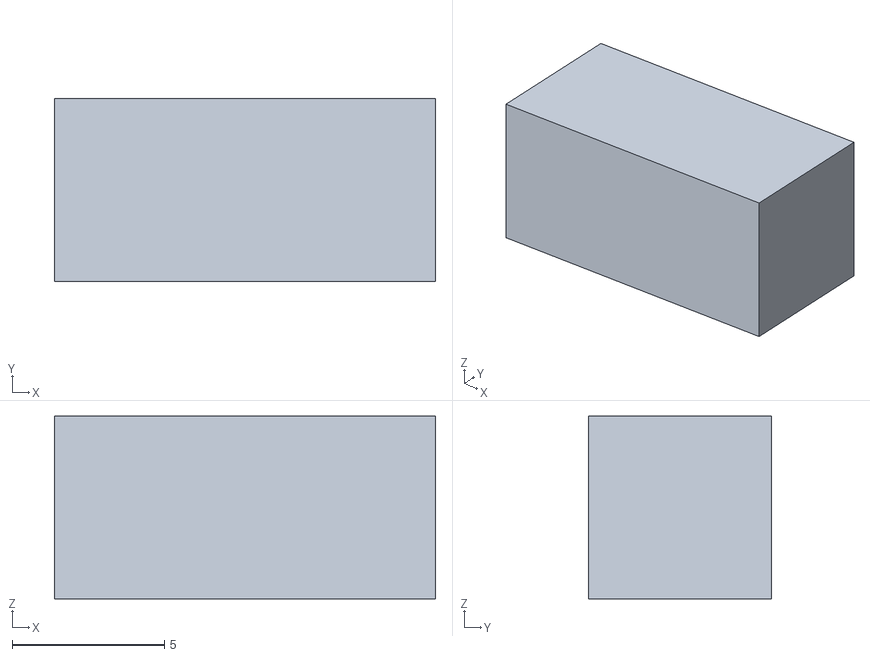
[picture p240: CAD file, 2026-10-02]
case/v2d_penahan_strip/_ref/asm/pcb__jst_sw.stl
12.5 x 6.00 x 6.00
