fathurraihan18/TA/case/v2d_penahan_strip/_ref/asm/pcb__pads_ad.stl

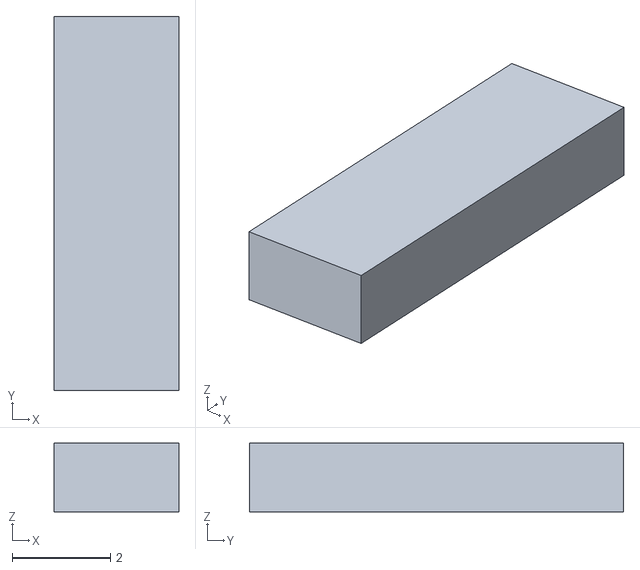
[picture p241: CAD file, 2026-10-02]
case/v2d_penahan_strip/_ref/asm/pcb__pads_ad.stl
2.54 x 7.62 x 1.40
