fathurraihan18/TA/case/v2d_penahan_strip/_ref/asm/kabel_el__lead0.stl

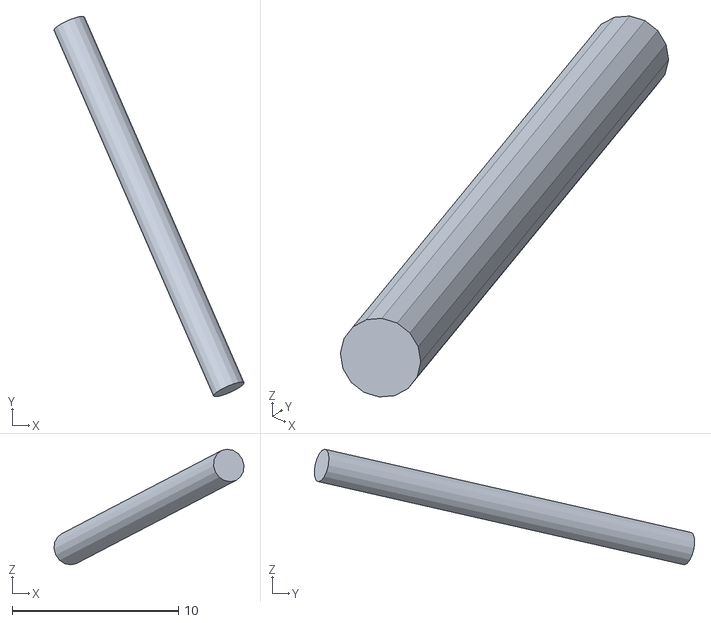
[picture p242: CAD file, 2026-10-02]
case/v2d_penahan_strip/_ref/asm/kabel_el__lead0.stl
11.4 x 22.9 x 6.96
