fathurraihan18/TA/case/v2d_penahan_strip/_ref/asm/boost__bo_usbc.stl

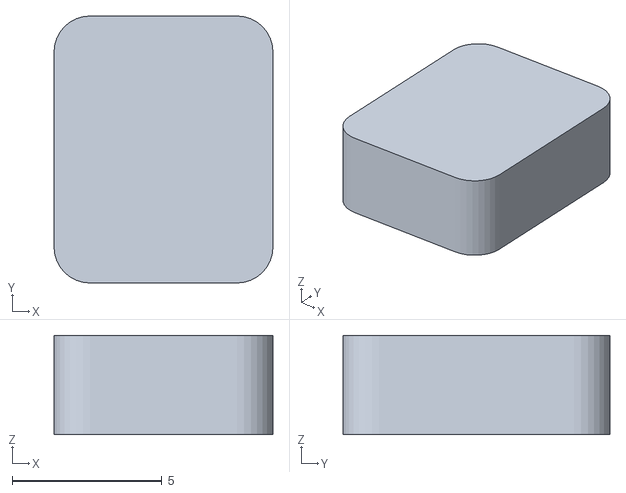
[picture p243: CAD file, 2026-10-02]
case/v2d_penahan_strip/_ref/asm/boost__bo_usbc.stl
7.30 x 8.90 x 3.30
