fathurraihan18/TA/case/v2d_penahan_strip/_ref/asm/ppg__ppg_pcb.stl

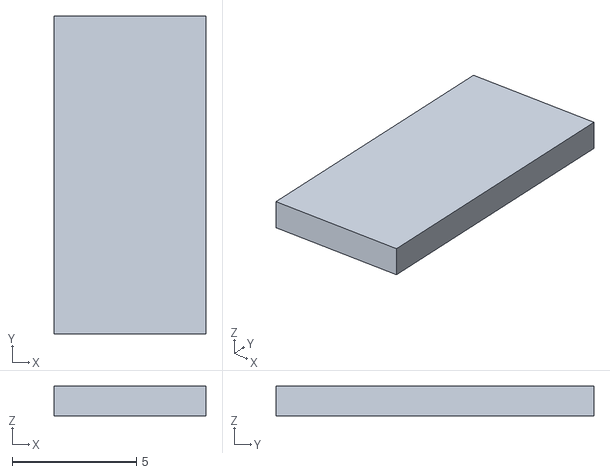
[picture p244: CAD file, 2026-10-02]
case/v2d_penahan_strip/_ref/asm/ppg__ppg_pcb.stl
6.10 x 12.8 x 1.20
