fathurraihan18/TA/case/v2d_penahan_strip/_ref/asm/boost__bo_cap.stl

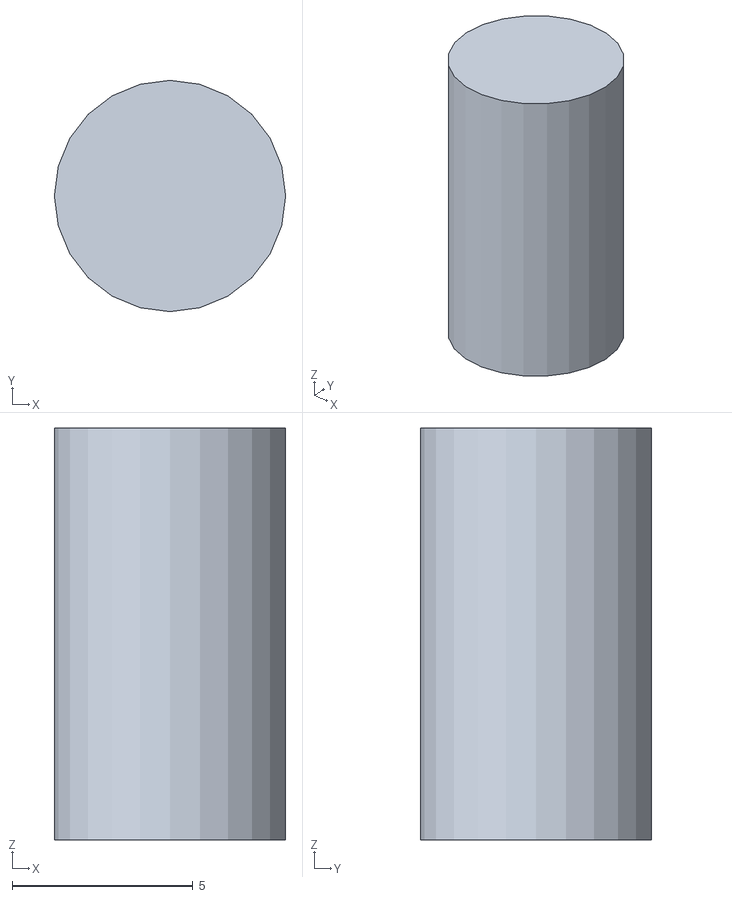
[picture p245: CAD file, 2026-10-02]
case/v2d_penahan_strip/_ref/asm/boost__bo_cap.stl
6.40 x 6.40 x 11.4
