fathurraihan18/TA/case/v2d_penahan_strip/_ref/asm/saklar__sw_rocker.stl

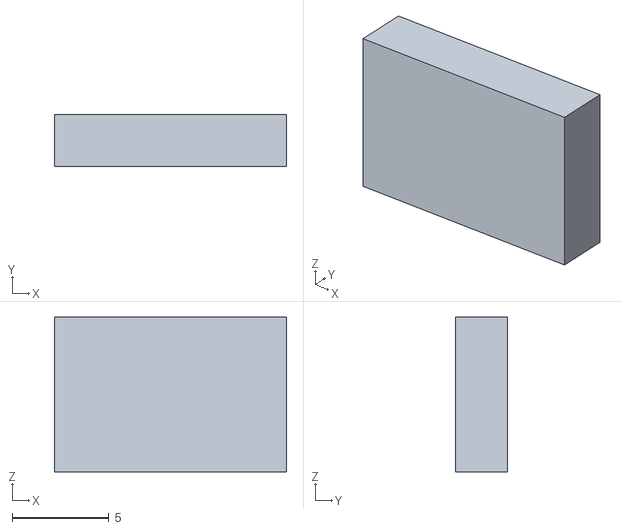
[picture p246: CAD file, 2026-10-02]
case/v2d_penahan_strip/_ref/asm/saklar__sw_rocker.stl
12.0 x 2.70 x 8.00
