fathurraihan18/TA/case/v2d_penahan_strip/_ref/asm/gland__gl_dome.stl

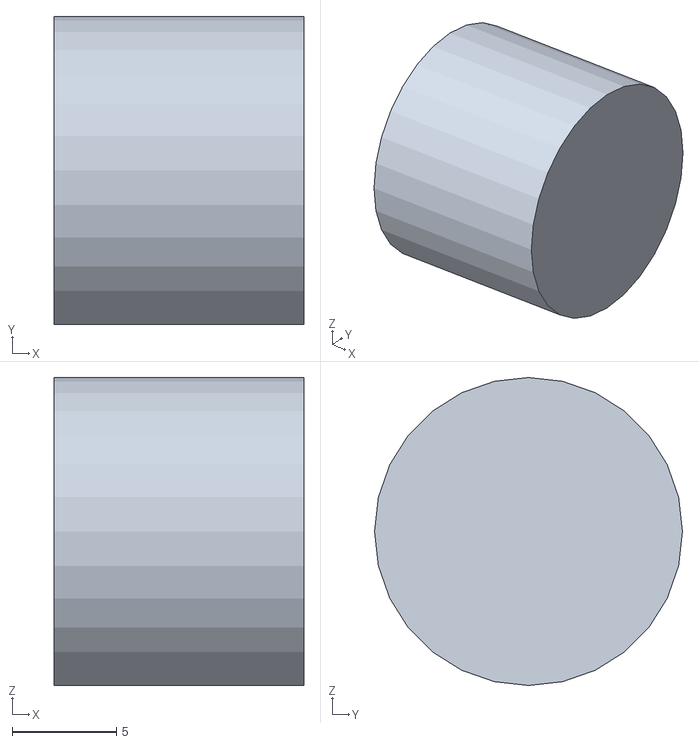
[picture p247: CAD file, 2026-10-02]
case/v2d_penahan_strip/_ref/asm/gland__gl_dome.stl
12.0 x 14.8 x 14.8
