fathurraihan18/TA/case/v2d_penahan_strip/_ref/asm/baterai__bat_label.stl

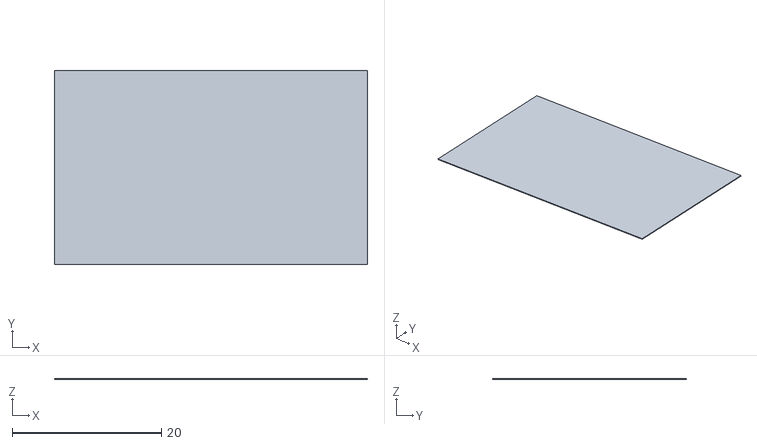
[picture p248: CAD file, 2026-10-02]
case/v2d_penahan_strip/_ref/asm/baterai__bat_label.stl
42.0 x 26.0 x 0.12
