fathurraihan18/TA/case/v2d_penahan_strip/_ref/asm/gland__gl_hex.stl

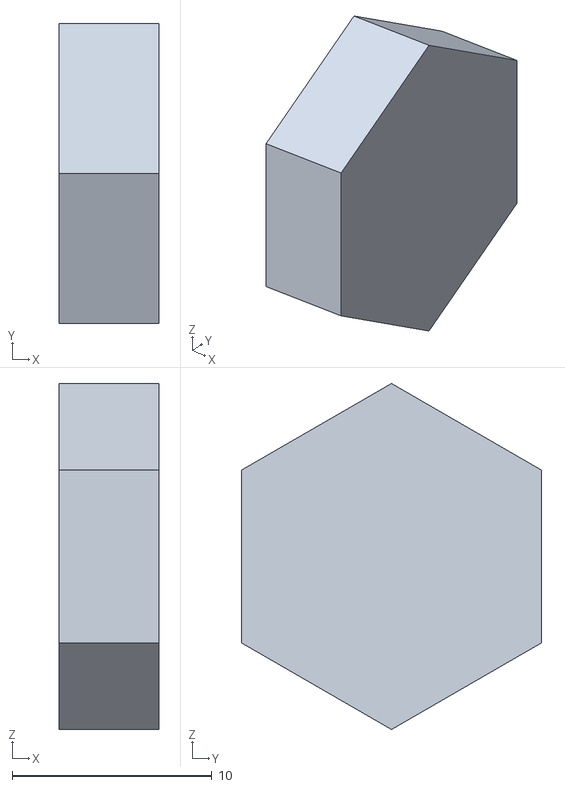
[picture p249: CAD file, 2026-10-02]
case/v2d_penahan_strip/_ref/asm/gland__gl_hex.stl
5.00 x 15.0 x 17.3
