fathurraihan18/TA/case/v2d_penahan_strip/_ref/asm/baterai__bat_jst.stl

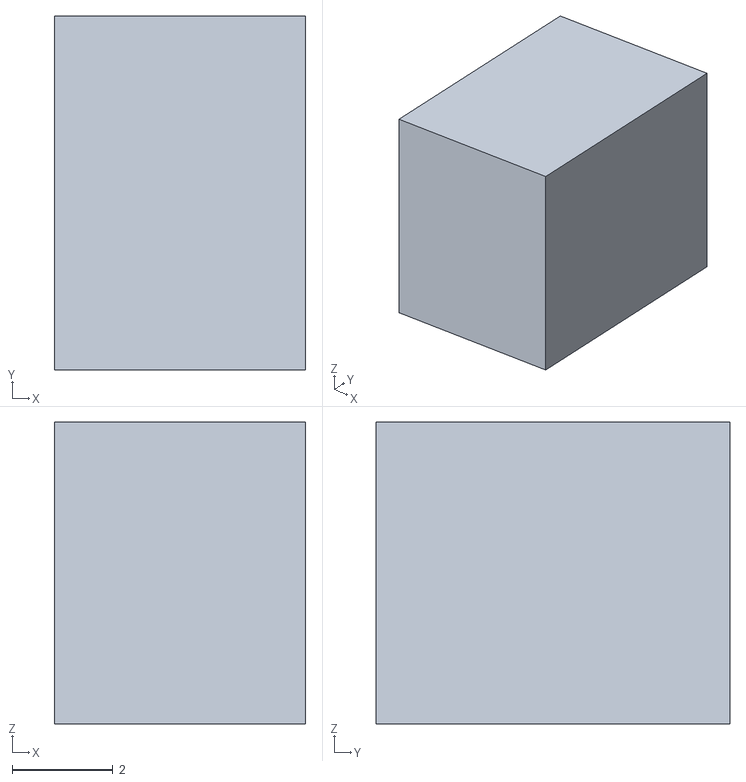
[picture p250: CAD file, 2026-10-02]
case/v2d_penahan_strip/_ref/asm/baterai__bat_jst.stl
5.00 x 7.04 x 6.00
