fathurraihan18/TA/(list of files, cad)

Other CAD files:
case/v3c_penahan_sekrup/3_Penahan_Sekrup_x4_siap_cetak.stl
case/komponen/esp32/esp32_smd_d.stl
case/v2d_penahan_strip/_ref/shell_design.stl
case/FINAL_TA/07_STL_siap_cetak/Klip_PPG/A_RahangBawah_siap_cetak.stl
case/v2b_sekrup_samping/perbaikan_v2_tercetak/jig_bor_BAWAH.stl
case/komponen/hw605/hw605_jendela.stl
case/v2d_penahan_strip/_ref/plate_design.stl
case/FINAL_TA/_render/bagian/sw_kaki1.stl
case/v2d_penahan_strip/_ref/asm/ppg__clip_C.stl
case/komponen/esp32/esp32_strip.stl
case/sensor_ppg/klip_v2/_ref/B_desain.stl
case/v2d_penahan_strip/_ref/asm/esp32__esp_lain.stl
case/sensor_ppg/klip_v2/_ref/C_desain.stl
case/v2d_penahan_strip/_ref/asm/esp32__esp_smd_b.stl
case/sensor_ppg/klip_v2/_ref/ref_Sekrup_engsel.stl
case/v2d_penahan_strip/_ref/asm/ppg__clip_B.stl
case/v2d_penahan_strip/_ref/asm/ppg__clip_hw605_ic.stl
case/v2d_penahan_strip/_ref/asm/ppg__clip_A.stl
case/v2d_penahan_strip/_ref/asm/esp32__esp_smd_a.stl
case/v2d_penahan_strip/_ref/asm/esp32__esp_modul_pcb.stl
case/v2d_penahan_strip/_ref/asm/ad8232__ad_PCB_Re1.stl
case/v2d_penahan_strip/_ref/asm/ad8232__ad_Dark_Chips_002.stl
case/v2d_penahan_strip/_ref/asm/esp32__esp_pcb.stl
case/v2d_penahan_strip/_ref/asm/esp32__esp_perisai.stl
case/v2d_penahan_strip/_ref/asm/ppg__clip_hw605_smd.stl
case/v2d_penahan_strip/_ref/asm/esp32__esp_tombol.stl
case/v2d_penahan_strip/_ref/asm/esp32__esp_usb_slot.stl
case/v2d_penahan_strip/_ref/asm/esp32__esp_usb.stl
case/v2d_penahan_strip/_ref/asm/ppg__clip_hw605_pcb.stl
case/v2d_penahan_strip/_ref/asm/ad8232__ad_Metal_002.stl
case/v2d_penahan_strip/_ref/asm/esp32__esp_teks_perisai.stl
case/v2d_penahan_strip/_ref/asm/ppg__clip_hw605_pad.stl
case/v2d_penahan_strip/_ref/asm/sekrup__scr_head1.stl
case/v2d_penahan_strip/_ref/asm/sekrup__scr_head3.stl
case/v2d_penahan_strip/_ref/asm/saklar__sw_t1.stl
case/v2d_penahan_strip/_ref/asm/saklar__sw_t2.stl
case/v2d_penahan_strip/_ref/asm/standoff__standoff1.stl
case/v2d_penahan_strip/_ref/asm/standoff__stud2.stl
case/v2d_penahan_strip/_ref/asm/standoff__nut3.stl
case/v2d_penahan_strip/_ref/asm/sekrup__scr_shank3.stl
case/v2d_penahan_strip/_ref/asm/sekrup__scr_shank1.stl
case/v2d_penahan_strip/_ref/asm/sekrup__scr_shank0.stl
case/v2d_penahan_strip/_ref/asm/standoff__stud1.stl
case/v2d_penahan_strip/_ref/asm/pcb__socket.stl
case/v2d_penahan_strip/_ref/asm/standoff__nut1.stl
case/v2d_penahan_strip/_ref/asm/tft__tft_glass.stl
case/v2d_penahan_strip/_ref/asm/kabel_el__snap1.stl
case/v2d_penahan_strip/_ref/asm/standoff__stud3.stl
case/v2d_penahan_strip/_ref/asm/kabel_el__lead2.stl
case/ECG_PPG_Cover.blend
case/sensor_ppg/klip_v2/Klip_PPG.blend
case/v2b_sekrup_samping/1_Shell_Depan_siap_cetak.stl
case/v2b_sekrup_samping/2_BackPlate_siap_cetak.stl
case/v2b_sekrup_samping/ECG_PPG_Cover.blend
case/v2d_penahan_strip/ECG_PPG_Cover.blend
case/v2d_penahan_strip/_ref/asm/boost__bo_ic.stl
case/v2d_penahan_strip/_ref/asm/gland__gl_nut.stl
case/v2d_penahan_strip/_ref/asm/kabel_el__snap2.stl
case/v2d_penahan_strip/_ref/asm/pcb__hdr_ad.stl
case/v2d_penahan_strip/_ref/asm/pcb__pcb.stl
case/v2d_penahan_strip/_ref/asm/saklar__sw_body.stl
case/v2d_penahan_strip/_ref/asm/sekrup__scr_head2.stl
case/v2d_penahan_strip/_ref/asm/standoff__nut0.stl
case/v2d_penahan_strip/_ref/asm/standoff__standoff0.stl
case/v2d_penahan_strip/_ref/asm/standoff__standoff3.stl
case/v2d_penahan_strip/_ref/asm/tft__tft_pcb.stl
case/v2d_penahan_strip/_ref/asm/tft__tft_screw.001.stl
case/v2d_penahan_strip/_ref/asm/tft__tft_screw.002.stl
case/v2d_penahan_strip/_ref/asm/tft__tft_screw.003.stl
case/v2d_penahan_strip/_ref/asm/tft__tft_screw.stl
case/v3_baterai/1_Shell_Depan_siap_cetak.stl
case/v3_baterai/ECG_PPG_Cover.blend
case/v3b_sekrup_samping/1_Shell_Depan_siap_cetak.stl
case/v3b_sekrup_samping/2_BackPlate_siap_cetak.stl
case/v3b_sekrup_samping/ECG_PPG_Cover.blend
