fathurraihan18/TA/case/sensor_ppg/klip_v2/hasil_verifikasi.txt

=== 1. Integritas mesh ===
[OK ] A watertight | volume 11978 mm3 | bbox [67.0, 26.0, 19.4] | badan 1
[OK ] B watertight | volume 10017 mm3 | bbox [67.0, 26.0, 17.5] | badan 1
[OK ] C watertight | volume 2149 mm3 | bbox [51.1, 21.5, 3.3] | badan 1
[OK ] D watertight | volume 17 mm3 | bbox [5.6, 5.6, 1.0] | badan 1
[OK ] A satu badan utuh 
[OK ] B satu badan utuh 
[OK ] C satu badan utuh 
[OK ] D satu badan utuh 

=== 2. Kecocokan pada posisi nominal (jari terpasang) ===
[OK ] rahang A dan B tidak saling menembus (0.000 mm3)
[OK ] tutup C: hanya 8 rusuk gesek yang menekan alur A (tahan tutup, bisa dicungkil) (irisan 7.9 mm3, perkiraan 7.9 mm3)
[OK ] tutup C tidak menyentuh B (0.000 mm3)
[OK ] Modul_HW605 muat di rongga A (irisan A/B/C = 0) (A 0.128, C 0.000, B 0.000 mm3)
[OK ] Kawat_bundel muat di rongga A (irisan A/B/C = 0) (A 0.000, C 0.000, B 0.000 mm3)
[OK ] kabel 4 inti lewat terowongan dan leher A tanpa tabrakan (A 0.000, B 0.000 mm3)
      rib penjepit di tutup menekan jaket kabel: irisan 3.49 mm3 (sengaja, kabel empuk)
      sekrup engsel: irisan dengan A 3.5 mm3 (ulir mengulir sendiri di lug pilot), dengan B 0.000 mm3
[OK ] sekrup lewat lug +Y dan tab B tanpa tabrakan (lubang 3,2 mm) 
      jarak min modul HW-605 ke dinding A = 0.00 mm (tutup C menopang dari bawah)
      puncak sensor Z=-8.30; permukaan bantalan Z=-7.50 -> sensor masuk 0.80 mm

=== 3. Gerak engsel: B diputar terhadap A (theta<0 = menutup, theta>0 = membuka) ===
      theta:volume irisan A/B (mm3) -> -14:544 -13:438 -12:339 -11:248 -10:166 -9:97 -8:42 -7:8 -6:0 -4:0 -2:0 0:0 4:0 8:0 12:0 16:0 17:3 18:15 19:37 20:68
      kontak penutupan pertama pada theta = -7 derajat (bibir B menyentuh bibir A); kontak pembukaan pada theta = 17 derajat
[OK ] rentang gerak bebas tabrakan -(5) ... +(10) derajat 
      theta=0 : jarak bantalan di sensor = 15.0 mm
      theta=-3 : jarak bantalan di pusat sensor ~ 13.7 mm
      theta=+0 : jarak bantalan di pusat sensor ~ 15.0 mm
      theta=+5 : jarak bantalan di pusat sensor ~ 17.1 mm
      theta=+10 : jarak bantalan di pusat sensor ~ 19.2 mm

=== 4. Pegas dan gaya jepit pada jari ===
      pegas: OD 4.2 mm, kawat 0.45 mm, L0 12.0 mm, k = 1.28 N/mm (perkiraan, ukur pegas Anda)
      dudukan 1 (Ls=9 mm, kantong 1.8 mm): 0 shim: 2.0 N (tekan 4.2 mm) | 1 shim: 2.5 N (tekan 5.2 mm) | 2 shim: 3.0 N (tekan 6.2 mm)
      dudukan 2 (Ls=14 mm, kantong 1.3 mm): 0 shim: 3.5 N (tekan 4.7 mm) | 1 shim: 4.2 N (tekan 5.7 mm) | 2 shim: 5.0 N (tekan 6.7 mm)
      tabel gaya jepit nominal (N), L0 = 12 mm:  k(N/mm) : dudukan1 [0,1,2 shim] | dudukan2 [0,1,2 shim]
        k=0.4: 0.6 0.8 0.9   |   1.1 1.3 1.6
        k=0.7: 1.1 1.4 1.6   |   1.9 2.3 2.7
        k=1.0: 1.6 1.9 2.3   |   2.7 3.3 3.9
        k=1.3: 2.0 2.5 3.0   |   3.6 4.3 5.1
        k=1.6: 2.5 3.1 3.7   |   4.4 5.3 6.2
        k=2.0: 3.1 3.9 4.6   |   5.5 6.6 7.8
[OK ] pegas selalu tertekan pada seluruh rentang gerak (jari 12-20 mm) 
[OK ] gaya jepit nominal 1-5 N pada kedua dudukan (pegas perkiraan) (2.0 N / 3.5 N)

=== 5. Jari telunjuk (17 x 14 mm) di dalam rahang (informasi) ===
      irisan jari-A 73 mm3 (ujung jari membulat bertumpu pada bahu), jari-B 0 mm3 (nol = ada celah ke busa/bibir)
      jarak min jari ke B 0.50 mm; ke A 0.00 mm

=== 6. Fitur tipis dan overhang pada orientasi cetak ===
[OK ] A: tidak ada fitur tipis (< 0,9 mm) (0 potongan)
      A: 9 area overhang > 45 derajat (luas mm2, datar=jembatan, bbox-min, ukuran):
          (535.0, True, [13.0, -10.6, 2.0], [51.3, 21.2, 0.0])
          (347.6, False, [0.0, -13.0, 0.0], [67.0, 26.0, 1.4])
          (230.0, False, [30.4, -11.0, 6.0], [36.6, 13.6, 1.5])
          (192.7, True, [15.1, -9.2, 4.4], [13.9, 18.4, 0.0])
          (59.4, True, [53.4, -10.6, 2.0], [10.9, 8.0, 0.0])
          (53.5, True, [25.4, -5.2, 6.0], [10.2, 10.4, 0.0])
          (16.0, True, [9.8, -3.2, 1.4], [3.2, 6.4, 0.0])
          (7.7, False, [44.9, 3.3, 14.6], [2.3, 2.4, 1.1])
[OK ] B: tidak ada fitur tipis (< 0,9 mm) (0 potongan)
      B: 2 area overhang > 45 derajat (luas mm2, datar=jembatan, bbox-min, ukuran):
          (347.3, False, [-67.0, -13.0, -0.0], [67.0, 26.0, 1.4])
          (15.1, False, [-47.1, -3.0, 12.6], [2.3, 6.0, 0.5])
[OK ] C: tidak ada fitur tipis (< 0,9 mm) (0 potongan)
      C: 1 area overhang > 45 derajat (luas mm2, datar=jembatan, bbox-min, ukuran):
          (25.0, True, [13.1, -4.0, 0.9], [4.0, 8.0, 0.0])

=== 7. Estimasi massa (PLA 1,24 g/cm3, perimeter 3 + infill 25 % ~ 60 % volume) ===
      A: 11.98 cm3 -> sekitar 8.9 g
      B: 10.02 cm3 -> sekitar 7.5 g
      C: 2.15 cm3 -> sekitar 1.6 g
      D: 0.02 cm3 -> sekitar 0.1 g (x4)
      total klip: sekitar 18 g (tanpa kabel, pegas, sekrup)

HASIL AKHIR: SEMUA LOLOS
