fathurraihan18/TA/case/FINAL_TA/08_Jurnal_Satu_Per_Satu/Fig02_Exploded_view_electronics.pdf

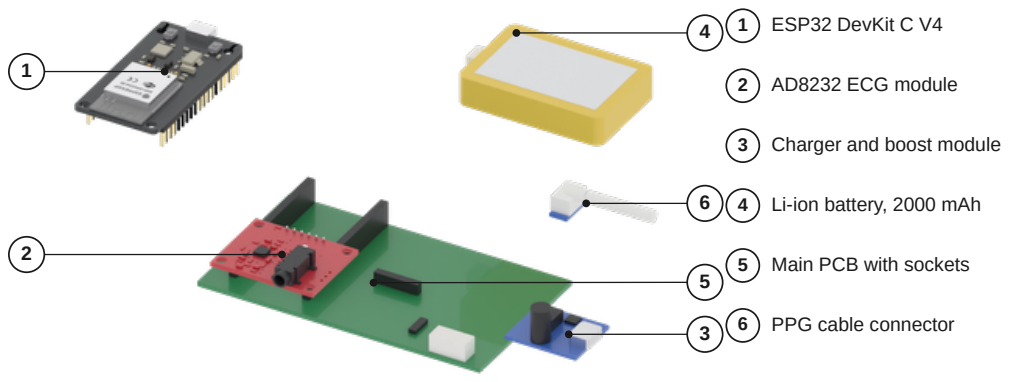
[picture p251: page 1]

1 ESP32 DevKit C V4 2 AD8232 ECG module 3 Charger and boost module 4 Li-ion battery, 2000 mAh 5 Main PCB with sockets 6 PPG cable connector
