fathurraihan18/TA/case/FINAL_TA/02_Gambar_Teknik_Cover/Gambar_Teknik_Cover_ECG_PPG_A3.pdf

64,8

# JACK AD8232 Ø7,2

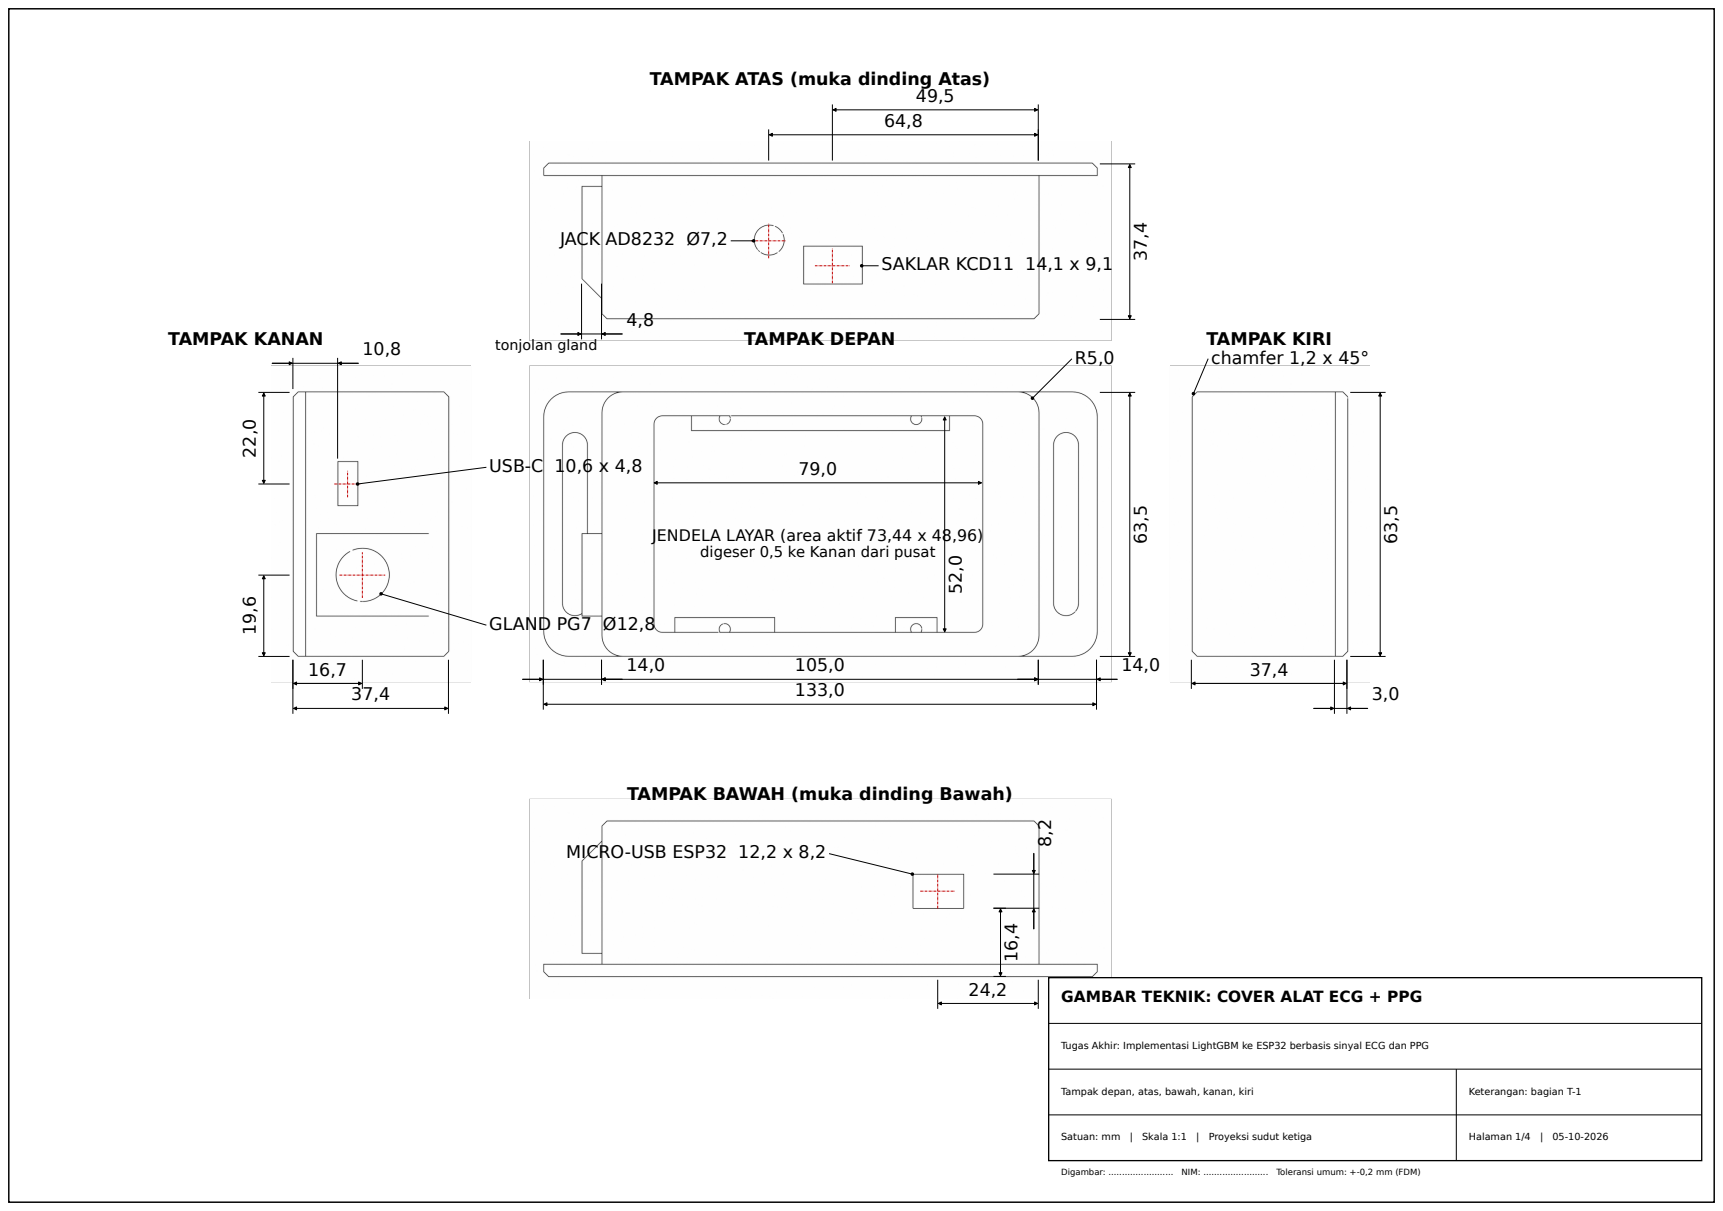
[picture p254: page 1]
TAMPAK DEPAN; SAKLAR KCD11 14,1 x 9,1; tonjolan gland; MICRO-USB ESP32 12,2 x 8,2; USB-C 10,6 x 4,8; GLAND PG7 Ø12,8; TAMPAK KANAN; chamfer 1,2 x 45°; TAMPAK KIRI; Keterangan: bagian T-1; Halaman 1/4 | 05-10-2026

TAMPAK ATAS (muka dinding Atas)

JENDELA LAYAR (area aktif 73,44 x 48,96)
digeser 0,5 ke Kanan dari pusat

TAMPAK BAWAH (muka dinding Bawah)

GAMBAR TEKNIK: COVER ALAT ECG + PPG

Tugas Akhir: Implementasi LightGBM ke ESP32 berbasis sinyal ECG dan PPG

Tampak depan, atas, bawah, kanan, kiri

Satuan: mm | Skala 1:1 | Proyeksi sudut ketiga

Digambar: ........................ NIM: ........................ Toleransi umum: +-0,2 mm (FDM)

# TAMPAK BELAKANG (back plate + sayap)

# ISOMETRIK: depan dan belakang

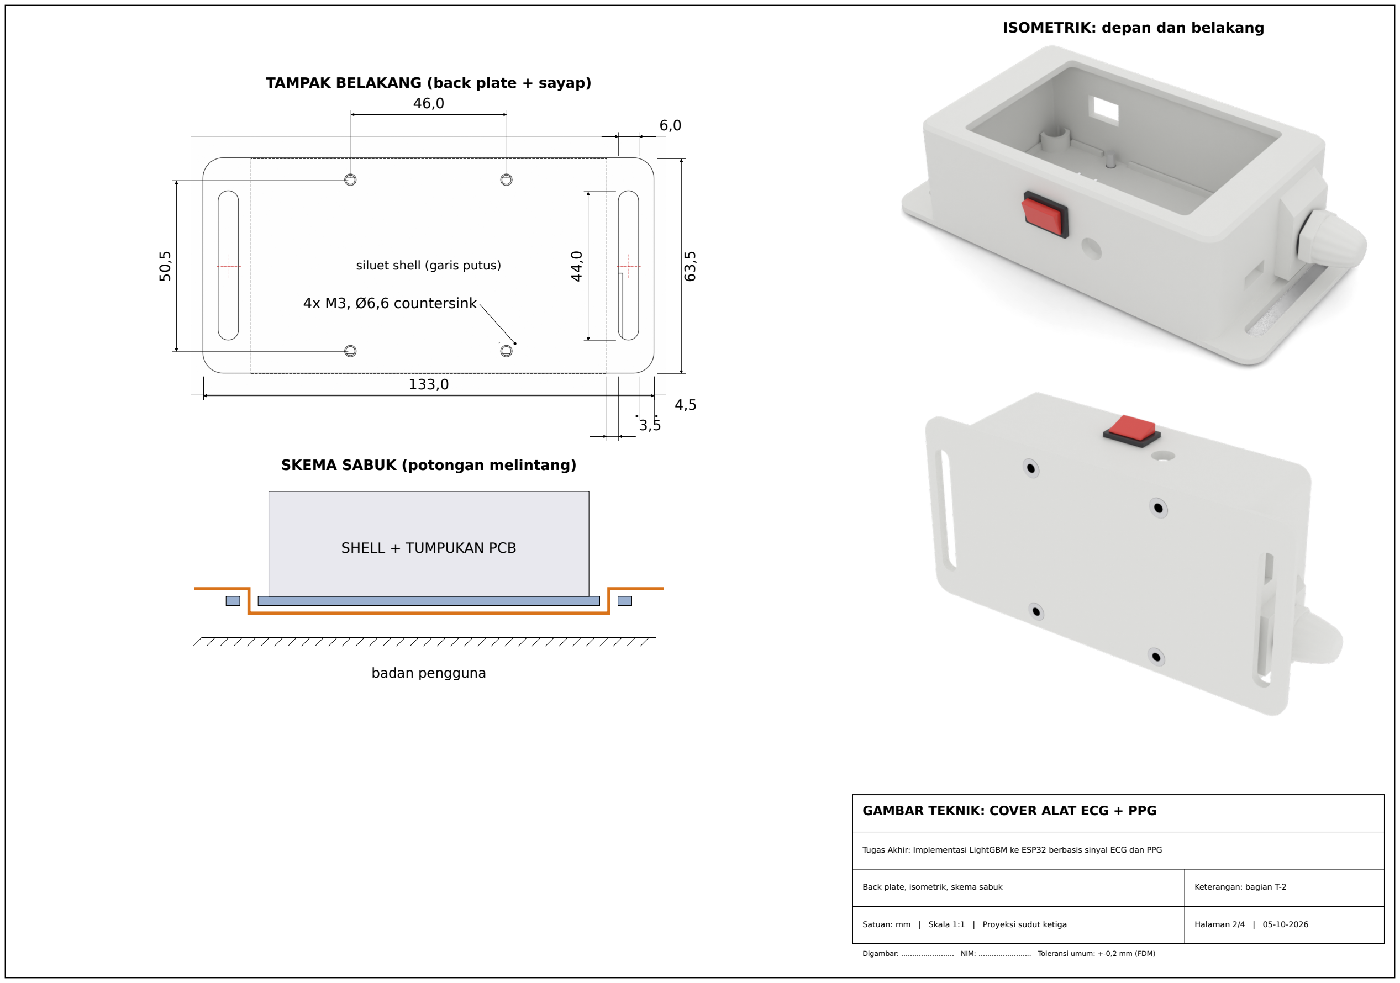
[picture p255: page 2]

# SKEMA SABUK (potongan melintang)

133,0

63,5

6,0

44,0

4,5
3,5

## siluet shell (garis putus)

46,0

50,5

# 4x M3, Ø6,6 countersink

# SHELL + TUMPUKAN PCB

# badan pengguna

## GAMBAR TEKNIK: COVER ALAT ECG + PPG

Tugas Akhir: Implementasi LightGBM ke ESP32 berbasis sinyal ECG dan PPG

Back plate, isometrik, skema sabuk

Satuan: mm | Skala 1:1 | Proyeksi sudut ketiga

Keterangan: bagian T-2

Halaman 2/4 | 05-10-2026

POTONGAN A-A (x = -12,3) | POTONGAN B-B (x = +3,0)
3,0

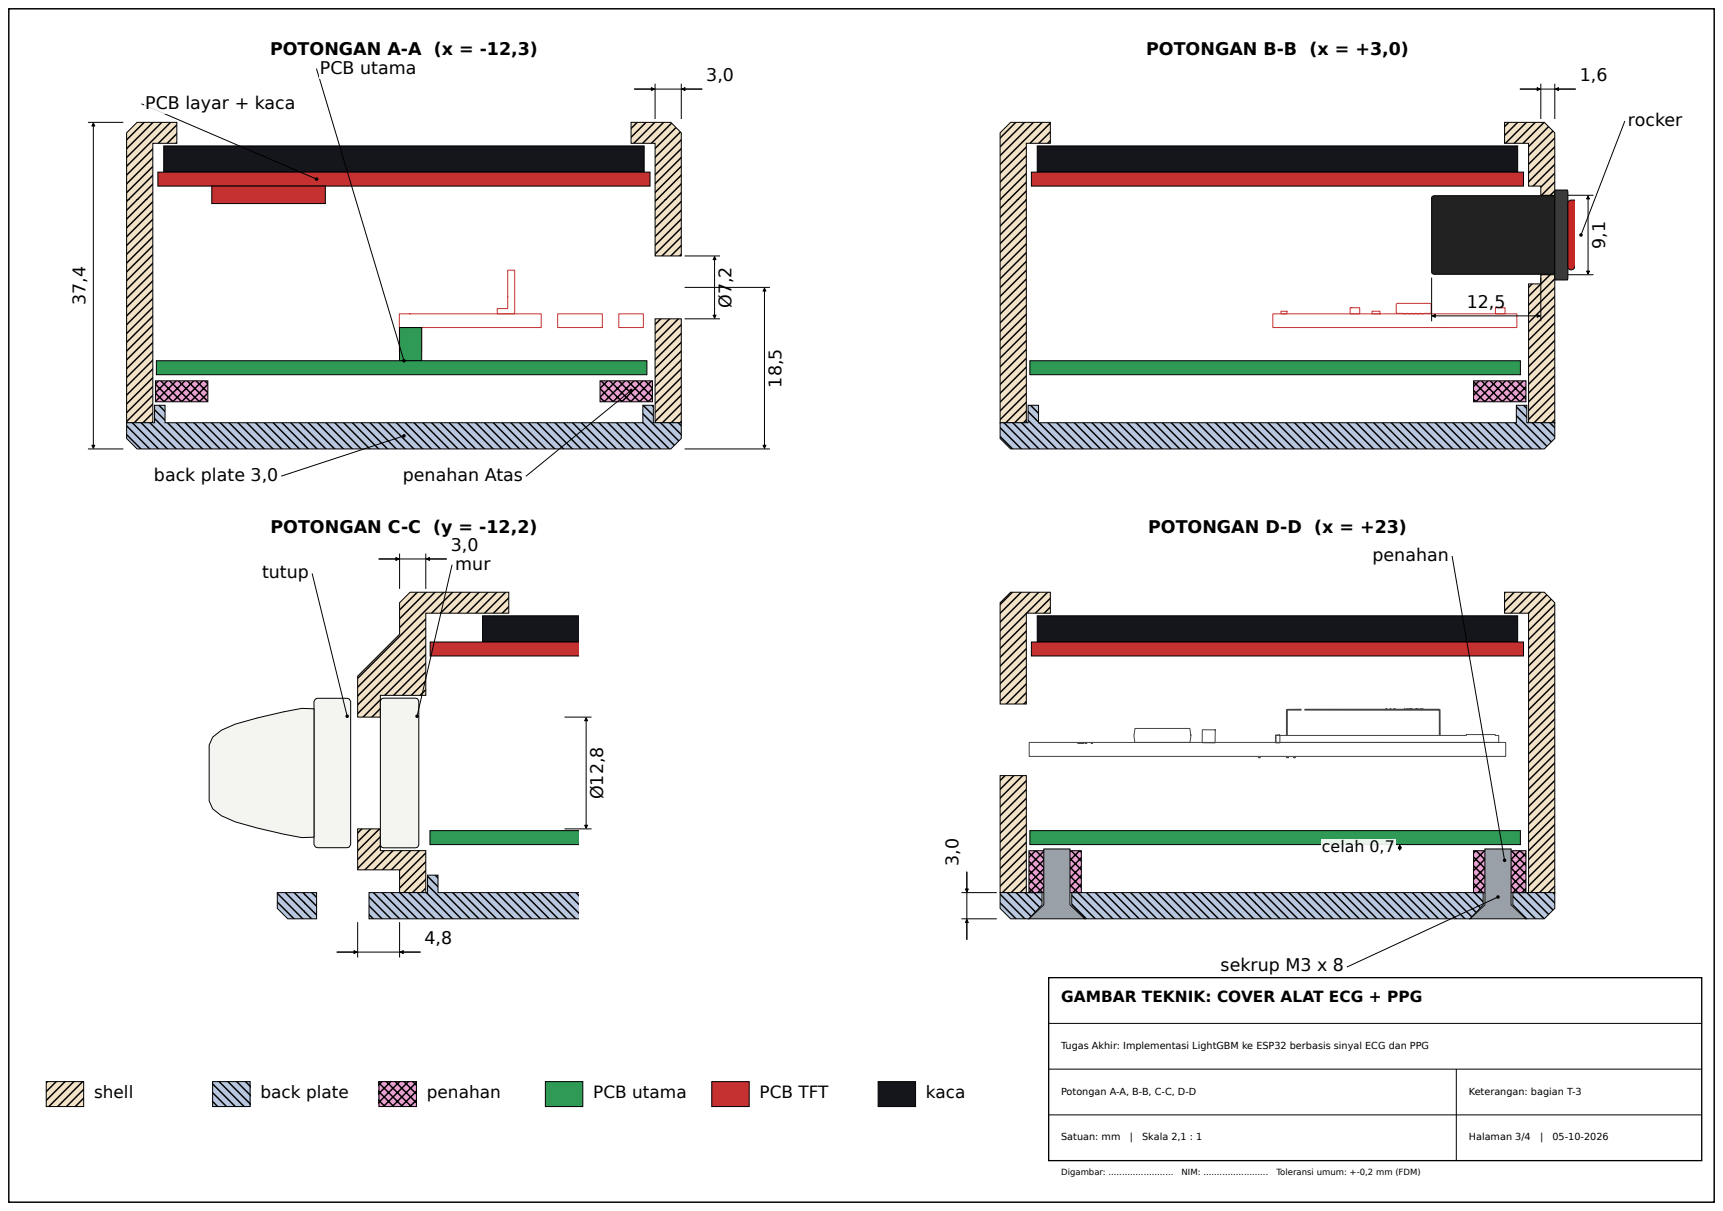
[picture p256: page 3]
POTONGAN C-C (y = -12,2); POTONGAN D-D (x = +23); shell; back plate; penahan; PCB utama; PCB TFT; kaca; back plate 3,0; penahan Atas; rocker; tutup; mur; sekrup M3 x 8; celah 0,7; Potongan A-A, B-B, C-C, D-D; Keterangan: bagian T-3; Halaman 3/4 | 05-10-2026

PCB layar + kaca

GAMBAR TEKNIK: COVER ALAT ECG + PPG

Tugas Akhir: Implementasi LightGBM ke ESP32 berbasis sinyal ECG dan PPG

Satuan: mm | Skala 2,1 : 1

# DENAH PENAHAN SEKRUP (tampak depan)

jack AD8232 | saklar

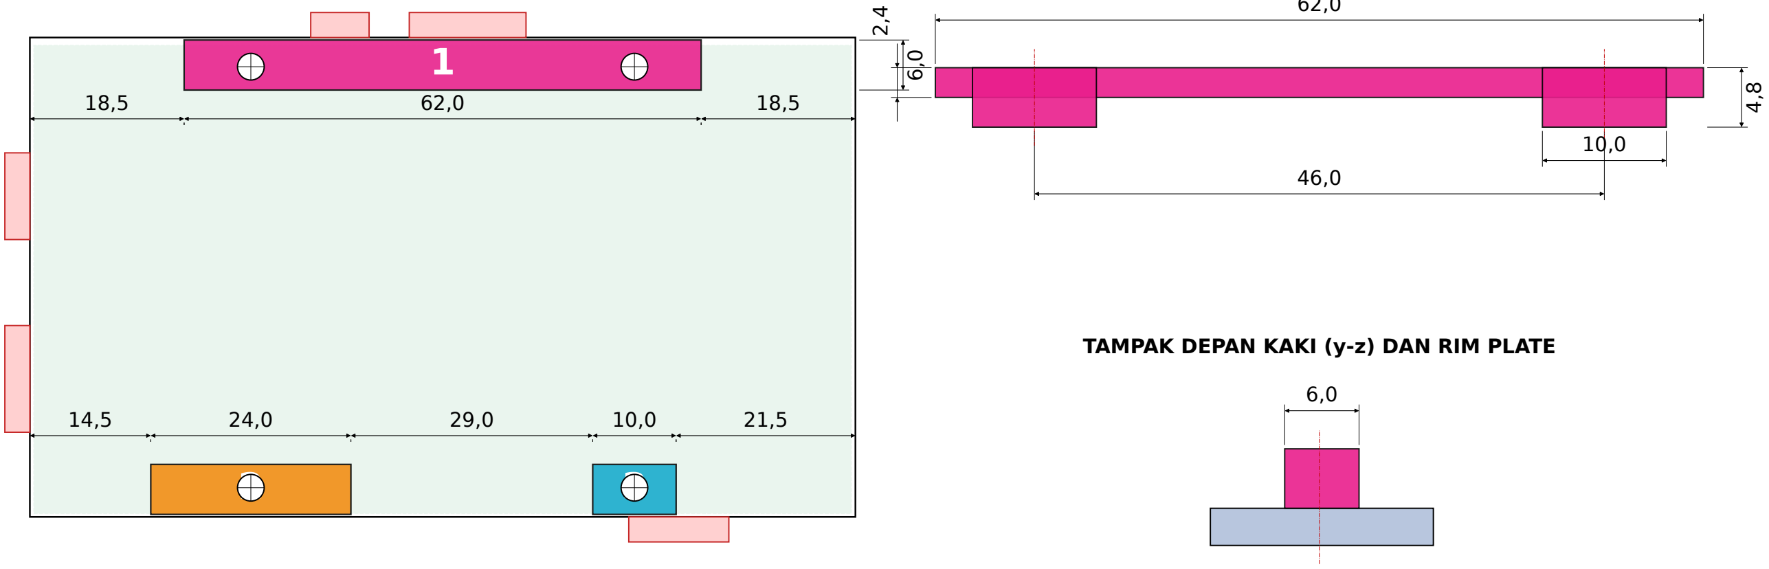
[picture p257: figure]
TAMPAK DEPAN KAKI (y-z) DAN RIM PLATE

## micro-USB

## USB-C

## gland PG7

# TAMPAK SAMPING PENAHAN 1 (x-z)

## plate 3,0

# Plate dan 3 penahan, tampak dari depan plate

# KANAN

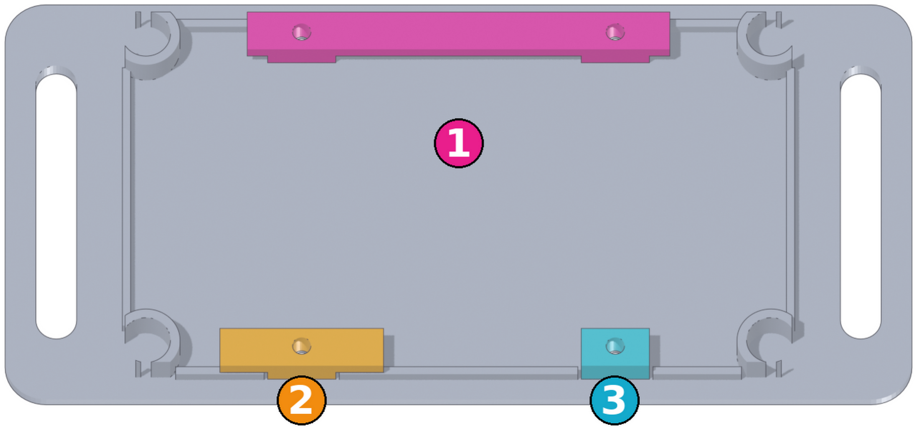
[picture p258: figure]

KIRI

62,0

## GAMBAR TEKNIK: COVER ALAT ECG + PPG

Tugas Akhir: Implementasi LightGBM ke ESP32 berbasis sinyal ECG dan PPG

Penahan sekrup (3 bagian)

Satuan: mm | Skala: lihat dimensi

Keterangan: bagian T-4

Halaman 4/4 | 05-10-2026
