fathurraihan18/TA/case/FINAL_TA/03_Gambar_Teknik_Klip/Gambar_Teknik_Klip_PPG_A3.pdf

## POTONGAN A-A (y = 0)

## TAMPAK ATAS (rahang B)

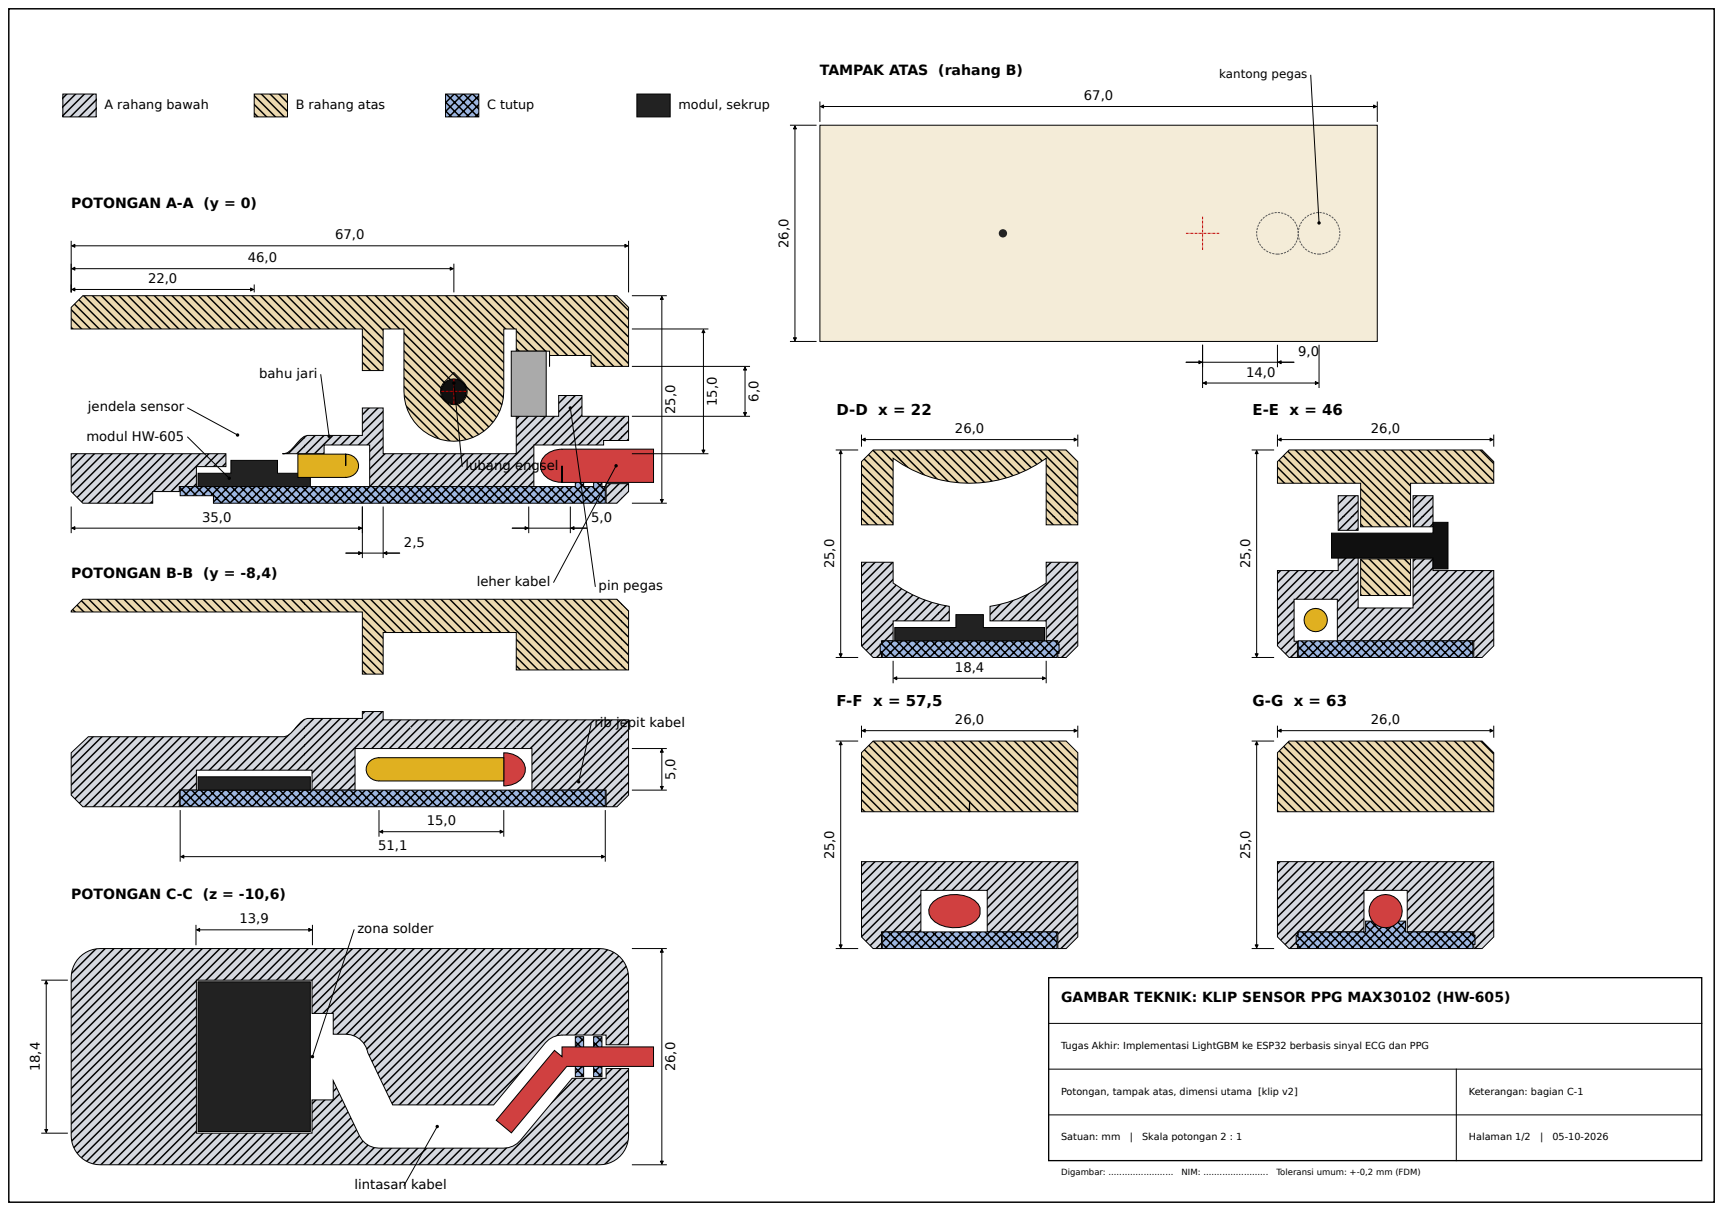
[picture p259: page 1]
POTONGAN B-B (y = -8,4); POTONGAN C-C (z = -10,6); A rahang bawah; B rahang atas; C tutup; modul, sekrup; jendela sensor; modul HW-605; lubang engsel; bahu jari; lintasan kabel; zona solder; kantong pegas; Keterangan: bagian C-1; Halaman 1/2 | 05-10-2026

pin pegas leher kabel

rib jepit kabel

GAMBAR TEKNIK: KLIP SENSOR PPG MAX30102 (HW-605)

Tugas Akhir: Implementasi LightGBM ke ESP32 berbasis sinyal ECG dan PPG

Potongan, tampak atas, dimensi utama [klip v2]

Satuan: mm | Skala potongan 2 : 1

Digambar: ........................ NIM: ........................ Toleransi umum: +-0,2 mm (FDM)

# Klip sensor PPG MAX30102: tampak eksplode dan pemakaian

## A. Tampak eksplode

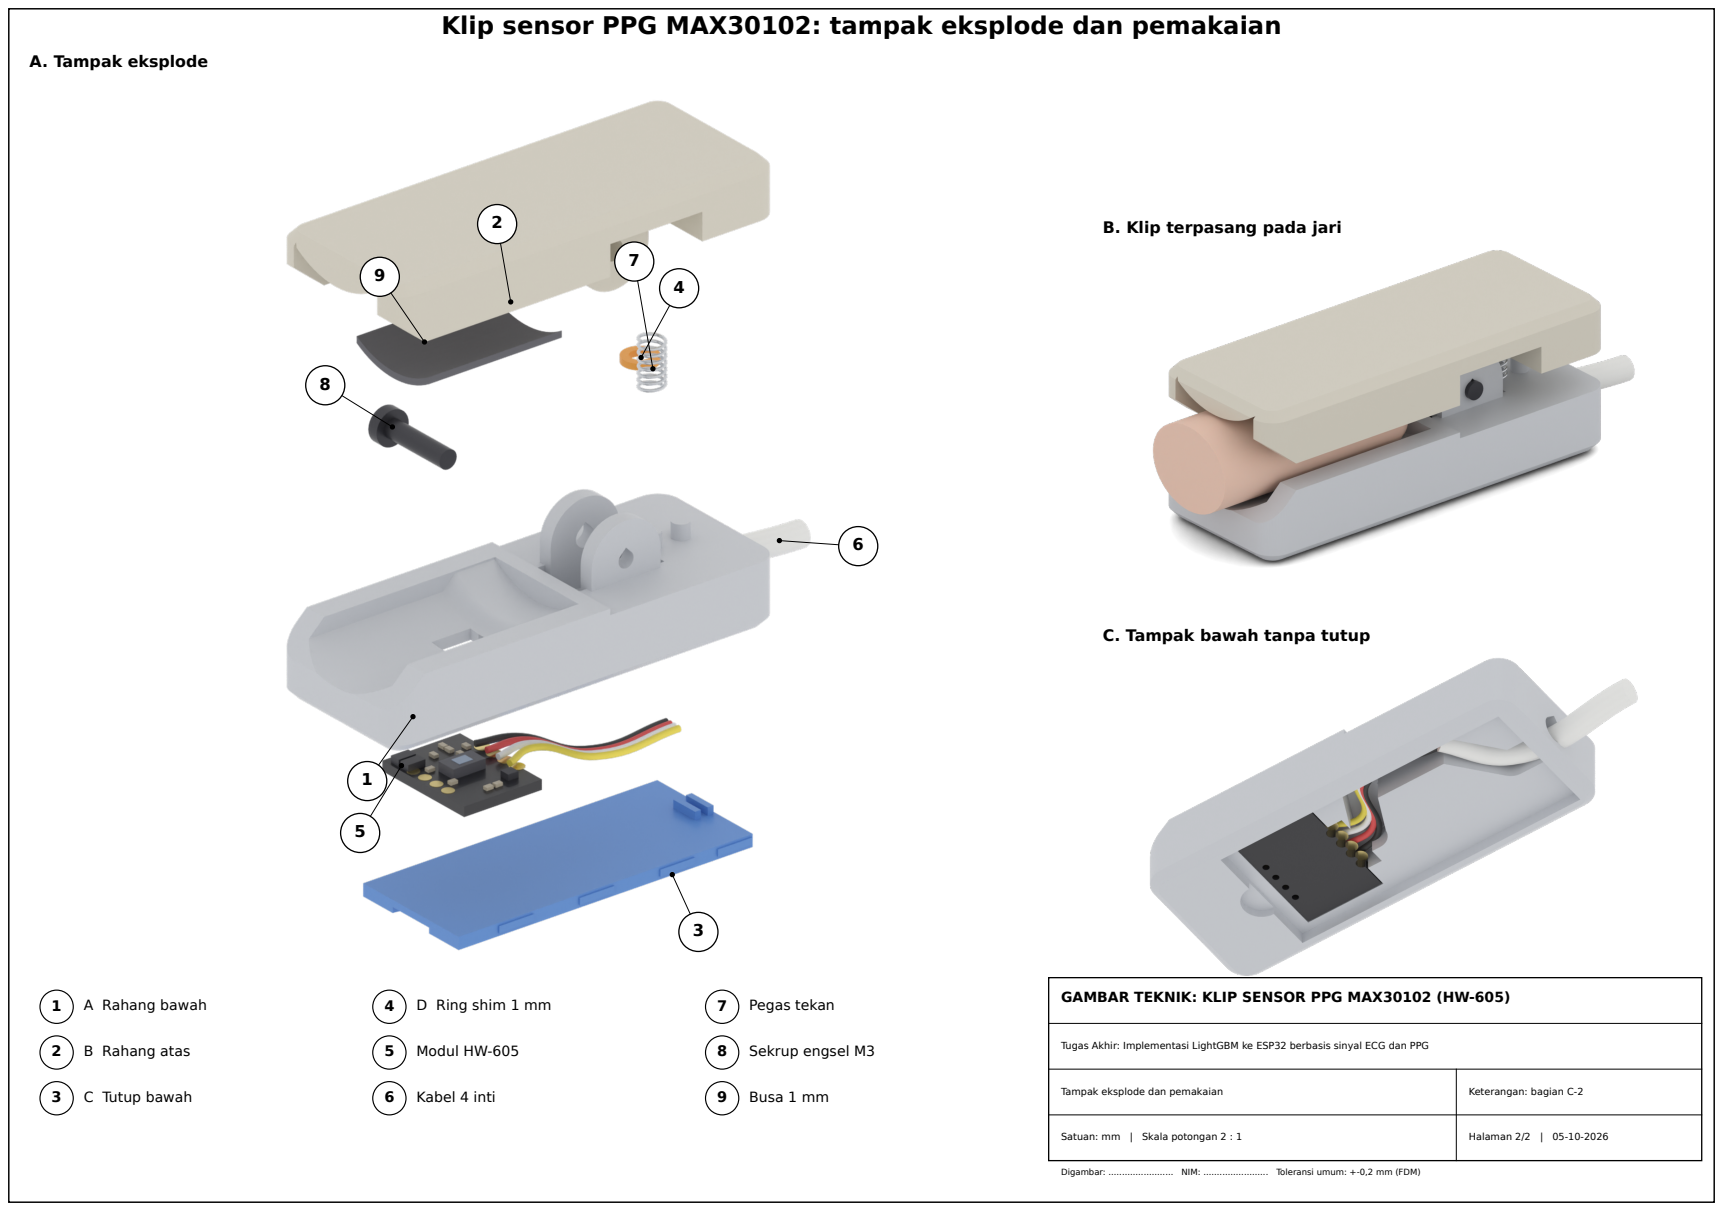
[picture p260: page 2]
A Rahang bawah; B Rahang atas; C Tutup bawah; Modul HW-605; Kabel 4 inti; Pegas tekan; Sekrup engsel M3; Busa 1 mm

B. Klip terpasang pada jari

C. Tampak bawah tanpa tutup

GAMBAR TEKNIK: KLIP SENSOR PPG MAX30102 (HW-605)

D Ring shim 1 mm

Tugas Akhir: Implementasi LightGBM ke ESP32 berbasis sinyal ECG dan PPG

Tampak eksplode dan pemakaian | Keterangan: bagian C-2

Satuan: mm | Skala potongan 2 : 1 | Halaman 2/2 | 05-10-2026

Digambar: ........................ NIM: ........................ Toleransi umum: +-0,2 mm (FDM)
