fathurraihan18/TA/case/FINAL_TA/04_Gambar_Perakitan/Gambar_Perakitan_ECG_PPG_A3.pdf

# Desain 3D alat ECG + PPG beserta komponennya (tampak eksplode)

Lapisan cover | Modul elektronik di atas PCB custom

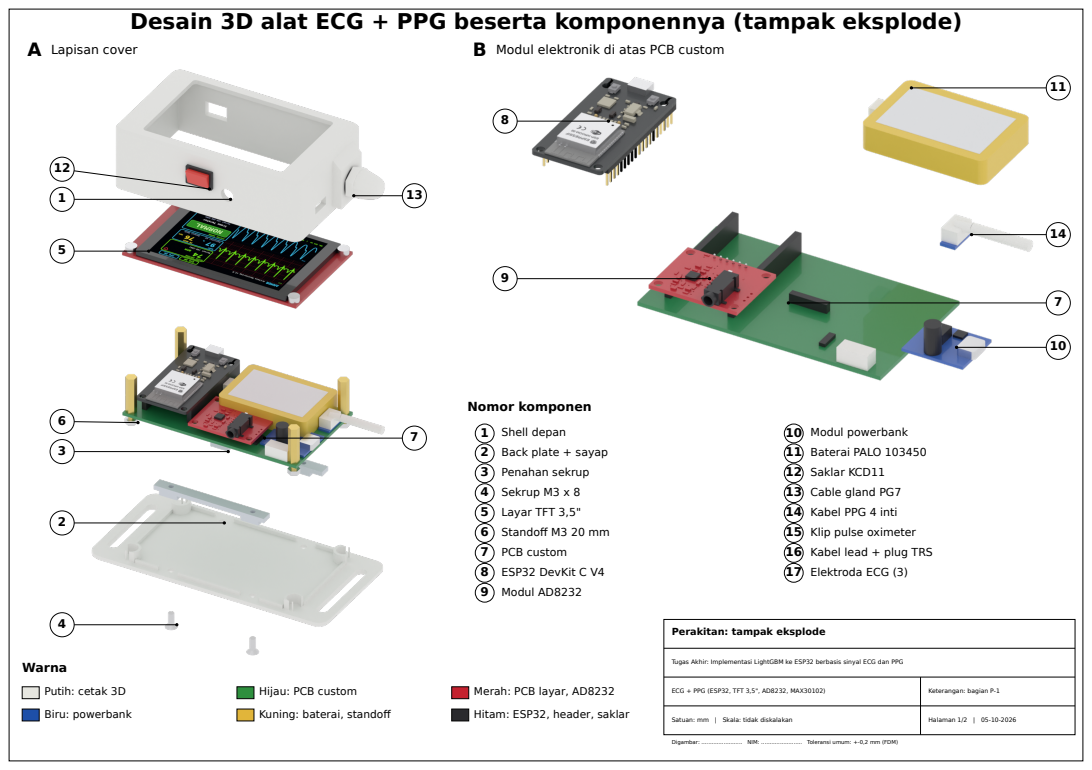
[picture p261: page 1]
Nomor komponen; Shell depan; Back plate + sayap; Penahan sekrup; Sekrup M3 x 8; Layar TFT 3,5"; Standoff M3 20 mm; PCB custom; ESP32 DevKit C V4; Modul AD8232; Modul powerbank; Baterai PALO 103450; Saklar KCD11; Cable gland PG7; Kabel PPG 4 inti; Klip pulse oximeter; Kabel lead + plug TRS; Elektroda ECG (3); Warna; Putih: cetak 3D; Hijau: PCB custom; Merah: PCB layar, AD8232; Biru: powerbank; Kuning: baterai, standoff; Hitam: ESP32, header, saklar

Perakitan: tampak eksplode

Tugas Akhir: Implementasi LightGBM ke ESP32 berbasis sinyal ECG dan PPG

ECG + PPG (ESP32, TFT 3,5", AD8232, MAX30102) | Keterangan: bagian P-1

Satuan: mm | Skala: tidak diskalakan | Halaman 1/2 | 05-10-2026

Digambar: ........................ NIM: ........................ Toleransi umum: +-0,2 mm (FDM)

# Sistem lengkap: perangkat, klip pulse oximeter, kabel lead, dan 3 elektroda ECG

Tampak rebah di meja, layar menghadap atas | Penempatan pada pengguna

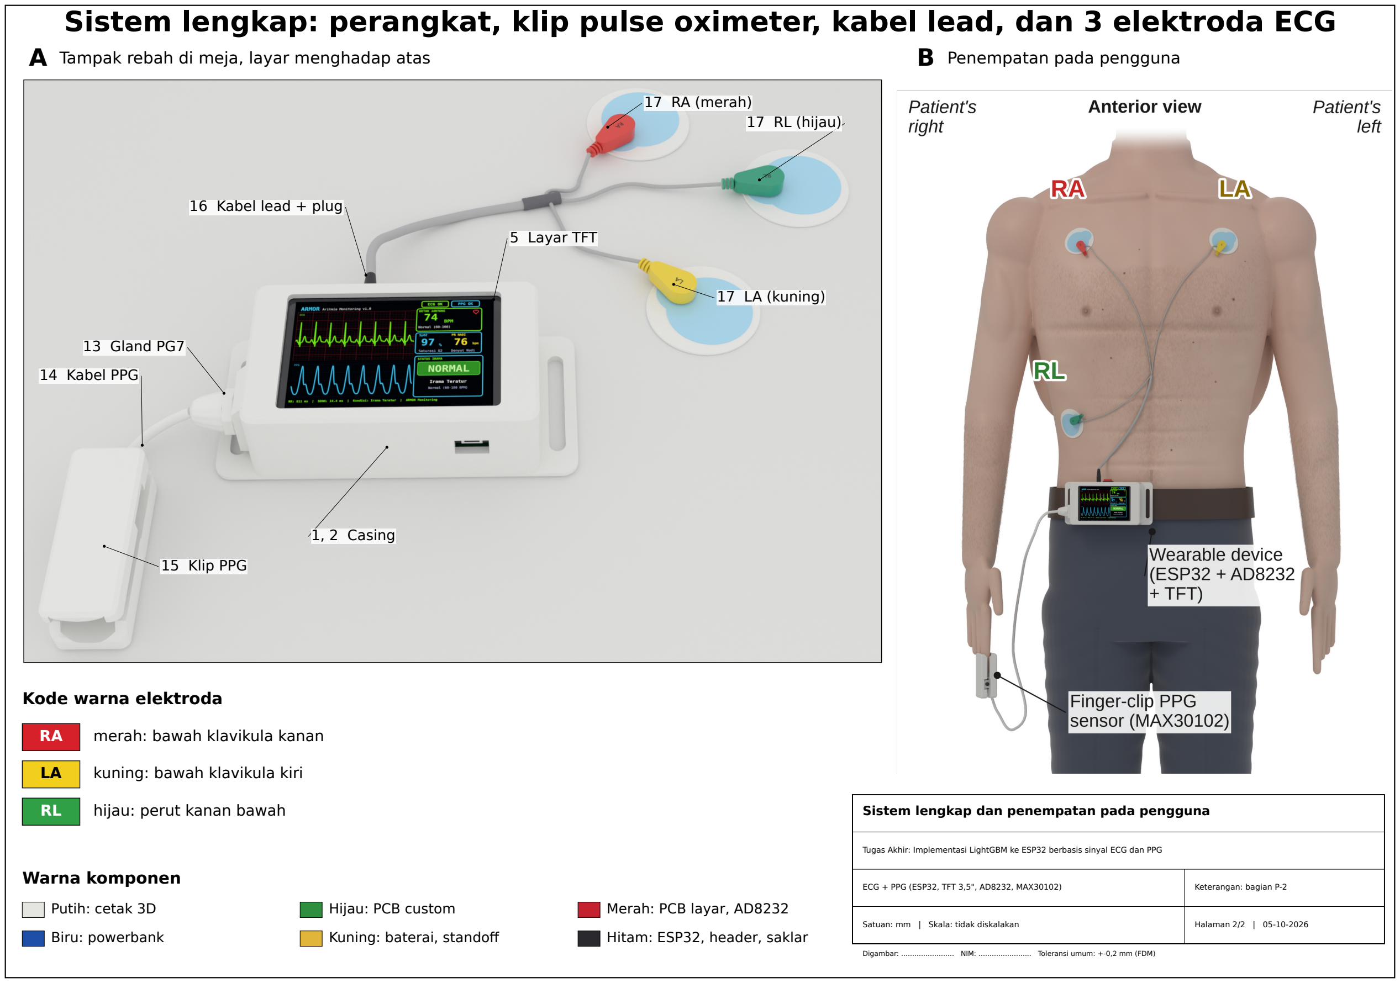
[picture p262: page 2]

# Kode warna elektroda

# merah: bawah klavikula kanan

# kuning: bawah klavikula kiri

# hijau: perut kanan bawah

# Warna komponen

A B

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

RA

LA

RL

# 5 Layar TFT

# 1, 2 Casing

# 13 Gland PG7

# 14 Kabel PPG

# 15 Klip PPG

# 16 Kabel lead + plug

# 17 RA (merah) 17 RL (hijau)

# 17 LA (kuning)

## Sistem lengkap dan penempatan pada pengguna

Tugas Akhir: Implementasi LightGBM ke ESP32 berbasis sinyal ECG dan PPG

ECG + PPG (ESP32, TFT 3,5", AD8232, MAX30102) | Keterangan: bagian P-2
Satuan: mm | Skala: tidak diskalakan | Halaman 2/2 | 05-10-2026
Digambar: | NIM: | Toleransi umum: +-0,2 mm (FDM)
