fathurraihan18/TA/case/FINAL_TA/08_Jurnal_Satu_Per_Satu/Fig01_Exploded_view_enclosure.pdf

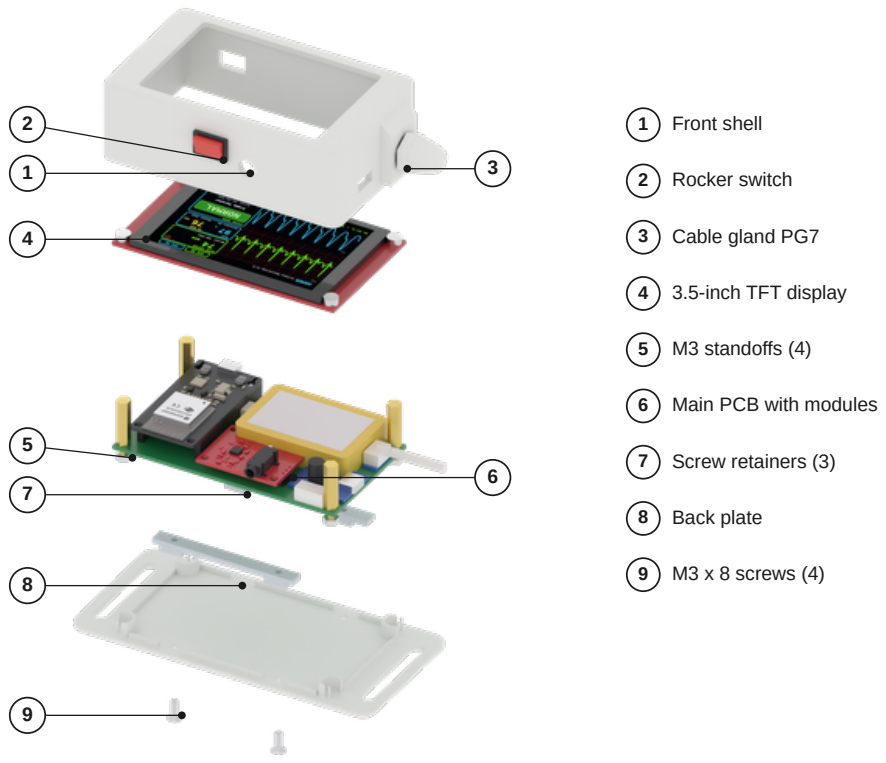
[picture p263: page 1]

1 Front shell 2 Rocker switch 3 Cable gland PG7 4 3.5-inch TFT display 5 M3 standoffs (4) 6 Main PCB with modules 7 Screw retainers (3) 8 Back plate 9 M3 x 8 screws (4)
