fathurraihan18/TA/case/FINAL_TA/08_Jurnal_Satu_Per_Satu/Fig14_Exploded_view_finger_clip.pdf

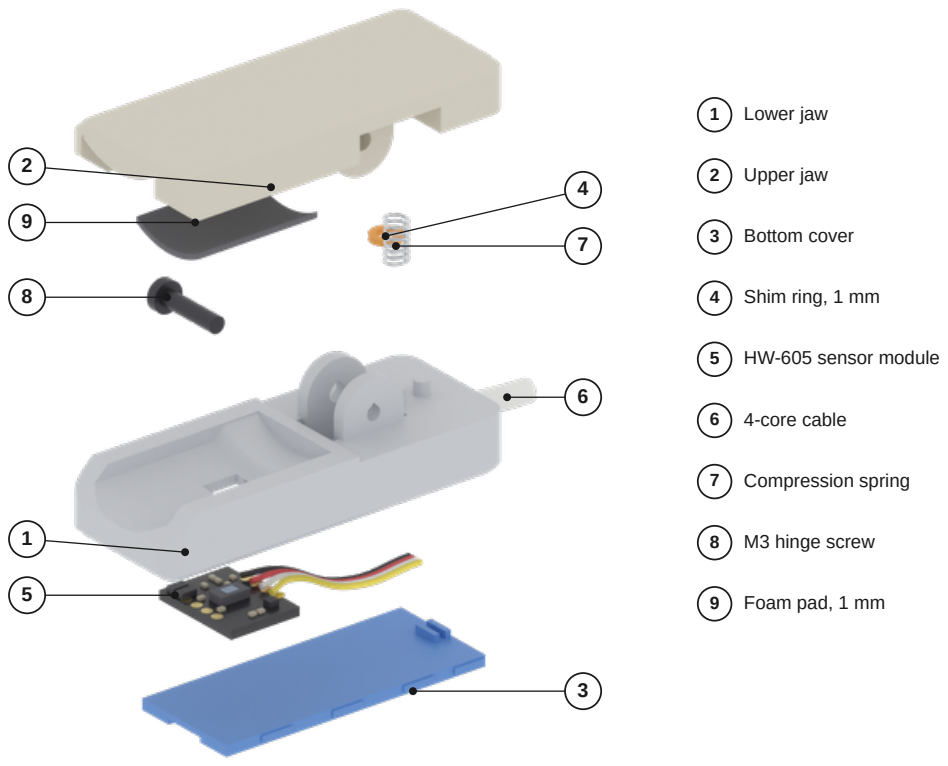
[picture p264: page 1]
Lower jaw 2; Upper jaw 3; Bottom cover 4; Shim ring, 1 mm 5; HW-605 sensor module 6; 4-core cable 7; Compression spring 8; M3 hinge screw 9; Foam pad, 1 mm
