fathurraihan18/TA/case/FINAL_TA/08_Jurnal_Satu_Per_Satu/Fig16_Display_user_interface.pdf

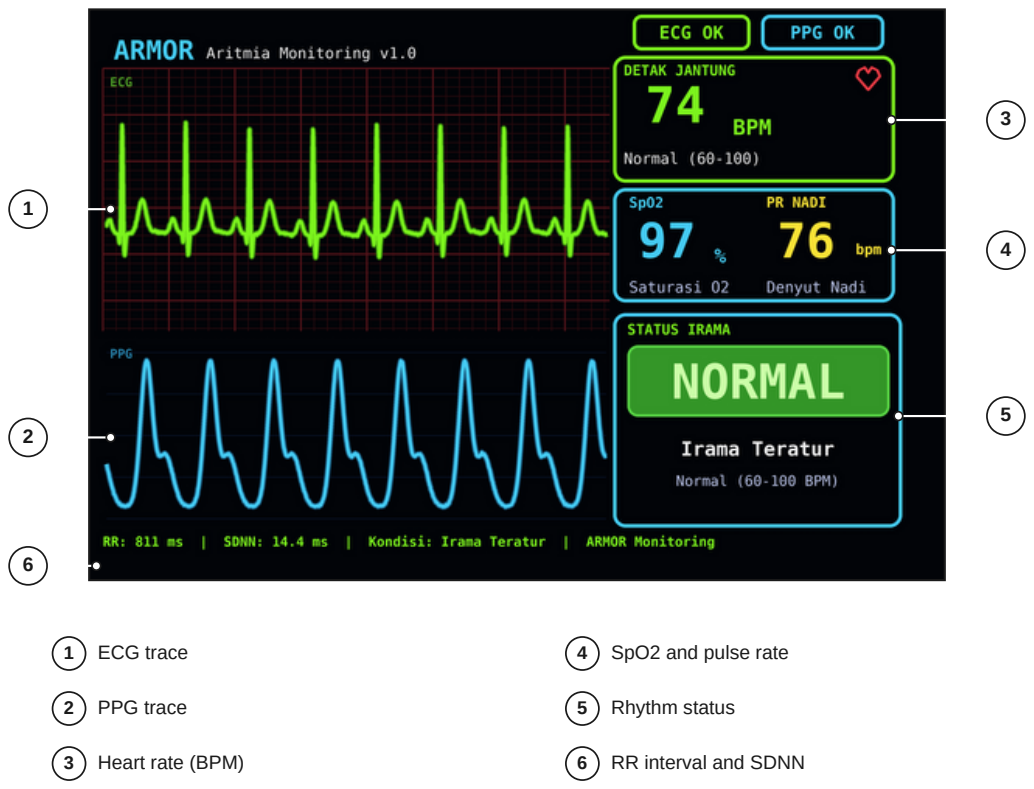
[picture p265: page 1]
1 ECG trace; 2 PPG trace; 5 Rhythm status

4 SpO2 and pulse rate

3 Heart rate (BPM)

6 RR interval and SDNN
