fathurraihan18/TA/case/v3_baterai/gambar_teknik/Gambar_Teknik_Cover_ECG_PPG_A3.pdf

## TAMPAK ATAS (muka dinding Atas)

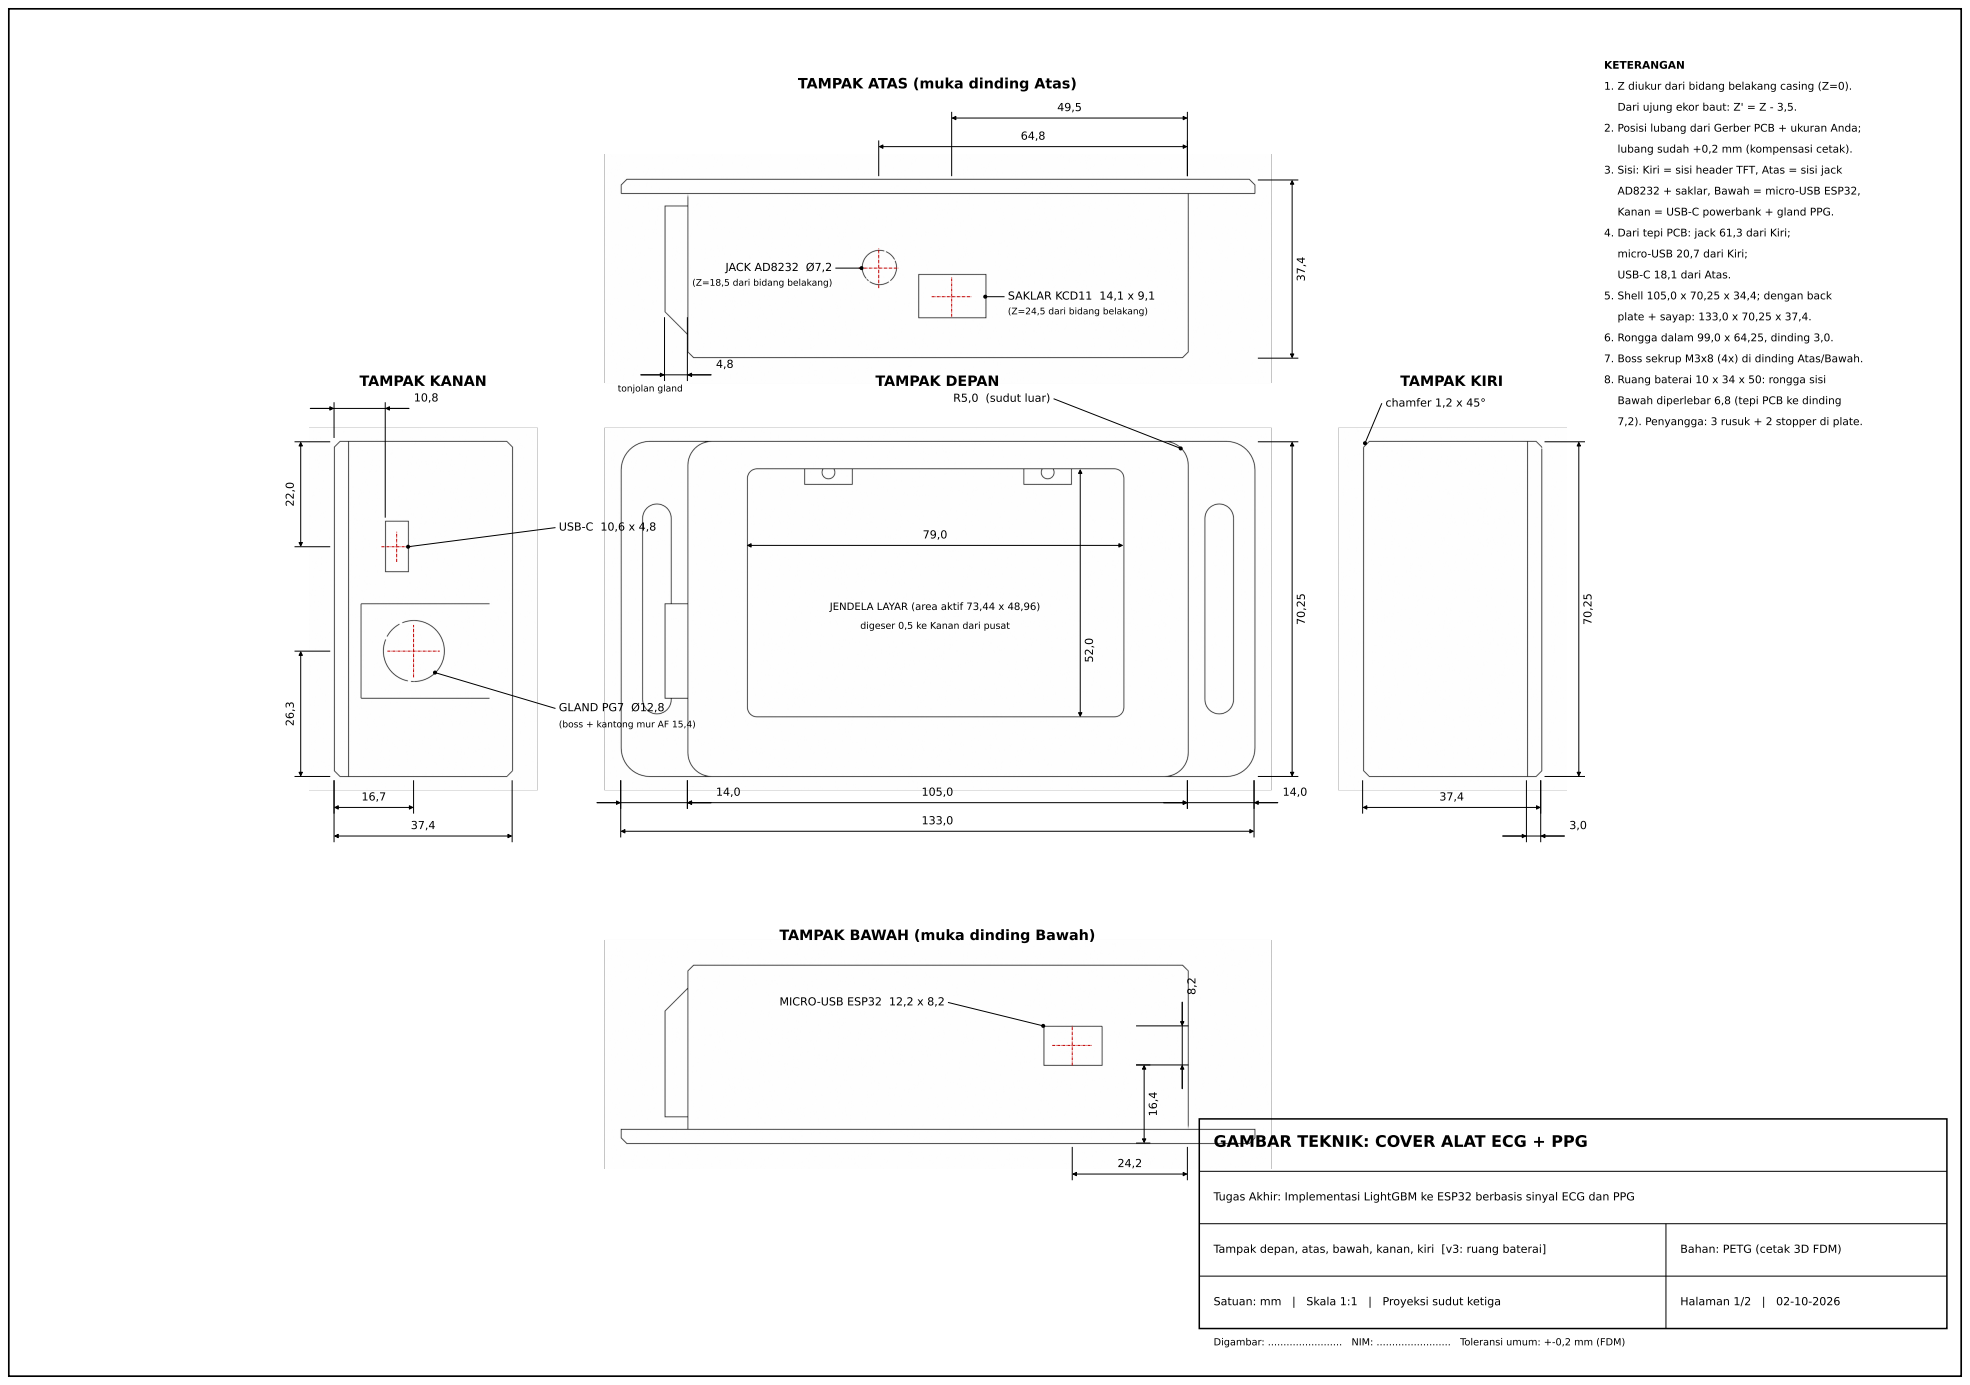
[picture p266: page 1]
Halaman 1/2 | 02-10-2026; R5,0 (sudut luar); TAMPAK DEPAN; JACK AD8232 Ø7,2; SAKLAR KCD11 14,1 x 9,1; tonjolan gland; MICRO-USB ESP32 12,2 x 8,2; USB-C 10,6 x 4,8; GLAND PG7 Ø12,8; TAMPAK KANAN; chamfer 1,2 x 45°; TAMPAK KIRI; KETERANGAN; plate + sayap: 133,0 x 70,25 x 37,4.

1. Z diukur dari bidang belakang casing (Z=0).

Dari ujung ekor baut: Z' = Z - 3,5.

2. Posisi lubang dari Gerber PCB + ukuran Anda;

lubang sudah +0,2 mm (kompensasi cetak).

3. Sisi: Kiri = sisi header TFT, Atas = sisi jack

AD8232 + saklar, Bawah = micro-USB ESP32,

Kanan = USB-C powerbank + gland PPG.

4. Dari tepi PCB: jack 61,3 dari Kiri;

micro-USB 20,7 dari Kiri;

USB-C 18,1 dari Atas.

(Z=18,5 dari bidang belakang)

5. Shell 105,0 x 70,25 x 34,4; dengan back

(Z=24,5 dari bidang belakang)

6. Rongga dalam 99,0 x 64,25, dinding 3,0.

7. Boss sekrup M3x8 (4x) di dinding Atas/Bawah.

8. Ruang baterai 10 x 34 x 50: rongga sisi

Bawah diperlebar 6,8 (tepi PCB ke dinding

7,2). Penyangga: 3 rusuk + 2 stopper di plate.

JENDELA LAYAR (area aktif 73,44 x 48,96)

digeser 0,5 ke Kanan dari pusat

(boss + kantong mur AF 15,4)

TAMPAK BAWAH (muka dinding Bawah)

GAMBAR TEKNIK: COVER ALAT ECG + PPG

Tugas Akhir: Implementasi LightGBM ke ESP32 berbasis sinyal ECG dan PPG

Tampak depan, atas, bawah, kanan, kiri [v3: ruang baterai]

Bahan: PETG (cetak 3D FDM)

Satuan: mm | Skala 1:1 | Proyeksi sudut ketiga

Digambar: ........................ NIM: ........................ Toleransi umum: +-0,2 mm (FDM)

## ISOMETRIK: depan (kanan-atas) dan belakang

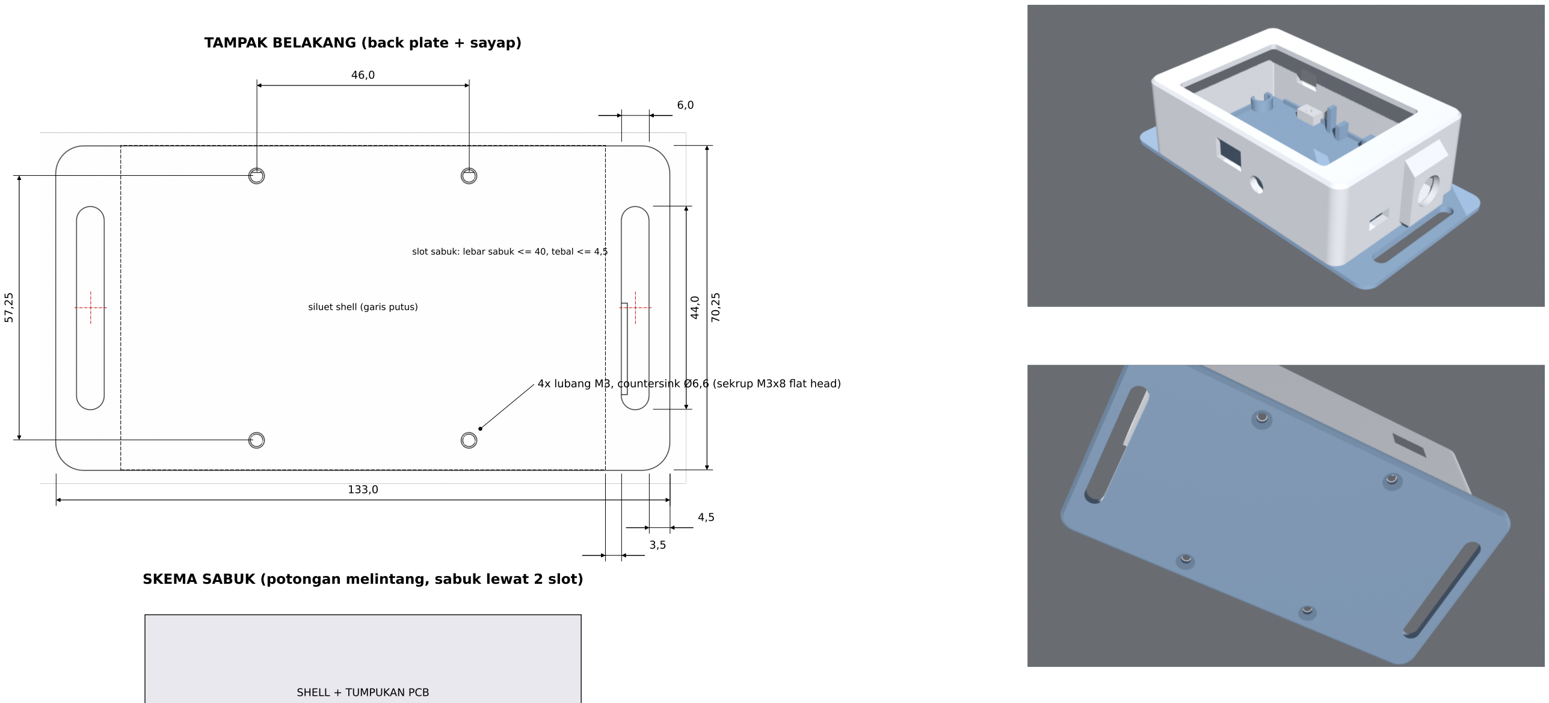
[picture p267: figure]
TAMPAK BELAKANG (back plate + sayap); siluet shell (garis putus); SHELL + TUMPUKAN PCB

## SKEMA SABUK (potongan melintang, sabuk lewat 2 slot)

TABEL POSISI & UKURAN LUBANG (dari tepi casing, mm)

Z diukur dari bidang belakang casing. Posisi dari Gerber PCB; uji ulang dengan jangka sorong.

DAFTAR KOMPONEN PENDUKUNG

1x Shell depan (PETG) | - file 1_Shell_Depan_siap_cetak.stl
1x Back plate + sayap (PETG) | - file 2_BackPlate_siap_cetak.stl

4x Sekrup M3 x 8 flat head (penutup)

1x Cable gland PG7 + mur (kabel 3-6,5 mm)

1x Saklar rocker KCD11 mini 10 x 15 mm, snap-in

4x Standoff M3 20 mm + baut (sudah ada pada tumpukan)

## GAMBAR TEKNIK: COVER ALAT ECG + PPG

Tugas Akhir: Implementasi LightGBM ke ESP32 berbasis sinyal ECG dan PPG

Back plate, isometrik, skema sabuk, tabel lubang [v3: ruang baterai]

Satuan: mm | Skala 1:1 | Proyeksi sudut ketiga

Bahan: PETG (cetak 3D FDM)

Halaman 2/2 | 02-10-2026
Digambar: | NIM: | Toleransi umum: +-0,2 mm (FDM) slot sabuk: lebar sabuk <= 40, tebal <= 4,5

4x lubang M3, countersink Ø6,6 (sekrup M3x8 flat head)

badan pengguna

Sabuk turun lewat slot sayap, melintas di belakang back plate, lalu naik lewat slot lain.

Untuk bahu: sabuk/tali yang sama dipasang melintang lewat kedua slot.

Sisi | Fitur | Posisi | Ukuran lubang
Bawah | micro-USB ESP32 | 24,2 dari Kiri; Z 16,4-24,6 | 12,2 x 8,2
Atas | jack AD8232 | 64,8 dari Kiri; Z 18,5 | Ø7,2
Atas | saklar KCD11 | 49,5 dari Kiri; Z 24,5 | 14,1 x 9,1
Kanan | USB-C powerbank | 22,0 dari Atas; Z 10,8-15,6 | 10,6 x 4,8
Kanan | gland PG7 (PPG) | 26,3 dari Bawah; Z 16,7 | Ø12,8 + mur AF 15,4
Depan | jendela layar | pusat, geser 0,5 ke Kanan | 79,0 x 52,0
Belakang | slot sabuk 2x | X = +-59,0 dari pusat | 6,0 x 44,0
Dalam | ruang baterai (v3) | Y -35,1 s.d. -1,1 dari pusat pola baut | 10 x 34 x 50 + celah
