fathurraihan18/TA/(list of files, drawings)

Other design files:
case/FINAL_TA/_render/komponen/pcb_info.json
case/v2d_penahan_strip/data/pcb_holes.json
