fathurraihan18/TA/(commit log)

2026-10-02 Tambah desain 3D cover alat ECG + PPG (Blender)
    - Shell depan + back plate parametrik (bpy), STL siap cetak
    - Posisi lubang diturunkan dari Gerber dan file desain SparkFun AD8232
    - Skrip verifikasi otomatis (mesh rapat, lubang, tabrakan komponen)
    - Pratinjau render dan README perakitan/pengaturan cetak
    Claude-Session: https://claude.ai/code/session_01Gc1q877AxaWKQhEuXRQqwW
    [1_Shell_Depan_siap_cetak.stl, 2_BackPlate_siap_cetak.stl, ECG_PPG_Cover.blend, plate_design.stl, ref_Area_aktif.stl, ref_Badan_saklar.stl, ref_Baut_spacer.stl, ref_Gland_PG11_+_mur.stl]
2026-10-02 Cover v2: gland PG7, saklar KCD11 datar, sayap slot sabuk, perbaikan boss sekrup, gambar teknik A3
    - Perbaiki bug: boss sekrup penutup ikut terhapus saat rongga dipotong (sekrup tidak punya material);
    sekarang boss ditambah setelah rongga, diuji cengkeraman ulir, celah ke PCB, jarak ke kaki komponen
    - Gland PG7 (lubang 12,8, kantong mur AF 15,4, tonjolan 4,8 mm); saklar KCD11 mini datar tanpa pod
    - Back plate dengan 2 sayap + slot sabuk 6x44 untuk pinggang/bahu; kuping tali atas dihapus
    - Chamfer/rounding ergonomis, verifikasi diperluas, estimasi massa
    - Gambar teknik A3 (2 halaman, skala 1:1) untuk draf TA
    Claude-Session: https://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
    [1_Shell_Depan_siap_cetak.stl, 2_BackPlate_siap_cetak.stl, ECG_PPG_Cover.blend, pcb_holes.json, plate_design.stl, ref_Badan_saklar.stl, ref_Badan_saklar_KCD11.stl, ref_Gland_PG11_+_mur.stl]
2026-10-02 Gambar perakitan eksplode berwarna, daftar komponen, dan penempatan baterai PALO 103450 di sisi Bawah
    - perakitan/make_assembly.py: model berwarna per komponen (Blender), render eksplode/jadi/denah, ekspor STL per komponen
    - perakitan/susun_perakitan.py: lembar A3 2 halaman (eksplode bernomor + BOM 14 item; denah, tampak jadi, potongan, penjelasan)
    - perakitan/verify_assembly.py: uji tabrakan komponen vs shell/plate dan antar komponen
    - README: bagian perakitan dan catatan tumpang tindih baterai 6,1 mm (pilihan pengguna)
    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
    [ad8232__ad_ic.stl, ad8232__ad_pcb.stl, ad8232__jack_body.stl, ad8232__jack_nose.stl, baterai__bat.stl, baterai__bat_jst.stl, baterai__bat_label.stl, baterai__bat_tape.stl]
2026-10-02 Cover v3: baterai PALO 103450 muat tanpa menumpuk (rongga Bawah +6,75 mm, rusuk dan stopper penyangga)
    - make_case.py: varian --bay (tanpa flag hasil identik v2); rongga/outline asimetris di sumbu Y, rim/boss/tiang mengikuti, 3 rusuk + 2 stopper di back plate
    - verify_case.py: rongga asimetris + uji ruang baterai (jarak ke shell/plate/PCB, rusuk, stopper)
    - v3_baterai/: STL siap cetak, .blend, gambar teknik A3, gambar eksplode + penempatan baterai, pratinjau
    - render_previews.py, make_assembly.py, susun_perakitan.py, gambar_lembar.py: mendukung outline v3
    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
    [1_Shell_Depan_siap_cetak.stl, 2_BackPlate_siap_cetak.stl, ECG_PPG_Cover.blend, ad8232__ad_ic.stl, ad8232__ad_pcb.stl, ad8232__jack_body.stl, ad8232__jack_nose.stl, baterai__bat.stl]
2026-10-02 Klip sensor PPG MAX30102 (HW-605) desain ulang: kabel tidak lepas, pegas berdudukan, nyaman
    - sensor_ppg/make_clip.py: generator parametrik (rahang A/B, tutup C, shim D); terowongan kabel tertutup + leher sempit + jalur S + rib penjepit
    - verify_clip.py: integritas mesh, kecocokan komponen, sapuan gerak engsel, gaya jepit pegas, fitur tipis, overhang
    - render_klip.py, gambar_klip.py, sections.py: render berwarna, gambar teknik A3 2 halaman
    - klip_v2/: STL siap cetak, .blend, gambar, render, hasil verifikasi
    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
    [A_RahangBawah_siap_cetak.stl, A_desain.stl, B_RahangAtas_siap_cetak.stl, B_desain.stl, C_TutupBawah_siap_cetak.stl, C_desain.stl, D_ShimPegas_siap_cetak.stl, D_desain.stl]
2026-10-02 Gambar perakitan v3 memakai model komponen nyata (ESP32 DevKit C V4, AD8232, HW-605 + klip PPG v2), tambah halaman 3 komponen elektronik
    - make_assembly.py: mode REAL=1 (model nyata, klip PPG v2, tanpa lantai), STL lama dibersihkan
    - susun_perakitan.py: argumen real, BOM item 5/6/10, potongan D dengan jack AD8232 nyata, halaman 3 (ukuran + sumber model)
    - verify_assembly.py: cadangan uji titik sampel untuk mesh tidak kedap, folder STL opsional
    - komponen/: model 3D hasil konversi + skrip + pratinjau
    - v3_baterai/perakitan: render, PDF 3 halaman, hasil_verifikasi.txt
    Claude-Session: https://claude.ai/code/session_01Gc1q877AxaWKQhEuXRQ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
    [ad8232_0_PCB_Re1.stl, ad8232_1_Dark_Chips_002.stl, ad8232_2_Metal_002.stl, ad8232__ad_Dark_Chips_002.stl, ad8232__ad_Metal_002.stl, ad8232__ad_PCB_Re1.stl, ad8232__ad_ic.stl, ad8232__ad_pcb.stl]
2026-10-03 Perbaiki urutan rakit: boss di dinding menghalangi tumpukan TFT+PCB; varian --rakit (sekrup samping, lug di plate, alur konektor)
    - make_case.py: opsi --rakit (tanpa boss, lubang sekrup samping, lug + pilot di plate, alur jack/micro-USB/USB-C)
    - verify_insert.py (baru): uji jalur pemasangan lurus dari belakang; v2 dan v3 lama gagal, v2b dan v3b lolos
    - verify_case.py: cek varian --rakit (lubang samping, lug, alur, ulir, jarak ke kaki PCB)
    - v2b_sekrup_samping/, v3b_sekrup_samping/: STL siap cetak, .blend, preview, README
    - v2b_sekrup_samping/perbaikan_v2_tercetak/: jig bor, volume yang dibuang dari shell v2 yang sudah tercetak, pratinjau
    - alat_perbaikan_v2.py, render_perbaikan.py, render_pr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
    [1_Shell_Depan_siap_cetak.stl, 2_BackPlate_siap_cetak.stl, ECG_PPG_Cover.blend, bagian_dibuang_dari_shell_v2.stl, jig_bor_ATAS.stl, jig_bor_BAWAH.stl, pcb_holes.json, plate_design.stl]
2026-10-05 v2b/v3b: lubang sekrup samping Ø4,0 (toleransi), sumbu Z 2,4, puncak lug 4,8; jig bor dan panduan pasang plate untuk shell v2 yang bossnya sudah dipotong
    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
    [1_Shell_Depan_siap_cetak.stl, 2_BackPlate_siap_cetak.stl, ECG_PPG_Cover.blend, bagian_dibuang_dari_shell_v2.stl, jig_bor_ATAS.stl, jig_bor_BAWAH.stl, plate_design.stl, ref_Sekrup_samping_M3.stl]
2026-10-05 v2c/v3c: penahan sekrup terpisah (plate v2 dan sekrup flat head dari belakang tidak berubah), verify_penahan.py, render_penahan.py
    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
    [1_Shell_Depan_siap_cetak.stl, 2_BackPlate_siap_cetak.stl, 3_Penahan_Sekrup_x4_siap_cetak.stl, ECG_PPG_Cover.blend, pcb_holes.json, penahan_design.stl, plate_design.stl, ref_Area_aktif.stl]
2026-10-05 v2d: penahan berbentuk strip (3 bagian) untuk plate v2 dan 4 sekrup dari belakang; gambar logika gaya, visual pemasangan, verifikasi (rim, port, komponen)
    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
    [1_Shell_Depan_siap_cetak.stl, 2_BackPlate_siap_cetak.stl, 3_Penahan_Sekrup_siap_cetak.stl, ECG_PPG_Cover.blend, pcb_holes.json, penahan_design.stl, plate_design.stl, ref_Area_aktif.stl]
2026-10-06 FINAL_TA: gambar komponen, gambar teknik cover/klip, perakitan, ilustrasi jurnal untuk draf TA
    - Render realistis (Cycles) semua komponen (ESP32 DevKit C V4, AD8232, MAX30102 HW-605, TFT, PCB, powerbank, baterai, gland PG7, saklar KCD11),
    elektroda EKG 3 lead (merah RA, kuning LA, hijau RL) + plug 3,5 mm, sistem lengkap, eksplode cover/modul, klip PPG.
    - Lembar A3: komponen K-1..K-6, gambar teknik cover v2 final (4 hal.), klip PPG (2 hal.), perakitan (2 hal.), gambar jurnal torso 3D (1 dan 2 kolom).
    - Tampilan LCD mengikuti foto layar alat (ARMOR); STL siap cetak + MD5; VERIFIKASI.txt; README.
    Claude-Session: https://claude.ai/code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
    [1_Shell_Depan_siap_cetak.stl, 2_BackPlate_siap_cetak.stl, 3_Penahan_Sekrup_siap_cetak.stl, A_RahangBawah_siap_cetak.stl, B_RahangAtas_siap_cetak.stl, C_TutupBawah_siap_cetak.stl, D_ShimPegas_siap_cetak.stl, ad8232__ad_Dark_Chips_002.stl]
2026-10-06 FINAL_TA: torso laki-laki realistis, PDF gambar lengkap satu berkas, keterangan dipisah, tulisan diperbesar
    - Torso 3D laki-laki (V-taper, otot dada dan perut, kulit prosedural, rambut dada, tahi lalat, pencahayaan hangat); gambar jurnal 1 dan 2 kolom dibuat ulang.
    - Semua teks keterangan (BOM, spesifikasi, catatan, tabel, langkah) dipindah ke Keterangan_Gambar_ECG_PPG_A4.pdf; lembar A3 hanya berisi gambar, label, dan dimensi dengan huruf lebih besar.
    - Gambar_Lengkap_ECG_PPG_A3.pdf: 16 halaman (daftar, perakitan, komponen, teknik cover, teknik klip, jurnal).
    - Klip PPG dirender ulang realistis (Cycles); skrip bangun_pdf.sh membangun ulang semuanya.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
